lucianoET/aguada-firmware/firmware/node/docs/wiring_src/crop.jpg

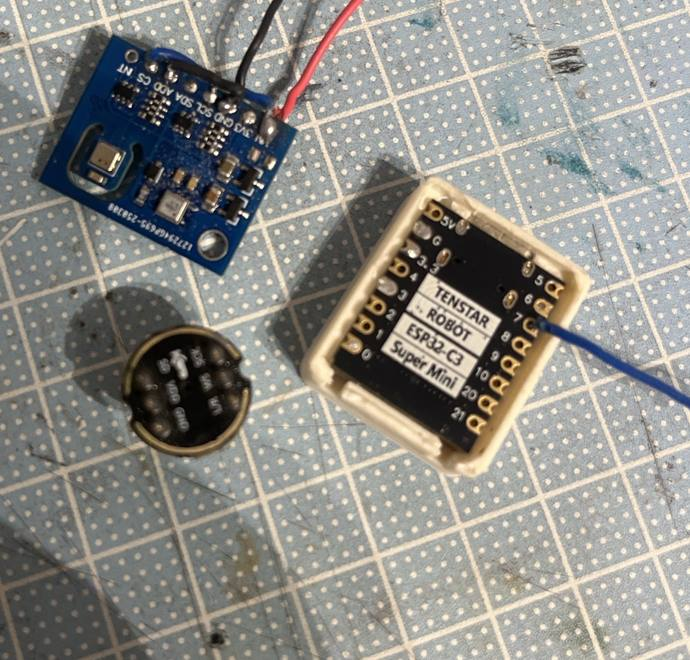
firmware/node/docs/wiring_src/crop.jpg
