lucianoET/aguada-firmware/firmware/node/node_pinout.md

# Node Pinout — Ligações de Sensores

> Hardware actual: **ESP32-C3 SuperMini**

Cobre os três targets suportados e os quatro modos de operação:
`ULTRASONIC` (1 ou 2 sensores) · `AIR_QUALITY` (ANI-01) · `RELAY`

---

## ESP32-C3 SuperMini ✦ (actual)

### Diagrama de pinos

```
              ┌────[USB-C]────┐
         GND ─┤ GND     5V   ├─ 5V
         GND ─┤ GND     3V3  ├─ 3.3 V
       GPIO4 ─┤ G4      RST  ├─ RST
       GPIO5 ─┤ G5      G10  ├─ GPIO10
  SDA ►GPIO6 ─┤ G6       G9  ├─ GPIO9  ◄ BOOT / botão relay
  SCL ►GPIO7 ─┤ G7       G8  ├─ GPIO8  ◄ LED onboard / WS2812B
       GPIO0 ─┤ G0       G3  ├─ GPIO3
       GPIO1 ─┤ G1       G2  ├─ GPIO2
              └───────────────┘
```

> Pinos GPIO 20/21 existem mas não estão expostos no conector principal da maioria dos SuperMini.

---

### Modo ULTRASONIC — 1 sensor (reservatório)

| Sinal | GPIO | Pino HC-SR04 |
|---|---|---|
| TRIG1 | **1** | TRIG |
| ECHO1 | **0** | ECHO |
| LED | **8** | — (LED onboard, active-LOW) |
| GND | GND  | GND |
| VCC | 3V3  | VCC (ou 5V se o sensor exigir) |

```
ESP32-C3          HC-SR04
  G1 ──────────── TRIG
  G0 ──────────── ECHO
 3V3 ──────────── VCC
 GND ──────────── GND
```

---

### node_reservatorio_1U — 1 reservatório, env `node_reservatorio_1U` (fonte 5 V)

Manual completo de montagem: [docs/MONTAGEM_NODE_RESERVATORIO_1U.md](docs/MONTAGEM_NODE_RESERVATORIO_1U.md).
O env antigo `node-c3-ch11` é o mesmo firmware.

| Sinal | GPIO | Ligação |
|---|---|---|
| TRIG | **3** | TRIG do sensor |
| ECHO | **4** | ECHO → **1k série + 2k ao GND** (5 V → 3,3 V) |
| Fonte 5 V | **1** (ADC1) | 200k → G1 → 100k → GND (`vbat_div=3`, alerta < 4,5 V) |
| DS18B20 | **10** | DQ + pull-up 4k7 → 3V3 (opcional, compensa temperatura) |
| Temperatura I2C | **6 / 7** | HTU21D/HD21D (0x40) ou SHT3x (0x44), opcional; prioridade sobre a DS18B20 |

Sensor (HC-SR04 ou JSN-SR04T à prova d'água) em **5 V**. C3 pelo pino 5V; 470 µF + 100 nF
junto ao C3 e 100 µF junto ao sensor. Nunca ECHO de 5 V direto no GPIO (danificou G0 do CON).

```
Fonte 5V ──┬── C3 5V
           ├── Sensor VCC
           └── 200k ─┬─ G1
                    100k ─ GND
C3 G3 ──────────── TRIG
C3 G4 ──1k──┬───── ECHO
           2k
           GND
```

O nó envia por **unicast** ao gateway depois de receber o ACK do HELLO (gateway com
firmware novo) ou com `-DDEFAULT_GATEWAY_MAC`; sem isso, broadcast como antes.

#### Reserva de pinos (expansão — ainda sem firmware)

| GPIO | Reserva | Observação |
|---|---|---|
| **0** | Microfone **INMP441** — SCK (saída) | I2S digital, 3V3, L/R→GND. Mesmo módulo e driver do AirQ (`sound_sensor`): dB SPL real sem calibrar. Detecta água entrando pelo ruído: nível vs. fundo |
| 1 | Fonte 5 V | já em uso |
| **2** | Microfone INMP441 — WS (saída) | **strapping** (alto no boot): o WS do INMP441 é entrada de alta impedância, não puxa o pino. Nada mais neste pino |
| 3 / 4 | Ultrassom TRIG / ECHO | já em uso |
| **5** | Saída: **relé 1** | sem strapping; é ADC2 (inútil com rádio), mas como digital é o pino mais seguro para saída |
| **6 / 7** | **I2C SDA / SCL** | sensor de temperatura (já suportado) + OLED SSD1306 (0x3C, reserva). Endereços sem conflito: AHT21 0x38, ENS160 0x53, SCD41 0x62, BH1750 0x23. Pull-up 4k7 se o módulo não tiver |
| 8 | LED da placa | strapping; manter só como LED de status |
| **9** | Entrada: **PB1** = botão BOOT da placa | strapping, mas o botão já existe; vale como botão depois do boot |
| 10 | 1-Wire (DS18B20) | já em uso |
| **20** | Entrada: **PB2** (pull-up interno) | U0RXD, livre (log vai pela USB). No 2U vira ECHO2 |
| **21** | Microfone INMP441 — SD (entrada) | U0TXD: a ROM transmite no boot, por isso aqui só **entrada** (o SD do mic fica em alta impedância sem clock). Pull-down interno: sem mic lê zeros → detectado |

Relé: módulo com transistor/optoacoplador acionado por 3,3 V, bobina no 5 V. Botões: GPIO → botão → GND.
Só há um relé direto (G5); um 2º relé, se precisar, vai por expansor I2C (PCF8574) na G6/G7.
Mic: o INMP441 substituiu o analógico (MAX9814/MAX4466 em G0) — 3 pinos em vez de 1, mas sai
dB SPL comparável entre nodes e o driver já existe. Fio do mic curto (< 20 cm): I2S a 1 MHz.

### node_reservatorio_2U — 2 reservatórios lado a lado, env `node_reservatorio_2U`

Manual: [docs/MONTAGEM_NODE_RESERVATORIO_2U.md](docs/MONTAGEM_NODE_RESERVATORIO_2U.md). Igual ao 1U, mais um sensor
(`sensor_id` 2, mesmo `node_id`):

| Sinal | GPIO | Ligação |
|---|---|---|
| TRIG (os dois) | **3** | TRIG do sensor 1 **e** do sensor 2 |
| ECHO1 | **4** | sensor 1 → 1k série + 2k ao GND |
| ECHO2 | **20** | sensor 2 → 1k série + 2k ao GND |
| Fonte 5 V | **1** | igual ao 1U |
| Temperatura | **6/7** (I2C) ou **10** (DS18B20) | opcional, um sensor para os dois (ar) |
| Reservados | 0/2/21 · 5 · 6/7 · 9 | mic INMP441 (SCK/WS/SD) · relé · I2C/OLED · PB1 (sem PB2: G20 virou ECHO2) |

**TRIG compartilhado:** os dois sensores disparam juntos e cada leitura usa só o seu ECHO; o
firmware lê um de cada vez com ≥ 60 ms de folga. Vale para reservatórios separados — dois
sensores na mesma água ouviriam o eco um do outro.

---

### Modo ULTRASONIC — 2 sensores

| Sinal | GPIO | Sensor |
|---|---|---|
| TRIG1 | **1** | S1 — TRIG |
| ECHO1 | **0** | S1 — ECHO |
| TRIG2 | **3** | S2 — TRIG |
| ECHO2 | **2** | S2 — ECHO |
| LED | **8** | — |

```
ESP32-C3          HC-SR04 nº1       HC-SR04 nº2
  G1 ─────────── TRIG
  G0 ─────────── ECHO
  G3 ──────────────────────────── TRIG
  G2 ──────────────────────────── ECHO
 3V3 ─────────── VCC ──────────── VCC
 GND ─────────── GND ──────────── GND
```

---

### Modo ANI-01 — qualidade do ar (ENS160 + AHT21)

| Sinal | GPIO | Destino |
|---|---|---|
| I2C SDA | **6** | ENS160 SDA · AHT21 SDA |
| I2C SCL | **7** | ENS160 SCL · AHT21 SCL |
| LED onboard | **8** | indicação de estado (active-LOW, onboard) |
| Botão BOOT | **9** | HELLO / restart (pull-up interno, onboard) |
| GND | GND | ENS160 GND · AHT21 GND |
| VCC | 3V3 | ENS160 VCC · AHT21 VCC |

**Endereços I2C:**

| Sensor | Endereço | Pino ADDR |
|---|---|---|
| ENS160 | 0x52 | ADDR → GND |
| AHT21  | 0x38 | fixo |

```
ESP32-C3          ENS160 / AHT21 (bus I2C partilhado)
  G6 ──────────── SDA
  G7 ──────────── SCL
 3V3 ──────────── VCC (ambos)
 GND ──────────── GND (ambos)
```

**Padrões do LED onboard (GPIO 8):**

| Padrão | Significado |
| --- | --- |
| 2 blinks × 100 ms  | Boot OK — sensores detectados |
| 5 blinks × 100 ms  | Erro de init — sensor não encontrado no I2C  |
| 1 blink × 30 ms | Leitura enviada com sucesso |
| 3 blinks × 200 ms  | Falha de leitura (sensor não respondeu) |

**Botão BOOT (GPIO 9):**

| Pressão | Acção |
| --- | --- |
| Curta (>40 ms)  | Envia PKT_HELLO imediato |
| Longa (≥5 s) | Reinicia o node |

**Sensor de luz TEMT6000 (opcional, modo ANI-01):**

Sensor analógico de luminosidade. Ligar a saída `SIG` a um pino **ADC1** (GPIO0–4).
O GPIO5 (ADC2) não funciona com WiFi ligado.

| Sinal | GPIO | Destino |
|---|---|---|
| SIG (OUT) | **3** (ADC1_CH3) | saída analógica |
| VCC | 3V3 | alimentação |
| GND | GND | massa |

```
ESP32-C3            TEMT6000
  3V3 ───────────── VCC
  GND ───────────── GND
   G3 ───────────── SIG
```

> Evitar GPIO2 (strapping). GPIO4 também é ADC1 mas é o pino recomendado para vbat.
> Pino configurável via build flag `DEFAULT_LIGHT_PIN`.

**Analisador de ar-condicionado + extras (opcionais, modo ANI-01, detecção automática):**

| Periférico | GPIO | Ligação |
|---|---|---|
| SCD41 (CO₂ real) | 6 / 7 | mesmo I2C do AHT21/ENS160, endereço 0x62 |
| DS18B20 sonda EXT | **4** | DQ + pull-up 4k7 → 3V3, cabo 3 vias |
| DS18B20 sonda SUP | **10** | idem |
| TC SCT-013 | **1** (ADC1) | bias 3V3─10k─┬─6k8─GND + 10 µF; jack P2 com comutação → GND sem plugue |
| INMP441 SD | **5** | entrada (pull-down interno) |
| INMP441 SCK | **20** | U0RXD — confirmar que o SuperMini expõe |
| INMP441 WS | **21** | U0TXD |
| INMP441 L/R | GND | canal esquerdo |

```
ESP32-C3            INMP441              DS18B20 (x2)          SCT-013 (jack P2)
  3V3 ───────────── VDD                    VDD ── 3V3            tip ──── G1
  GND ───────────── GND, L/R               GND ── GND            sleeve ─ bias 1.34 V
   G20 ──────────── SCK                    DQ ─┬─ G4 (EXT)
   G21 ──────────── WS                         └─ 4k7 → 3V3
   G5  ──────────── SD                     (SUP idêntica em G10)
```

Caixa central AirQ

Portas do analisador de AC

> KY-037/038 removido em 2026-10 (substituído pelo INMP441, que dá dB SPL real).
> Detalhes, faixa do TC e diagnóstico ΔT: [`Node AirQ.md`](../../Node%20AirQ.md).

---

### Modo RELAY

| Sinal | GPIO | Detalhe |
|---|---|---|
| Botão HELLO | **9** | BOOT button, active-LOW |
| I2C SDA | **6** | Opcional: SHT3x (0x44) ou HD21D (0x40) para T/H |
| I2C SCL | **7** | idem |
| LED | **8** | Pulso 30 ms a cada 2 s (se sem conflito) |

O relay faz scan I2C em 0x40 e 0x44. Se encontrar SHT3x ou HD21D, envia T/H como `PKT_HEARTBEAT sensor_id=0xFE`.

---

### vbat — monitorização de tensão (opcional, todos os modos)

| Sinal | GPIO | Detalhe |
|---|---|---|
| ADC | **4** (recomendado) | Divisor de tensão 1:2 |

```
Bateria/fonte ── R1(100k) ─┬─ GPIO4
                           │
                         R2(100k)
                           │
                          GND
```

Configurar em NVS: `vbat_enabled=true`, `vbat_pin=4`, `vbat_div=2`.

---

## ESP32-C3 DevKit M1

Mesmo target (`CONFIG_IDF_TARGET_ESP32C3`) → **pinos idênticos ao SuperMini**.  
O layout físico do conector é diferente mas os GPIOs são os mesmos.

---

## ESP32 DevKit (ESP32 clássico)

### Modo ULTRASONIC — 1 sensor

| Sinal | GPIO | Sensor |
|---|---|---|
| TRIG1 | **5**  | HC-SR04 TRIG |
| ECHO1 | **18** | HC-SR04 ECHO |
| LED | **2**  | active-HIGH |

### Modo ULTRASONIC — 2 sensores (pinos recomendados)

> Os pinos padrão (ECHO2=GPIO21) colidem com I2C SDA. Usar os pinos dos envs `ch11`:

| Sinal | GPIO (ch11) | GPIO (padrão — evitar se usar I2C) |
|---|---|---|
| TRIG1 | **25** | 5  |
| ECHO1 | **26** | 18 |
| TRIG2 | **32** | 19 |
| ECHO2 | **33** | ⚠ 21 = SDA |

### Modo ANI-01

| Sinal | GPIO | Destino |
|---|---|---|
| I2C SDA | **21** | ENS160 SDA · AHT21 SDA |
| I2C SCL | **22** | ENS160 SCL · AHT21 SCL |
| LED | **2** | monochrome (WS2812B não testado no DevKit) |

### Modo RELAY

| Sinal | GPIO | Detalhe |
|---|---|---|
| Botão | **2** | active-HIGH ⚠ mesmo pino que LED — `relay_led_conflict()` desativa LED |
| I2C SDA | **21** | Opcional: SHT3x/HD21D |
| I2C SCL | **22** | idem |

### vbat (DevKit)

Recomendado: GPIO **34** (input-only, sem conflito). `vbat_div=2`.

---

## Personalizar pinos via build flags

Qualquer pino pode ser sobrescrito adicionando flags em `platformio.ini`:

| Flag | Padrão C3 | Padrão DevKit | Descrição |
|---|---|---|---|
| `DEFAULT_TRIG1` | 1 | 5 | HC-SR04 sensor 1 TRIG |
| `DEFAULT_ECHO1` | 0 | 18 | HC-SR04 sensor 1 ECHO |
| `DEFAULT_TRIG2` | 3 | 19 | HC-SR04 sensor 2 TRIG |
| `DEFAULT_ECHO2` | 2 | 21 | HC-SR04 sensor 2 ECHO |
| `DEFAULT_I2C_SDA_PIN` | 6 | 21 | I2C SDA |
| `DEFAULT_I2C_SCL_PIN` | 7 | 22 | I2C SCL |
| `DEFAULT_LED_PIN` | 8 | 2 | LED / WS2812B DIN |
| `DEFAULT_LIGHT_PIN` | 3 | — | TEMT6000 SIG (ADC1, modo ANI-01) |
| `CT_PIN` | 1 | — | TC SCT-013 (ADC1, modo ANI-01) |
| `PROBE_EXT_PIN` / `PROBE_SUP_PIN` | 4 / 10 | — | sondas DS18B20 (modo ANI-01) |
| `MIC_SCK_PIN` / `MIC_WS_PIN` / `MIC_SD_PIN` | 20 / 21 / 5 | — | INMP441 I2S (modo ANI-01) |
| `DEFAULT_SENSOR_TYPE` | 0 | 0 | 0=ultrassônico 1=ANI-01 |
| `DEFAULT_NUM_SENSORS` | 1 | 1 | 0=relay 1=1sensor 2=2sensores |
| `DEFAULT_RELAY_ENABLED` | 0 | 0 | 1=relay+sensor simultâneos |

Exemplo — env ANI-01 com pino SDA customizado:
```ini
build_flags = -DDEFAULT_SENSOR_TYPE=1 -DDEFAULT_I2C_SDA_PIN=10
```
