lucianoET/aguada-firmware/.planning/quick/261001-6ja-bridge-py-parametros-de-reservatorio-edi/261001-6ja-PLAN.md

---
phase: quick-261001-6ja
plan: 01
type: execute
wave: 1
depends_on: []
files_modified:
  - tools/bridge.py
  - tools/test_reservoir_config.py
autonomous: true
requirements: [QUICK-6JA]
user_setup: []

must_haves:
  truths:
    - "A HC-SR04 reading with distance_cm > level_max_cm + sensor_offset_cm + OUT_OF_RANGE_MARGIN_CM (30) logs WARNING `Sensor out of range: ...`, publishes retained `offline` on `aguada/{node}/{sid}/availability` and publishes nothing on the state topic; CIE2 299 cm is rejected, 270 and 280 cm are accepted (D-05)"
    - "Every reservoir in reservoirs.yaml without `type: air_quality` gets 3 retained HA discovery configs `homeassistant/number/aguada_{alias}_cfg_{param}/config` (Altura útil / Offset do sensor / Volume máximo) on the same device `aguada_{alias}` as its sensors, with command_topic, min/max/step, mode box, entity_category config and no availability keys; SRN (air_quality) gets none (D-01)"
    - "Retained `aguada/{node}/{sid}/config` JSON with level_max_cm, sensor_offset_cm, volume_max_L is published on every MQTT connect and after every set command (D-02)"
    - "`aguada/0XC9C4/1/config/level_max_cm/set` = `460` updates `self.reservoirs[(\"0XC9C4\",1)]` in place (same dict object read by `_handle_sensor`), logs INFO `Config CAV level_max_cm 450 -> 460`, rewrites exactly one line of reservoirs.yaml, and republishes the config state (D-03, D-04)"
    - "Out-of-range, non-numeric, NaN, unknown param, unknown or air_quality reservoir commands log WARNING, change neither memory nor file, and (when the reservoir exists) republish the current config state so the HA box snaps back (D-03)"
    - "reservoirs.yaml rewrite is textual, scoped to the list item of that alias inside that node key, preserves every comment and line, is atomic (temp file in same dir + os.replace, file mode kept), and when the line is not found logs ERROR and leaves the file untouched (D-04)"
    - "`tools/test_reservoir_config.py` prints `ok` with `.venv/bin/python` and never modifies the real `tools/reservoirs.yaml`; `test_seq_dedup.py`, `test_sensor_availability.py`, `test_bridge_dispatch.py` still print `ok` (D-07, D-08)"
  artifacts:
    - path: tools/bridge.py
      provides: "OUT_OF_RANGE_MARGIN_CM, RESERVOIR_PARAMS, update_reservoir_yaml(), mqtt_topic_config(), publish_config_discovery(), Bridge._publish_reservoir_config(), Bridge._handle_config_set(), out-of-range branch in _handle_sensor, subscribe + publish in _on_mqtt_connect, routing in _on_mqtt_message"
    - path: tools/test_reservoir_config.py
      provides: "assert-based self-check on a TEMP COPY of reservoirs.yaml with a fake MQTT client (cases a-d + YAML scoping)"
  key_links:
    - "`mqtt_topic_config(node_id, sensor_id)` is the single source for the state topic, the discovery state_topic and the discovery command_topic prefix (`{config_topic}/{param}/set`); the handler parses the same shape back (6 segments, [3]=='config', [5]=='set')"
    - "Config-set routing in `_on_mqtt_message` MUST come before the existing `json.loads(msg.payload)` try/except, otherwise a non-JSON payload (e.g. `abc`) returns silently without republishing state"
    - "`_handle_config_set` mutates the dict object stored in `self.reservoirs[key]` (no copy, no reload), which is exactly what `_handle_sensor` passes to `calculate()` and to the out-of-range check"
    - "`update_reservoir_yaml` writes to `self.args.config` (resolved with os.path.realpath), never a hard-coded path; the test points `args.config` at a temp copy"
    - "Range check form `not (lo <= v <= hi)` rejects NaN; the form `v < lo or v > hi` would let NaN through and `int(round(nan))` would raise"
---

<objective>
Reservoir parameters (altura útil, offset do sensor, volume máximo) become editable from Home Assistant, persist to `tools/reservoirs.yaml`, and implausible HC-SR04 readings are treated as sensor errors.

User flow: in HA the operator opens device "CAV" -> section "Configuração" -> box "Castelo de Incêndio - Altura útil" shows 450 -> types 460 -> Enter. HA publishes `460` on `aguada/0XC9C4/1/config/level_max_cm/set`; bridge validates, applies it to the next reading immediately, rewrites only that line in reservoirs.yaml (comments kept), republishes the retained config state and the box stays at 460. An invalid value is logged and the state is republished, so the box snaps back to the current value. The boxes stay editable when the node is offline (no availability). Syncing to aguada-web (`tools/sync_reservoirs.sh`) stays a manual step for the user (D-06).

Purpose of the out-of-range rule: 2026-09-30 CIE2 sent 299 cm with level_max 240 + offset 10; calculate() clamped it to 0 % and HA fired a false critical-level alarm. With the rule the sensor goes unavailable instead.

Output: `tools/bridge.py` (constants, YAML text editor, discovery function, topic helper, two Bridge methods, three call sites) and new `tools/test_reservoir_config.py`.

Decision mapping (user-confirmed requirements 1-9 -> D-01..D-09): D-01 number discovery per HC-SR04 reservoir; D-02 retained config state topic, published on connect and after each change; D-03 command topic, subscribe, validation, in-memory update, INFO log; D-04 textual atomic YAML persistence, no new deps; D-05 out-of-range reading = sensor error; D-06 minimal diff, file style, ANI/relay/env/gateway untouched, no sync_reservoirs.sh; D-07 executable self-check on a temp copy; D-08 venv python + regression tests; D-09 other-session files untouched, explicit-path staging, no service restart.
</objective>

<execution_context>
@$HOME/.claude/gsd-core/workflows/execute-plan.md
@$HOME/.claude/gsd-core/templates/summary.md
</execution_context>

<context>
@.planning/STATE.md
@CLAUDE.md
@tools/reservoirs.yaml
@tools/test_sensor_availability.py

Read `tools/bridge.py` by range only (1438 lines): L41-64 config section + `load_reservoir_config`; L134-152 topic helpers; L282-401 `publish_discovery` (device dict shape, discovery loop, retain); L728-783 `Bridge.__init__`; L836-911 `_on_mqtt_connect` + `_on_mqtt_message`; L1005-1084 `_set_sensor_avail` + `_handle_sensor`.

Facts verified during planning (do not re-derive):
- Interpreter: `/home/luc/DEV_luctronics/luctronics_firmware/platformio/.venv/bin/python` (paho-mqtt 1.6.1, PyYAML). System python3 has no paho. Baseline: all three existing self-checks print `ok` before this plan.
- `import bridge` is side-effect free. Real `bridge.Bridge(args)` works with `argparse.Namespace(config=..., mqtt_user="", mqtt_password="", offline_timeout=300, influx_url="", gateway_timeout=0, serial_reconnect_delay=2.0)`; `args.config` is stored as `self.args.config`. `load_reservoir_config` returns the yaml item dicts themselves, keyed `(NODE_UPPER, sid)`, and resets/refills the global `NODE_ALIASES`.
- Reservoir keys: `("0X7758",1)` CON 450/20/80000, `("0XC9C4",1)` CAV 450/20/80000 (also 0XEE02), `("0X2EC4",1/2)` CB31/CB32 200/10/40000, `("0X9EAC",1/2)` CIE1/CIE2 240/10/245000, `("0X3456",1/2)` CBIF1/CBIF2, `("0XA101",1)` SRN `type: air_quality` (no level params).
- reservoirs.yaml layout: top `reservoirs:` at col 0, node keys quoted at indent 2 (`  "0XC9C4":`), list items `    - sensor_id: N` at indent 4, fields at indent 6 (`      alias: CAV`, `      level_max_cm: 450`). Comment lines at indent 2 sit between node blocks (e.g. `  # CAV: node ESP-NOW ...` right before `"0XC9C4"`); the file header has non-ASCII comments (FONTE ÚNICA) -> read/write UTF-8. Real file is a regular file (not a symlink), mode 0664.
- `_handle_sensor` dedups on `(node, sid, seq)`: every test message needs a distinct seq. `sensor_msg(node, sid, dist, flags, seq)` and the availability helpers can be imported from `test_sensor_availability` (as `test_seq_dedup.py` does), but that module's `make_bridge()` uses the REAL yaml path, so the new test defines its own bridge factory on a temp copy.
- Existing regression distances stay below the new limits (CON/CAV 102-103 cm vs 500, CB31 80-81 cm vs 240); `test_bridge_dispatch.py` stubs `_handle_sensor`.
- HA MQTT number publishes integral values without decimals (`460`), but accept `460.0` too (float parse).
- `_on_mqtt_message` today: GATEWAY_RX_TOPIC check, then `json.loads` in try/except that returns silently on failure, then `aguada/raw/` and `aguada/cmd/*` branches.
- Working tree has uncommitted work from another session (firmware/gps_tracker/*, tools/install_autostart_user_service.sh, tools/systemd/, .planning/debug/). Do NOT touch, stage or commit any of it (D-09).
</context>

<tasks>

<task type="auto" tdd="true">
  <name>Task 1: Out-of-range reading = sensor error (constant, _handle_sensor branch, test scaffold with temp-copy bridge)</name>
  <files>tools/bridge.py, tools/test_reservoir_config.py</files>
  <behavior>
    - Fresh bridge on a temp copy; CIE2 msg `sensor_msg("0x9EAC", 2, 299, 0, 1)` -> exactly one publish on `aguada/0X9EAC/2/availability` = `("offline", retain True)`, zero publishes on `aguada/0X9EAC/2/state`.
    - Same bridge, `sensor_msg("0x9EAC", 2, 270, 0, 2)` -> one state publish on `aguada/0X9EAC/2/state` and availability flips to `online`.
    - Boundary on a fresh bridge: 280 cm (= 240 + 10 + 30) is accepted (state published); 281 cm is rejected (offline, no new state).
    - The real `tools/reservoirs.yaml` bytes are identical before and after the whole script.
  </behavior>
  <action>
RED first: create `tools/test_reservoir_config.py` in the style of `tools/test_sensor_availability.py` (docstring "Self-check: ..." with `Run: .venv/bin/python tools/test_reservoir_config.py`, `sys.path.insert(0, str(Path(__file__).parent))`, `import bridge`, plain `test_*` functions, `__main__` block calling every test then printing `ok`). Per D-07:
- Module constant REAL pointing to `Path(__file__).parent / "reservoirs.yaml"` and REAL_BYTES read at import; the `__main__` block asserts `REAL.read_bytes() == REAL_BYTES` just before printing `ok`.
- Own `FakeClient` with `publish(self, topic, payload=None, qos=0, retain=False, **kw)` appending `(topic, payload, retain)` to `self.published`, and `subscribe(self, topic, *a, **kw)` appending to `self.subscribed`.
- `make_bridge(tmpdir)`: `shutil.copy(REAL, tmpdir/"reservoirs.yaml")`, build a real `bridge.Bridge` with the Namespace from context but `config=` the COPY path, replace `b.client` with a FakeClient and `b.tracker` with `bridge.NodeTracker(fake, 300)`; return `(b, fake, copy_path)`. Each test wraps its body in `with tempfile.TemporaryDirectory() as d:`. Never pass the real path to Bridge or to any write function.
- Import `sensor_msg` from `test_sensor_availability`.
- Test `test_out_of_range_is_sensor_error` covering every `<behavior>` bullet (use a second fresh bridge for the 280/281 boundary, distinct seqs).
Run it; it must fail (299 currently publishes a 0 % state).

GREEN in `tools/bridge.py` per D-05/D-06:
1. Next to `GATEWAY_ALIVE_S` add `OUT_OF_RANGE_MARGIN_CM = 30` with a one-line comment starting `# ponytail:` saying it is the tuning knob: a reading beyond level_max_cm + sensor_offset_cm + this margin is a sensor fault, not an empty tank.
2. In `_handle_sensor`, right after the existing `Sensor error:` branch returns and before `calcs = calculate(distance_cm, cfg)`: compute the limit from `cfg["level_max_cm"] + cfg["sensor_offset_cm"] + OUT_OF_RANGE_MARGIN_CM`; if `distance_cm > limit`, `log.warning("Sensor out of range: %s/%d dist=%d > %d", node_id, sensor_id, distance_cm, limit)`, call `self._set_sensor_avail(node_id, sensor_id, "offline")` and return (same route as the error branch). Leave the existing error branch, `calculate()` and the ANI path untouched.
  </action>
  <verify>
    <automated>cd /home/luc/DEV_luctronics/luctronics_firmware/platformio && .venv/bin/python -m py_compile tools/bridge.py && .venv/bin/python tools/test_reservoir_config.py && grep -v '^\s*#' tools/bridge.py | grep -c "OUT_OF_RANGE_MARGIN_CM" && git diff --quiet -- tools/reservoirs.yaml</automated>
  </verify>
  <done>Self-check prints `ok`; grep prints `2` (definition + use); 299 cm on CIE2 marks the sensor offline with no state publish, 270/280 cm publish state; real reservoirs.yaml unchanged.</done>
</task>

<task type="auto" tdd="true">
  <name>Task 2: update_reservoir_yaml() textual, item-scoped, atomic persistence</name>
  <files>tools/bridge.py, tools/test_reservoir_config.py</files>
  <behavior>
    - `bridge.update_reservoir_yaml(copy, "0XC9C4", "CAV", "level_max_cm", 460)` returns True; comparing the copy's lines before/after, exactly one line differs and it is the CAV `level_max_cm` line now reading `      level_max_cm: 460`; the CON block (also 450) and every comment line are unchanged; `bridge.load_reservoir_config(copy)` gives CAV 460 and CON 450.
    - `update_reservoir_yaml(copy, "0X2EC4", "CB32", "sensor_offset_cm", 12)` returns True and changes only the CB32 line (second list item of the node); CB31 keeps `sensor_offset_cm: 10`.
    - `update_reservoir_yaml(copy, "0X7758", "CAV", "level_max_cm", 999)` (alias not under that node) returns False and the file bytes are identical; same for an unknown node key and for a param line that does not exist in the item.
    - File mode of the copy is unchanged after a successful write.
  </behavior>
  <action>
RED first: add `test_yaml_update_scoped` and `test_yaml_update_not_found` to `tools/test_reservoir_config.py` covering every `<behavior>` bullet, each on its own temp copy (`shutil.copy(REAL, ...)`, no Bridge needed); register them in `__main__`. Read/compare with `read_text(encoding="utf-8").splitlines(keepends=True)`. Run; must fail (function missing).

GREEN in `tools/bridge.py` per D-04/D-06 (no new dependencies, stdlib only; add `import re` and `import tempfile` to the import block in alphabetical position):
Add module function `update_reservoir_yaml(path: str, node_id: str, alias: str, param: str, value: int) -> bool` right after `load_reservoir_config`, with a one-line docstring (edits one `param: number` line in place so comments/formatting survive). Logic:
1. `real = os.path.realpath(path)`; read UTF-8 text and split with `splitlines(keepends=True)`.
2. Node block: find the first line matching, case-insensitively, optional indent + optional quote + `re.escape(node_id)` + optional quote + `:` + optional trailing comment. Record its indent. The block ends at the next line that is non-blank, not a comment-only line, and has indent <= the node key indent (next node key or a top-level key); otherwise EOF.
3. Item: inside the block find the line `^\s*alias:\s*["']?{re.escape(alias)}["']?\s*(#.*)?$` (exact alias, so CB3 never matches CB31). Item start = the nearest preceding line in the block matching `^\s*-\s`; item end = the next such line after the alias line, or the block end.
4. In [item start, item end) find the first line matching `^(\s*(?:-\s+)?{re.escape(param)}\s*:\s*)(-?\d+(?:\.\d+)?)(\s*(?:#.*)?)$` (match against the line without its newline); rebuild it as group1 + `str(value)` + group3 + the original line ending.
5. If node, alias or param line is not found: `log.error("Config not persisted: %s/%s %s not found in %s", node_id, alias, param, real)` and return False without touching the file.
6. Atomic write: `tempfile.mkstemp(dir=os.path.dirname(real), prefix=".reservoirs.", suffix=".tmp")`, write the joined text as UTF-8, flush + `os.fsync`, `os.chmod(tmp, os.stat(real).st_mode & 0o7777)` (mkstemp creates 0600; keep the original mode so aguada-web/other readers still can read), then `os.replace(tmp, real)`; on any exception remove the temp file, `log.exception(...)` and return False. Return True on success.
  </action>
  <verify>
    <automated>cd /home/luc/DEV_luctronics/luctronics_firmware/platformio && .venv/bin/python -m py_compile tools/bridge.py && .venv/bin/python tools/test_reservoir_config.py && grep -c "^def update_reservoir_yaml" tools/bridge.py && git diff --quiet -- tools/reservoirs.yaml</automated>
  </verify>
  <done>Self-check prints `ok`; grep prints `1`; edits touch exactly one line inside the right list item; not-found cases return False with the file byte-identical; real reservoirs.yaml unchanged.</done>
</task>

<task type="auto" tdd="true">
  <name>Task 3: HA number discovery, retained config state and set-command handler</name>
  <files>tools/bridge.py, tools/test_reservoir_config.py</files>
  <behavior>
    - (a) `b._on_mqtt_connect(fake, None, {}, 0)`: `fake.subscribed` contains `aguada/+/+/config/+/set`; `homeassistant/number/aguada_cav_cfg_level_max_cm/config` payload has name `Castelo de Incêndio - Altura útil`, unique_id `aguada_cav_cfg_level_max_cm`, default_entity_id `number.aguada_cav_altura_util`, state_topic `aguada/0XC9C4/1/config`, value_template `{{ value_json.level_max_cm }}`, command_topic `aguada/0XC9C4/1/config/level_max_cm/set`, min 50, max 1000, step 1, mode `box`, entity_category `config`, unit `cm`, an `icon`, device identifiers `["aguada_cav"]`, and none of `availability`, `availability_topic`, `availability_mode`; offset (0..200, `number.aguada_cav_offset_sensor`) and volume (1..500000, unit `L`, `number.aguada_cav_volume_maximo`) likewise; all published retained; no published topic contains `aguada_srn_cfg`; retained `aguada/0XC9C4/1/config` JSON equals `{"level_max_cm": 450, "sensor_offset_cm": 20, "volume_max_L": 80000}`; no `aguada/0XA101/1/config` publish.
    - (b) `b._on_mqtt_message(None, None, msg)` with `msg = types.SimpleNamespace(topic="aguada/0XC9C4/1/config/level_max_cm/set", payload=b"460")`: `b.reservoirs[("0XC9C4",1)]` is the same object as before and has `level_max_cm == 460`; the copy differs from the original in exactly one line (CAV level_max_cm 460), CON block and comments intact; the last publish on `aguada/0XC9C4/1/config` is retained JSON with level_max_cm 460; a following CAV reading `sensor_msg("0xC9C4", 1, 100, 0, 1)` publishes `level_cm` 380 (460 - (100 - 20)).
    - (c) On a fresh bridge, each of: `level_max_cm/set` = `5000`, `abc`, `nan`; `aguada/0XC9C4/1/config/foo/set` = `100`; `aguada/0XA101/1/config/level_max_cm/set` = `100`; `aguada/0X9999/1/config/level_max_cm/set` = `100` -> CAV cfg still 450/20/80000, copy bytes identical to the original; after the `5000` command the latest `aguada/0XC9C4/1/config` publish carries level_max_cm 450 (state republished).
  </behavior>
  <action>
RED first: add `test_number_discovery_and_state` (a), `test_set_command_applies_and_persists` (b) and `test_set_command_rejected` (c) to `tools/test_reservoir_config.py` using `make_bridge(tmpdir)` and `types.SimpleNamespace` messages; register them in `__main__`. Run; must fail.

GREEN in `tools/bridge.py` per D-01/D-02/D-03/D-06 (style: short comments, English logs):
1. Config section, below `OUT_OF_RANGE_MARGIN_CM`: `RESERVOIR_PARAMS` dict, param -> tuple (HA name suffix, entity suffix, unit, min, max, icon): `level_max_cm` -> ("Altura útil", "altura_util", "cm", 50, 1000, "mdi:arrow-expand-vertical"); `sensor_offset_cm` -> ("Offset do sensor", "offset_sensor", "cm", 0, 200, "mdi:arrow-collapse-down"); `volume_max_L` -> ("Volume máximo", "volume_maximo", "L", 1, 500000, "mdi:cup-water"). Single source for discovery, validation and the state JSON (D-01).
2. Topic helpers: after `mqtt_topic_sensor_avail` add `mqtt_topic_config(node_id, sensor_id)` returning `f"aguada/{node_id}/{sensor_id}/config"`, same one-line shape (D-02).
3. New module function `publish_config_discovery(client, node_id, sensor_id, cfg)` placed right after `publish_discovery` (leave `publish_discovery` itself unchanged). Build `alias` and `dev` exactly like `publish_discovery` (lower-cased alias, `{"name": cfg.get("alias", alias), "identifiers": [f"aguada_{alias}"], "manufacturer": "Aguada"}`) so the numbers land on the same device. For each RESERVOIR_PARAMS entry publish retained to `homeassistant/number/{uid}/config` with uid `aguada_{alias}_cfg_{param}`: `name` `{cfg name} - {suffix}`, `unique_id`, `default_entity_id` `number.aguada_{alias}_{entity suffix}`, `state_topic` = mqtt_topic_config, `value_template` `{{ value_json.<param> }}`, `command_topic` = mqtt_topic_config + `/{param}/set`, `min`, `max`, `step` 1, `mode` "box", `entity_category` "config", `unit_of_measurement`, `icon`, `device`. No availability keys at all, so the boxes stay editable with the node offline (D-01). One short comment saying so.
4. `Bridge._publish_reservoir_config(self, node_id, sensor_id, cfg)`: retained publish on mqtt_topic_config of the JSON `{param: cfg.get(param) for param in RESERVOIR_PARAMS}` via `self.client` (D-02).
5. `_on_mqtt_connect`: after the existing `client.subscribe(GATEWAY_RX_TOPIC)` add `client.subscribe("aguada/+/+/config/+/set")` with a short comment (HA number edits). In the reservoir loop's non-air_quality branch, after `publish_discovery(...)`, call `publish_config_discovery(client, node_id, sensor_id, cfg)` and `self._publish_reservoir_config(node_id, sensor_id, cfg)` (D-02).
6. `_on_mqtt_message`: immediately after the GATEWAY_RX_TOPIC block and BEFORE the `json.loads` try, route topics that start with `aguada/`, contain `/config/` and end with `/set` to `self._handle_config_set(topic, msg.payload)` and return (non-JSON payloads must still reach the handler).
7. `Bridge._handle_config_set(self, topic, payload)` placed after `_on_mqtt_message` (D-03):
   - Split the topic; require 6 segments with [3] == "config" and [5] == "set", else WARNING and return. node = segment[1] upper-cased then mapped through NODE_ALIASES; sensor_id = int(segment[2]) (ValueError -> WARNING, return).
   - `cfg = self.reservoirs.get((node, sid))`; if missing or `cfg.get("type") == "air_quality"` -> WARNING `Config set for unknown reservoir ...` and return.
   - param = segment[4]; if not in RESERVOIR_PARAMS -> WARNING, republish state, return.
   - Parse `float(payload.decode(errors="replace").strip())`; on failure -> WARNING, republish state, return. Range check written as `not (lo <= v <= hi)` so NaN is rejected -> WARNING `Config rejected: %s %s=%r (range %d..%d)` with alias, param, raw text, lo, hi; republish state; return.
   - Valid: `new = int(round(v))`, `old = cfg[param]`, assign `cfg[param] = new` on the SAME dict (no copy, no reload; the next `_handle_sensor` uses it), `log.info("Config %s %s %s -> %s", cfg.get("alias"), param, old, new)`, then `update_reservoir_yaml(self.args.config, node, cfg.get("alias", ""), param, new)` (it logs ERROR itself on failure; the in-memory value stays applied per D-04), then `self._publish_reservoir_config(node, sid, cfg)`.
Do NOT touch ANI/relay/env/gateway discovery, heartbeat, `aguada/cmd/*` handling, or reservoirs.yaml (D-06). Do NOT run `tools/sync_reservoirs.sh` and do NOT restart the aguada-bridge service (D-06, D-09).

Regression + commit (D-08, D-09): run `test_seq_dedup.py`, `test_sensor_availability.py`, `test_bridge_dispatch.py` with `.venv/bin/python`; all must print `ok`. Stage ONLY `tools/bridge.py` and `tools/test_reservoir_config.py` by explicit path; never `git add -A`, `git add .` or `git commit -a`.
  </action>
  <verify>
    <automated>cd /home/luc/DEV_luctronics/luctronics_firmware/platformio && .venv/bin/python -m py_compile tools/bridge.py && .venv/bin/python tools/test_reservoir_config.py && .venv/bin/python tools/test_seq_dedup.py && .venv/bin/python tools/test_sensor_availability.py && .venv/bin/python tools/test_bridge_dispatch.py && grep -c 'aguada/+/+/config/+/set' tools/bridge.py && grep -c "^def publish_config_discovery" tools/bridge.py && git diff --quiet -- tools/reservoirs.yaml</automated>
  </verify>
  <done>All four self-checks print `ok`; both greps print `1`; HA gets 3 config numbers per HC-SR04 reservoir and none for SRN; a valid set changes memory + exactly one YAML line + republishes state; invalid sets change nothing and republish state; real reservoirs.yaml unchanged; commit contains only the two explicit files and other-session entries in `git status --short` are as before.</done>
</task>

</tasks>

<threat_model>
## Trust Boundaries

| Boundary | Description |
|---|---|
| HA / any MQTT client -> bridge | `aguada/+/+/config/+/set` payloads and topic segments are untrusted input that reaches in-memory config and a file write |
| bridge -> filesystem | rewrite of `tools/reservoirs.yaml` (read by bridge on restart and copied to aguada-web) |
| node/gateway -> bridge | SENSOR distance_cm is node-controlled; implausible values must not become 0 % readings |

## STRIDE Threat Register

| Threat ID | Category | Component | Severity | Disposition | Mitigation Plan |
|---|---|---|---|---|---|
| T-6ja-01 | Tampering | `_handle_config_set` value | medium | mitigate | Whitelist param via RESERVOIR_PARAMS, float parse, `not (lo <= v <= hi)` range (rejects NaN/inf), int conversion; invalid -> WARNING + state republish, no change (Task 3, test c) |
| T-6ja-02 | Tampering | `update_reservoir_yaml` target | medium | mitigate | Path comes only from `args.config` (realpath), never from the topic; node/alias/param are validated against loaded reservoirs + whitelist before the call and used via `re.escape`; edit scoped to one list item (Task 2 tests) |
| T-6ja-03 | Denial of Service | concurrent readers of reservoirs.yaml (bridge restart, sync to aguada-web) | medium | mitigate | Temp file in same dir + fsync + `os.replace`; file mode copied from the original so readers keep access |
| T-6ja-04 | Spoofing | unauthenticated LAN client publishing set commands | low | accept | Pre-existing broker trust model: `aguada/cmd/#` already lets any broker client restart/configure nodes; values are bounded by T-6ja-01 |
| T-6ja-05 | Tampering | out-of-range readings faking an empty tank | medium | mitigate | `distance_cm > level_max + offset + 30` -> sensor offline, no state publish (Task 1) |
| T-6ja-06 | Denial of Service | flood of valid set commands rewriting the file | low | accept | LAN-only, each write is a small atomic replace; no amplification |
</threat_model>

<verification>
Executor (automated):
- `.venv/bin/python tools/test_reservoir_config.py`, `test_seq_dedup.py`, `test_sensor_availability.py`, `test_bridge_dispatch.py` all print `ok`.
- `git diff --quiet -- tools/reservoirs.yaml` succeeds (real file untouched).
- `git status --short` after commit: only the pre-existing other-session entries remain.

Orchestrator, after execution (not an executor task, D-09):
- `systemctl --user restart aguada-bridge`; `mosquitto_sub -v -t 'aguada/+/+/config'` shows retained JSON for each HC-SR04 reservoir.
- HA device CAV -> Configuração shows 3 boxes; change Altura útil 450 -> 460, journal shows `Config CAV level_max_cm 450 -> 460`, `git diff tools/reservoirs.yaml` shows exactly that line; revert to 450 the same way. Then the user runs `tools/sync_reservoirs.sh` if aguada-web must follow.
</verification>

<success_criteria>
- HC-SR04 reservoir parameters are editable from HA (3 config numbers per reservoir), applied to the next reading and persisted to reservoirs.yaml with comments intact.
- Readings beyond level_max + offset + 30 cm make the sensor unavailable instead of producing a false 0 % / critical alarm.
- Diff limited to `tools/bridge.py` and the new `tools/test_reservoir_config.py`; ANI/relay/env/gateway paths unchanged.
</success_criteria>

<output>
Create `.planning/quick/261001-6ja-bridge-py-parametros-de-reservatorio-edi/261001-6ja-SUMMARY.md` when done
</output>
