lucianoET/aguada-firmware/.planning/quick/260930-t20-bridge-py-disponibilidade-por-sensor-no-/260930-t20-SUMMARY.md

---
phase: quick-260930-t20
plan: 01
subsystem: bridge
tags: [bridge, mqtt, home-assistant, availability, hc-sr04]
requires: []
provides:
  - "per-sensor retained availability topic aguada/{node}/{sensor}/availability"
  - "HA discovery availability list for nivel/pct/volume/distancia"
affects: [tools/bridge.py]
tech-stack:
  added: []
  patterns: ["publish-on-change dict (_sensor_avail)", "HA availability list + availability_mode all"]
key-files:
  created: [tools/test_sensor_availability.py]
  modified: [tools/bridge.py]
decisions:
  - "Single commit for both tasks (plan allows it); test file written whole up-front, RED verified per task"
metrics:
  completed: 2026-09-30
status: complete
---

# Quick 260930-t20: bridge.py per-sensor availability Summary

HC-SR04 error packets now publish retained `offline` on `aguada/{node}/{sensor}/availability` (valid reading publishes state, then `online`), only on transitions; HA discovery makes level/%/volume/distance entities follow node status AND the sensor topic, while rssi/bateria/last_update keep node status only.

## Changes
- `mqtt_topic_sensor_avail` helper, `Bridge._sensor_avail` dict, `Bridge._set_sensor_avail`, two call sites in `_handle_sensor` (error branch keeps the existing WARNING).
- `publish_discovery`: `per_sensor` flag on 4 entities -> `availability` list + `availability_mode: all` (no `availability_topic`); others unchanged.
- `tools/test_sensor_availability.py`: assert-based, fake MQTT client, 5 tests.

## Commit
- f30dd4a feat(260930-t20): per-sensor availability for HC-SR04 in bridge + HA discovery

## Verification
`.venv/bin/python tools/test_sensor_availability.py` -> ok; `tools/test_bridge_dispatch.py` -> ok; greps: helper 1, dict 1, `"availability_mode"` 1, `"per_sensor": True` 4.

## Deviations from Plan
None - plan executed as written (one commit for both tasks instead of per task).

## Known Stubs
None.

## Self-Check: PASSED
