lucianoET/aguada-firmware/.planning/quick/260930-t20-bridge-py-disponibilidade-por-sensor-no-/260930-t20-PLAN.md

---
phase: quick-260930-t20
plan: 01
type: execute
wave: 1
depends_on: []
files_modified:
  - tools/bridge.py
  - tools/test_sensor_availability.py
autonomous: true
requirements: [QUICK-T20]
user_setup: []

must_haves:
  truths:
    - "A HC-SR04 SENSOR packet flagged as error (distance_cm <= 0, 0xFFFF, or flags & 0x04) publishes retained `offline` on `aguada/{node_id}/{sensor_id}/availability`, and the existing `Sensor error:` WARNING log is still emitted (D-01, D-02)"
    - "A valid HC-SR04 reading publishes the state JSON first and then retained `online` on the same per-sensor topic (D-02)"
    - "Repeating the same availability state does not republish; the first state seen after bridge start is always published (D-02)"
    - "The two sensors of one node (0X2EC4 CB31/CB32, 0X9EAC CIE1/CIE2) have independent availability: one in error does not affect the other (D-02)"
    - "HA discovery for reservoir entities nivel, pct, volume, distancia carries an `availability` list [node status, per-sensor topic] with `availability_mode: all` and no `availability_topic` key; rssi, bateria, last_update keep only the node status availability (D-03)"
    - "ANI, relay, env and gateway discovery and `_handle_heartbeat` are unchanged (D-03, D-04)"
    - "`tools/test_sensor_availability.py` runs with the project venv, no framework, and prints `ok`; `tools/test_bridge_dispatch.py` still prints `ok` (D-06)"
  artifacts:
    - path: tools/bridge.py
      provides: "mqtt_topic_sensor_avail helper, Bridge._sensor_avail dict, Bridge._set_sensor_avail, per-sensor availability in _handle_sensor and publish_discovery"
    - path: tools/test_sensor_availability.py
      provides: "assert-based self-check with a fake MQTT client"
  key_links:
    - "`mqtt_topic_sensor_avail(node_id, sensor_id)` is the single source of the topic string for BOTH the publish in `_set_sensor_avail` and the second entry of the discovery `availability` list; if they diverge HA never marks the entities available"
    - "node_id casing: `_handle_sensor` uses `msg[\"node_id\"].upper()` + `NODE_ALIASES`, `_on_mqtt_connect` passes the upper-cased `reservoirs.yaml` keys to `publish_discovery`; both must yield `aguada/0X7758/1/availability`"
    - "HA rejects a discovery config that has both `availability` and `availability_topic` (mutually exclusive keys), so the measurement entities must carry only the list"
---

<objective>
Per-sensor availability in Home Assistant for HC-SR04 reservoirs, driven by the sensor-error packets the nodes already send.

Purpose: CON (0x7758) with a HC-SR04 that gets no echo sends SENSOR distance_cm=-1 / flags 0x04 every 120 s. `_handle_sensor` logs and returns, the node stays `online` (packets keep arriving), so HA shows the last good reading (102 cm, hours old) as if it were current. After this plan the level/%/volume/distance entities of that sensor go `unavailable` while RSSI, battery and "Último dado" stay visible (last_update shows when the last good reading happened). Two-sensor nodes get independent availability per sensor.

Output: `tools/bridge.py` (helper + dict + small method + two call sites + discovery change) and `tools/test_sensor_availability.py`.

Decision mapping (orchestrator decisions 1-8 -> D-01..D-08): D-01 new retained topic + helper; D-02 publish on error/valid, only on change, always first time; D-03 discovery availability list only for the 4 measurement entities; D-04 heartbeat untouched; D-05 accepted post-deploy unavailability until next valid reading (no mitigation code); D-06 executable assert check; D-07 minimal diff, existing style, other working-tree files untouched; D-08 runtime check done by orchestrator, not by the executor.
</objective>

<execution_context>
@$HOME/.claude/gsd-core/workflows/execute-plan.md
@$HOME/.claude/gsd-core/templates/summary.md
</execution_context>

<context>
@.planning/STATE.md
@CLAUDE.md
@tools/bridge.py
@tools/test_bridge_dispatch.py

Facts verified during planning (do not re-derive):
- Interpreter: system python3 has no paho. Use the project venv `/home/luc/DEV_luctronics/luctronics_firmware/platformio/.venv/bin/python` (paho-mqtt 1.6.1), same one the systemd unit uses. Existing `tools/test_bridge_dispatch.py` passes with it.
- `import bridge` is side-effect free (entry point is guarded by `if __name__ == "__main__"`, L1404).
- `bridge.Bridge(args)` is light: it reads `reservoirs.yaml` and creates an unconnected `mqtt.Client`; serial stays `None`; Influx only if `args.influx_url`. Attributes read in `__init__`: `config, mqtt_user, mqtt_password, offline_timeout, influx_url, gateway_timeout, serial_reconnect_delay`. Proven: `argparse.Namespace(config=<tools/reservoirs.yaml>, mqtt_user="", mqtt_password="", offline_timeout=300, influx_url="", gateway_timeout=0, serial_reconnect_delay=2.0)` constructs fine.
- `reservoirs` keys after load: `('0X7758',1)` alias CON, `('0X2EC4',1)` CB31, `('0X2EC4',2)` CB32, `('0X9EAC',1/2)`, `('0XA101',1)` type air_quality (SRN), etc.
- `_handle_sensor` dedups on `(node_id, sensor_id, seq)`: every test message MUST use a distinct `seq` or it is silently dropped.
- Topic helpers live at L136-149 (`mqtt_topic_state`, `mqtt_topic_status`, ...). `NodeTracker.seen` publishes `aguada/{node}/status` `online` retained the first time; log style there is `"Node %s → online"`.
- `publish_discovery` L279-384: entity dicts (nivel, pct, volume, distancia, rssi, bateria, last_update) then a loop building `payload` with `availability_topic`/`payload_available`/`payload_not_available`, published to `homeassistant/sensor/{uid}/config` retained. For CON the pct topic is `homeassistant/sensor/aguada_con_pct/config`.
- `_handle_sensor` is also called from the paho thread for `aguada/raw/#` outside `_dispatch_lock` (pre-existing, same as `_seen_seq`). Worst case for the new dict is a duplicate idempotent retained publish; no lock needed.
- Working tree has uncommitted work from another session (firmware/gps_tracker/*, tools/install_autostart_user_service.sh, tools/systemd/, .planning/debug/). Do NOT touch, stage or commit any of it (D-07).
</context>

<tasks>

<task type="auto" tdd="true">
  <name>Task 1: Per-sensor availability publish in _handle_sensor (helper, dedup dict, test)</name>
  <files>tools/bridge.py, tools/test_sensor_availability.py</files>
  <behavior>
    - `bridge.mqtt_topic_sensor_avail("0X7758", 1)` returns `aguada/0X7758/1/availability`.
    - CON msg seq=1 distance_cm=-1 flags=4 -> exactly one availability publish `("aguada/0X7758/1/availability", "offline", retain=True)`; no publish on `aguada/0X7758/1/state`.
    - CON msg seq=2 distance_cm=65535 flags=0 (still error) -> no new availability publish.
    - CON msg seq=3 distance_cm=102 flags=0 -> state published, then `online` retained; the state publish index is lower than the online publish index.
    - CON msg seq=4 distance_cm=103 flags=0 -> a second state publish, no new availability publish.
    - Fresh Bridge, 0X2EC4: sensor 1 valid (seq=10) + sensor 2 error (seq=11) -> `aguada/0X2EC4/1/availability`=online and `aguada/0X2EC4/2/availability`=offline, one publish each (first publish after start happens even without a prior opposite state); sensor 1 valid again (seq=12) -> no availability publish for either sensor.
  </behavior>
  <action>
RED first: create `tools/test_sensor_availability.py` modeled on `tools/test_bridge_dispatch.py` (module docstring "Self-check: ..." with a Run line using the venv python, `sys.path.insert(0, str(Path(__file__).parent))`, `import bridge`, plain `test_*` functions, a `__main__` block that calls every test and prints `ok`). Include:
- `FakeClient` whose `publish(self, topic, payload=None, qos=0, retain=False, **kw)` appends the tuple `(topic, payload, retain)` to `self.published`.
- `make_bridge()` building a real `bridge.Bridge` from the `argparse.Namespace` listed in context (config = `str(Path(__file__).parent / "reservoirs.yaml")`), then replacing `b.client` with a `FakeClient` and `b.tracker` with `bridge.NodeTracker(fake, 300)`; returns `(b, fake)`. Using the real `__init__` (not `Bridge.__new__`) is deliberate: it proves the new dict is initialized in `__init__`.
- A small helper filtering `fake.published` to topics ending in `/availability`, and one for a given state topic.
- A `sensor_msg(node, sid, dist, flags, seq)` builder returning the gateway JSON dict shape (`v, type="SENSOR", node_id` like `"0x7758"` lower-case hex so the `.upper()` path is exercised, `sensor_id, distance_cm, rssi=-70, vbat=None, flags, seq, ts=1`), fed straight to `b._handle_sensor(msg)`.
- Tests covering every bullet of `<behavior>` (topic format, error->offline once, repeat error silent, valid->state then online, repeat valid silent, two-sensor independence on 0X2EC4 with a fresh bridge).
Run it; it must fail (missing `mqtt_topic_sensor_avail`).

GREEN, in `tools/bridge.py`, minimal diff in the file's existing style (short comments, English logs) per D-07:
1. Per D-01, add `mqtt_topic_sensor_avail(node_id: str, sensor_id: int) -> str` right after `mqtt_topic_status`, returning `f"aguada/{node_id}/{sensor_id}/availability"`, same one-line shape as its neighbours.
2. In `Bridge.__init__`, next to the `_seen_seq` dedup cache, add `self._sensor_avail: dict[tuple, str] = {}` with a one-line comment: (node_id, sensor_id) -> last published "online"/"offline".
3. Add method `_set_sensor_avail(self, node_id: str, sensor_id: int, state: str)` placed directly above `_handle_sensor` (Message processing section). Per D-02: if `self._sensor_avail.get((node_id, sensor_id)) == state` return; else store it, `self.client.publish(mqtt_topic_sensor_avail(node_id, sensor_id), state, retain=True)` and `log.info("Sensor %s/%d → %s", node_id, sensor_id, state)` (mirrors NodeTracker's `Node %s → online`). Empty dict at start means the first call per sensor always publishes.
4. In `_handle_sensor`, HC-SR04 error branch (`distance_cm <= 0 or distance_cm == 0xFFFF or (flags & 0x04)`): keep the existing `log.warning("Sensor error: ...")` line unchanged, then call `self._set_sensor_avail(node_id, sensor_id, "offline")` before the `return` (D-02).
5. In `_handle_sensor`, immediately after the `self.client.publish(mqtt_topic_state(node_id, sensor_id), ...)` line, call `self._set_sensor_avail(node_id, sensor_id, "online")` so HA receives the fresh value before the entity turns available (D-02).
Do NOT touch `_handle_ani_sensor` (the ANI early-return happens before the new code), `_handle_heartbeat` (D-04: current firmware sends no heartbeat while the sensor is in error), NodeTracker, or `_on_mqtt_connect` (retained messages survive reconnects; D-05 accepts entities being unavailable until the next valid reading after deploy, so no startup seeding).
  </action>
  <verify>
    <automated>cd /home/luc/DEV_luctronics/luctronics_firmware/platformio && .venv/bin/python -m py_compile tools/bridge.py && .venv/bin/python tools/test_sensor_availability.py && .venv/bin/python tools/test_bridge_dispatch.py && grep -c "def mqtt_topic_sensor_avail" tools/bridge.py && grep -c "self._sensor_avail: dict" tools/bridge.py</automated>
  </verify>
  <done>Both self-checks print `ok`; each grep prints `1`; error packets publish `offline` once per transition; valid readings publish state then `online`; sensors of the same node are independent; ANI/heartbeat code paths are byte-identical to before.</done>
</task>

<task type="auto" tdd="true">
  <name>Task 2: HA discovery uses node + sensor availability for measurement entities only</name>
  <files>tools/bridge.py, tools/test_sensor_availability.py</files>
  <behavior>
    - `bridge.publish_discovery(fake, "0X7758", 1, cfg_CON)`: for uids `aguada_con_nivel`, `aguada_con_pct`, `aguada_con_volume`, `aguada_con_distancia` the JSON payload has `availability_mode == "all"`, `availability` is a list of exactly 2 dicts whose `topic`s are, in order, `aguada/0X7758/status` and `aguada/0X7758/1/availability`, each with `payload_available == "online"` and `payload_not_available == "offline"`, and the key `availability_topic` is absent.
    - For uids `aguada_con_rssi`, `aguada_con_bateria`, `aguada_con_last_update`: `availability_topic == "aguada/0X7758/status"`, `payload_available == "online"`, and neither `availability` nor `availability_mode` is present.
    - Every other payload field (name, unique_id, default_entity_id, state_topic, value_template, device, unit, state_class, device_class, icon) is unchanged, so HA updates the existing entities in place (same unique_id, no duplicates).
    - `bridge.publish_ani_discovery(fake, "0XA101", 1, cfg_SRN)`: no published payload contains `availability` or `availability_mode` (ANI untouched).
  </behavior>
  <action>
RED first: append to `tools/test_sensor_availability.py` tests for every bullet of `<behavior>` (get cfg from `make_bridge()[0].reservoirs[("0X7758", 1)]` and `[("0XA101", 1)]`, call the discovery functions with a fresh `FakeClient`, index payloads by topic `homeassistant/sensor/{uid}/config` and `json.loads` them). Register them in the `__main__` block. Run; the measurement-entity test must fail.

GREEN, in `publish_discovery` only (per D-03; `publish_gateway_discovery`, `publish_relay_discovery`, `publish_ani_discovery`, `publish_env_discovery` stay as they are):
1. Next to `avail_tp = mqtt_topic_status(node_id)` add `sensor_avail_tp = mqtt_topic_sensor_avail(node_id, sensor_id)` (the helper from Task 1, per D-01; never rebuild the string inline).
2. Add `"per_sensor": True` to the four measurement entity dicts (nivel, pct, volume, distancia). Leave rssi, bateria, last_update without it.
3. In the `for e in entities` loop, remove the three availability keys from the base `payload` literal and add them after it: when `e.get("per_sensor")`, set `payload["availability"]` to a list of two dicts `{"topic": avail_tp, "payload_available": "online", "payload_not_available": "offline"}` then the same with `sensor_avail_tp` (node first, sensor second), and `payload["availability_mode"] = "all"`; otherwise set `availability_topic`, `payload_available`, `payload_not_available` exactly as today. One short comment on the branch, e.g. that measurement entities also follow the per-sensor topic so a failed sensor shows unavailable instead of a stale value. The two forms must never both appear in one payload: HA treats `availability` and `availability_topic` as mutually exclusive and would reject the config.
Keep everything else in the function (entity list order, other keys, discovery topic, retain, debug log) unchanged.

Commit (both tasks, or one commit per task as the quick workflow prefers) staging ONLY `tools/bridge.py` and `tools/test_sensor_availability.py` by explicit path; never `git add -A` / `git add .` / `git commit -a` (D-07, other-session work in the tree).
  </action>
  <verify>
    <automated>cd /home/luc/DEV_luctronics/luctronics_firmware/platformio && .venv/bin/python -m py_compile tools/bridge.py && .venv/bin/python tools/test_sensor_availability.py && .venv/bin/python tools/test_bridge_dispatch.py && grep -c '"availability_mode"' tools/bridge.py && grep -c '"per_sensor": True' tools/bridge.py</automated>
  </verify>
  <done>Both self-checks print `ok`; `"availability_mode"` grep prints `1` (only publish_discovery); `"per_sensor": True` grep prints `4`; `git diff --stat` for this work lists only `tools/bridge.py` plus the new test file; the other-session files show the same modifications as before execution.</done>
</task>

</tasks>

<threat_model>
## Trust Boundaries

| Boundary | Description |
|---|---|
| node/gateway -> bridge | SENSOR JSON from USB serial, the gateway WiFi mirror (`aguada/gateway/rx`) and wired nodes (`aguada/raw/#`); flags/distance are node-controlled |
| bridge -> MQTT broker -> HA | retained availability + discovery configs consumed by HA |

## STRIDE Threat Register

| Threat ID | Category | Component | Severity | Disposition | Mitigation Plan |
|---|---|---|---|---|---|
| T-t20-01 | Denial of Service | `_set_sensor_avail` publishing every 120 s per sensor | low | mitigate | Publish only on state change via `self._sensor_avail` (Task 1); test asserts repeated states do not republish |
| T-t20-02 | Denial of Service | `publish_discovery` payload validity in HA | medium | mitigate | Measurement entities carry only the `availability` list, others only `availability_topic`; Task 2 test asserts the keys never coexist, so HA does not reject the config and drop the entities |
| T-t20-03 | Spoofing | forged `aguada/raw/#` packet with flags=4 marking a configured sensor offline | low | accept | Pre-existing surface: the same LAN-only, configured-node-gated path can already publish arbitrary readings; availability adds no new capability |
| T-t20-04 | Tampering | `aguada/raw/#` handler runs outside `_dispatch_lock` | low | accept | Race can only cause a duplicate idempotent retained publish of the same state; same accepted pattern as the existing `_seen_seq` cache |
| T-t20-05 | Information Disclosure | new topic `aguada/{node}/{sensor}/availability` | low | accept | Exposes only online/offline for ids already public in `aguada/{node}/{sensor}/state` |
</threat_model>

<verification>
Executor (automated):
- `.venv/bin/python tools/test_sensor_availability.py` and `.venv/bin/python tools/test_bridge_dispatch.py` both print `ok`.
- `git status --short` after commit: only the pre-existing other-session entries remain; `tools/bridge.py` and `tools/test_sensor_availability.py` are committed.

Orchestrator, after execution (D-08, not an executor task):
- `systemctl --user restart aguada-bridge`, then `journalctl --user -u aguada-bridge -f` shows `Sensor error: 0X7758/1 ...` followed by `Sensor 0X7758/1 → offline`.
- `mosquitto_sub -v -t 'aguada/+/+/availability'` shows `aguada/0X7758/1/availability offline` (retained).
- HA: `sensor.aguada_con_pct`, `_nivel`, `_volume`, `_distancia` = unavailable; `sensor.aguada_con_rssi` and `sensor.aguada_con_last_update` still have values. Other reservoirs become available again on their next valid reading (<= 120 s, D-05).
</verification>

<success_criteria>
- Sensor-error packets make only that sensor's measurement entities unavailable in HA; valid readings restore them.
- Availability publishes happen only on transitions (plus the first one per sensor after start).
- Diff limited to `tools/bridge.py` (helper, dict, one method, two call sites, `publish_discovery` loop) and the new `tools/test_sensor_availability.py`.
</success_criteria>

<output>
Create `.planning/quick/260930-t20-bridge-py-disponibilidade-por-sensor-no-/260930-t20-SUMMARY.md` when done
</output>
