lucianoET/aguada-firmware/.planning/quick/260803-l28-criar-node-ethernet-cabeado-aguada-firmw/260803-l28-PLAN.md

---
phase: quick-260803-l28
plan: 01
type: execute
wave: 1
depends_on: []
files_modified:
  - firmware/node-eth/platformio.ini
  - firmware/node-eth/src/main.cpp
  - firmware/node-eth/README.md
  - tools/bridge.py
autonomous: true
requirements: [QUICK-L28]
user_setup: []

must_haves:
  truths:
    - "`pio run -e node-cav-eth` completes successfully and the binary fits the ATmega328's 30720-byte flash"
    - "Node publishes one integer-only JSON sensor packet to `aguada/raw/0xEE02/1`, shaped exactly like the gateway serial packets `_handle_sensor` already consumes (D-02)"
    - "bridge.py subscribes to `aguada/raw/#` and routes wired-node packets through `_handle_sensor`, so the node gets reservoir math, HA Discovery, NodeTracker and InfluxDB for free (D-03)"
    - "A malformed payload, a non-dict payload, or an unknown node_id on `aguada/raw/#` is logged and dropped without raising out of the MQTT callback thread (D-03)"
    - "After 3 consecutive failed measurement cycles the node publishes `distance_cm=65535` with `flags=4`, which bridge.py already recognises as a sensor error (D-02)"
    - "A watchdog hard reset re-enters the application rather than boot-looping on the old Nano bootloader (D-02)"
  artifacts:
    - firmware/node-eth/platformio.ini
    - firmware/node-eth/src/main.cpp
    - firmware/node-eth/README.md
    - tools/bridge.py
  key_links:
    - "Node payload keys (node_id, sensor_id, distance_cm, flags, seq, rssi, vbat) ↔ keys read by `_handle_sensor` in tools/bridge.py"
    - "Node `node_id` string `0xEE02` ↔ reservoirs.yaml key `0XEE02`, bridged by `_handle_sensor`'s `msg[\"node_id\"].upper()`"
    - "`aguada/raw/#` subscription in `_on_mqtt_connect` ↔ the `aguada/raw/` prefix branch in `_on_mqtt_message`"
    - "Forced watchdog reset path in `mqttEnsure()` ↔ the `.init3` preamble that clears `MCUSR` and calls `wdt_disable()`"
---

<objective>
Add a wired Ethernet reservoir node to the Aguada fleet: a new PlatformIO project `firmware/node-eth/` (Arduino Nano + ENC28J60 + HC-SR04) that publishes protocol-shaped sensor JSON directly to MQTT, plus a small `tools/bridge.py` extension that consumes `aguada/raw/#` through the existing sensor pipeline.

Purpose: node 0xEE02 (CAV, Castelo de Incêndio) sits where ESP-NOW coverage is unreliable but wired Ethernet exists. Routing it through the bridge's existing `_handle_sensor` path (D-03) means it inherits reservoir math, HA Discovery, online/offline tracking and InfluxDB with no duplicated logic — the spec's rule that all level/volume math lives in bridge.py, never on nodes, is preserved (D-02).

Output: `firmware/node-eth/{platformio.ini,src/main.cpp,README.md}` and a modified `tools/bridge.py`.
</objective>

<execution_context>
@$HOME/.claude/gsd-core/workflows/execute-plan.md
@$HOME/.claude/gsd-core/templates/summary.md
</execution_context>

<context>
@.planning/STATE.md
@tools/bridge.py
@tools/reservoirs.yaml
@firmware/node/platformio.ini

Key facts already verified against the codebase (do not re-derive):

- `tools/bridge.py` is 1344 lines. Integration points: `_on_mqtt_connect` (line ~799, subscribes `aguada/cmd/#`), `_on_mqtt_message` (line ~834), `_handle_sensor` (line ~941), `dispatch` (line ~1237, the serial path — leave untouched).
- `_handle_sensor(msg)` reads `msg["node_id"]` (uppercased), `msg["sensor_id"]` (int), and `.get()`s `seq`, `flags`, `distance_cm`, `rssi`, `vbat`, `ts`. It ignores `msg["type"]` entirely — routing is by call site, not by the `type` string.
- `_handle_sensor` returns early when `(node_id, sensor_id)` is absent from `self.reservoirs`, but only **after** calling `self.tracker.seen(node_id)`, and `NodeTracker.seen()` publishes a retained `aguada/{id}/status = online` for whatever id it is handed. An unknown-node allowlist check must therefore happen *before* the call, not be left to `_handle_sensor`.
- `self._configured_nodes` (line 712) is a `set[str]` of uppercase node_id strings built from `reservoirs.yaml` — use it as the allowlist.
- `reservoirs.yaml` already has `"0XEE02"` / `sensor_id: 1` / alias `CAV` / `level_max_cm: 450` / `volume_max_L: 80000` / `sensor_offset_cm: 20`. No YAML change is needed.
- `_on_mqtt_connect` republishes HA Discovery for every entry in `self.reservoirs` on each reconnect, so 0xEE02 discovery already exists — the wired node needs no discovery code.
- `dispatch()` calls `_mark_gateway_seen()` for any valid serial JSON. The raw-MQTT path must **not** go through `dispatch()`, because a wired node is not the gateway and must not mark it alive.
- PlatformIO binary lives at `/home/luc/Dev/aguada-firmware-main/.venv/bin/pio` — `pio` is not on PATH.
- `paho`, `serial` and `yaml` are **not** importable in the repo venv, so any bridge.py behavioural test must stub them.
</context>

<tasks>

<task type="auto">
  <name>Task 1: Create firmware/node-eth PlatformIO project (Nano + ENC28J60 + HC-SR04)</name>
  <files>firmware/node-eth/platformio.ini, firmware/node-eth/src/main.cpp</files>
  <action>
Create the new PlatformIO project per D-01 and D-02.

**platformio.ini** — a single env `[env:node-cav-eth]` with `platform = atmelavr`, `board = nanoatmega328`, `framework = arduino`, `upload_speed = 57600` (old bootloader), `monitor_speed = 9600`, and `lib_deps` pinned to `uipethernet/UIPEthernet@^2.0.12` and `knolleary/PubSubClient@^2.8`. Per D-01, declare **no** `build_flags` at all — PlatformIO's default `-Os` is what makes this fit; the legacy `-O2` build reached 92% flash. Do not add `build_src_filter`, `-D` defines, or extra libs.

**src/main.cpp** — a single Arduino translation unit. This is an ATmega328: 2 KB RAM, 30 KB usable flash. Hard constraints for the whole file: no `String`, no floating-point math anywhere, no `sprintf`; use `snprintf_P` with `PSTR()` format strings so literals stay in flash; keep every buffer small and stack-local.

Includes: `Arduino.h`, `UIPEthernet.h`, `PubSubClient.h`, `avr/wdt.h`.

Compile-time configuration, all as `#define`/`static const`:
- `DEBUG` defaults to `0`. Define `DBG(...)`/`DBGLN(...)` macros that expand to nothing when `DEBUG` is 0, and to `Serial.print`/`Serial.println` when 1; guard `Serial.begin(9600)` in `setup()` with the same macro so a release build links no serial code at all (D-02 flash savings).
- Pins: `TRIG_PIN` 6, `ECHO_PIN` 7 (ECHO is D7 per the user's explicit decision — not D5). The ENC28J60 uses hardware SPI D11/D12/D13 with CS on D10, which is UIPEthernet's default; no CS constant is needed.
- Identity: `NODE_ID_STR` `"0xEE02"`, `SENSOR_ID` `1`, MQTT client id `"aguada-0xEE02"`, publish topic `"aguada/raw/0xEE02/1"` held in a `static const char TOPIC[]` in RAM (PubSubClient's `publish()` needs a RAM pointer).
- Network: MAC `{0xAA,0xBB,0xCC,0xDD,0xEE,0x02}`, static `IPAddress` 192.168.0.202, gateway and DNS 192.168.0.1, subnet 255.255.255.0, broker 192.168.0.101 port 1883. No DHCP, no EEPROM, no offset config, no captive portal.
- Timing/filter: `MEASURE_INTERVAL_MS` 30000UL, `FORCE_SEND_MS` 120000UL, `DELTA_CM` 2, `SAMPLES` 5, `MIN_VALID` 3, `DIST_MIN_CM` 2, `DIST_MAX_CM` 450, `PULSE_TIMEOUT_US` 30000UL, `MQTT_RETRY_MS` 5000UL, `MEAS_FAIL_LIMIT` 3, `FAIL_ETH_REINIT` 10, `FAIL_HARD_RESET` 20.

Globals: an `EthernetClient` wrapped by a `PubSubClient`, plus `uint16_t seq` (0), `uint16_t lastSent` initialised to `0xFFFF` as a never-sent sentinel, `uint32_t lastMeasureMs`/`lastSendMs`/`lastMqttTryMs`, and `uint8_t measFail`/`mqttFail`.

Watchdog reset safety (critical, D-02): the classic Nano bootloader implied by `upload_speed = 57600` does **not** clear the WDRF flag, so a deliberate watchdog reset would otherwise boot-loop the node forever. Add a function declared `__attribute__((naked, used, section(".init3")))` that zeroes `MCUSR` and calls `wdt_disable()`; it runs before `main()` and makes the forced-reset recovery path survivable.

Functions:
- `uint16_t readOnce()` — drive TRIG low 2 µs, high 10 µs, low; `pulseIn(ECHO_PIN, HIGH, PULSE_TIMEOUT_US)`; return 0 when the pulse times out, otherwise integer `duration / 58UL` narrowed to `uint16_t`. No float speed-of-sound math.
- `uint16_t measure()` — take up to `SAMPLES` readings about 60 ms apart into a `uint16_t buf[SAMPLES]`, keeping only values in `[DIST_MIN_CM, DIST_MAX_CM]`; call `wdt_reset()` inside the sampling loop. Return 0 if fewer than `MIN_VALID` samples survived; otherwise insertion-sort the valid prefix and return the median element `buf[n/2]`.
- `void netBegin()` — `Ethernet.begin(mac, ip, dns, gw, subnet)`, used both at boot and by the escalation path.
- `bool mqttEnsure()` — return true immediately when already connected; otherwise throttle attempts to one per `MQTT_RETRY_MS`, `wdt_reset()` around the connect call, and attempt `connect(CLIENT_ID)`. On success zero `mqttFail` and return true. On failure increment `mqttFail`, then escalate per D-02: at `FAIL_HARD_RESET` call `wdt_enable(WDTO_15MS)` and spin in an empty infinite loop to force a reset; at exactly `FAIL_ETH_REINIT` re-run `netBegin()`. Return false.
- `void publishReading(uint16_t cm, uint8_t flags)` — build the payload with `snprintf_P` into a `char payload[160]` using a `PSTR` format that emits, in this exact key order, `type` (string `sensor`), `node_id` (string `0xEE02`), `sensor_id` (1), `distance_cm` (`%u`), `rssi` (0), `vbat` (-1), `flags` (`%u`), `seq` (`%u`). Every numeric field is a plain integer — no decimals, no level/percent/volume fields; that math belongs to bridge.py. Publish to `TOPIC` and post-increment `seq`. PubSubClient 2.8's default 256-byte buffer comfortably holds this ~110-byte payload plus the 19-byte topic, so do **not** call `setBufferSize()` (it would cost scarce RAM).

`setup()`: init debug serial (guarded), `pinMode` TRIG output / ECHO input, `netBegin()`, `mqtt.setServer(...)`, `mqtt.setSocketTimeout(4)` **before** any connect attempt so a stalled broker cannot outlast the watchdog (D-02), then `wdt_enable(WDTO_8S)`. Seed the millis timestamps.

`loop()`: `wdt_reset()` first, then `mqttEnsure()` and `mqtt.loop()`. When `MEASURE_INTERVAL_MS` has elapsed (compare with unsigned `millis()` subtraction so the ~49-day rollover is harmless), stamp `lastMeasureMs` and call `measure()`. On a zero result increment `measFail`; once it reaches `MEAS_FAIL_LIMIT`, publish an error packet with `distance_cm` 65535 and `flags` 4 (bridge.py already treats `flags & 0x04` as a sensor error), stamp `lastSendMs`, and reset `measFail` to 0 so errors are not re-emitted every cycle. On a valid reading reset `measFail`, then send when any of these hold: `lastSent` is still the `0xFFFF` sentinel, the unsigned absolute difference between the reading and `lastSent` is at least `DELTA_CM`, or `FORCE_SEND_MS` has elapsed since `lastSendMs`. Only publish when MQTT is actually connected; on a successful publish update `lastSent` and `lastSendMs`.

Do not publish `aguada/0xEE02/status` from the node — bridge.py's `NodeTracker` owns that topic (D-02).
  </action>
  <verify>
    <automated>/home/luc/Dev/aguada-firmware-main/.venv/bin/pio run -d /home/luc/Dev/aguada-firmware-main/aguada-firmware/firmware/node-eth -e node-cav-eth</automated>
    <automated>/home/luc/Dev/aguada-firmware-main/.venv/bin/pio run -d /home/luc/Dev/aguada-firmware-main/aguada-firmware/firmware/node-eth -e node-cav-eth 2>&1 | grep -E '^(RAM|Flash):'</automated>
    <automated>grep -Ev '^\s*(//|\*|/\*)' /home/luc/Dev/aguada-firmware-main/aguada-firmware/firmware/node-eth/src/main.cpp | grep -c 'snprintf_P'</automated>
  </verify>
  <done>
  - `pio run -e node-cav-eth` exits 0.
  - Reported Flash usage is under 100% of 30720 bytes and RAM under 90% of 2048 bytes; both figures are recorded in the summary.
  - `platformio.ini` declares no `build_flags` key.
  - `main.cpp` contains the `.init3` `MCUSR`/`wdt_disable()` preamble, `mqtt.setSocketTimeout(4)` before the first connect, and at least one `snprintf_P` payload build (count from the third gate is ≥ 1 on non-comment lines).
  - No `String`, `sprintf`, `float` or `double` appears anywhere in `main.cpp`.
  </done>
</task>

<task type="auto">
  <name>Task 2: Route aguada/raw/# through the existing sensor pipeline in tools/bridge.py</name>
  <files>tools/bridge.py</files>
  <action>
Make three surgical edits to `tools/bridge.py` per D-03, matching the file's existing comment and logging style (module-level `log`, `%`-style lazy formatting, short `# ──` section banners, no f-strings in log calls).

**Edit 1 — `_on_mqtt_connect` (~line 808).** Immediately after `client.subscribe("aguada/cmd/#")`, add `client.subscribe("aguada/raw/#")` with a one-line comment explaining that wired Ethernet nodes publish sensor JSON straight to the broker instead of arriving over the gateway serial link. Leave the rest of the reconnect logic — gateway status republish, discovery loops, `sync_statuses` — untouched; 0xEE02 discovery already flows from `self.reservoirs`.

**Edit 2 — `_on_mqtt_message` JSON decode (~line 837).** The existing `try: payload = json.loads(msg.payload) / except Exception: return` silently drops malformed input. Keep the silent behaviour for command topics but log a warning for the raw path: inside the `except`, when `topic` starts with `aguada/raw/`, emit a `log.warning` naming the topic, then `return` in all cases. Do not add logging that would fire on `aguada/cmd/#`.

**Edit 3 — `_on_mqtt_message` routing (immediately after the decode block, before the `aguada/cmd/restart` branch).** Add a branch that handles `topic.startswith("aguada/raw/")` and always `return`s, so nothing falls through into command handling:
1. Reject a non-`dict` payload (a bare JSON number or list would blow up on `.get`) with a `log.warning` and return.
2. Read `node_id` from the payload, uppercase it, and check membership in `self._configured_nodes`. On a miss, `log.warning` the offending id and topic and return — this is required because `_handle_sensor` calls `self.tracker.seen(node_id)` *before* its own reservoir lookup, and `NodeTracker.seen()` publishes a retained `online` status for any id it receives; without this gate a stray or spoofed publish would create phantom retained node status topics.
3. Otherwise call `self._handle_sensor(payload)` inside a `try/except Exception` that uses `log.exception` with the topic and a truncated payload, mirroring the handler-error guard already present at the bottom of `dispatch()`. The MQTT callback thread must never die on bad input.

Do not touch `dispatch()`, and do not call `_mark_gateway_seen()` on this path — a wired node is not the gateway.

**Behavioural test.** Write a throwaway script under the session scratchpad directory (not in the repo) that proves the routing works without a broker. `bridge.py` imports `serial`, `paho.mqtt.client` and `yaml` at module scope, and none are installed in the repo venv, so the script must insert stub modules into `sys.modules` before importing. The stubs need exactly two attributes that are evaluated at import time by function annotations: a `Client` attribute on the fake `paho.mqtt.client` module (used by the `publish_*_discovery` and `NodeTracker.__init__` signatures) and a `Serial` attribute on the fake `serial` module (used by `_read_serial_line`); give `yaml` a no-op `safe_load`. Register the fake package chain under all three of `paho`, `paho.mqtt` and `paho.mqtt.client`. Then add the `tools/` directory to `sys.path`, import `bridge`, and build an instance with `bridge.Bridge.__new__(bridge.Bridge)` so `__init__` (which opens sockets) never runs; assign `_configured_nodes` as a one-element set containing the uppercase CAV id and replace `_handle_sensor` with a counter or `unittest.mock.Mock`. Drive `bridge.Bridge._on_mqtt_message` with simple objects exposing `.topic` and byte-string `.payload`, asserting four cases: a well-formed packet on the CAV raw topic increments the handler count to 1; an unknown node id on a raw topic leaves the count at 1; a non-JSON byte payload on a raw topic leaves the count at 1 and raises nothing; and a JSON scalar (non-dict) on a raw topic likewise leaves the count at 1 and raises nothing. Print `RAW_ROUTE_OK` at the end and run it with the repo venv Python. Record the script path in the summary.
  </action>
  <verify>
    <automated>python3 -m py_compile /home/luc/Dev/aguada-firmware-main/aguada-firmware/tools/bridge.py && echo COMPILE_OK</automated>
    <automated>/home/luc/Dev/aguada-firmware-main/.venv/bin/python "$SCRATCHPAD/test_raw_route.py"</automated>
    <automated>grep -Ev '^\s*#' /home/luc/Dev/aguada-firmware-main/aguada-firmware/tools/bridge.py | grep -c 'aguada/raw/'</automated>
  </verify>
  <done>
  - `py_compile` prints `COMPILE_OK`.
  - The stubbed behavioural script prints `RAW_ROUTE_OK` with all four assertions passing.
  - The third gate counts at least 3 non-comment occurrences of `aguada/raw/` (the subscribe, the malformed-JSON warning branch, and the routing branch).
  - `dispatch()`, `_handle_sensor` and `_mark_gateway_seen` are unmodified — `git diff --stat tools/bridge.py` shows a change well under 30 lines.
  </done>
  <human-check>
  With the broker reachable, run the bridge and publish a hand-crafted packet:
  `mosquitto_pub -h localhost -t 'aguada/raw/0xEE02/1' -m '{"type":"sensor","node_id":"0xEE02","sensor_id":1,"distance_cm":120,"rssi":0,"vbat":-1,"flags":0,"seq":1}'`
  Expect a bridge log line shaped like `CAV    dist=120cm  level=350cm  pct= 77.8%  vol=...L` and a retained payload on `aguada/0XEE02/1/state`, plus `aguada/0XEE02/status` flipping to `online`.
  </human-check>
</task>

<task type="auto">
  <name>Task 3: Write firmware/node-eth/README.md</name>
  <files>firmware/node-eth/README.md</files>
  <action>
Write a short, practical README for the wired node per D-04 — Portuguese to match the repo's other node docs, no more than roughly one screen.

Sections:
- **Resumo** — one paragraph: Arduino Nano + ENC28J60 + HC-SR04 for node 0xEE02 (CAV, Castelo de Incêndio); publishes JSON to `aguada/raw/0xEE02/1`; all level/percent/volume math happens in `bridge.py` using `tools/reservoirs.yaml`, never on the node.
- **Pinout** — a table with columns Sinal / Pino Nano / Observação covering HC-SR04 TRIG on D6, HC-SR04 ECHO on D7, ENC28J60 CS on D10, SI/MOSI on D11, SO/MISO on D12, SCK on D13, and the 5 V / GND rails. Note that HC-SR04 needs 5 V while the ENC28J60 is a 3.3 V part.
- **Alimentação (importante)** — call out the failure mode explicitly: the ENC28J60 draws roughly 120–180 mA and the Nano's onboard 3V3 pin cannot supply it. The module must either carry its own onboard 3.3 V regulator or be fed from an external AMS1117-3.3 (or equivalent) rail sharing ground with the Nano. Symptom of getting this wrong: the board links but MQTT connects then drops, or the node resets in a loop.
- **Rede** — static IP 192.168.0.202, gateway/DNS 192.168.0.1, mask 255.255.255.0, MAC `AA:BB:CC:DD:EE:02`, broker 192.168.0.101:1883, MQTT client id `aguada-0xEE02`, topic `aguada/raw/0xEE02/1`. State that there is no DHCP and no on-device configuration — changing any of this means editing `src/main.cpp` and reflashing.
- **Build e gravação** — the exact commands using the venv binary, since `pio` is not on PATH: build with `/home/luc/Dev/aguada-firmware-main/.venv/bin/pio run -e node-cav-eth`, upload with the same plus `-t upload --upload-port /dev/ttyUSB0`, monitor with `pio device monitor -b 9600`. Note that the Nano uses the old 57600-baud bootloader and that serial output only appears when `DEBUG` is set to 1 in `src/main.cpp`.
- **Comportamento** — measurement every 30 s, median of 5 samples (a cycle needs at least 3 valid readings in the 2–450 cm window), transmit on a ≥ 2 cm change or after 120 s, error packet with `distance_cm=65535` and `flags=4` after 3 consecutive failed cycles, 8 s watchdog, MQTT retry every 5 s, Ethernet re-init after 10 consecutive connect failures and a forced reset after 20.
- **Troubleshooting** — a short list of one-liners: verify the broker sees the node with `mosquitto_sub -h 192.168.0.101 -t 'aguada/raw/#' -v`; verify the bridge republished it with `mosquitto_sub -h 192.168.0.101 -t 'aguada/0XEE02/#' -v`; ping 192.168.0.202 to separate a link problem from a broker problem; if ping works but MQTT does not, suspect the 3.3 V supply or a broker ACL; if nothing appears on any topic, set `DEBUG` to 1, reflash and watch the serial monitor at 9600.

Do not document features the firmware does not have — there is no OTA, no deep sleep, no EEPROM config and no web UI on this node.
  </action>
  <verify>
    <automated>test -s /home/luc/Dev/aguada-firmware-main/aguada-firmware/firmware/node-eth/README.md && grep -c -E 'D6|D7|D10|192\.168\.0\.202|aguada/raw/0xEE02/1|AMS1117' /home/luc/Dev/aguada-firmware-main/aguada-firmware/firmware/node-eth/README.md</automated>
  </verify>
  <done>
  - `firmware/node-eth/README.md` exists and is non-empty.
  - The gate counts at least 6 matching lines, confirming the pinout, static IP, topic and power-regulator warning are all present.
  - Every pin, IP, port and interval in the README matches the constants actually compiled into `src/main.cpp`.
  </done>
</task>

</tasks>

<threat_model>
## Trust Boundaries

| Boundary | Description |
|---|---|
| LAN host → MQTT broker | Any device on 192.168.0.0/24 can publish to `aguada/raw/#`; the broker is plaintext 1883 with no per-client ACL configured. |
| MQTT broker → bridge.py | New surface: bridge.py now accepts sensor data from a network topic, not only from the physically attached serial gateway. |
| HC-SR04 → node firmware | Untrusted analogue timing input parsed into a `uint16_t` distance on a 2 KB-RAM MCU. |

## STRIDE Threat Register

| Threat ID | Category | Component | Severity | Disposition | Mitigation Plan |
|---|---|---|---|---|---|
| T-L28-01 | Spoofing | `_on_mqtt_message` raw branch, tools/bridge.py | medium | mitigate | Task 2 gates the raw path on `self._configured_nodes` membership before calling `_handle_sensor`, so an arbitrary `node_id` cannot reach `NodeTracker.seen()` and mint a retained `aguada/{id}/status = online` topic. Injection of a *plausible* reading for a configured node remains possible on a trusted LAN — see T-L28-03. |
| T-L28-02 | Denial of Service | `_on_mqtt_message`, paho callback thread | medium | mitigate | Task 2 wraps `json.loads` (existing), adds a non-`dict` payload rejection, and wraps `_handle_sensor` in `try/except Exception` + `log.exception`, mirroring `dispatch()`. A malformed or hostile payload logs and is dropped instead of killing the MQTT loop thread and silently deafening the whole bridge. |
| T-L28-03 | Tampering | MQTT transport, node ↔ broker | low | accept | ATmega328 with UIPEthernet cannot do TLS in 30 KB of flash, and the existing gateway/bridge deployment is already plaintext MQTT on an isolated industrial LAN. Broker-side authentication and a topic ACL restricting `aguada/raw/#` writes to the node's credentials are the correct fix and belong to `tools/mosquitto/` configuration, outside this task. Task 3's README documents the exposure so it is a known, recorded risk rather than a silent one. |
| T-L28-04 | Information Disclosure | `aguada/raw/#` payloads | low | accept | Payloads carry only reservoir distance readings — no credentials, no PII. Plaintext exposure on the LAN has no meaningful confidentiality impact. |
| T-L28-05 | Denial of Service | node firmware watchdog path | medium | mitigate | The `wdt_enable(WDTO_15MS)` forced-reset escalation is self-bricking on the classic Nano bootloader, which does not clear WDRF — the node would boot-loop out of the field permanently. Task 1 adds the `.init3` `MCUSR = 0; wdt_disable();` preamble so the recovery path actually recovers. `mqtt.setSocketTimeout(4)` keeps a stalled broker from tripping the 8 s watchdog during a normal connect. |
| T-L28-SC | Tampering | PlatformIO dependency `uipethernet/UIPEthernet` | low | mitigate | Not an npm/pip/cargo install, so the package-legitimacy checkpoint protocol does not apply; PubSubClient@^2.8 is already an established dependency of `firmware/gateway`. UIPEthernet is new: pin it to `^2.0.12` as specified, and confirm the package page on registry.platformio.org resolves to the known `UIPEthernet` library before the first build. Do not let PlatformIO resolve an unpinned or differently-owned package. |
</threat_model>

<verification>
1. `pio run -e node-cav-eth` builds clean; Flash under 30720 bytes and RAM under ~1840 bytes, both recorded.
2. `python3 -m py_compile tools/bridge.py` passes.
3. The stubbed raw-routing script prints `RAW_ROUTE_OK` (valid packet routed once; unknown node, malformed JSON and non-dict payload all dropped without raising).
4. `git diff --stat tools/bridge.py` shows a contained change; `dispatch()` and `_handle_sensor` are byte-identical to their pre-task state.
5. README pin/IP/topic/interval values match `src/main.cpp` constants exactly.
6. Deferred to hardware (`human_verify_mode: end-of-phase`): flashing the Nano, confirming the ENC28J60 links on 192.168.0.202, and observing a real reading land on `aguada/0XEE02/1/state` in Home Assistant.
</verification>

<success_criteria>
- `firmware/node-eth/` is a self-contained PlatformIO project that compiles for `nanoatmega328` within the ATmega328's flash and RAM budget, with no `build_flags` override.
- The node emits integer-only, gateway-shaped sensor JSON on `aguada/raw/0xEE02/1` and performs no reservoir math.
- `tools/bridge.py` subscribes to `aguada/raw/#` and feeds validated packets into `_handle_sensor`, giving the wired node reservoir math, HA Discovery, online/offline tracking and InfluxDB with zero duplicated logic.
- Unknown node ids, malformed JSON and non-dict payloads on the raw topic are logged and dropped without disturbing the MQTT callback thread or the serial gateway path.
- `firmware/node-eth/README.md` documents pinout, the ENC28J60 power requirement, network settings, venv-based build commands and troubleshooting.
</success_criteria>

<output>
Create `.planning/quick/260803-l28-criar-node-ethernet-cabeado-aguada-firmw/260803-l28-SUMMARY.md` when done.
</output>
