lucianoET/aguada-firmware/.planning/phases/01.1-perifericos-i2c-e-display/01.1-UAT.md

---
status: testing
phase: 01.1-perifericos-i2c-e-display
source: [01.1-VERIFICATION.md]
started: 2026-08-03T11:45:00Z
updated: 2026-08-03T11:45:00Z
---

## Current Test

number: 1
name: Boot com os 4 módulos ligados — scan I2C completo
expected: |
  Serial mostra `[I2C] scan sda=6 scl=7`, uma linha `[I2C] found 0x..` por módulo,
  e `[I2C] modules disp=on accel=on mag=on env=on`. Registrar endereço da bússola
  (0x1E HMC5883L / 0x0D QMC5883L / 0x0C VCM5883L).
awaiting: user response

## Tests

### 1. Boot com os 4 módulos ligados — scan I2C completo
expected: Todos os 4 endereços encontrados; modules=on para os 4; identidade do chip da bússola registrada (T-01.1-SC).
result: [pending]

### 2. Boot com subconjunto de módulos ausente (incluindo zero)
expected: Firmware roda; `gps_reader → fix_gate → cadence` segue emitindo `[EMIT]`/`[REJECT]`/`[HEALTH]`; `[HEALTH]` marca módulos ausentes como off (D-12).
result: [pending]

### 3. Recovery em runtime (confirmação direta dos fixes CR-01/CR-02)
expected: |
  Ambos os casos: (a) módulo presente no boot, desplugado/replugado; (b) OLED/bússola
  ausente no boot, ligado pela primeira vez em sessão. `[HEALTH]` marca offline após
  DEFAULT_I2C_ERROR_THRESHOLD erros e volta online em ~10s da (re)conexão. Log
  `[I2C] %s recovered` só aparece quando reinit genuinamente sucedeu — módulo com
  chip/endereço errado permanece offline, sem falso "recovered" (D-13).
result: [pending]

### 4. Shake do tracker parado — wake do accel
expected: `[ACCEL]` wake + `[STATE] STATIONARY -> MOVING` em ~300ms sem esperar 3 fixes GPS; parada só rebaixa via debounce GPS de 3 fixes lentos (D-05/D-06).
result: [pending]

### 5. Rotação completa da bússola + calibração `cal` 2x
expected: `hdg=` acompanha rotação monotonicamente; offsets persistem em NVS após reboot; captura sub-rotacionada é rejeitada (D-09/D-10/D-11).
result: [pending]

### 6. Simulador de bancada (s/+/-) cruzando limiar de velocidade
expected: `hdg_src` alterna entre mag e gps em ~3 km/h (DEFAULT_GPS_STATIONARY_KMH, D-08).
result: [pending]

### 7. Telas do OLED — aquisição pré-fix e tela densa pós-fix
expected: Tela D-03 (NO FIX, sats em vista, uptime, sensores) antes do fix; tela densa D-01 depois (tudo simultâneo, sem paginação), refresh ~1 Hz alinhado ao fix; rebuild com `-DDEFAULT_SPEED_UNIT=1` muda label para `kt` (D-01/D-02/D-03/D-04).
result: [pending]

### 8. Desplugar OLED com firmware rodando
expected: Sem freeze; `[HEALTH]` segue emitindo com `disp=off`; recupera ao replugar, e "recovered" só com `U8g2::begin()` genuíno (D-12/D-13).
result: [pending]

## Summary

total: 8
passed: 0
issues: 0
pending: 8
skipped: 0
blocked: 0

## Gaps
