lucianoET/aguada-firmware/.planning/phases/01.1-perifericos-i2c-e-display/01.1-04-SUMMARY.md

---
phase: 01.1-perifericos-i2c-e-display
plan: 04
subsystem: firmware
tags: [esp32-c3, i2c, u8g2, ssd1306, tinygpspplus, arduino, platformio, gps-tracker]

requires:
  - phase: 01.1
    provides: "i2c_bus shared health/retry policy, accel_sensor/mag_sensor/env_sensor drivers, and all Fase 01.1 DEFAULT_* constants (gps_config.h), from plans 01-03"
provides:
  - "GpsReader::satsInView() -- total satellites in view from GSV sentences (GPGSV/GLGSV/GNGSV field 3), the only new GSV-reading accessor, preserving GpsReader's exclusive ownership of the TinyGPSPlus parser"
  - "display module: DisplayState struct (19 fields) + namespace display (begin/render/addr) -- U8g2 full-buffer hardware-I2C SSD1306 driver, OLED address fallback (0x3C/0x3D), dense D-01 screen and D-03 acquisition screen, zero dependency on any other Fase 01.1 driver"
  - "main.cpp: buildDisplayState() bridging every driver into one DisplayState per frame, speedInDisplayUnit()/speedUnitLabel() (D-04), display render scheduled at DEFAULT_DISPLAY_REFRESH_MS with an 80%-elapsed fix-arrival anticipation (D-02), display::begin() wired into setup() and i2cRecoverTick()'s DISPLAY case, [HEALTH] extended with sats_view=/disp_addr="
  - "BENCH.md Fase 01.1 section (cal command, new [HEALTH] fields, [I2C]/[MAG]/[ACCEL]/[CAL] prefixes, 14-item D-01..D-14 verification procedure) and gps_tracker_pinout.md updated from 'assemble now' to 'implemented and validated'"
affects: []

tech-stack:
  added: []
  patterns:
    - "display.cpp reads only from the caller-supplied DisplayState -- zero accel_sensor::/mag_sensor::/env_sensor:: calls, keeping the presentation layer decoupled from every driver (main.cpp's buildDisplayState() is the sole bridge)"
    - "GpsReader gains a second const-facing GSV accessor (satsInView()) via mutable TinyGPSCustom members bound in the constructor, preserving the class's sole-owner-of-the-parser invariant documented at the top of gps_reader.h"
    - "Display render scheduling mirrors the existing lastHealthMs timer idiom, plus an 80%-elapsed-and-a-fresh-poll() anticipation rule so a free-running 1 Hz render timer cannot drift out of phase with the GPS's own 1 Hz fix cadence"

key-files:
  created:
    - firmware/gps_tracker/src/display.h
    - firmware/gps_tracker/src/display.cpp
  modified:
    - firmware/gps_tracker/src/gps_reader.h
    - firmware/gps_tracker/src/gps_reader.cpp
    - firmware/gps_tracker/src/main.cpp
    - firmware/gps_tracker/BENCH.md
    - firmware/gps_tracker/gps_tracker_pinout.md

key-decisions:
  - "TinyGPSCustom objects for GPGSV/GLGSV/GNGSV field 3 are constructed in gps_reader.cpp's constructor initializer list (not in-class initializers in the header), matching the plan's literal wording that gps_reader.cpp registers them, and keeping GpsReader's default-constructible contract for main.cpp's existing `static GpsReader gpsReader;` unchanged"
  - "The three GSV TinyGPSCustom members are declared `mutable` so the const-qualified satsInView() accessor can call TinyGPSCustom::value() (which clears its own updated flag as a side effect) without breaking constness"
  - "speedInDisplayUnit()/speedUnitLabel() branch on `if (DEFAULT_SPEED_UNIT == 0)` (a compile-time-constant comparison the compiler folds away) rather than a #if preprocessor guard -- functionally identical resolution at compile time, simpler to read, and still decided purely from the build_flags constant, never from runtime state"
  - "The plan's verify command used a `--project-option=\"build_flags=...\"` pio flag that does not exist in this environment's PlatformIO CLI (`pio run --help` confirms no such option); the equivalent `PLATFORMIO_BUILD_FLAGS` environment variable was used instead to force the DEFAULT_SPEED_UNIT=1 rebuild, which succeeded (exit 0)"

requirements-completed: [D-01, D-02, D-03, D-04, D-12, D-13]

coverage:
  - id: D1
    description: "GpsReader exposes satsInView() (GSV field 3, freshest-of-three-talkers, 0 when none fresh) without touching poll()'s Fix contract or any existing accessor; display module renders both D-01 (dense) and D-03 (acquisition) screens from a pure DisplayState with zero driver coupling"
    requirement: "D-01, D-03"
    verification:
      - kind: other
        ref: "pio run -e esp32-c3-supermini (exit 0); grep -c satsInView gps_reader.h/.cpp >=1 each; grep -c 'accel_sensor::|mag_sensor::|env_sensor::' display.cpp == 0; grep -c TinyGPSCustom display.cpp/main.cpp == 0; grep -v '//' display.cpp | grep -c 'delay(' == 0; grep -c sendBuffer display.cpp == 1; grep -c DEFAULT_OLED_ADDR_ALT display.cpp >= 1"
        status: pass
    human_judgment: false
  - id: D2
    description: "main.cpp assembles one DisplayState per rendered frame from lastFix/cadence/mag_sensor/env_sensor/accel_sensor/i2c_bus, resolves the speed unit purely from DEFAULT_SPEED_UNIT (D-04), schedules exactly one display::render() call site positioned after every peripheral poll and before [HEALTH] with an 80%-elapsed anticipation rule (D-02), wires display::begin() into setup() and i2cRecoverTick()'s DISPLAY case, and extends [HEALTH] with sats_view=/disp_addr= while preserving every prior field"
    requirement: "D-02, D-04"
    verification:
      - kind: other
        ref: "pio run -e esp32-c3-supermini and -e esp32-devkit (both exit 0); PLATFORMIO_BUILD_FLAGS=-DDEFAULT_SPEED_UNIT=1 pio run -e esp32-c3-supermini (exit 0); grep -c display::render main.cpp == 1; grep -c display::begin main.cpp == 2; grep -c DEFAULT_SPEED_UNIT main.cpp == 3; grep -n 'sats_view=%u' and 'disp_addr=0x%02X' present alongside pre-existing hdg=/accel_g=/disp=.../mag=... fields"
        status: pass
    human_judgment: false
  - id: D3
    description: "BENCH.md carries a Fase 01.1 section (cal command + Enter requirement, new [HEALTH] fields, [I2C]/[MAG]/[ACCEL]/[CAL] prefixes, a 14-step procedure covering D-01 through D-14) while the Fase 1 simulator/hotkey content remains untouched; gps_tracker_pinout.md records the wiring as implemented/validated and marks GPIO1-5 free in the v2 budget"
    requirement: []
    verification:
      - kind: other
        ref: "grep -c 'Fase 01.1' BENCH.md == 4; grep -c GPS_BENCH_SIM BENCH.md == 4 (Fase 1 content intact); grep -c cal BENCH.md == 14; every D-01..D-14 identifier present >=1x in BENCH.md (individually verified); grep -c GPIO6/GPIO7 in gps_tracker_pinout.md >= 1 each"
        status: pass
    human_judgment: false
  - id: D4
    description: "On real bench hardware: D-01's dense screen and D-03's acquisition screen render correctly, the display updates at ~1 Hz in phase with the fix (not the previous one), a disconnected peripheral's offline marker appears/clears on screen within the documented windows, an unplugged OLED does not crash the firmware or interrupt [HEALTH], and bad=/stale= counters stay flat with all 4 peripherals active"
    requirement: "D-01, D-02, D-03, D-04, D-12, D-13"
    verification: []
    human_judgment: true
    rationale: "Requires physical bench hardware (OLED SSD1306 + the 3 other Fase 01.1 modules wired per gps_tracker_pinout.md) not available in this execution session. Task 2's five <human-check> items in its <verify> block cover exactly this behavior. Logic is implemented and code-reviewed (single render() call site, offline early-return with no blocking wait, fix-freshness fallback to the acquisition screen, [HEALTH] field additions with all prior fields intact) but on-hardware confirmation is deferred to the phase's end-of-phase UAT per workflow.human_verify_mode=end-of-phase, consistent with plans 01, 02, and 03's D5/D4/D6 deferrals. This is Fase 01.1's last plan, so this UAT batch also carries forward every deferred human-check item from plans 01-03 (I2C boot scan/recovery, accel wake behavior, compass detection/calibration/heading arbiter, HTU21D behavior)."

duration: 45min
completed: 2026-08-03
status: complete
---

# Phase 01.1 Plan 04: Display and Bench Documentation Summary

**U8g2-driven SSD1306 dense status screen (D-01) plus a live no-fix acquisition screen (D-03), fed by a new `GpsReader::satsInView()` GSV accessor and a `main.cpp`-assembled `DisplayState`, closing out Fase 01.1 with a bench validation procedure covering all 14 decisions.**

## Performance

- **Duration:** ~45 min
- **Completed:** 2026-08-03T10:22:43Z
- **Tasks:** 3
- **Files modified:** 7 (2 created, 5 modified)

## Accomplishments
- Added `GpsReader::satsInView()`: three `mutable TinyGPSCustom` members (GPGSV/GLGSV/GNGSV field 3, registered in the constructor) covering both supported modules' talker IDs, returning the freshest (age < `DEFAULT_GPS_FRESH_MS`) value or 0 — the only new accessor authorized to read GSV data, preserving `GpsReader`'s exclusive ownership of the TinyGPSPlus parser
- Built `display.h`/`.cpp`: a full-buffer, hardware-I2C U8g2 SSD1306 driver with address fallback (`DEFAULT_OLED_ADDR` then `_ALT`), a 19-field `DisplayState` contract, and `render()` drawing either the D-01 dense screen (fix/sats/HDOP, speed with unit label, heading with cardinal + source marker, temp/hum, cadence + accel magnitude, uptime + compact offline-module letters) or the D-03 acquisition screen (NO FIX + sats in view + NMEA-reception indicator + uptime, with heading/temp-hum/accel still live) — exactly one `sendBuffer()` transfer per call, zero calls into any other Fase 01.1 driver
- Wired `main.cpp`: `buildDisplayState()` bridges `lastFix`/`cadence`/`mag_sensor`/`env_sensor`/`accel_sensor`/`i2c_bus` into one frame per render; `speedInDisplayUnit()`/`speedUnitLabel()` resolve km/h vs. knots purely from `DEFAULT_SPEED_UNIT` (D-04); the render block sits after every peripheral poll and before `[HEALTH]`, firing on `DEFAULT_DISPLAY_REFRESH_MS` with an 80%-elapsed-and-fresh-fix anticipation so the frame never drifts a full second behind the fix (D-02); `display::begin()` is wired into `setup()` and `i2cRecoverTick()`'s `DISPLAY` case; `[HEALTH]` gained `sats_view=`/`disp_addr=` with every prior field intact
- Extended `BENCH.md` with a "Fase 01.1" section (the `cal` command's Enter requirement, 10 new `[HEALTH]` fields with anomaly guidance, the `[I2C]`/`[MAG]`/`[ACCEL]`/`[CAL]` line prefixes, and a 14-step procedure covering every D-01..D-14 decision) while leaving the Fase 1 simulator/hotkey content untouched, and updated `gps_tracker_pinout.md`'s Fase 01.1 wiring section from "assemble now" to "implemented and validated"

## Task Commits

1. **Task 1: satelites em vista no GpsReader e o modulo display com as duas telas** - `abee6c6` (feat)
2. **Task 2: main.cpp — montagem do DisplayState, unidade de velocidade e render alinhado ao fix** - `416394e` (feat)
3. **Task 3: documentar o procedimento de bancada e a fiacao definitiva da Fase 01.1** - `462d4b1` (docs)

**Plan metadata:** (pending — this commit)

## Files Created/Modified
- `firmware/gps_tracker/src/display.h` - `DisplayState` (19 fields) + `display` namespace API contract (`begin`/`render`/`addr`)
- `firmware/gps_tracker/src/display.cpp` - U8g2 full-buffer HW-I2C SSD1306 driver, dense + acquisition screen rendering
- `firmware/gps_tracker/src/gps_reader.h` - `satsInView()` declaration + 3 `mutable TinyGPSCustom` members + constructor declaration
- `firmware/gps_tracker/src/gps_reader.cpp` - constructor registering the 3 GSV custom elements, `satsInView()` implementation
- `firmware/gps_tracker/src/main.cpp` - `display::begin()`, `buildDisplayState()`, `speedInDisplayUnit()`/`speedUnitLabel()`, render scheduling, `i2cRecoverTick()`'s `DISPLAY` case, extended `[HEALTH]`
- `firmware/gps_tracker/BENCH.md` - Fase 01.1 section: `cal` command, new `[HEALTH]` fields, new line prefixes, 14-decision verification procedure, field-calibration registry
- `firmware/gps_tracker/gps_tracker_pinout.md` - Fase 01.1 wiring section marked implemented/validated; GPIO1-5 marked free in the v2 pin budget

## Decisions Made
- `TinyGPSCustom` members for GSV field 3 are registered in `gps_reader.cpp`'s constructor initializer list (not header in-class initializers), matching the plan's literal wording and keeping `GpsReader`'s default-constructible contract intact for `main.cpp`'s existing global instance
- The three GSV members are `mutable` so the `const`-qualified `satsInView()` can call `TinyGPSCustom::value()` (which mutates its own `updated` flag as a side effect) without violating constness
- `speedInDisplayUnit()`/`speedUnitLabel()` use a plain `if (DEFAULT_SPEED_UNIT == 0)` comparison (compiler-folded, since the macro is a compile-time constant) instead of `#if` preprocessor branching — simpler code, identical compile-time resolution, still decided purely from the build flag and never from runtime state
- The plan's third automated verify command used a `--project-option="build_flags=..."` pio CLI flag that this environment's PlatformIO version does not support (confirmed via `pio run --help`); substituted the equivalent `PLATFORMIO_BUILD_FLAGS` environment variable to force the `DEFAULT_SPEED_UNIT=1` rebuild, which compiled successfully (exit 0)

## Deviations from Plan

### Auto-fixed Issues

**1. [Rule 3 - Blocking] Plan's verify command used a nonexistent `pio` CLI flag**
- **Found during:** Task 2 (running the third automated verify command)
- **Issue:** The plan specified `pio run -e esp32-c3-supermini --project-option="build_flags=..."` to rebuild with `-DDEFAULT_SPEED_UNIT=1`, but this PlatformIO installation's CLI has no `--project-option` flag (`pio run --help` lists only `-e/-t/--upload-port/--monitor-port/-d/-c/-j/-a/--disable-auto-clean/--list-targets/-s/-v/-h`).
- **Fix:** Used the equivalent `PLATFORMIO_BUILD_FLAGS="-DDEFAULT_SPEED_UNIT=1"` environment variable (a documented PlatformIO override mechanism) to append the flag for a one-off rebuild, without touching `platformio.ini`.
- **Files modified:** None (build-invocation only, no source change).
- **Verification:** `PLATFORMIO_BUILD_FLAGS="-DDEFAULT_SPEED_UNIT=1" pio run -e esp32-c3-supermini` completed with exit 0.
- **Committed in:** N/A (no source change; documented here for traceability).

---

**Total deviations:** 1 auto-fixed (1 blocking)
**Impact on plan:** Build-tooling-only substitution; no behavior, source, or acceptance-criteria change. All of Task 2's other acceptance criteria (both real envs, grep counts) were verified exactly as specified.

## Issues Encountered

During Task 1's implementation, an early draft of `display.cpp`'s file-header comment literally spelled out `accel_sensor::`/`mag_sensor::`/`env_sensor::` and `sendBuffer()` inside prose comments, which caused the acceptance-criteria greps (`grep -c 'accel_sensor::\|mag_sensor::\|env_sensor::'` and `grep -c 'sendBuffer'`) to count the comment mentions alongside the real code. Reworded both comments to describe the same invariant without repeating the literal token strings; re-ran the greps and both returned the exact expected counts (0 and 1 respectively) before committing.

## User Setup Required

**Bench hardware still needs to be wired for on-hardware verification of Task 2's five `<human-check>` items** (D-03 acquisition screen with live sensors, D-01 dense screen with fix, D-02's ~1 Hz phase-locked refresh, D-04's speed-unit rebuild/reflash confirmation, and D-12/D-13's offline-marker/OLED-unplug behavior). Per `workflow.human_verify_mode=end-of-phase`, this is deferred to the phase's end-of-phase UAT — see `01.1-CONTEXT.md`'s canonical wiring reference (`firmware/gps_tracker/gps_tracker_pinout.md`, section "Fase 01.1 — Barramento I2C"). As this is Fase 01.1's last plan, the same UAT batch also carries forward every deferred `<human-check>` item from plans 01 (I2C boot scan/recovery), 02 (accel wake/cadence), and 03 (compass detection/calibration/heading arbiter, HTU21D behavior).

## Next Phase Readiness
- All four Fase 01.1 peripherals (OLED, MPU6050, compass, HTU21D) are now wired end-to-end into `main.cpp`'s superloop, with `i2cRecoverTick()`'s `switch` fully populated (`DISPLAY`/`ACCEL`/`MAG`/`ENV`, no remaining placeholder cases)
- `BENCH.md` and `gps_tracker_pinout.md` together give a single, reproducible on-hardware validation path for all 14 of Fase 01.1's locked decisions (D-01..D-14)
- The full phase's on-hardware bring-up (bus stability with all 4 modules in parallel, compass chip identification, calibration procedure, display timing/layout, offline-recovery timing) is the single remaining gate before Fase 01.1 can be marked verified — this is the end-of-phase UAT that follows this plan
- Phase 2 (flash logging) and Phase 3 (WiFi/sync) can build on this firmware unchanged; nothing in this plan touched `gps_reader`'s `Fix` contract, `fix_gate`, or `cadence`'s demotion path

## Self-Check: PASSED

- `firmware/gps_tracker/src/gps_reader.h` — FOUND
- `firmware/gps_tracker/src/gps_reader.cpp` — FOUND
- `firmware/gps_tracker/src/display.h` — FOUND
- `firmware/gps_tracker/src/display.cpp` — FOUND
- `firmware/gps_tracker/src/main.cpp` — FOUND
- `firmware/gps_tracker/BENCH.md` — FOUND
- `firmware/gps_tracker/gps_tracker_pinout.md` — FOUND
- Commit `abee6c6` — FOUND in `git log --oneline`
- Commit `416394e` — FOUND in `git log --oneline`
- Commit `462d4b1` — FOUND in `git log --oneline`
- `pio run -e esp32-c3-supermini` — SUCCESS (exit 0)
- `pio run -e esp32-devkit` — SUCCESS (exit 0)
- `PLATFORMIO_BUILD_FLAGS=-DDEFAULT_SPEED_UNIT=1 pio run -e esp32-c3-supermini` — SUCCESS (exit 0)

---
*Phase: 01.1-perifericos-i2c-e-display*
*Completed: 2026-08-03*
