lucianoET/aguada-firmware/.planning/phases/01.1-perifericos-i2c-e-display/01.1-03-SUMMARY.md

---
phase: 01.1-perifericos-i2c-e-display
plan: 03
subsystem: firmware
tags: [esp32-c3, i2c, dfrobot-qmc5883, htu21d, hard-iron-calibration, arduino, platformio, gps-tracker]

requires:
  - phase: 01.1
    provides: "i2c_bus shared health/retry policy (present/bind/boundAddr/setOnline/online/reportOk/reportError/restoreClock/reinitDue/clearReinit) and Fase 01.1 DEFAULT_* constants (gps_config.h), from plan 01"
provides:
  - "mag_sensor module: DFRobot_QMC5883-backed compass wrapper auto-detecting HMC5883L (0x1E) / QMC5883L (0x0D) / VCM5883L (0x0C), heading computed locally via atan2f on hard-iron-corrected X/Y axes + DEFAULT_MAG_DECLINATION (D-10, no tilt compensation), hard-iron calibration capture persisted in NVS namespace \"magcal\" (D-09), and arbitratedHeading() blending compass/GPS-course by DEFAULT_GPS_STATIONARY_KMH (D-08)"
  - "env_sensor module: Adafruit HTU21DF wrapper alternating temperature/humidity reads per poll() call (halves the ~100ms combined blocking cost), last-known-value fallback on a failed read (D-14, display/serial only)"
  - "main.cpp wiring: scheduled mag/env polls, calHandleChar() multi-character \"cal\" serial command parser (bounded 8-byte buffer, consulted before the Fase 1 single-char hotkey dispatch), real chip re-init in i2cRecoverTick()'s MAG/ENV cases, extended [HEALTH] with hdg=/hdg_src=/mag_chip=/temp=/hum=, and a [CAL] active progress line"
affects: [01.1-04-display]

tech-stack:
  added: []
  patterns:
    - "Heading computed locally via atan2f on hard-iron-corrected axes, never via the DFRobot_QMC5883 library's own getHeadingDegrees() (which neither applies calibration offsets nor returns a value)"
    - "Compass address chosen via i2c_bus::present() probed in HMC/QMC/VCM order, with the DFRobot_QMC5883 instance reallocated only when the detected address changes -- required because the library's internal _I2C_addr (set at construction) must match the address its own begin() auto-detected, or all subsequent register reads target the wrong device"
    - "Multi-character serial command parsing (calHandleChar) consulted before the existing single-char hotkey switch, returning a consumed/fall-through boolean so 'cal' and the Fase 1 hotkeys (r/h/s/+/-/x/z/b) cannot collide"
    - "Cheap Wire probe ahead of a library's own blocking read (mag_sensor, env_sensor) so a genuinely disconnected module reports through i2c_bus::reportError() instead of silently reusing stale data"

key-files:
  created:
    - firmware/gps_tracker/src/mag_sensor.h
    - firmware/gps_tracker/src/mag_sensor.cpp
    - firmware/gps_tracker/src/env_sensor.h
    - firmware/gps_tracker/src/env_sensor.cpp
  modified:
    - firmware/gps_tracker/src/main.cpp

key-decisions:
  - "DFRobot_QMC5883 instance constructed with the address i2c_bus::present() detected (not the library's default 0x0C) -- the library's begin() auto-detects ICType by scanning its own hardcoded HMC/QMC/VCM addresses, but all subsequent register reads use the constructor-supplied _I2C_addr, so the two must match or reads silently target the wrong device"
  - "Added mag_sensor::calRange() accessor beyond Task 1's originally-declared 13-function API -- Task 3's bench-visible '[CAL] active' progress line needs to read the in-progress capture's live min/max without duplicating that accumulator state in main.cpp"
  - "A lightweight Wire.beginTransmission/endTransmission probe precedes both mag_sensor's and env_sensor's actual library read calls, purely to route genuine disconnects through i2c_bus::reportError()/D-13 -- the libraries' own read paths (readRaw(), readTemperature()/readHumidity()) have no failure signal of their own for a missing device"

requirements-completed: [D-08, D-09, D-10, D-11, D-12, D-13, D-14]

coverage:
  - id: D1
    description: "mag_sensor auto-detects HMC5883L/QMC5883L/VCM5883L via i2c_bus::present() + DFRobot_QMC5883, computes heading locally via atan2f on hard-iron-corrected axes with DEFAULT_MAG_DECLINATION applied (D-10, D-11)"
    requirement: "D-10, D-11"
    verification:
      - kind: other
        ref: "pio run -e esp32-c3-supermini and -e esp32-devkit (both exit 0); grep -c atan2f mag_sensor.cpp == 2; grep -c DEFAULT_MAG_DECLINATION mag_sensor.cpp == 1; grep -v '//' mag_sensor.cpp | grep -c 'delay(' == 0"
        status: pass
    human_judgment: false
  - id: D2
    description: "Hard-iron calibration (calStart/calFinish/calAbort) persists xMin/xMax/yMin/yMax + a \"set\" marker to NVS namespace \"magcal\", rejects a capture with insufficient X/Y amplitude, and auto-times-out an abandoned capture after DEFAULT_MAG_CAL_TIMEOUT_S (D-09)"
    requirement: "D-09"
    verification:
      - kind: other
        ref: "grep -c '\"magcal\"' mag_sensor.cpp == 2 (read + write); code review of calFinish()'s amplitude-floor rejection and calElapsedS()-driven auto-finish in poll()"
        status: pass
    human_judgment: false
  - id: D3
    description: "arbitratedHeading() reuses the existing DEFAULT_GPS_STATIONARY_KMH threshold (no second competing constant) to blend compass vs GPS-course by speed, and defers to GPS course whenever the compass is offline (D-08, D-12)"
    requirement: "D-08, D-12"
    verification:
      - kind: other
        ref: "grep -c DEFAULT_GPS_STATIONARY_KMH mag_sensor.cpp == 1; code review of arbitratedHeading()'s online/haveGpsFix/speed branches"
        status: pass
    human_judgment: false
  - id: D4
    description: "env_sensor alternates readTemperature()/readHumidity() one per poll() call (never both), treats a NAN result as a failed read without blanking the last known values, and reports success/failure through i2c_bus (D-14)"
    verification:
      - kind: other
        ref: "grep -c readTemperature env_sensor.cpp == 1; grep -c readHumidity env_sensor.cpp == 1; grep -c i2c_bus::restoreClock env_sensor.cpp == 2; grep -v '//' env_sensor.cpp | grep -c 'delay(' == 0"
        status: pass
    human_judgment: false
  - id: D5
    description: "main.cpp schedules mag/env polls on DEFAULT_MAG_POLL_MS/DEFAULT_HTU21_POLL_MS, wires calHandleChar() ahead of the Fase 1 single-char hotkey dispatch (unchanged), re-initialises the real chips in i2cRecoverTick()'s MAG/ENV cases, and extends [HEALTH] with hdg=/hdg_src=/mag_chip=/temp=/hum= while preserving every pre-existing field"
    verification:
      - kind: other
        ref: "pio run -e esp32-c3-supermini and -e esp32-devkit (both exit 0); grep -c \"if (c == 'r')\" main.cpp == 1 and grep -c simHandleCommand(c) main.cpp == 1 (Fase 1 dispatch chain untouched); grep -c mag_sensor::begin/env_sensor::begin main.cpp == 2 each (setup() + recovery case)"
        status: pass
    human_judgment: false
  - id: D6
    description: "On real bench hardware: the GY-271 module's actual chip (HMC5883L or QMC5883L) is correctly identified at boot, heading tracks rotation monotonically through a full turn, cal + Enter captures/saves/rejects-degenerate calibration and survives reboot, the 8 Fase 1 hotkeys remain single-character/no-Enter, hdg_src flips at the DEFAULT_GPS_STATIONARY_KMH threshold, temp=/hum= respond to real changes and degrade gracefully when unplugged, and the bad=/stale= [HEALTH] counters do not grow with all 4 peripherals active"
    requirement: "D-08, D-09, D-10, D-11, D-12, D-13, D-14"
    verification: []
    human_judgment: true
    rationale: "Requires physical bench hardware (GY-271 compass + HTU21D wired per gps_tracker_pinout.md) not available in this execution session. All eight <human-check> items in Task 3's <verify> block cover exactly this behavior, including the DFRobot_QMC5883 staleness gate (T-01.1-SC) that determines whether this library needs replacing before plan 04. Logic is implemented and code-reviewed (chip classification via isHMC/isQMC/isVCM, local atan2f heading calc, calibration amplitude-floor rejection, alternating HTU21D reads, buffer-bounded cal parser) but on-hardware confirmation is deferred to end-of-phase UAT per workflow.human_verify_mode=end-of-phase, consistent with plans 01 and 02's D5 deferrals."

duration: 30min
completed: 2026-08-03
status: complete
---

# Phase 01.1 Plan 03: Compass and Environment Peripherals Summary

**DFRobot_QMC5883 compass (auto-detecting HMC5883L/QMC5883L, hard-iron-calibrated heading persisted in NVS, speed-blended against GPS course) plus an alternating-read HTU21D temp/humidity wrapper and the new multi-character "cal" serial command, all wired into main.cpp alongside the Fase 1 pipeline without disturbing it.**

## Performance

- **Duration:** ~30 min
- **Started:** 2026-08-03T09:25:46Z
- **Completed:** 2026-08-03T09:48:43Z
- **Tasks:** 3
- **Files modified:** 5 (4 created, 1 modified)

## Accomplishments
- Built `mag_sensor.h`/`.cpp`: probes `i2c_bus::present()` in HMC/QMC/VCM order to pick the responding address, constructs `DFRobot_QMC5883` with that exact address (required because the library's own auto-detect scan and its subsequent register reads use different address sources internally), classifies the chip via `isHMC()`/`isQMC()`/`isVCM()`, and computes heading locally via `atan2f` on hard-iron-corrected X/Y axes plus `DEFAULT_MAG_DECLINATION` — never via the library's own `getHeadingDegrees()`, which neither applies calibration offsets nor returns a usable value
- Implemented hard-iron calibration (D-09): `calStart()`/`calFinish()`/`calAbort()` capture min/max X/Y over a full rotation, `calFinish()` rejects a capture whose amplitude is below an anti-degenerate floor (keeping the previous calibration), and a valid capture is persisted to `Preferences` namespace `"magcal"` (4 floats + a `"set"` marker), reloaded at boot
- Built `env_sensor.h`/`.cpp`: alternates `readTemperature()`/`readHumidity()` one per `poll()` call (halving the ~100ms combined blocking cost against the ~266ms GPS UART buffer budget), treats a `NAN` result as a failed read without blanking the last known values, reports through `i2c_bus`
- Wired both peripherals into `main.cpp`: scheduled polls on `DEFAULT_MAG_POLL_MS`/`DEFAULT_HTU21_POLL_MS`, a bounded 8-byte multi-character parser `calHandleChar()` consulted before the Fase 1 single-char hotkey dispatch (unchanged), real chip re-init in `i2cRecoverTick()`'s `MAG`/`ENV` cases, and an extended `[HEALTH]` line (`hdg=`/`hdg_src=`/`mag_chip=`/`temp=`/`hum=`) plus a `[CAL] active` progress line during capture

## Task Commits

1. **Task 1: mag_sensor — auto-deteccao HMC/QMC, calibracao hard-iron em NVS e arbitro de rumo** - `0df23cf` (feat)
2. **Task 2: env_sensor — HTU21D com leitura alternada e fallback de ultimo valor conhecido** - `afaaef0` (feat)
3. **Task 3: main.cpp — timers de mag/env, comando serial 'cal' e campos novos no [HEALTH]** - `0a6bad2` (feat)

**Plan metadata:** (pending — this commit)

_Note: Task 3's commit also carries a small addition to mag_sensor.h/.cpp (`calRange()`) needed for the [CAL] active line — see Deviations._

## Files Created/Modified
- `firmware/gps_tracker/src/mag_sensor.h` - `MagChip`/`MagCalibration` types + 14-function `mag_sensor` namespace API (13 from Task 1's contract + `calRange()` added in Task 3)
- `firmware/gps_tracker/src/mag_sensor.cpp` - DFRobot_QMC5883 wrapper, local heading calc, calibration capture/persistence, heading arbiter
- `firmware/gps_tracker/src/env_sensor.h` - `EnvReading` POD + 3-function `env_sensor` namespace API
- `firmware/gps_tracker/src/env_sensor.cpp` - Adafruit HTU21DF wrapper with alternating reads + last-known-value fallback
- `firmware/gps_tracker/src/main.cpp` - `mag_sensor::begin()`/`env_sensor::begin()`, scheduled polls, `calHandleChar()`, extended `[HEALTH]`/`[CAL]` lines

## Decisions Made
- `DFRobot_QMC5883` is constructed with the address `i2c_bus::present()` actually detected, not the library's own default (0x0C) — the library's `begin()` auto-detects `ICType` by probing its own hardcoded HMC/QMC/VCM addresses, but every subsequent register read uses the constructor-supplied address, so the two must match or reads silently target the wrong device
- Added `mag_sensor::calRange()` beyond Task 1's originally-declared 13-function contract, because Task 3's bench-visible `[CAL] active` progress line needs read access to the in-progress capture's live min/max without duplicating that accumulator state in `main.cpp`
- A lightweight `Wire.beginTransmission`/`endTransmission` probe precedes the actual library read in both `mag_sensor::poll()` and `env_sensor::poll()`, purely so a genuine disconnect routes through `i2c_bus::reportError()` (D-13) — neither library's read path (`readRaw()`, `readTemperature()`/`readHumidity()`) signals a missing device on its own

## Deviations from Plan

### Auto-fixed Issues

**1. [Rule 3 - Blocking] Added `mag_sensor::calRange()` accessor not in Task 1's declared API**
- **Found during:** Task 3 (wiring the `[CAL] active` progress line)
- **Issue:** Task 3's action text requires printing `x=[%.0f..%.0f] y=[%.0f..%.0f]` for the in-progress calibration capture, but Task 1's header contract (13 functions, explicitly enumerated in both the plan's phase-wide "Artifacts" list and Task 1's own `<action>`) has no accessor exposing the live min/max accumulators — only the finished `calibration()` result.
- **Fix:** Added a 14th function, `void calRange(float *xMin, float *xMax, float *yMin, float *yMax)`, to `mag_sensor.h`/`.cpp`, returning the same static accumulators `poll()` already updates during a capture. No existing function signature changed.
- **Files modified:** `firmware/gps_tracker/src/mag_sensor.h`, `firmware/gps_tracker/src/mag_sensor.cpp`
- **Verification:** Both envs compile (exit 0); Task 1's original acceptance-criteria greps (delay/DEFAULT_GPS_STATIONARY_KMH/DEFAULT_MAG_DECLINATION/atan2f/magcal/reportError|reinitDue counts) re-ran unchanged and still pass.
- **Committed in:** `0a6bad2` (Task 3 commit)

---

**Total deviations:** 1 auto-fixed (1 blocking)
**Impact on plan:** Minimal, additive API surface needed to fulfill Task 3's own literal instruction; no existing function signature or behavior changed, no scope creep beyond what Task 3 already required.

## Issues Encountered

None beyond the deviation documented above. Confirmed via direct source inspection of the installed `DFRobot_QMC5883.h`/`.cpp` and `Adafruit_HTU21DF.h`/`.cpp` (per each task's `read_first` instruction) before coding against them — notably that `DFRobot_QMC5883::getHeadingDegrees()` returns `void` (mutates an internal field) rather than a usable heading value, confirming the plan's instruction to compute heading locally via `atan2f` was necessary, not optional.

## User Setup Required

**Bench hardware still needs to be wired for on-hardware verification of Task 3's eight `<human-check>` items** (chip detection banner, heading rotation monotonicity, calibration capture/save/reject/reboot-survival, Fase 1 hotkey preservation, D-08 speed-blend via the simulator, D-14 temp/hum plausibility + graceful degradation, and the 5-minute `bad=`/`stale=` soak check with all 4 peripherals active). Per `workflow.human_verify_mode=end-of-phase`, this is deferred to the phase's end-of-phase UAT — see `01.1-CONTEXT.md`'s canonical wiring reference (`firmware/gps_tracker/gps_tracker_pinout.md`, section "Fase 01.1 — Barramento I2C"). This includes the T-01.1-SC gate: confirming the actual GY-271 module in hand is correctly detected before plan 04 depends on this library.

## Next Phase Readiness
- `mag_sensor` API (`begin`, `poll`, `chip`, `chipName`, `headingDeg`, `cardinal`, `calStart`, `calFinish`, `calAbort`, `calActive`, `calElapsedS`, `calibration`, `arbitratedHeading`, `calRange`) and `env_sensor` API (`begin`, `poll`, `last`) are stable and ready for plan 04 (display) to consume for the dense OLED screen (D-01..D-04)
- `i2cRecoverTick()`'s `switch` in `main.cpp` now has all four cases wired (`ACCEL` from plan 02, `MAG`/`ENV` from this plan) except `DISPLAY`, whose labeled slot is still ready for plan 04 to insert `display::begin(...)` before the existing generic `setOnline()`
- `[HEALTH]` now carries the complete Fase 01.1 field set (`disp=`/`accel=`/`mag=`/`env=`/`i2c_drops=`/`accel_g=`/`accel_wakes=`/`hdg=`/`hdg_src=`/`mag_chip=`/`temp=`/`hum=`) that plan 04's display module can read for its dense single-screen layout
- On-hardware bring-up (GY-271 chip identification, calibration procedure, heading rotation behavior) is the first thing to confirm once the bench is wired — this determines both whether `DFRobot_QMC5883` needs replacing (T-01.1-SC) and which compass code path plan 04's display exercises first

## Self-Check: PASSED

- `firmware/gps_tracker/src/mag_sensor.h` — FOUND
- `firmware/gps_tracker/src/mag_sensor.cpp` — FOUND
- `firmware/gps_tracker/src/env_sensor.h` — FOUND
- `firmware/gps_tracker/src/env_sensor.cpp` — FOUND
- `firmware/gps_tracker/src/main.cpp` — FOUND
- Commit `0df23cf` — FOUND in `git log --oneline`
- Commit `afaaef0` — FOUND in `git log --oneline`
- Commit `0a6bad2` — FOUND in `git log --oneline`
- `pio run -e esp32-c3-supermini` — SUCCESS (exit 0)
- `pio run -e esp32-devkit` — SUCCESS (exit 0)

---
*Phase: 01.1-perifericos-i2c-e-display*
*Completed: 2026-08-03*
