lucianoET/aguada-firmware/.planning/phases/01.1-perifericos-i2c-e-display/01.1-02-SUMMARY.md

---
phase: 01.1-perifericos-i2c-e-display
plan: 02
subsystem: firmware
tags: [esp32-c3, i2c, mpu6050, cadence, arduino, platformio, gps-tracker]

requires:
  - phase: 01.1
    provides: "i2c_bus shared health/retry policy (begin/tick/setOnline/online/reportOk/reportError/reinitDue/clearReinit/bind/boundAddr) and Fase 01.1 DEFAULT_* constants (gps_config.h), from plan 01"
provides:
  - "accel_sensor module: hand-rolled raw-I2C MPU6050 driver reading only acceleration registers (no gyro), producing a debounced one-shot wake edge"
  - "Cadence::onAccelWake(uint32_t) — a second, documented entry point into Cadence with deliberately asymmetric authority: can only promote STATIONARY -> MOVING, never demote"
  - "main.cpp wiring: scheduled accel poll (DEFAULT_ACCEL_POLL_MS), the sole call site of onAccelWake(), real chip re-init in i2cRecoverTick()'s ACCEL case, and accel_g=/accel_wakes= [HEALTH] fields"
affects: [01.1-03-compass-env, 01.1-04-display]

tech-stack:
  added: []
  patterns:
    - "onAccelWake() as Cadence's second entry point, documented in the class-contract comment alongside onGatedFix(), with an explicit promote-only vs. promote-or-demote authority split"
    - "accel_sensor holds no local I2C failure/retry policy — every read reports through i2c_bus::reportOk()/reportError(), and reinitDue()/clearReinit() drive re-init, identical to the i2c_bus contract established in plan 01"
    - "wake-edge debounce arms once per sustained streak (counter resets to 0 the same poll() call it arms), consumed one-shot by the caller in the same style as Cadence::stateChanged()"

key-files:
  created:
    - firmware/gps_tracker/src/accel_sensor.h
    - firmware/gps_tracker/src/accel_sensor.cpp
  modified:
    - firmware/gps_tracker/src/cadence.h
    - firmware/gps_tracker/src/cadence.cpp
    - firmware/gps_tracker/src/main.cpp

key-decisions:
  - "i2cRecoverTick()'s ACCEL case keeps the generic i2c_bus::setOnline(m, true) call after accel_sensor::begin(), matching the plan's literal instruction and the placeholder shape already used by the still-unimplemented DISPLAY/MAG/ENV cases — accel_sensor::begin() already reports its own real result via i2c_bus::setOnline() internally, so the generic call is a harmless no-op on the expected real-hardware success path"
  - "Wake-edge debounce streak resets to 0 in the same poll() call that arms the edge (per the plan's explicit 'zerar o contador' instruction), so main.cpp's `[ACCEL] wake ... streak=%u` log line reports the post-reset count (0), not the triggering DEFAULT_ACCEL_WAKE_DEBOUNCE_SAMPLES value — this is the literal behavior specified for 'one edge per streak, not one per poll', not a bug"

requirements-completed: [D-05, D-06, D-07, D-12, D-13]

coverage:
  - id: D1
    description: "accel_sensor reads acceleration magnitude via a single 6-byte I2C burst (no gyro registers touched, D-07), produces a debounced one-shot wake edge (D-06), and degrades silently (no wakeEdge(), no blocking) when the MPU6050 is absent"
    requirement: "D-06, D-07"
    verification:
      - kind: other
        ref: "pio run -e esp32-c3-supermini and -e esp32-devkit (both exit 0); grep -c 'requestFrom' == 2 (1-byte WHO_AM_I + 6-byte accel burst, not 14); grep -v '//' accel_sensor.cpp | grep -c 'delay(' == 0"
        status: pass
    human_judgment: false
  - id: D2
    description: "Cadence::onAccelWake() is a documented second entry point that can only promote STATIONARY -> MOVING; cadence.cpp retains exactly one code path that assigns CadenceState::STATIONARY, inside onGatedFix()'s unchanged hysteresis/debounce branch"
    requirement: "D-05"
    verification:
      - kind: other
        ref: "pio run (both envs, exit 0); grep -c 'CadenceState::STATIONARY;' cadence.cpp == 1; grep -c 'stationaryStreak_ >= DEFAULT_GPS_DEBOUNCE_FIXES' cadence.cpp == 1 (demotion path untouched); grep -c 'accelWakePending_' cadence.cpp == 4 (arm/test/consume)"
        status: pass
    human_judgment: false
  - id: D3
    description: "main.cpp schedules accel_sensor::poll() on DEFAULT_ACCEL_POLL_MS after the GPS/simTick pass, is the sole call site of cadence.onAccelWake(), re-initialises the real chip (not just a flag) in i2cRecoverTick()'s ACCEL case, and extends [HEALTH] with accel_g=/accel_wakes= without disturbing any pre-existing field"
    verification:
      - kind: other
        ref: "pio run -e esp32-c3-supermini and -e esp32-devkit (both exit 0); grep -c 'cadence.onAccelWake' == 1, 'cadence.onGatedFix' == 1 (both single call sites intact); grep -c 'accel_sensor::begin' == 2 (setup() + ACCEL case)"
        status: pass
    human_judgment: false
  - id: D4
    description: "On real bench hardware: resting produces no false wake, shaking produces an immediate [ACCEL] wake + [STATE] STATIONARY->MOVING without waiting for 3 GPS fixes, stopping still requires the GPS debounce fixes to return to STATIONARY, and unplugging/replugging the MPU6050 degrades only the fast-wake path (D-12/D-13) while GPS tracking and the loop keep running"
    requirement: "D-05, D-06, D-07, D-12, D-13"
    verification: []
    human_judgment: true
    rationale: "Requires physical bench hardware (MPU6050 wired per gps_tracker_pinout.md) not available in this execution session. The four <human-check> items in Task 3's <verify> block cover exactly this behavior. Logic is implemented and structurally verified (single demotion path, single onAccelWake() call site, zero blocking calls, i2c_bus-delegated failure policy) but the on-hardware confirmation is deferred to end-of-phase UAT per workflow.human_verify_mode=end-of-phase, consistent with plan 01's D5 deferral."

duration: 25min
completed: 2026-08-03
status: complete
---

# Phase 01.1 Plan 02: Accel-Driven Cadence Wake Summary

**MPU6050 accelerometer feeds `Cadence` a second, promote-only entry point (`onAccelWake()`) so shaking a stationary tracker flips it to MOVING in ~300ms instead of waiting ~3 GPS fixes, while GPS speed remains the sole authority for declaring "stopped".**

## Performance

- **Duration:** ~25 min
- **Completed:** 2026-08-03T06:23:31-03:00
- **Tasks:** 3
- **Files modified:** 5 (2 created, 3 modified)

## Accomplishments
- Built `accel_sensor.h`/`.cpp`: hand-rolled raw-I2C MPU6050 driver — WHO_AM_I probe + sleep-exit write in `begin()`, a single 6-byte acceleration burst in `poll()`, and a debounced one-shot `wakeEdge()` that arms only after `DEFAULT_ACCEL_WAKE_DEBOUNCE_SAMPLES` consecutive samples deviate `>= DEFAULT_ACCEL_WAKE_THRESHOLD_G` from 1.0g; no gyro register is ever touched (D-07); all I2C failure/retry policy delegates to `i2c_bus` (D-13)
- Extended `Cadence` with `onAccelWake(uint32_t)`: a second, class-contract-documented entry point that mirrors `onGatedFix()`'s STATIONARY->MOVING bookkeeping but returns false with no effect when already MOVING — the demotion path (GPS-speed hysteresis/debounce) is completely unchanged and remains the only way to declare "stopped" (D-05)
- Wired accel polling into `main.cpp`'s superloop on `DEFAULT_ACCEL_POLL_MS`, positioned after the GPS/simTick pass; on a confirmed wake it is the sole call site of `cadence.onAccelWake()`, logs `[ACCEL] wake mag=..g streak=..` immediately before the existing `[STATE]` transition line, re-initialises the real chip (not just a flag) in `i2cRecoverTick()`'s ACCEL case, and extends `[HEALTH]` with `accel_g=`/`accel_wakes=` while preserving every field from plan 01

## Task Commits

1. **Task 1: accel_sensor — leitura crua MPU6050 e edge de despertar por magnitude** - `f1fcce3` (feat)
2. **Task 2: Cadence::onAccelWake — segundo ponto de entrada com autoridade assimetrica** - `a5c990f` (feat)
3. **Task 3: main.cpp — agendar o poll do accel e ligar o edge de despertar na cadencia** - `12ac6a4` (feat)

**Plan metadata:** (pending — this commit)

## Files Created/Modified
- `firmware/gps_tracker/src/accel_sensor.h` - `AccelReading` POD + 6-function `accel_sensor` namespace API contract
- `firmware/gps_tracker/src/accel_sensor.cpp` - raw I2C MPU6050 read + debounced wake-edge implementation
- `firmware/gps_tracker/src/cadence.h` - `onAccelWake()` declaration, `accelWakePending_` member, rewritten two-entry-point class contract comment
- `firmware/gps_tracker/src/cadence.cpp` - `onAccelWake()` implementation, `accelWakePending_` wired into the MOVING pacing decision
- `firmware/gps_tracker/src/main.cpp` - `accel_sensor::begin()` in `setup()` + `i2cRecoverTick()`, scheduled `poll()`, sole `onAccelWake()` call site, extended `[HEALTH]` line

## Decisions Made
- `i2cRecoverTick()`'s ACCEL case keeps the pre-existing generic `i2c_bus::setOnline(m, true)` call after inserting `accel_sensor::begin()`, per the plan's literal instruction — harmless given `accel_sensor::begin()` already reports its true result via `i2c_bus::setOnline()` internally on the real-hardware success path
- Wake-edge debounce counter resets to 0 in the same `poll()` call that arms the edge (explicit plan instruction: "one edge per streak, not one per poll"), so the `[ACCEL] wake` log's `streak=` field reports the post-reset value rather than the triggering sample count

## Deviations from Plan

None - plan executed exactly as written.

## Issues Encountered
None.

## User Setup Required

None beyond what plan 01 already flagged — bench hardware (MPU6050 wired per `gps_tracker_pinout.md`) is still required for the four `<human-check>` items in this plan's Task 3, deferred to end-of-phase UAT per `workflow.human_verify_mode=end-of-phase`.

## Next Phase Readiness
- `accel_sensor` API (`begin`, `poll`, `last`, `wakeEdge`, `magnitudeG`, `debounceStreak`) is stable; `Cadence::onAccelWake()` is stable and ready for the remaining plans in this phase (03: compass/env, 04: display) — neither consumes `accel_sensor` directly, but both build on the same `i2c_bus`/scheduling patterns this plan reinforced
- On-hardware bring-up (resting-vs-shaking wake behavior, GPS-only demotion confirmation, MPU6050 unplug/replug recovery) is queued for the phase's end-of-phase UAT alongside plan 01's deferred D5 items

## Self-Check: PASSED

- `firmware/gps_tracker/src/accel_sensor.h` — FOUND
- `firmware/gps_tracker/src/accel_sensor.cpp` — FOUND
- `firmware/gps_tracker/src/cadence.h` — FOUND
- `firmware/gps_tracker/src/cadence.cpp` — FOUND
- `firmware/gps_tracker/src/main.cpp` — FOUND
- Commit `f1fcce3` — FOUND in `git log --oneline`
- Commit `a5c990f` — FOUND in `git log --oneline`
- Commit `12ac6a4` — FOUND in `git log --oneline`
- `pio run -e esp32-c3-supermini` — SUCCESS (exit 0)
- `pio run -e esp32-devkit` — SUCCESS (exit 0)

---
*Phase: 01.1-perifericos-i2c-e-display*
*Completed: 2026-08-03*
