lucianoET/aguada-firmware/.planning/phases/01.1-perifericos-i2c-e-display/01.1-01-SUMMARY.md

---
phase: 01.1-perifericos-i2c-e-display
plan: 01
subsystem: firmware
tags: [esp32-c3, i2c, arduino, platformio, gps-tracker]

requires:
  - phase: 01
    provides: "gps_reader -> fix_gate -> cadence pipeline in firmware/gps_tracker, DEFAULT_* constant convention in gps_config.h"
provides:
  - "Shared I2C bus foundation (i2c_bus.h/.cpp) for all 4 Fase 01.1 peripherals: boot scan, per-module online/offline flags, consecutive-error counting, round-robin retry recovery"
  - "All DEFAULT_* constants Fase 01.1 needs (I2C bus, addresses, accel/mag/env/display timing) in gps_config.h"
  - "platformio.ini with U8g2, DFRobot_QMC5883, Adafruit HTU21DF Library resolved on both envs"
  - "main.cpp boot scan + recovery scheduler + [HEALTH] disp=/accel=/mag=/env=/i2c_drops= fields"
affects: [01.1-02-accel-cadence, 01.1-03-compass-env, 01.1-04-display]

tech-stack:
  added: [olikraus/U8g2 ^2.36.18, dfrobot/DFRobot_QMC5883 ^1.0.0, adafruit/Adafruit HTU21DF Library ^1.1.2, adafruit/Adafruit BusIO ^1.17.4 (transitive)]
  patterns:
    - "i2c_bus namespace as the single I2C health/retry policy — drivers report ok/error, never implement their own offline logic"
    - "millis()-delta scheduling only — zero blocking calls anywhere in i2c_bus.cpp (grep-enforced)"
    - "round-robin single-probe retry: tick() touches the bus for at most one module per loop() iteration"

key-files:
  created:
    - firmware/gps_tracker/src/i2c_bus.h
    - firmware/gps_tracker/src/i2c_bus.cpp
  modified:
    - firmware/gps_tracker/include/gps_config.h
    - firmware/gps_tracker/platformio.ini
    - firmware/gps_tracker/src/main.cpp

key-decisions:
  - "Reused DEFAULT_GPS_STATIONARY_KMH for the future heading arbiter (D-08) instead of adding a second threshold constant, per RESEARCH.md Pattern 3"
  - "esp32-devkit env overrides DEFAULT_I2C_SDA_PIN/SCL_PIN to 21/22 via build_flags (classic ESP32 reserves GPIO6-11 for flash) rather than editing the header"
  - "i2c_bus's retry scheduler probes at most one address per tick() call (round-robin across the 4 modules), including for modules with multiple candidate addresses (OLED, compass) — one candidate address advances per retry attempt rather than trying all candidates in a single call"

requirements-completed: [D-04, D-10, D-12, D-13]

coverage:
  - id: D1
    description: "gps_config.h carries all 21 DEFAULT_* constants Fase 01.1 needs, each #ifndef-guarded"
    requirement: "D-04, D-10"
    verification:
      - kind: other
        ref: "grep -c across 18 constant names in gps_config.h == 40 occurrences (define+use); DEFAULT_MAG_HEADING_SPEED/DEFAULT_HEADING_SPEED count == 0 (no competing threshold added)"
        status: pass
    human_judgment: false
  - id: D2
    description: "platformio.ini resolves U8g2/DFRobot_QMC5883/Adafruit HTU21DF on both envs, preserving TinyGPSPlus, with pio pkg install succeeding"
    verification:
      - kind: other
        ref: "pio pkg install -e esp32-c3-supermini (exit 0, 3 new libs + Adafruit BusIO/Unified Sensor transitive deps installed)"
        status: pass
    human_judgment: false
  - id: D3
    description: "i2c_bus module compiles and exposes 16-function API contract with zero blocking calls"
    requirement: "D-12, D-13"
    verification:
      - kind: other
        ref: "pio run -e esp32-c3-supermini (exit 0); grep -v '//' i2c_bus.cpp | grep -c 'delay(' == 0"
        status: pass
    human_judgment: false
  - id: D4
    description: "main.cpp wires i2c_bus::begin() after gpsReader.begin(), i2cRecoverTick() once per loop(), and extends [HEALTH] with disp=/accel=/mag=/env=/i2c_drops= without disturbing existing fields"
    verification:
      - kind: other
        ref: "pio run -e esp32-c3-supermini and -e esp32-devkit (both exit 0); grep counts for i2c_bus::begin()==1, i2cRecoverTick==2, HEALTH literals==1 each, pre-existing HEALTH fields intact"
        status: pass
    human_judgment: false
  - id: D5
    description: "D-12 (graceful degradation with any subset of 0-4 modules) and D-13 (offline-after-N-errors, ~10s auto-recovery) are observable on real bench hardware"
    requirement: "D-12, D-13"
    verification: []
    human_judgment: true
    rationale: "Requires physical bench hardware (4 I2C modules wired per gps_tracker_pinout.md) that is not available in this execution session. Logic is implemented and code-reviewed (round-robin retry, error-threshold offline marking, boot scan seeding online flags) but the three <human-check> items in Task 3's <verify> block (boot scan address list, unplug/replug recovery timing, zero-module boot) require on-hardware confirmation. Per workflow.human_verify_mode=end-of-phase, this is deferred to the end-of-phase UAT rather than a mid-flight checkpoint."

duration: 40min
completed: 2026-08-03
status: complete
---

# Phase 01.1 Plan 01: I2C Bus Foundation Summary

**Shared `i2c_bus` module (boot scan + per-module health/retry policy) plus all Fase 01.1 `DEFAULT_*` constants and the 3 new PlatformIO library dependencies, wired into `main.cpp` without touching the existing GPS pipeline.**

## Performance

- **Duration:** ~40 min
- **Completed:** 2026-08-03T09:05:50Z
- **Tasks:** 3
- **Files modified:** 5 (2 created, 3 modified)

## Accomplishments
- Added 21 new `DEFAULT_*` constants to `gps_config.h` covering the I2C bus, all 4 module addresses, and accel/mag/env/display timing — the complete configuration surface for the rest of Fase 01.1
- Added `olikraus/U8g2`, `dfrobot/DFRobot_QMC5883`, `adafruit/Adafruit HTU21DF Library` to both `platformio.ini` envs; verified resolution via `pio pkg install` (pulls in `Adafruit BusIO`/`Adafruit Unified Sensor` transitively)
- Built `i2c_bus.h`/`.cpp`: boot-time full-bus scan seeding per-module online flags, consecutive-error counting with `DEFAULT_I2C_ERROR_THRESHOLD`, and a non-blocking round-robin retry scheduler on `DEFAULT_I2C_RETRY_INTERVAL_MS` — zero blocking calls anywhere in the file
- Wired `i2c_bus::begin()` into `setup()` (after `gpsReader.begin()`) and `i2cRecoverTick()` into `loop()` (after the GPS pass, before `[HEALTH]`), extending the `[HEALTH]` line with `disp=/accel=/mag=/env=/i2c_drops=` fields while preserving every existing field

## Task Commits

1. **Task 1: Constantes DEFAULT_* da fase e dependencias PlatformIO** - `494f928` (feat)
2. **Task 2: Modulo i2c_bus — scan de boot, saude por modulo e re-init agendado** - `9f2b4a5` (feat)
3. **Task 3: Ligar i2c_bus no main.cpp — boot scan, tick de recuperacao e campos I2C no [HEALTH]** - `b77edcd` (feat)

**Plan metadata:** (pending — this commit)

## Files Created/Modified
- `firmware/gps_tracker/src/i2c_bus.h` - I2cModule enum + 16-function bus-manager API contract
- `firmware/gps_tracker/src/i2c_bus.cpp` - boot scan, health/retry state machine implementation
- `firmware/gps_tracker/include/gps_config.h` - all Fase 01.1 `DEFAULT_*` constants
- `firmware/gps_tracker/platformio.ini` - 3 new lib_deps on both envs, I2C pin override on esp32-devkit
- `firmware/gps_tracker/src/main.cpp` - `i2c_bus::begin()`, `i2cRecoverTick()`, extended `[HEALTH]` line

## Decisions Made
- Reused the existing `DEFAULT_GPS_STATIONARY_KMH` constant (rather than a new one) as the future heading-arbiter threshold, per RESEARCH.md Pattern 3 and D-08
- `esp32-devkit` env overrides I2C pins to 21/22 via `build_flags`, keeping `gps_config.h`'s default (6/7) as the ESP32-C3 SuperMini value
- Retry scheduler probes exactly one I2C address per `tick()` call regardless of how many modules are offline or how many candidate addresses a module has (OLED: 2 candidates, compass: 3) — this keeps the "at most one transaction per loop() iteration" guarantee unconditional

## Deviations from Plan

### Auto-fixed Issues

**1. [Rule 3 - Blocking] `Arduino.h` legacy `DISPLAY` macro collided with `I2cModule::DISPLAY`**
- **Found during:** Task 2 (first `pio run` compile attempt)
- **Issue:** `Arduino.h` defines a legacy `#define DISPLAY 0x1` (an old `Print`-class output-mode constant from early Arduino cores). Since `i2c_bus.cpp` and (later) `main.cpp` both include `Arduino.h`, every use of `I2cModule::DISPLAY` failed to compile with "expected unqualified-id before numeric constant".
- **Fix:** Added `#include <Arduino.h>` followed by `#undef DISPLAY` in `i2c_bus.h`, immediately before the `enum class I2cModule` declaration — Arduino.h's own include guard prevents the macro from being redefined later in the same translation unit, so this is a one-time, header-level fix rather than something every consumer needs to repeat.
- **Files modified:** `firmware/gps_tracker/src/i2c_bus.h`
- **Verification:** `pio run -e esp32-c3-supermini` and `-e esp32-devkit` both succeed (exit 0) with no macro-collision errors.
- **Committed in:** `9f2b4a5` (Task 2 commit)

---

**Total deviations:** 1 auto-fixed (1 blocking)
**Impact on plan:** Necessary fix for a pre-existing name collision in the Arduino core header, unrelated to and undetectable before writing the actual enum; no scope creep — the enum member names (`DISPLAY`, `ACCEL`, `MAG`, `ENV`, `COUNT`) required by the plan's contract are unchanged.

## Issues Encountered
None beyond the deviation documented above.

## User Setup Required

**Bench hardware still needs to be wired for on-hardware verification of Task 3's three `<human-check>` items** (boot scan address list, unplug/replug recovery, zero-module boot). Per `workflow.human_verify_mode=end-of-phase`, this is deferred to the phase's end-of-phase UAT rather than a mid-flight checkpoint — see `01.1-CONTEXT.md`'s `user_setup` entry (montar os 4 modulos conforme `firmware/gps_tracker/gps_tracker_pinout.md`, secao "Fase 01.1 — Barramento I2C").

## Next Phase Readiness
- `i2c_bus` API (`begin`, `tick`, `present`, `foundCount`, `restoreClock`, `bind`, `boundAddr`, `setOnline`, `online`, `reportOk`, `reportError`, `errorCount`, `offlineEvents`, `reinitDue`, `clearReinit`, `moduleName`) is stable and ready for plans 02 (accel), 03 (mag/env), and 04 (display) to consume
- `i2cRecoverTick()`'s `switch` in `main.cpp` has a labeled, commented slot per module (`ACCEL`/`MAG`/`ENV`/`DISPLAY`) for each following plan to insert its driver's `begin()` call before `setOnline()` — no rewrite of this block needed
- All `DEFAULT_*` constants the remaining 3 plans need already exist in `gps_config.h`
- On-hardware bring-up (boot scan address confirmation, particularly whether the compass responds at 0x1E vs 0x0D) is the first thing to confirm once the bench is wired — this determines which compass code path plan 03 exercises first

## Self-Check: PASSED

- `firmware/gps_tracker/platformio.ini` — FOUND
- `firmware/gps_tracker/include/gps_config.h` — FOUND
- `firmware/gps_tracker/src/i2c_bus.h` — FOUND
- `firmware/gps_tracker/src/i2c_bus.cpp` — FOUND
- `firmware/gps_tracker/src/main.cpp` — FOUND
- Commit `494f928` — FOUND in `git log --oneline`
- Commit `9f2b4a5` — FOUND in `git log --oneline`
- Commit `b77edcd` — FOUND in `git log --oneline`
- `pio run -e esp32-c3-supermini` — SUCCESS (exit 0)
- `pio run -e esp32-devkit` — SUCCESS (exit 0)

---
*Phase: 01.1-perifericos-i2c-e-display*
*Completed: 2026-08-03*
