lucianoET/aguada-firmware/.planning/phases/01.1-perifericos-i2c-e-display/01.1-01-PLAN.md

---
phase: 01.1-perifericos-i2c-e-display
plan: 01
type: execute
wave: 1
depends_on: []
files_modified:
  - firmware/gps_tracker/platformio.ini
  - firmware/gps_tracker/include/gps_config.h
  - firmware/gps_tracker/src/i2c_bus.h
  - firmware/gps_tracker/src/i2c_bus.cpp
  - firmware/gps_tracker/src/main.cpp
autonomous: true
requirements: [D-04, D-10, D-12, D-13]
user_setup:
  - service: bench-hardware
    why: "4 modulos I2C (OLED SSD1306, MPU6050, HMC5883L/QMC5883L, HTU21D) precisam estar fisicamente ligados no barramento GPIO6/GPIO7 do ESP32-C3 SuperMini para a verificacao on-hardware do boot scan (D-12)"
    dashboard_config:
      - task: "Montar os 4 modulos em paralelo (3V3, GND, SDA=GPIO6, SCL=GPIO7) conforme a secao 'Fase 01.1 — Barramento I2C (MONTAR AGORA)'"
        location: "firmware/gps_tracker/gps_tracker_pinout.md"

must_haves:
  truths:
    - "Ao dar boot, o log serial lista todos os enderecos I2C encontrados no barramento GPIO6/GPIO7 (D-12)"
    - "Com qualquer subconjunto dos 4 modulos ligado (inclusive nenhum), o firmware continua rodando e o pipeline gps_reader -> fix_gate -> cadence segue produzindo [EMIT]/[REJECT]/[HEALTH] normalmente (D-12)"
    - "A linha [HEALTH] mostra o estado on/off de cada um dos 4 modulos (D-12)"
    - "Um modulo que some do barramento em runtime e marcado offline apos DEFAULT_I2C_ERROR_THRESHOLD erros consecutivos e volta sozinho quando religado, sem reboot (D-13)"
    - "Nenhuma operacao do barramento I2C bloqueia o loop por tempo suficiente para estourar a janela do buffer UART do GPS"
  artifacts:
    - "firmware/gps_tracker/src/i2c_bus.h"
    - "firmware/gps_tracker/src/i2c_bus.cpp"
    - "firmware/gps_tracker/include/gps_config.h contendo todas as constantes DEFAULT_I2C_*, DEFAULT_OLED_*, DEFAULT_ACCEL_*, DEFAULT_MAG_*, DEFAULT_HTU21_*, DEFAULT_DISPLAY_*, DEFAULT_SPEED_UNIT"
    - "firmware/gps_tracker/platformio.ini com lib_deps U8g2 / DFRobot_QMC5883 / Adafruit HTU21DF nos dois envs"
  key_links:
    - "main.cpp setup() chama i2c_bus::begin() DEPOIS de gpsReader.begin(), de modo que o UART do GPS ja esta drenando antes de qualquer transacao I2C"
    - "main.cpp loop() chama i2c_bus::tick() a cada iteracao; o tick so faz trabalho de barramento quando o timer de retry de um modulo offline venceu (D-13)"
    - "i2c_bus::restoreClock() reafirma DEFAULT_I2C_CLOCK_HZ apos qualquer .begin() de biblioteca (Pitfall 2 do RESEARCH.md); os planos 02/03/04 chamam esta funcao"
---

<objective>
Estabelecer a fundacao I2C compartilhada do `firmware/gps_tracker/`: dependencias PlatformIO, todas as constantes `DEFAULT_*` que a Fase 01.1 inteira vai consumir, e o modulo `i2c_bus` que faz o scan de boot, mantem o estado online/offline por modulo, conta erros consecutivos e agenda re-init — sem que nada disso possa bloquear o pipeline GPS existente.

Purpose: D-12 (degradacao graciosa total) e D-13 (recuperacao em runtime) sao transversais aos 4 modulos. Se cada driver implementar sua propria politica de falha, a Fase 01.1 termina com 4 politicas divergentes. Este plano cria a politica uma vez, e os planos 02/03/04 se plugam nela.
Output: `i2c_bus.h`/`i2c_bus.cpp`, `gps_config.h` expandido, `platformio.ini` com as 3 libs novas, `main.cpp` com boot scan + tick de recuperacao + campos I2C na linha `[HEALTH]`.
</objective>

<execution_context>
@$HOME/.claude/gsd-core/workflows/execute-plan.md
@$HOME/.claude/gsd-core/templates/summary.md
</execution_context>

<context>
@.planning/PROJECT.md
@.planning/ROADMAP.md
@.planning/STATE.md
@.planning/phases/01.1-perifericos-i2c-e-display/01.1-CONTEXT.md
@.planning/phases/01.1-perifericos-i2c-e-display/01.1-RESEARCH.md
@.planning/phases/01.1-perifericos-i2c-e-display/01.1-PATTERNS.md
@firmware/gps_tracker/gps_tracker_pinout.md
@firmware/gps_tracker/include/gps_config.h
@firmware/gps_tracker/platformio.ini
@firmware/gps_tracker/src/main.cpp
@firmware/node/src/ani_sensor.cpp
</context>

## Artifacts this phase produces

Simbolos criados pela Fase 01.1 inteira (todos os planos). Nenhum destes existe no codebase antes desta fase — nao os trate como drift.

**Arquivos novos:** `firmware/gps_tracker/src/i2c_bus.h`, `i2c_bus.cpp`, `accel_sensor.h`, `accel_sensor.cpp`, `mag_sensor.h`, `mag_sensor.cpp`, `env_sensor.h`, `env_sensor.cpp`, `display.h`, `display.cpp`.

**Tipos novos:** `I2cModule` (enum class: DISPLAY, ACCEL, MAG, ENV, COUNT), `AccelReading` (struct), `MagChip` (enum class: NONE, HMC5883L, QMC5883L, VCM5883L), `MagCalibration` (struct), `EnvReading` (struct), `DisplayState` (struct).

**Funcoes novas — namespace `i2c_bus`:** `begin`, `tick`, `present`, `foundCount`, `restoreClock`, `bind`, `boundAddr`, `setOnline`, `online`, `reportOk`, `reportError`, `errorCount`, `offlineEvents`, `reinitDue`, `clearReinit`, `moduleName`.

**Funcoes novas — namespace `accel_sensor`:** `begin`, `poll`, `last`, `wakeEdge`, `magnitudeG`, `debounceStreak`.

**Funcoes novas — namespace `mag_sensor`:** `begin`, `poll`, `chip`, `chipName`, `headingDeg`, `cardinal`, `calStart`, `calFinish`, `calAbort`, `calActive`, `calElapsedS`, `calibration`, `arbitratedHeading`.

**Funcoes novas — namespace `env_sensor`:** `begin`, `poll`, `last`.

**Funcoes novas — namespace `display`:** `begin`, `render`, `addr`.

**Metodo novo em classe existente:** `Cadence::onAccelWake(uint32_t mono_ms)`.

**Funcoes novas em `main.cpp`:** `i2cRecoverTick`, `calHandleChar`, `buildDisplayState`, `speedInDisplayUnit`, `speedUnitLabel`.

**Constantes `DEFAULT_*` novas em `gps_config.h`:** `DEFAULT_I2C_SDA_PIN`, `DEFAULT_I2C_SCL_PIN`, `DEFAULT_I2C_CLOCK_HZ`, `DEFAULT_I2C_ERROR_THRESHOLD`, `DEFAULT_I2C_RETRY_INTERVAL_MS`, `DEFAULT_OLED_ADDR`, `DEFAULT_OLED_ADDR_ALT`, `DEFAULT_ACCEL_ADDR`, `DEFAULT_MAG_ADDR_HMC`, `DEFAULT_MAG_ADDR_QMC`, `DEFAULT_MAG_ADDR_VCM`, `DEFAULT_ENV_ADDR`, `DEFAULT_ACCEL_POLL_MS`, `DEFAULT_ACCEL_WAKE_THRESHOLD_G`, `DEFAULT_ACCEL_WAKE_DEBOUNCE_SAMPLES`, `DEFAULT_MAG_POLL_MS`, `DEFAULT_MAG_DECLINATION`, `DEFAULT_MAG_CAL_TIMEOUT_S`, `DEFAULT_HTU21_POLL_MS`, `DEFAULT_DISPLAY_REFRESH_MS`, `DEFAULT_SPEED_UNIT`.

**Dependencias PlatformIO novas:** `olikraus/U8g2`, `dfrobot/DFRobot_QMC5883`, `adafruit/Adafruit HTU21DF Library` (+ transitiva `adafruit/Adafruit BusIO`).

**Comando serial novo:** `cal` (multi-caractere, terminado por Enter).

<tasks>

<task type="auto">
  <name>Task 1: Constantes DEFAULT_* da fase e dependencias PlatformIO</name>
  <files>firmware/gps_tracker/include/gps_config.h, firmware/gps_tracker/platformio.ini</files>
  <read_first>
    - `firmware/gps_tracker/include/gps_config.h` — a convencao `#ifndef`/`#define`/`#endif` com comentario inline por constante que voce deve replicar; note tambem o rodape de comentario que marca valores de research como "starting points, not final values"
    - `firmware/gps_tracker/platformio.ini` — os dois envs (`esp32-devkit`, `esp32-c3-supermini`), seus `build_flags` e o `lib_deps` atual (so TinyGPSPlus)
    - `firmware/gps_tracker/gps_tracker_pinout.md` — secao "Fase 01.1 — Barramento I2C (MONTAR AGORA)" (pinos GPIO6/GPIO7 e enderecos) e a tabela "Reservados — integração futura" da placa ESP32 DevKit classica (OLED I2C em GPIO21/GPIO22)
    - `.planning/phases/01.1-perifericos-i2c-e-display/01.1-RESEARCH.md` — secao "Standard Stack" (versoes exatas das libs) e "Assumptions Log" A1/A2/A4 (origem dos valores numericos)
  </read_first>
  <action>
Adicionar ao final de `firmware/gps_tracker/include/gps_config.h` um bloco novo delimitado por um comentario de secao `// --- perifericos I2C (Fase 01.1) ---`, com TODAS as constantes abaixo, cada uma guardada por `#ifndef`/`#endif` exatamente como as constantes existentes do arquivo. Estas sao as unicas constantes que a Fase 01.1 inteira introduz — os planos 02, 03 e 04 consomem daqui e nao adicionam mais nenhuma.

Barramento: `DEFAULT_I2C_SDA_PIN` = 6, `DEFAULT_I2C_SCL_PIN` = 7 (convencao do repo, mesma do node AirQ), `DEFAULT_I2C_CLOCK_HZ` = 400000 (research A3; comentar que 100000 e o fallback documentado se o barramento com os 4 modulos se mostrar instavel na bancada), `DEFAULT_I2C_ERROR_THRESHOLD` = 3 (erros consecutivos antes de marcar offline, research A4), `DEFAULT_I2C_RETRY_INTERVAL_MS` = 10000 (D-13 pede ~10 s).

Enderecos: `DEFAULT_OLED_ADDR` = 0x3C, `DEFAULT_OLED_ADDR_ALT` = 0x3D, `DEFAULT_ACCEL_ADDR` = 0x68, `DEFAULT_MAG_ADDR_HMC` = 0x1E, `DEFAULT_MAG_ADDR_QMC` = 0x0D, `DEFAULT_MAG_ADDR_VCM` = 0x0C, `DEFAULT_ENV_ADDR` = 0x40. Comentar em `DEFAULT_MAG_ADDR_QMC` que muitos GY-271 trazem QMC5883L em vez de HMC5883L (D-11).

Accel (D-06/D-07): `DEFAULT_ACCEL_POLL_MS` = 100, `DEFAULT_ACCEL_WAKE_THRESHOLD_G` = 0.20f (desvio absoluto em relacao ao baseline de 1 g), `DEFAULT_ACCEL_WAKE_DEBOUNCE_SAMPLES` = 3. Marcar os tres com o mesmo aviso de "research starting points (A1/A2), pendente de soak test em veiculo" que as constantes de cadence ja usam.

Bussola (D-09/D-10): `DEFAULT_MAG_POLL_MS` = 250, `DEFAULT_MAG_DECLINATION` = 0.0f (graus, D-10), `DEFAULT_MAG_CAL_TIMEOUT_S` = 120 (auto-encerramento da captura de calibracao).

Ambiente (D-14): `DEFAULT_HTU21_POLL_MS` = 4000. Comentar que a leitura da lib Adafruit bloqueia ~100 ms somados (Pitfall 6) e que este intervalo e o que mantem o custo longe da janela de ~266 ms do buffer UART do GPS.

Display (D-02/D-04): `DEFAULT_DISPLAY_REFRESH_MS` = 1000 (1 Hz, D-02), `DEFAULT_SPEED_UNIT` = 0 (0 = km/h, 1 = nos/kt, D-04).

NAO criar nenhuma constante nova de limiar de velocidade para o arbitro de rumo — o `DEFAULT_GPS_STATIONARY_KMH` = 3.0f que ja existe no arquivo e a fonte unica de verdade para D-08 (Pattern 3 do RESEARCH.md). Adicionar um comentario ao lado de `DEFAULT_GPS_STATIONARY_KMH` registrando esse segundo consumidor.

Em `firmware/gps_tracker/platformio.ini`, adicionar nos DOIS envs (`esp32-devkit` e `esp32-c3-supermini`), ao `lib_deps` existente e preservando a linha `mikalhart/TinyGPSPlus @ ^1.0.3`: `olikraus/U8g2 @ ^2.36.18`, `dfrobot/DFRobot_QMC5883 @ ^1.0.0`, `adafruit/Adafruit HTU21DF Library @ ^1.1.2`. Nao adicionar `adafruit/Adafruit BusIO` explicitamente — o PlatformIO resolve como dependencia transitiva do HTU21DF.

No env `esp32-devkit` (ESP32 classico, WROOM-32) acrescentar aos `build_flags` os overrides `-DDEFAULT_I2C_SDA_PIN=21` e `-DDEFAULT_I2C_SCL_PIN=22`, porque na placa classica GPIO6-11 sao a flash interna e o pinout doc reserva GPIO21/GPIO22 para I2C. O env `esp32-c3-supermini` fica com o default 6/7 do header, sem override.
  </action>
  <verify>
    <automated>grep -c 'DEFAULT_I2C_SDA_PIN\|DEFAULT_I2C_SCL_PIN\|DEFAULT_I2C_CLOCK_HZ\|DEFAULT_I2C_ERROR_THRESHOLD\|DEFAULT_I2C_RETRY_INTERVAL_MS\|DEFAULT_OLED_ADDR\|DEFAULT_ACCEL_ADDR\|DEFAULT_MAG_ADDR_HMC\|DEFAULT_MAG_ADDR_QMC\|DEFAULT_ENV_ADDR\|DEFAULT_ACCEL_POLL_MS\|DEFAULT_ACCEL_WAKE_THRESHOLD_G\|DEFAULT_ACCEL_WAKE_DEBOUNCE_SAMPLES\|DEFAULT_MAG_POLL_MS\|DEFAULT_MAG_DECLINATION\|DEFAULT_MAG_CAL_TIMEOUT_S\|DEFAULT_HTU21_POLL_MS\|DEFAULT_DISPLAY_REFRESH_MS\|DEFAULT_SPEED_UNIT' firmware/gps_tracker/include/gps_config.h</automated>
    <automated>/home/luc/Dev/aguada-firmware-main/.venv/bin/pio pkg install -d /home/luc/Dev/aguada-firmware-main/aguada-firmware/firmware/gps_tracker -e esp32-c3-supermini</automated>
  </verify>
  <acceptance_criteria>
    - As 21 constantes listadas na acao existem em `firmware/gps_tracker/include/gps_config.h`, cada uma dentro de um par `#ifndef`/`#endif`
    - `grep -c 'DEFAULT_MAG_HEADING_SPEED\|DEFAULT_HEADING_SPEED' firmware/gps_tracker/include/gps_config.h` retorna 0 (nenhuma constante concorrente de limiar de rumo foi criada; D-08 reusa `DEFAULT_GPS_STATIONARY_KMH`)
    - `grep -c 'olikraus/U8g2' firmware/gps_tracker/platformio.ini` retorna 2 (um por env)
    - `grep -c 'dfrobot/DFRobot_QMC5883' firmware/gps_tracker/platformio.ini` retorna 2
    - `grep -c 'Adafruit HTU21DF Library' firmware/gps_tracker/platformio.ini` retorna 2
    - `grep -c 'mikalhart/TinyGPSPlus' firmware/gps_tracker/platformio.ini` retorna 2 (dependencia da Fase 1 preservada)
    - `grep -c 'DEFAULT_I2C_SDA_PIN=21' firmware/gps_tracker/platformio.ini` retorna 1 (override so no env classico)
    - `pio pkg install` para o env `esp32-c3-supermini` termina com codigo de saida 0 e baixa as 3 libs novas
  </acceptance_criteria>
  <done>gps_config.h carrega toda a superficie de configuracao da Fase 01.1 e o PlatformIO resolve as 3 dependencias novas nos dois envs.</done>
</task>

<task type="auto">
  <name>Task 2: Modulo i2c_bus — scan de boot, saude por modulo e re-init agendado</name>
  <files>firmware/gps_tracker/src/i2c_bus.h, firmware/gps_tracker/src/i2c_bus.cpp</files>
  <read_first>
    - `firmware/node/src/ani_sensor.cpp` — o loop de scan I2C (`for addr 0x08..0x77` + `Wire.beginTransmission`/`Wire.endTransmission`), o padrao de reafirmar `Wire.begin()`+`Wire.setClock()` DEPOIS de cada `.begin()` de biblioteca, e o padrao de flags de saude `s_aht_ok`/`s_ens_ok`
    - `firmware/node/src/ani_sensor.h` — a forma de header a espelhar: `#pragma once`, `<stdint.h>`, `<stdbool.h>`, struct POD de leitura, funcoes livres em C-style
    - `firmware/gps_tracker/include/gps_config.h` — as constantes escritas na Task 1 que este modulo consome
    - `.planning/phases/01.1-perifericos-i2c-e-display/01.1-RESEARCH.md` — Pattern 2 (scan de boot com flags independentes), Pitfall 2 (Wire e um barramento global unico), Pitfall 3 (travamento de barramento sem timeout)
    - `.planning/phases/01.1-perifericos-i2c-e-display/01.1-PATTERNS.md` — secao "`firmware/gps_tracker/src/i2c_bus.cpp/.h`" e a secao "Avoid: blocking `while(!ready) delay(N)` sensor-wait loops"
  </read_first>
  <action>
Criar `firmware/gps_tracker/src/i2c_bus.h` com: `#pragma once`, includes `<stdint.h>` e `<stdbool.h>`, um `enum class I2cModule : uint8_t { DISPLAY = 0, ACCEL = 1, MAG = 2, ENV = 3, COUNT = 4 };` e um `namespace i2c_bus` declarando exatamente esta API (os planos 02/03/04 codificam contra ela, entao os nomes sao contrato, nao sugestao):

`void begin()` — chama `Wire.begin(DEFAULT_I2C_SDA_PIN, DEFAULT_I2C_SCL_PIN)`, `Wire.setClock(DEFAULT_I2C_CLOCK_HZ)`, varre os enderecos 0x08..0x77 registrando quais responderam, imprime uma linha de cabecalho `[I2C] scan sda=%u scl=%u clk=%lu` e uma linha `[I2C] found 0x%02X` por endereco encontrado, e no fim semeia as flags online dos 4 modulos a partir do resultado do scan (DISPLAY se `DEFAULT_OLED_ADDR` ou `DEFAULT_OLED_ADDR_ALT` respondeu; ACCEL se `DEFAULT_ACCEL_ADDR`; MAG se `DEFAULT_MAG_ADDR_HMC`, `DEFAULT_MAG_ADDR_QMC` ou `DEFAULT_MAG_ADDR_VCM`; ENV se `DEFAULT_ENV_ADDR`), fazendo `bind()` do endereco efetivamente encontrado. Encerra imprimindo uma linha `[I2C] modules disp=%s accel=%s mag=%s env=%s` com "on"/"off". Nao retorna erro nem aborta se nada for encontrado — zero modulos e um estado valido (D-12).

`void tick()` — chamada a cada iteracao de `loop()`. Para cada modulo que esteja offline E cujo `DEFAULT_I2C_RETRY_INTERVAL_MS` desde a ultima tentativa tenha vencido: faz uma unica sondagem de endereco (`beginTransmission`/`endTransmission`) no endereco vinculado (ou, se nenhum estiver vinculado, nos enderecos candidatos daquele modulo), atualiza o carimbo de tentativa, e se o endereco responder marca a flag interna de re-init pendente e imprime `[I2C] %s responding again addr=0x%02X`. No maximo UMA sondagem por chamada de `tick()`, mesmo que varios modulos estejam com retry vencido — sonde em rodizio (round-robin) para que uma unica iteracao de `loop()` nunca acumule 4 transacoes I2C (Pitfall 1). Quando nenhum modulo estiver offline com retry vencido, `tick()` retorna imediatamente sem tocar no barramento.

`bool present(uint8_t addr)` — resultado do scan de boot para um endereco.
`uint8_t foundCount()` — quantos enderecos responderam no scan de boot.
`void restoreClock()` — reafirma `Wire.setClock(DEFAULT_I2C_CLOCK_HZ)`; os drivers dos planos 02/03/04 chamam isto depois de qualquer `.begin()` de biblioteca e antes de cada leitura, replicando o padrao do `ani_sensor.cpp` (Pitfall 2).
`void bind(I2cModule m, uint8_t addr)` / `uint8_t boundAddr(I2cModule m)` — registra/consulta o endereco real em que o modulo foi encontrado (necessario porque OLED pode ser 0x3C ou 0x3D e a bussola 0x1E/0x0D/0x0C).
`void setOnline(I2cModule m, bool ok)` — o driver reporta o resultado do proprio `begin()`; ao passar `true` zera o contador de erros consecutivos.
`bool online(I2cModule m)`.
`void reportOk(I2cModule m)` — leitura bem-sucedida; zera o contador de erros consecutivos.
`void reportError(I2cModule m)` — incrementa o contador de erros consecutivos; ao atingir `DEFAULT_I2C_ERROR_THRESHOLD` marca o modulo offline, incrementa o contador acumulado de eventos de offline, arma o timer de retry e imprime `[I2C] %s OFFLINE after %u consecutive errors` (D-13).
`uint16_t errorCount(I2cModule m)` — erros consecutivos correntes.
`uint32_t offlineEvents(I2cModule m)` — quantas vezes o modulo ja caiu, acumulado desde o boot.
`bool reinitDue(I2cModule m)` — verdadeiro quando `tick()` confirmou que o endereco voltou a responder e o driver ainda nao tentou re-inicializar.
`void clearReinit(I2cModule m)` — o driver chama apos tentar re-inicializar, com sucesso ou nao.
`const char *moduleName(I2cModule m)` — "display", "accel", "mag", "env".

Criar `firmware/gps_tracker/src/i2c_bus.cpp` implementando isso com arrays estaticos de tamanho `static_cast<size_t>(I2cModule::COUNT)` para flags online, contador de erros consecutivos, contador de eventos de offline, endereco vinculado, carimbo de ultima tentativa de retry e flag de re-init pendente. Includes: `"i2c_bus.h"`, `<Arduino.h>`, `<Wire.h>`, `"gps_config.h"`.

Restricoes de tempo obrigatorias, porque este modulo compartilha o superloop com o consumidor de UART do GPS: nenhuma funcao deste arquivo pode conter espera bloqueante nem sono; toda espera necessaria e expressa como comparacao `millis() - carimbo >= intervalo` distribuida entre iteracoes de `loop()`. O scan de boot em `begin()` e a unica varredura completa permitida e roda uma unica vez, antes do `loop()`.
  </action>
  <verify>
    <automated>/home/luc/Dev/aguada-firmware-main/.venv/bin/pio run -d /home/luc/Dev/aguada-firmware-main/aguada-firmware/firmware/gps_tracker -e esp32-c3-supermini</automated>
    <automated>grep -c 'i2c_bus::begin\|i2c_bus::tick\|i2c_bus::restoreClock\|i2c_bus::reportError\|i2c_bus::reportOk\|i2c_bus::reinitDue\|i2c_bus::clearReinit\|i2c_bus::setOnline\|i2c_bus::online\|i2c_bus::bind\|i2c_bus::boundAddr\|i2c_bus::moduleName\|i2c_bus::present' firmware/gps_tracker/src/i2c_bus.cpp</automated>
    <automated>grep -v '^[[:space:]]*//' firmware/gps_tracker/src/i2c_bus.cpp | grep -c 'delay(' </automated>
  </verify>
  <acceptance_criteria>
    - `firmware/gps_tracker/src/i2c_bus.h` declara `enum class I2cModule` com os membros DISPLAY, ACCEL, MAG, ENV, COUNT
    - `firmware/gps_tracker/src/i2c_bus.h` declara as 16 funcoes do namespace `i2c_bus` listadas na acao, com as assinaturas exatas dadas
    - `grep -v '^[[:space:]]*//' firmware/gps_tracker/src/i2c_bus.cpp | grep -c 'delay('` retorna 0 — o modulo nao contem espera bloqueante (Pitfall 1) <!-- planner-discipline-allow: delay( -->
    - `grep -c 'DEFAULT_I2C_ERROR_THRESHOLD' firmware/gps_tracker/src/i2c_bus.cpp` retorna ao menos 1 (o limiar de offline vem da constante, nao esta hardcoded)
    - `grep -c 'DEFAULT_I2C_RETRY_INTERVAL_MS' firmware/gps_tracker/src/i2c_bus.cpp` retorna ao menos 1
    - `pio run -e esp32-c3-supermini` termina com codigo de saida 0
  </acceptance_criteria>
  <done>O modulo compila e expoe a politica unica de saude/retry I2C que os planos 02, 03 e 04 vao consumir.</done>
</task>

<task type="auto">
  <name>Task 3: Ligar i2c_bus no main.cpp — boot scan, tick de recuperacao e campos I2C no [HEALTH]</name>
  <files>firmware/gps_tracker/src/main.cpp</files>
  <read_first>
    - `firmware/gps_tracker/src/main.cpp` — o arquivo inteiro: `setup()` (ordem `Serial.begin` -> `pinMode` -> `gpsReader.begin()`), o corpo de `loop()`, e o bloco `[HEALTH]` no fim de `loop()` com seu `Serial.printf` de linha unica em pares chave=valor
    - `firmware/gps_tracker/src/i2c_bus.h` — a API escrita na Task 2
    - `firmware/gps_tracker/include/gps_config.h` — `DEFAULT_GPS_HEALTH_PERIOD_MS` e o padrao do timer que voce vai replicar
  </read_first>
  <action>
Em `firmware/gps_tracker/src/main.cpp`, adicionar `#include "i2c_bus.h"` junto aos includes existentes do projeto.

Em `setup()`, chamar `i2c_bus::begin()` APOS `gpsReader.begin()` e apos as linhas de banner existentes. A ordem importa: o UART do GPS precisa estar aberto e drenando antes de qualquer transacao I2C, para que o scan de boot nao seja a primeira coisa a competir por CPU. Acrescentar uma linha de banner informando que o barramento I2C esta em `DEFAULT_I2C_SDA_PIN`/`DEFAULT_I2C_SCL_PIN`.

Adicionar uma funcao estatica `static void i2cRecoverTick()` acima de `loop()`. Ela chama `i2c_bus::tick()` e depois, para cada um dos 4 valores de `I2cModule`, verifica `i2c_bus::reinitDue(m)`; quando verdadeiro, executa a recuperacao daquele modulo e chama `i2c_bus::clearReinit(m)`. Neste plano ainda nao existem drivers, entao a recuperacao e generica: `i2c_bus::setOnline(m, true)` mais uma linha `[I2C] %s recovered addr=0x%02X`. Estruture o corpo como um `switch` sobre `I2cModule` com um case por modulo (DISPLAY, ACCEL, MAG, ENV), cada um com um comentario indicando que o plano correspondente da fase (02 = ACCEL, 03 = MAG e ENV, 04 = DISPLAY) vai inserir a chamada de `begin()` do proprio driver antes do `setOnline`. Essa forma existe para que os planos seguintes sejam aditivos e nao precisem reescrever este bloco.

Em `loop()`, chamar `i2cRecoverTick()` uma vez por iteracao, posicionada DEPOIS do bloco de fixes reais e de `simTick()` e ANTES do bloco `ledWrite`/`[HEALTH]`. Justificativa a registrar em comentario: o pipeline GPS sempre roda primeiro em cada iteracao; trabalho de periferico so acontece depois que o snapshot do fix daquela iteracao ja foi processado.

Estender o `Serial.printf` do bloco `[HEALTH]` acrescentando, ao final da string de formato existente e preservando todos os campos atuais na mesma ordem, os campos ` disp=%s accel=%s mag=%s env=%s i2c_drops=%lu`. Os quatro primeiros vem de `i2c_bus::online(I2cModule::X)` mapeado para "on"/"off"; `i2c_drops` e a soma de `i2c_bus::offlineEvents()` dos 4 modulos. Nenhum campo existente da linha `[HEALTH]` pode ser removido, renomeado ou reordenado — a Fase 1 e o `BENCH.md` dependem do formato atual.
  </action>
  <verify>
    <automated>/home/luc/Dev/aguada-firmware-main/.venv/bin/pio run -d /home/luc/Dev/aguada-firmware-main/aguada-firmware/firmware/gps_tracker -e esp32-c3-supermini</automated>
    <automated>/home/luc/Dev/aguada-firmware-main/.venv/bin/pio run -d /home/luc/Dev/aguada-firmware-main/aguada-firmware/firmware/gps_tracker -e esp32-devkit</automated>
    <automated>grep -c 'i2c_bus::begin()\|i2cRecoverTick()\|disp=%s accel=%s mag=%s env=%s' firmware/gps_tracker/src/main.cpp</automated>
    <human-check>Gravar o firmware no ESP32-C3 SuperMini com os 4 modulos ligados no barramento GPIO6/GPIO7 e confirmar no monitor serial 115200 que o boot imprime a linha `[I2C] scan sda=6 scl=7` seguida de uma linha `[I2C] found 0x..` por modulo presente (esperado: 0x3C ou 0x3D, 0x68, 0x1E ou 0x0D, 0x40) e a linha `[I2C] modules disp=on accel=on mag=on env=on`. Registrar quais enderecos apareceram — em particular se a bussola respondeu em 0x1E (HMC5883L) ou 0x0D (QMC5883L), que e a resposta a Open Question 1 do RESEARCH.md e determina qual caminho o plano 03 exercita primeiro.</human-check>
    <human-check>Com o firmware rodando, desconectar o fio de um unico modulo (por exemplo o HTU21D) e confirmar que: (a) o firmware NAO congela — a linha `[HEALTH]` continua saindo a cada 5 s e o LED continua com o mesmo comportamento; (b) apos ate ~3 leituras falhas aquele modulo aparece como `off` na linha `[HEALTH]`; (c) ao religar o fio, dentro de ~10 s aparece `[I2C] env responding again` e o campo volta a `on`, sem reboot (D-13).</human-check>
    <human-check>Desligar TODOS os 4 modulos I2C, dar boot, e confirmar que o firmware inicia normalmente, o scan reporta zero enderecos, os 4 campos saem `off`, e o pipeline GPS segue produzindo `[EMIT]`/`[REJECT]`/`[HEALTH]` exatamente como na Fase 1 (D-12).</human-check>
  </verify>
  <acceptance_criteria>
    - `grep -c 'i2c_bus::begin()' firmware/gps_tracker/src/main.cpp` retorna 1 e a chamada esta dentro de `setup()`, posicionada depois de `gpsReader.begin()`
    - `grep -c 'i2cRecoverTick' firmware/gps_tracker/src/main.cpp` retorna ao menos 2 (definicao + chamada em `loop()`)
    - A string de formato do `[HEALTH]` contem os literais `disp=%s`, `accel=%s`, `mag=%s`, `env=%s` e `i2c_drops=%lu`
    - Os campos `[HEALTH]` pre-existentes seguem presentes: `grep -c 'bytes=%lu ok=%lu bad=%lu' firmware/gps_tracker/src/main.cpp` retorna 1 e `grep -c 'cadence=%s since_emit=%lus emit=%lu suppress=%lu' firmware/gps_tracker/src/main.cpp` retorna 1
    - `pio run` termina com codigo 0 nos dois envs (`esp32-c3-supermini` e `esp32-devkit`)
    - Comportamento on-hardware: boot com modulos ausentes nao impede o firmware de rodar nem interrompe o pipeline GPS
  </acceptance_criteria>
  <done>O boot lista o barramento, a linha [HEALTH] mostra o estado dos 4 modulos, e remover/religar um modulo em runtime nao derruba o rastreamento GPS.</done>
</task>

</tasks>

<threat_model>
## Trust Boundaries

| Boundary | Description |
|---|---|
| barramento I2C -> firmware | Dados de 4 modulos externos nao confiaveis (fios de bancada, modulos clone) entram no superloop; um dispositivo defeituoso pode segurar SCL/SDA |
| USB serial -> firmware | Acesso fisico ao cabo USB; entrada de comandos de bancada |
| UART GPS -> firmware | Fronteira pre-existente da Fase 1, inalterada por este plano |

## STRIDE Threat Register

| Threat ID | Category | Component | Severity | Disposition | Mitigation Plan |
|---|---|---|---|---|---|
| T-01.1-02 | Denial of Service | `i2c_bus.cpp` / barramento compartilhado GPIO6-7 | high | mitigate | Modulo com falha e marcado offline apos `DEFAULT_I2C_ERROR_THRESHOLD` erros consecutivos e para de ser sondado; o retry de `DEFAULT_I2C_RETRY_INTERVAL_MS` faz no maximo uma sondagem por iteracao de `loop()` em rodizio. A correcao do pipeline GPS nunca depende da saude do barramento I2C (D-12/D-13). |
| T-01.1-03 | Denial of Service | `i2c_bus::begin()` / `i2c_bus::tick()` vs buffer RX do UART do GPS | high | mitigate | Nenhuma espera bloqueante em `i2c_bus.cpp` (criterio de aceite grep == 0); o scan completo do barramento roda uma unica vez em `setup()`, nunca em `loop()`; `tick()` sai imediatamente quando nenhum retry venceu. |
| T-01.1-07 | Spoofing | dispositivo I2C arbitrario respondendo em um endereco esperado | low | accept | O barramento e cabeamento fisico de bancada dentro do gabinete; posse fisica ja e o modelo de controle de acesso deste dispositivo offline. Controle adicional seria desproporcional no nivel ASVS 1. |
| T-01.1-SC | Tampering | dependencias PlatformIO novas (U8g2, DFRobot_QMC5883, Adafruit HTU21DF) | medium | mitigate | Versoes fixadas por semver; auditoria manual de legitimidade registrada em `01.1-RESEARCH.md` (secao "Package Legitimacy Audit") contra o registro PlatformIO e fetch direto do fonte no GitHub — o seam `package-legitimacy check` do gsd-tools so cobre npm/pypi/crates e nao se aplica a bibliotecas Arduino. `dfrobot/DFRobot_QMC5883` esta marcada `[WARNING]` por nao receber release desde 2022; a confirmacao on-hardware da deteccao HMC/QMC no plano 03 e a validacao que fecha esse risco. |
</threat_model>

<verification>
- `pio run -e esp32-c3-supermini` e `pio run -e esp32-devkit` compilam com codigo de saida 0.
- O boot serial lista os enderecos I2C presentes e o estado inicial dos 4 modulos.
- Remover um modulo em runtime marca so aquele modulo offline; religar recupera dentro de ~10 s.
- Com zero modulos presentes, o firmware roda e o pipeline GPS da Fase 1 permanece funcional e inalterado.
</verification>

<success_criteria>
- D-12 observavel: qualquer subconjunto dos 4 modulos (0 a 4) permite boot e operacao completos, com o estado visivel no serial.
- D-13 observavel: falha em runtime marca offline apos N erros e recupera sozinha no timer de ~10 s.
- Toda a superficie de constantes `DEFAULT_*` da fase existe e e sobreponivel por `build_flags`.
- As 3 bibliotecas novas resolvem nos dois envs sem quebrar a dependencia TinyGPSPlus da Fase 1.
</success_criteria>

<output>
Create `.planning/phases/01.1-perifericos-i2c-e-display/01.1-01-SUMMARY.md` when done
</output>
