lucianoET/aguada-firmware/.planning/phases/01.1-perifericos-i2c-e-display/01.1-02-PLAN.md

---
phase: 01.1-perifericos-i2c-e-display
plan: 02
type: execute
wave: 2
depends_on: ["01.1-01"]
files_modified:
  - firmware/gps_tracker/src/accel_sensor.h
  - firmware/gps_tracker/src/accel_sensor.cpp
  - firmware/gps_tracker/src/cadence.h
  - firmware/gps_tracker/src/cadence.cpp
  - firmware/gps_tracker/src/main.cpp
autonomous: true
requirements: [D-05, D-06, D-07, D-12, D-13]

must_haves:
  truths:
    - "Sacudir o tracker parado promove a cadencia de STATIONARY para MOVING sem esperar varios fixes de GPS, e a linha [STATE] identifica a origem accel da transicao (D-05)"
    - "Nenhum caminho derivado do accel consegue rebaixar a cadencia de MOVING para STATIONARY — so um fix aceito pelo gate via onGatedFix() rebaixa (D-05)"
    - "A deteccao de movimento vem de polling I2C da magnitude do acelerometro com limiar e debounce em software, sem fio INT (D-06)"
    - "Somente registradores de aceleracao sao lidos; o giroscopio nao e habilitado nem lido (D-07)"
    - "Com o MPU6050 ausente ou desconectado em runtime, a cadencia continua funcionando exclusivamente pelo GPS e o rastreamento nao para (D-12/D-13)"
  artifacts:
    - "firmware/gps_tracker/src/accel_sensor.h"
    - "firmware/gps_tracker/src/accel_sensor.cpp"
    - "Cadence::onAccelWake(uint32_t mono_ms) declarado em cadence.h e implementado em cadence.cpp"
  key_links:
    - "main.cpp: o edge de wake do accel e o UNICO chamador de cadence.onAccelWake(), e onGatedFix() segue com o unico chamador dentro do ramo GateResult::ACCEPT em handleAccept()"
    - "accel_sensor reporta sucesso/erro de cada leitura via i2c_bus::reportOk/reportError e se re-inicializa via i2c_bus::reinitDue (politica D-13 do plano 01)"
    - "O comentario de contrato no topo de cadence.h documenta os DOIS pontos de entrada e a assimetria de autoridade entre eles"
---

<objective>
Adicionar o acelerometro MPU6050 como sinal de despertar da cadencia: leitura crua por I2C da magnitude de aceleracao, limiar com debounce em software, e um segundo ponto de entrada explicito e documentado em `Cadence` que so consegue promover STATIONARY -> MOVING.

Purpose: D-05 existe porque o GPS leva varios fixes aceitos (`DEFAULT_GPS_DEBOUNCE_FIXES` = 3, a ~1 Hz) para reconhecer que o veiculo voltou a andar — tempo em que a cadencia fica suprimindo pontos de um trajeto que ja comecou. O accel percebe a partida no primeiro poll de 100 ms. A autoridade permanece assimetrica de proposito: vibracao de motor ligado parado nao pode fazer o tracker se declarar em movimento indefinidamente, entao so a velocidade do GPS rebaixa o estado.
Output: `accel_sensor.h`/`.cpp`, `Cadence::onAccelWake()`, e o agendamento + ponto de chamada em `main.cpp`.
</objective>

<execution_context>
@$HOME/.claude/gsd-core/workflows/execute-plan.md
@$HOME/.claude/gsd-core/templates/summary.md
</execution_context>

<context>
@.planning/PROJECT.md
@.planning/ROADMAP.md
@.planning/STATE.md
@.planning/phases/01.1-perifericos-i2c-e-display/01.1-CONTEXT.md
@.planning/phases/01.1-perifericos-i2c-e-display/01.1-RESEARCH.md
@.planning/phases/01.1-perifericos-i2c-e-display/01.1-PATTERNS.md
@.planning/phases/01.1-perifericos-i2c-e-display/01.1-01-SUMMARY.md
@firmware/gps_tracker/src/i2c_bus.h
@firmware/gps_tracker/src/cadence.h
@firmware/gps_tracker/src/cadence.cpp
@firmware/gps_tracker/src/main.cpp
@firmware/gps_tracker/include/gps_config.h
</context>

## Artifacts this phase produces

Simbolos criados pela Fase 01.1 inteira (todos os planos). Nenhum destes existe no codebase antes desta fase — nao os trate como drift.

**Arquivos novos:** `firmware/gps_tracker/src/i2c_bus.h`, `i2c_bus.cpp`, `accel_sensor.h`, `accel_sensor.cpp`, `mag_sensor.h`, `mag_sensor.cpp`, `env_sensor.h`, `env_sensor.cpp`, `display.h`, `display.cpp`.

**Tipos novos:** `I2cModule` (enum class: DISPLAY, ACCEL, MAG, ENV, COUNT), `AccelReading` (struct), `MagChip` (enum class: NONE, HMC5883L, QMC5883L, VCM5883L), `MagCalibration` (struct), `EnvReading` (struct), `DisplayState` (struct).

**Funcoes novas — namespace `i2c_bus`:** `begin`, `tick`, `present`, `foundCount`, `restoreClock`, `bind`, `boundAddr`, `setOnline`, `online`, `reportOk`, `reportError`, `errorCount`, `offlineEvents`, `reinitDue`, `clearReinit`, `moduleName`.

**Funcoes novas — namespace `accel_sensor`:** `begin`, `poll`, `last`, `wakeEdge`, `magnitudeG`, `debounceStreak`.

**Funcoes novas — namespace `mag_sensor`:** `begin`, `poll`, `chip`, `chipName`, `headingDeg`, `cardinal`, `calStart`, `calFinish`, `calAbort`, `calActive`, `calElapsedS`, `calibration`, `arbitratedHeading`.

**Funcoes novas — namespace `env_sensor`:** `begin`, `poll`, `last`.

**Funcoes novas — namespace `display`:** `begin`, `render`, `addr`.

**Metodo novo em classe existente:** `Cadence::onAccelWake(uint32_t mono_ms)`.

**Funcoes novas em `main.cpp`:** `i2cRecoverTick`, `calHandleChar`, `buildDisplayState`, `speedInDisplayUnit`, `speedUnitLabel`.

**Constantes `DEFAULT_*` novas em `gps_config.h`:** `DEFAULT_I2C_SDA_PIN`, `DEFAULT_I2C_SCL_PIN`, `DEFAULT_I2C_CLOCK_HZ`, `DEFAULT_I2C_ERROR_THRESHOLD`, `DEFAULT_I2C_RETRY_INTERVAL_MS`, `DEFAULT_OLED_ADDR`, `DEFAULT_OLED_ADDR_ALT`, `DEFAULT_ACCEL_ADDR`, `DEFAULT_MAG_ADDR_HMC`, `DEFAULT_MAG_ADDR_QMC`, `DEFAULT_MAG_ADDR_VCM`, `DEFAULT_ENV_ADDR`, `DEFAULT_ACCEL_POLL_MS`, `DEFAULT_ACCEL_WAKE_THRESHOLD_G`, `DEFAULT_ACCEL_WAKE_DEBOUNCE_SAMPLES`, `DEFAULT_MAG_POLL_MS`, `DEFAULT_MAG_DECLINATION`, `DEFAULT_MAG_CAL_TIMEOUT_S`, `DEFAULT_HTU21_POLL_MS`, `DEFAULT_DISPLAY_REFRESH_MS`, `DEFAULT_SPEED_UNIT`.

**Dependencias PlatformIO novas:** `olikraus/U8g2`, `dfrobot/DFRobot_QMC5883`, `adafruit/Adafruit HTU21DF Library` (+ transitiva `adafruit/Adafruit BusIO`).

**Comando serial novo:** `cal` (multi-caractere, terminado por Enter).

<tasks>

<task type="auto" tdd="true">
  <name>Task 1: accel_sensor — leitura crua MPU6050 e edge de despertar por magnitude</name>
  <files>firmware/gps_tracker/src/accel_sensor.h, firmware/gps_tracker/src/accel_sensor.cpp</files>
  <read_first>
    - `firmware/gps_tracker/src/i2c_bus.h` — a API de saude/retry criada no plano 01 (`restoreClock`, `reportOk`, `reportError`, `setOnline`, `online`, `reinitDue`, `clearReinit`, `bind`, `boundAddr`) que este driver deve usar em vez de manter politica propria
    - `firmware/node/src/ani_sensor.h` — a forma de header a espelhar (POD de leitura + funcoes livres + flag de saude)
    - `firmware/node/src/ani_sensor.cpp` — o padrao de reafirmar o clock do `Wire` antes de cada leitura; e a espera bloqueante nas linhas finais de `ani_read()`, que e o anti-padrao explicitamente proibido aqui
    - `.planning/phases/01.1-perifericos-i2c-e-display/01.1-RESEARCH.md` — Pattern 4 (enderecos de registrador do MPU6050 e conversao de escala), Pitfall 1 (orçamento de tempo vs buffer UART do GPS), Assumptions Log A1
    - `firmware/gps_tracker/include/gps_config.h` — `DEFAULT_ACCEL_ADDR`, `DEFAULT_ACCEL_POLL_MS`, `DEFAULT_ACCEL_WAKE_THRESHOLD_G`, `DEFAULT_ACCEL_WAKE_DEBOUNCE_SAMPLES`
  </read_first>
  <behavior>
    - Com o modulo presente e imovel sobre a mesa, `magnitudeG()` fica proximo de 1.0 g e `wakeEdge()` nunca retorna verdadeiro
    - Um desvio absoluto de magnitude em relacao a 1.0 g maior ou igual a `DEFAULT_ACCEL_WAKE_THRESHOLD_G` sustentado por `DEFAULT_ACCEL_WAKE_DEBOUNCE_SAMPLES` polls consecutivos faz `wakeEdge()` retornar verdadeiro exatamente uma vez
    - Um unico poll acima do limiar seguido de polls abaixo do limiar zera o streak e nao produz edge (rejeicao de solavanco isolado)
    - `wakeEdge()` e one-shot: a segunda chamada consecutiva retorna falso ate que um novo streak completo ocorra
    - Com o modulo ausente, `begin()` retorna falso, `poll()` retorna falso e `wakeEdge()` nunca fica verdadeiro — nada trava
    - Uma leitura curta ou com NACK e contabilizada como erro no `i2c_bus` e nao contamina o streak de debounce com um valor lixo
  </behavior>
  <action>
Criar `firmware/gps_tracker/src/accel_sensor.h` com `#pragma once`, includes `<stdint.h>`/`<stdbool.h>`, o struct `struct AccelReading { float magnitude_g; bool valid; };` e um `namespace accel_sensor` declarando: `bool begin();`, `bool poll();`, `AccelReading last();`, `bool wakeEdge();`, `float magnitudeG();`, `uint8_t debounceStreak();`.

Criar `firmware/gps_tracker/src/accel_sensor.cpp` com includes `"accel_sensor.h"`, `<Arduino.h>`, `<Wire.h>`, `<math.h>`, `"gps_config.h"`, `"i2c_bus.h"`.

`begin()`: chamar `i2c_bus::restoreClock()`; ler o registrador WHO_AM_I no endereco 0x75 do dispositivo em `DEFAULT_ACCEL_ADDR` e exigir que o valor lido seja 0x68; em seguida escrever 0x00 no registrador PWR_MGMT_1 no endereco 0x6B para tirar o chip do sleep. Qualquer `Wire.endTransmission()` com retorno diferente de zero, ou `Wire.requestFrom()` devolvendo menos bytes que o solicitado, e falha. Registrar o resultado com `i2c_bus::setOnline(I2cModule::ACCEL, ok)` e, em caso de sucesso, `i2c_bus::bind(I2cModule::ACCEL, DEFAULT_ACCEL_ADDR)`. Escrever apenas nesses dois registradores — nenhum outro registrador de configuracao do chip deve ser tocado, o que deixa o fundo de escala do acelerometro no valor de reset (+/-2 g) e fixa a sensibilidade em 16384 LSB/g. D-07 limita esta fase ao acelerometro.

`poll()`: se `i2c_bus::online(I2cModule::ACCEL)` for falso, verificar `i2c_bus::reinitDue(I2cModule::ACCEL)` — quando verdadeiro, chamar `begin()` e `i2c_bus::clearReinit(I2cModule::ACCEL)` — e retornar. Caso online: `i2c_bus::restoreClock()`, apontar para ACCEL_XOUT_H no endereco 0x3B e fazer UMA rajada de 6 bytes, montando tres inteiros de 16 bits com sinal (X, Y, Z, byte alto primeiro), dividindo cada um por 16384.0f e calculando a magnitude euclidiana com `sqrtf`. Em sucesso: `i2c_bus::reportOk(I2cModule::ACCEL)`, guardar a leitura como valida, e alimentar o detector de despertar. Em falha: `i2c_bus::reportError(I2cModule::ACCEL)`, marcar a ultima leitura como invalida, zerar o streak de debounce e retornar falso sem alimentar o detector.

Detector de despertar (D-06): manter um contador de amostras consecutivas cujo desvio absoluto da magnitude em relacao a 1.0 g seja maior ou igual a `DEFAULT_ACCEL_WAKE_THRESHOLD_G`. Uma amostra abaixo do limiar zera o contador. Quando o contador atinge `DEFAULT_ACCEL_WAKE_DEBOUNCE_SAMPLES`, armar uma flag interna de edge e zerar o contador (para que um movimento continuo produza um edge por streak, nao um por poll). `wakeEdge()` consome e limpa essa flag, no mesmo estilo one-shot de `Cadence::stateChanged()` que ja existe no repo.

Restricao de tempo obrigatoria: nenhuma funcao deste arquivo pode conter espera bloqueante nem sono. Uma chamada de `poll()` faz no maximo uma rajada I2C de 6 bytes e retorna. O agendamento por `DEFAULT_ACCEL_POLL_MS` e responsabilidade do chamador em `main.cpp` (Task 3), nao deste arquivo.
  </action>
  <verify>
    <automated>/home/luc/Dev/aguada-firmware-main/.venv/bin/pio run -d /home/luc/Dev/aguada-firmware-main/aguada-firmware/firmware/gps_tracker -e esp32-c3-supermini</automated>
    <automated>grep -c '0x75\|0x6B\|0x3B\|16384' firmware/gps_tracker/src/accel_sensor.cpp</automated>
    <automated>grep -v '^[[:space:]]*//' firmware/gps_tracker/src/accel_sensor.cpp | grep -c 'delay('</automated>
    <automated>grep -c 'DEFAULT_ACCEL_WAKE_THRESHOLD_G\|DEFAULT_ACCEL_WAKE_DEBOUNCE_SAMPLES' firmware/gps_tracker/src/accel_sensor.cpp</automated>
  </verify>
  <acceptance_criteria>
    - `firmware/gps_tracker/src/accel_sensor.h` declara `struct AccelReading` com os campos `magnitude_g` e `valid`, e as 6 funcoes do namespace `accel_sensor` listadas na acao
    - `grep -v '^[[:space:]]*//' firmware/gps_tracker/src/accel_sensor.cpp | grep -c 'delay('` retorna 0 <!-- planner-discipline-allow: delay( -->
    - D-07 provado estruturalmente: `grep -c 'requestFrom' firmware/gps_tracker/src/accel_sensor.cpp` retorna 2 (um byte de WHO_AM_I em `begin()`, seis bytes de aceleracao em `poll()`) e a rajada de leitura de `poll()` pede exatamente 6 bytes — nao 14, que seria a rajada que arrasta temperatura e giroscopio junto
    - Exatamente duas escritas de registrador em `begin()` e nenhuma em `poll()`: `grep -c 'Wire.write' firmware/gps_tracker/src/accel_sensor.cpp` retorna 4 (dois ponteiros de registrador para leitura + o par registrador/valor da saida de sleep)
    - `grep -c 'i2c_bus::reportError' firmware/gps_tracker/src/accel_sensor.cpp` retorna ao menos 1 e `grep -c 'i2c_bus::reportOk' firmware/gps_tracker/src/accel_sensor.cpp` retorna ao menos 1 — a politica de falha e a do plano 01, nao uma local
    - `grep -c 'i2c_bus::reinitDue' firmware/gps_tracker/src/accel_sensor.cpp` retorna ao menos 1 — o driver participa do retry de D-13
    - Os limiares vem das constantes `DEFAULT_ACCEL_WAKE_THRESHOLD_G` / `DEFAULT_ACCEL_WAKE_DEBOUNCE_SAMPLES`, nao de literais no `.cpp`
    - `pio run -e esp32-c3-supermini` termina com codigo de saida 0
  </acceptance_criteria>
  <done>O driver le a magnitude de aceleracao numa unica rajada I2C, produz um edge de despertar debounced, e degrada silenciosamente quando o modulo esta ausente.</done>
</task>

<task type="auto" tdd="true">
  <name>Task 2: Cadence::onAccelWake — segundo ponto de entrada com autoridade assimetrica</name>
  <files>firmware/gps_tracker/src/cadence.h, firmware/gps_tracker/src/cadence.cpp</files>
  <read_first>
    - `firmware/gps_tracker/src/cadence.h` — o arquivo inteiro: o comentario de contrato de classe no topo (que declara hoje um unico ponto de chamada e precisa ser atualizado, nao contornado), a declaracao de `onGatedFix`, `state`, `stateChanged`, `lastTransitionSpeedKmh`, `lastTransitionElapsedS`, e os membros privados `movingStreak_`, `stationaryStreak_`, `stateEnteredMs_`, `haveEmitted_`, `lastEmitMs_`, `stateChanged_`
    - `firmware/gps_tracker/src/cadence.cpp` — o arquivo inteiro: o ramo STATIONARY -> MOVING de `onGatedFix()` (a contabilidade exata que `onAccelWake` deve espelhar) e o bloco de decisao de ritmo com a variavel `justEnteredMoving`
    - `.planning/phases/01.1-perifericos-i2c-e-display/01.1-RESEARCH.md` — Pitfall 4 (a extensao deliberada e visivel do contrato)
    - `.planning/phases/01.1-perifericos-i2c-e-display/01.1-PATTERNS.md` — a secao sobre `cadence.cpp/.h` (MODIFIED)
  </read_first>
  <behavior>
    - Em estado STATIONARY, uma chamada a `onAccelWake(mono_ms)` retorna verdadeiro, deixa `state()` em MOVING e faz `stateChanged()` retornar verdadeiro uma vez
    - Em estado MOVING, `onAccelWake(mono_ms)` retorna falso, nao altera `state()` e nao aciona `stateChanged()`
    - Nenhum valor de argumento faz `onAccelWake()` levar o estado para STATIONARY
    - Apos um `onAccelWake()` que promoveu, o primeiro `onGatedFix()` seguinte com um fix aceito retorna EMIT em vez de SUPPRESS_INTERVAL, mesmo que o intervalo de `DEFAULT_GPS_CADENCE_MOVING_S` ainda nao tenha decorrido desde o ultimo emit
    - Apos um `onAccelWake()` que promoveu, ainda sao necessarios `DEFAULT_GPS_DEBOUNCE_FIXES` fixes consecutivos com velocidade abaixo de `DEFAULT_GPS_STATIONARY_KMH` para voltar a STATIONARY — a promocao por accel nao encurta nem alonga o caminho de rebaixamento
    - `lastTransitionSpeedKmh()` apos uma promocao por accel reporta 0.0f, sinalizando que a transicao nao veio de uma amostra de velocidade do GPS
  </behavior>
  <action>
Em `firmware/gps_tracker/src/cadence.h`: reescrever o comentario de contrato no topo do arquivo para documentar DOIS pontos de entrada e a assimetria de autoridade entre eles — `onGatedFix()` continua sendo chamado exclusivamente de dentro do ramo `GateResult::ACCEPT` em `main.cpp` e e o unico caminho capaz de rebaixar MOVING -> STATIONARY; `onAccelWake()` e chamado exclusivamente do edge de despertar do acelerometro em `main.cpp` e so consegue promover STATIONARY -> MOVING (D-05). O comentario deve deixar explicito que essa assimetria e proposital: vibracao de motor parado nao pode manter o tracker em MOVING, entao a autoridade para declarar "parou" fica so com a velocidade Doppler do receptor. Preservar o paragrafo existente que explica por que a classificacao usa `f.speed_kmh` e nao delta de posicao.

Declarar em `cadence.h`, junto a `onGatedFix`, o metodo `bool onAccelWake(uint32_t mono_ms);` com um comentario curto indicando que retorna verdadeiro somente quando esta chamada efetivamente promoveu o estado. Adicionar o membro privado `bool accelWakePending_ = false;`.

Em `firmware/gps_tracker/src/cadence.cpp`, implementar `Cadence::onAccelWake(uint32_t mono_ms)`: retornar falso imediatamente se `state_` ja for MOVING. Caso contrario replicar exatamente a mesma contabilidade que o ramo STATIONARY -> MOVING de `onGatedFix()` ja faz — calcular `lastTransitionElapsedS_` a partir de `mono_ms` e `stateEnteredMs_`, atribuir `state_` = MOVING, atualizar `stateEnteredMs_`, zerar `movingStreak_` e `stationaryStreak_`, marcar `stateChanged_` — com duas diferencas: `lastTransitionSpeedKmh_` recebe 0.0f (nao ha amostra de velocidade do GPS nesta transicao) e `accelWakePending_` recebe verdadeiro. Tambem atualizar `lastKnownMonoMs_` com `mono_ms`. Retornar verdadeiro.

No bloco de decisao de ritmo de `onGatedFix()`, acrescentar `accelWakePending_` como mais um gatilho de emissao imediata ao lado do `justEnteredMoving` ja existente, e consumir a flag (atribuir falso) no mesmo ponto em que `lastEmitMs_` e `haveEmitted_` sao atualizados. Isso e o que entrega o "retomada rapida" de D-05: o primeiro fix aceito depois do despertar por accel sai como EMIT em vez de ficar retido por SUPPRESS_INTERVAL. Nao alterar nada no ramo MOVING -> STATIONARY nem na banda de histerese/debounce — o caminho de rebaixamento fica identico ao da Fase 1.
  </action>
  <verify>
    <automated>/home/luc/Dev/aguada-firmware-main/.venv/bin/pio run -d /home/luc/Dev/aguada-firmware-main/aguada-firmware/firmware/gps_tracker -e esp32-c3-supermini</automated>
    <automated>grep -c 'onAccelWake' firmware/gps_tracker/src/cadence.h firmware/gps_tracker/src/cadence.cpp</automated>
    <automated>grep -c 'accelWakePending_' firmware/gps_tracker/src/cadence.cpp</automated>
    <automated>grep -c 'CadenceState::STATIONARY;' firmware/gps_tracker/src/cadence.cpp</automated>
  </verify>
  <acceptance_criteria>
    - `cadence.h` declara `bool onAccelWake(uint32_t mono_ms);` como metodo publico
    - O comentario de contrato no topo de `cadence.h` menciona ambos os nomes `onGatedFix` e `onAccelWake` e descreve qual deles pode rebaixar o estado
    - `grep -c 'CadenceState::STATIONARY;' firmware/gps_tracker/src/cadence.cpp` retorna 1 — existe exatamente uma atribuicao de estado para STATIONARY em todo o arquivo, e ela esta dentro do ramo de rebaixamento de `onGatedFix()`; `onAccelWake` nao introduziu um segundo caminho de rebaixamento (D-05)
    - `grep -c 'accelWakePending_' firmware/gps_tracker/src/cadence.cpp` retorna ao menos 3 (armar em `onAccelWake`, testar no gatilho de emissao, consumir na emissao)
    - O bloco de histerese/debounce de `onGatedFix()` esta inalterado: `grep -c 'stationaryStreak_ >= DEFAULT_GPS_DEBOUNCE_FIXES' firmware/gps_tracker/src/cadence.cpp` retorna 1
    - `pio run -e esp32-c3-supermini` termina com codigo de saida 0
  </acceptance_criteria>
  <done>Cadence tem um segundo ponto de entrada documentado que so promove, e o caminho de rebaixamento por GPS continua sendo o unico.</done>
</task>

<task type="auto">
  <name>Task 3: main.cpp — agendar o poll do accel e ligar o edge de despertar na cadencia</name>
  <files>firmware/gps_tracker/src/main.cpp</files>
  <read_first>
    - `firmware/gps_tracker/src/main.cpp` — o arquivo inteiro: o padrao de timer `lastHealthMs`/`DEFAULT_GPS_HEALTH_PERIOD_MS`, a funcao `handleAccept()` (unico chamador de `onGatedFix`), `printStateChange()` e sua assinatura, o `i2cRecoverTick()` adicionado no plano 01 com seu `switch` por modulo, e a string de formato do `[HEALTH]`
    - `firmware/gps_tracker/src/accel_sensor.h` — a API escrita na Task 1
    - `firmware/gps_tracker/src/cadence.h` — a assinatura de `onAccelWake` escrita na Task 2
    - `firmware/gps_tracker/src/i2c_bus.h` — `online`, `reinitDue`, `clearReinit`
    - `firmware/gps_tracker/include/gps_config.h` — `DEFAULT_ACCEL_POLL_MS`
  </read_first>
  <action>
Em `firmware/gps_tracker/src/main.cpp`, adicionar `#include "accel_sensor.h"`.

Em `setup()`, chamar `accel_sensor::begin()` depois de `i2c_bus::begin()`. Imprimir uma linha de banner reportando se o acelerometro respondeu.

Adicionar um contador estatico `static uint32_t lastAccelPollMs = 0;` junto aos demais estaticos de topo de arquivo, seguindo exatamente a forma do `lastHealthMs` existente.

Em `loop()`, adicionar um bloco guardado por `if (millis() - lastAccelPollMs >= DEFAULT_ACCEL_POLL_MS)` que atualiza o carimbo e chama `accel_sensor::poll()`. Posicionar esse bloco DEPOIS do processamento de fixes reais e de `simTick()`, e antes de `i2cRecoverTick()`, de modo que o pipeline GPS sempre rode primeiro em cada iteracao.

Dentro desse mesmo bloco, apos o `poll()`, consumir `accel_sensor::wakeEdge()`. Quando verdadeiro: capturar `cadence.state()` como estado anterior, chamar `cadence.onAccelWake(millis())`, e — se a chamada retornou verdadeiro — chamar `printStateChange()` reutilizando o helper existente, com origem `""`, o estado anterior, o novo estado, e os valores de `cadence.lastTransitionSpeedKmh()` / `cadence.lastTransitionElapsedS()`. Para que a linha `[STATE]` identifique a origem accel da transicao sem quebrar o formato existente consumido pelo `BENCH.md`, imprimir imediatamente antes dela uma linha propria `[ACCEL] wake mag=%.2fg streak=%u` usando `accel_sensor::magnitudeG()` e `accel_sensor::debounceStreak()`. Nao alterar a assinatura nem o formato de `printStateChange()`.

Este bloco e o UNICO ponto de chamada de `cadence.onAccelWake()` no codebase. Registrar isso em um comentario acima do bloco, no mesmo espirito do comentario que ja documenta `handleAccept()` como unico ponto de chamada de `onGatedFix()`.

No `switch` de `i2cRecoverTick()` (criado no plano 01), no case `I2cModule::ACCEL`, inserir a chamada `accel_sensor::begin()` antes do `setOnline` generico, para que a recuperacao de D-13 re-inicialize de fato o chip (WHO_AM_I + saida de sleep) em vez de apenas marcar o modulo online.

Estender a string de formato do `[HEALTH]` com os campos ` accel_g=%.2f accel_wakes=%lu`, alimentados por `accel_sensor::magnitudeG()` e por um contador estatico acumulado de edges de despertar incrementado no bloco acima. Preservar todos os campos ja existentes da linha, incluindo os campos `disp=`/`accel=`/`mag=`/`env=`/`i2c_drops=` adicionados no plano 01, sem remover, renomear nem reordenar nenhum.
  </action>
  <verify>
    <automated>/home/luc/Dev/aguada-firmware-main/.venv/bin/pio run -d /home/luc/Dev/aguada-firmware-main/aguada-firmware/firmware/gps_tracker -e esp32-c3-supermini</automated>
    <automated>/home/luc/Dev/aguada-firmware-main/.venv/bin/pio run -d /home/luc/Dev/aguada-firmware-main/aguada-firmware/firmware/gps_tracker -e esp32-devkit</automated>
    <automated>grep -c 'cadence.onAccelWake' firmware/gps_tracker/src/main.cpp</automated>
    <automated>grep -c 'DEFAULT_ACCEL_POLL_MS' firmware/gps_tracker/src/main.cpp</automated>
    <human-check>Com o firmware gravado e o MPU6050 ligado, deixar a placa parada sobre a mesa por 2 minutos e confirmar que a cadencia permanece STATIONARY e que nenhuma linha `[ACCEL] wake` aparece (limiar `DEFAULT_ACCEL_WAKE_THRESHOLD_G` = 0.20 g nao dispara com ruido de repouso). Se dispararem falsos, anotar a magnitude reportada e subir o limiar por `build_flags` — o valor e um ponto de partida de research (A1), nao um valor final.</human-check>
    <human-check>Com a cadencia em STATIONARY, sacudir/inclinar a placa e confirmar que aparece uma linha `[ACCEL] wake mag=..` seguida de `[STATE] STATIONARY -> MOVING` na mesma leva de saida serial, sem esperar os 3 fixes de GPS do debounce (D-05).</human-check>
    <human-check>Apos o despertar por accel, parar de mexer na placa e confirmar, com o simulador de bancada (`s` para ligar, `-` para baixar a velocidade abaixo de 3 km/h), que o retorno para STATIONARY exige os `DEFAULT_GPS_DEBOUNCE_FIXES` = 3 fixes lentos consecutivos — ou seja, o accel nao rebaixou o estado sozinho (D-05).</human-check>
    <human-check>Desconectar o MPU6050 com o firmware rodando e confirmar que `accel=off` aparece no `[HEALTH]`, o pipeline GPS segue emitindo normalmente, e a cadencia continua funcionando so pelo GPS (D-12/D-13). Religar e confirmar recuperacao em ate ~10 s.</human-check>
  </verify>
  <acceptance_criteria>
    - `grep -c 'cadence.onAccelWake' firmware/gps_tracker/src/main.cpp` retorna 1 — ponto de chamada unico
    - `grep -c 'cadence.onGatedFix' firmware/gps_tracker/src/main.cpp` retorna 1 — o ponto de chamada unico da Fase 1 dentro de `handleAccept()` continua unico
    - `grep -c 'accel_sensor::poll' firmware/gps_tracker/src/main.cpp` retorna 1 e a chamada esta dentro de um guarda `millis() - lastAccelPollMs >= DEFAULT_ACCEL_POLL_MS`
    - `grep -c 'accel_sensor::begin' firmware/gps_tracker/src/main.cpp` retorna 2 (`setup()` e o case ACCEL de `i2cRecoverTick()`)
    - A string de formato do `[HEALTH]` contem `accel_g=%.2f` e `accel_wakes=%lu`, e ainda contem `disp=%s accel=%s mag=%s env=%s` e `i2c_drops=%lu` do plano 01
    - `pio run` termina com codigo 0 nos dois envs
    - Comportamento on-hardware: sacudir a placa parada produz `[ACCEL] wake` + `[STATE] STATIONARY -> MOVING`; parar nao produz o inverso sem os fixes lentos do GPS
  </acceptance_criteria>
  <done>O accel desperta a cadencia em ate 100 ms + debounce, a origem da transicao e visivel no log, e o GPS segue sendo a unica autoridade para declarar parada.</done>
</task>

</tasks>

<threat_model>
## Trust Boundaries

| Boundary | Description |
|---|---|
| MPU6050 (I2C) -> maquina de estados da cadencia | Um sensor externo passa a influenciar diretamente o estado de rastreamento; e a primeira vez nesta milestone que algo alem do fix gate do GPS toca `Cadence` |
| barramento I2C -> superloop | Fronteira herdada do plano 01, agora com um consumidor real |

## STRIDE Threat Register

| Threat ID | Category | Component | Severity | Disposition | Mitigation Plan |
|---|---|---|---|---|---|
| T-01.1-04 | Tampering | `Cadence::onAccelWake()` / `accel_sensor` detector de despertar | medium | mitigate | Autoridade assimetrica imposta estruturalmente: `onAccelWake()` retorna cedo quando ja esta MOVING e o arquivo `cadence.cpp` mantem exatamente uma atribuicao de estado para STATIONARY (criterio de aceite por grep), dentro do ramo debounced de `onGatedFix()`. Vibracao ou solavanco isolado e filtrado por `DEFAULT_ACCEL_WAKE_DEBOUNCE_SAMPLES` amostras consecutivas acima de `DEFAULT_ACCEL_WAKE_THRESHOLD_G`; ambos sao sobreponiveis por `build_flags` para calibracao em campo. |
| T-01.1-03 | Denial of Service | `accel_sensor::poll()` vs buffer RX do UART do GPS | high | mitigate | `poll()` faz no maximo uma rajada I2C de 6 bytes (sub-milissegundo a 400 kHz) e nao contem espera bloqueante (criterio de aceite grep == 0); o agendamento de `DEFAULT_ACCEL_POLL_MS` = 100 ms vive em `main.cpp` e o bloco roda depois do passe do pipeline GPS da iteracao. |
| T-01.1-02 | Denial of Service | MPU6050 com defeito segurando o barramento | high | mitigate | O driver nao mantem politica de falha propria: cada leitura reporta a `i2c_bus`, que marca o modulo offline apos `DEFAULT_I2C_ERROR_THRESHOLD` erros consecutivos e para de sonda-lo ate o retry de `DEFAULT_I2C_RETRY_INTERVAL_MS`. Com ACCEL offline o `wakeEdge()` nunca fica verdadeiro e a cadencia opera exclusivamente por GPS. |
| T-01.1-08 | Spoofing | dispositivo respondendo em 0x68 que nao e um MPU6050 | low | accept | `begin()` valida WHO_AM_I == 0x68 antes de aceitar o dispositivo, o que ja descarta confusao acidental de endereco; um impostor deliberado exigiria acesso fisico ao barramento interno, coberto pelo mesmo modelo de posse fisica de T-01.1-07. |
</threat_model>

<verification>
- `pio run` compila nos dois envs com codigo de saida 0.
- `cadence.cpp` contem exatamente um caminho de rebaixamento para STATIONARY.
- On-hardware: repouso nao gera despertar falso; sacudir gera despertar imediato; parar exige fixes lentos do GPS.
- Remover o MPU6050 nao interrompe o rastreamento GPS nem trava o loop.
</verification>

<success_criteria>
- D-05 observavel: transicao STATIONARY -> MOVING acontece por accel em ~300 ms (3 amostras a 100 ms) em vez de ~3 fixes de GPS, e o rebaixamento continua exclusivo do GPS.
- D-06 observavel: a deteccao vem de polling I2C com limiar e debounce em software; nenhum pino INT e configurado.
- D-07 observavel: nenhum registrador de giroscopio e tocado.
- D-12/D-13 observaveis: acelerometro ausente ou removido degrada apenas o despertar rapido, nada mais.
</success_criteria>

<output>
Create `.planning/phases/01.1-perifericos-i2c-e-display/01.1-02-SUMMARY.md` when done
</output>
