lucianoET/aguada-firmware/.planning/phases/01.1-perifericos-i2c-e-display/01.1-03-PLAN.md

---
phase: 01.1-perifericos-i2c-e-display
plan: 03
type: execute
wave: 3
depends_on: ["01.1-01", "01.1-02"]
files_modified:
  - firmware/gps_tracker/src/mag_sensor.h
  - firmware/gps_tracker/src/mag_sensor.cpp
  - firmware/gps_tracker/src/env_sensor.h
  - firmware/gps_tracker/src/env_sensor.cpp
  - firmware/gps_tracker/src/main.cpp
autonomous: true
requirements: [D-08, D-09, D-10, D-11, D-12, D-13, D-14]

must_haves:
  truths:
    - "O firmware detecta sozinho se o modulo GY-271 em maos e HMC5883L (0x1E) ou QMC5883L (0x0D) e opera com qualquer um dos dois (D-11)"
    - "Parado ou abaixo de DEFAULT_GPS_STATIONARY_KMH o rumo exibido vem da bussola; acima dele vem do course do GPS, e a fonte ativa e identificavel no log (D-08)"
    - "Digitar 'cal' + Enter no serial USB inicia a captura de calibracao hard-iron; digitar 'cal' + Enter de novo grava os offsets em NVS, que sobrevivem a reboot e a regravacao do firmware (D-09)"
    - "A declinacao magnetica e aplicada a partir de DEFAULT_MAG_DECLINATION e sobreponivel por build_flags sem editar codigo (D-10)"
    - "Temperatura e umidade do HTU21D aparecem no log serial de bancada e ficam disponiveis para o display, sem entrar em nenhum log de flash nem payload de rede (D-14)"
    - "Os hotkeys de um caractere existentes (r, h, s, +, -, x, z, b) continuam funcionando exatamente como na Fase 1 apos a adicao do comando multi-caractere"
    - "Bussola ou HTU21D ausentes/removidos degradam apenas seus proprios campos; o rastreamento GPS e a cadencia seguem intactos (D-12/D-13)"
  artifacts:
    - "firmware/gps_tracker/src/mag_sensor.h"
    - "firmware/gps_tracker/src/mag_sensor.cpp"
    - "firmware/gps_tracker/src/env_sensor.h"
    - "firmware/gps_tracker/src/env_sensor.cpp"
    - "calHandleChar() em main.cpp — parser de comando multi-caractere com buffer de tamanho fixo"
  key_links:
    - "mag_sensor::arbitratedHeading() consome DEFAULT_GPS_STATIONARY_KMH (constante ja existente da cadencia) como limiar de D-08 — nao existe segunda constante concorrente"
    - "calHandleChar() e consultado ANTES do encadeamento de hotkeys de um caractere em loop(); qualquer caractere que ele nao consuma cai para o fluxo r/simHandleCommand original"
    - "mag_sensor e env_sensor reportam saude via i2c_bus::reportOk/reportError e se re-inicializam via i2c_bus::reinitDue, sem politica de falha propria"
---

<objective>
Adicionar os dois periféricos I2C baseados em biblioteca: a bussola (HMC5883L ou QMC5883L, auto-detectada) com calibracao hard-iron persistida em NVS e arbitragem de rumo por velocidade, e o sensor de temperatura/umidade HTU21D. Mais o parser de comando serial multi-caractere que D-09 exige.

Purpose: D-08 existe porque o campo `course` do receptor GPS e ruido puro abaixo de ~3 km/h — exatamente a condicao em que um tracker parado precisa mostrar para onde o veiculo esta apontado. D-09 existe porque offsets hard-iron dependem de onde o modulo foi instalado (proximidade de metal, alto-falante, chicote), entao precisam ser recalibraveis em campo sem toolchain. D-11 existe porque a maioria dos GY-271 vendidos hoje traz o chip clone QMC5883L apesar do silk dizer HMC5883L.
Output: `mag_sensor.h`/`.cpp`, `env_sensor.h`/`.cpp`, e em `main.cpp` os timers de poll, o parser `cal` e os campos novos do `[HEALTH]`.
</objective>

<execution_context>
@$HOME/.claude/gsd-core/workflows/execute-plan.md
@$HOME/.claude/gsd-core/templates/summary.md
</execution_context>

<context>
@.planning/PROJECT.md
@.planning/ROADMAP.md
@.planning/STATE.md
@.planning/phases/01.1-perifericos-i2c-e-display/01.1-CONTEXT.md
@.planning/phases/01.1-perifericos-i2c-e-display/01.1-RESEARCH.md
@.planning/phases/01.1-perifericos-i2c-e-display/01.1-PATTERNS.md
@.planning/phases/01.1-perifericos-i2c-e-display/01.1-01-SUMMARY.md
@.planning/phases/01.1-perifericos-i2c-e-display/01.1-02-SUMMARY.md
@firmware/gps_tracker/src/i2c_bus.h
@firmware/gps_tracker/src/main.cpp
@firmware/gps_tracker/include/gps_config.h
@firmware/node/src/ani_sensor.cpp
</context>

## Artifacts this phase produces

Simbolos criados pela Fase 01.1 inteira (todos os planos). Nenhum destes existe no codebase antes desta fase — nao os trate como drift.

**Arquivos novos:** `firmware/gps_tracker/src/i2c_bus.h`, `i2c_bus.cpp`, `accel_sensor.h`, `accel_sensor.cpp`, `mag_sensor.h`, `mag_sensor.cpp`, `env_sensor.h`, `env_sensor.cpp`, `display.h`, `display.cpp`.

**Tipos novos:** `I2cModule` (enum class: DISPLAY, ACCEL, MAG, ENV, COUNT), `AccelReading` (struct), `MagChip` (enum class: NONE, HMC5883L, QMC5883L, VCM5883L), `MagCalibration` (struct), `EnvReading` (struct), `DisplayState` (struct).

**Funcoes novas — namespace `i2c_bus`:** `begin`, `tick`, `present`, `foundCount`, `restoreClock`, `bind`, `boundAddr`, `setOnline`, `online`, `reportOk`, `reportError`, `errorCount`, `offlineEvents`, `reinitDue`, `clearReinit`, `moduleName`.

**Funcoes novas — namespace `accel_sensor`:** `begin`, `poll`, `last`, `wakeEdge`, `magnitudeG`, `debounceStreak`.

**Funcoes novas — namespace `mag_sensor`:** `begin`, `poll`, `chip`, `chipName`, `headingDeg`, `cardinal`, `calStart`, `calFinish`, `calAbort`, `calActive`, `calElapsedS`, `calibration`, `arbitratedHeading`.

**Funcoes novas — namespace `env_sensor`:** `begin`, `poll`, `last`.

**Funcoes novas — namespace `display`:** `begin`, `render`, `addr`.

**Metodo novo em classe existente:** `Cadence::onAccelWake(uint32_t mono_ms)`.

**Funcoes novas em `main.cpp`:** `i2cRecoverTick`, `calHandleChar`, `buildDisplayState`, `speedInDisplayUnit`, `speedUnitLabel`.

**Constantes `DEFAULT_*` novas em `gps_config.h`:** `DEFAULT_I2C_SDA_PIN`, `DEFAULT_I2C_SCL_PIN`, `DEFAULT_I2C_CLOCK_HZ`, `DEFAULT_I2C_ERROR_THRESHOLD`, `DEFAULT_I2C_RETRY_INTERVAL_MS`, `DEFAULT_OLED_ADDR`, `DEFAULT_OLED_ADDR_ALT`, `DEFAULT_ACCEL_ADDR`, `DEFAULT_MAG_ADDR_HMC`, `DEFAULT_MAG_ADDR_QMC`, `DEFAULT_MAG_ADDR_VCM`, `DEFAULT_ENV_ADDR`, `DEFAULT_ACCEL_POLL_MS`, `DEFAULT_ACCEL_WAKE_THRESHOLD_G`, `DEFAULT_ACCEL_WAKE_DEBOUNCE_SAMPLES`, `DEFAULT_MAG_POLL_MS`, `DEFAULT_MAG_DECLINATION`, `DEFAULT_MAG_CAL_TIMEOUT_S`, `DEFAULT_HTU21_POLL_MS`, `DEFAULT_DISPLAY_REFRESH_MS`, `DEFAULT_SPEED_UNIT`.

**Namespace NVS novo:** `magcal` (chaves `xMin`, `xMax`, `yMin`, `yMax`, `set`).

**Dependencias PlatformIO novas:** `olikraus/U8g2`, `dfrobot/DFRobot_QMC5883`, `adafruit/Adafruit HTU21DF Library` (+ transitiva `adafruit/Adafruit BusIO`).

**Comando serial novo:** `cal` (multi-caractere, terminado por Enter).

<tasks>

<task type="auto" tdd="true">
  <name>Task 1: mag_sensor — auto-deteccao HMC/QMC, calibracao hard-iron em NVS e arbitro de rumo</name>
  <files>firmware/gps_tracker/src/mag_sensor.h, firmware/gps_tracker/src/mag_sensor.cpp</files>
  <read_first>
    - `firmware/gps_tracker/src/i2c_bus.h` — `present`, `bind`, `boundAddr`, `setOnline`, `online`, `reportOk`, `reportError`, `restoreClock`, `reinitDue`, `clearReinit`
    - `firmware/gps_tracker/include/gps_config.h` — `DEFAULT_MAG_ADDR_HMC`, `DEFAULT_MAG_ADDR_QMC`, `DEFAULT_MAG_ADDR_VCM`, `DEFAULT_MAG_POLL_MS`, `DEFAULT_MAG_DECLINATION`, `DEFAULT_MAG_CAL_TIMEOUT_S`, e em especial `DEFAULT_GPS_STATIONARY_KMH` (o limiar de D-08, ja existente, que voce deve reusar)
    - `.planning/phases/01.1-perifericos-i2c-e-display/01.1-RESEARCH.md` — Pattern 3 (arbitro de rumo), Pattern 5 (persistencia via Preferences), Code Examples (init dual-chip DFRobot_QMC5883), Anti-Patterns (nao introduzir uma segunda constante de limiar)
    - `firmware/node/src/ani_sensor.cpp` — o padrao de flag de saude e de reafirmar o clock do `Wire`; a espera bloqueante no fim de `ani_read()` e o anti-padrao proibido aqui
    - `.pio/libdeps/esp32-c3-supermini/DFRobot_QMC5883/DFRobot_QMC5883.h` (apos o `pio pkg install` do plano 01) — confirme na fonte instalada os nomes exatos de `begin`, `readRaw`, `getICType`, `isHMC`, `isQMC`, `isVCM`, os campos de `sVector_t` (`XAxis`, `YAxis`, `ZAxis`) e a assinatura do construtor antes de codificar contra eles
  </read_first>
  <behavior>
    - Com um modulo respondendo em 0x1E, `chip()` retorna `MagChip::HMC5883L`; com um respondendo em 0x0D, retorna `MagChip::QMC5883L`; sem modulo, retorna `MagChip::NONE` e `begin()` retorna falso
    - Sem calibracao gravada, `headingDeg()` retorna um angulo em [0, 360) usando offsets zero — funciona, apenas com precisao degradada
    - `calStart()` deixa `calActive()` verdadeiro; cada `poll()` subsequente amplia os minimos/maximos de X e Y; `calFinish()` grava os quatro floats e `calibration().valid` passa a verdadeiro
    - `calFinish()` chamado sem que a amplitude minima de X e Y tenha sido atingida (o usuario nao girou o modulo o suficiente) rejeita a gravacao, mantem a calibracao anterior e reporta o motivo
    - Apos `calFinish()` e um reboot, `calibration()` retorna os mesmos quatro valores gravados
    - `calActive()` volta a falso sozinho apos `DEFAULT_MAG_CAL_TIMEOUT_S` sem `calFinish()`
    - `arbitratedHeading()` com velocidade abaixo de `DEFAULT_GPS_STATIONARY_KMH` devolve o rumo da bussola e sinaliza origem bussola; em velocidade igual ou acima devolve o course do GPS e sinaliza origem GPS
    - `arbitratedHeading()` com a bussola offline sempre devolve o course do GPS; sem fix de GPS e com bussola online sempre devolve o rumo da bussola
  </behavior>
  <action>
Criar `firmware/gps_tracker/src/mag_sensor.h` com `#pragma once`, includes `<stdint.h>`/`<stdbool.h>`, `enum class MagChip : uint8_t { NONE, HMC5883L, QMC5883L, VCM5883L };`, `struct MagCalibration { float xMin; float xMax; float yMin; float yMax; bool valid; };` e um `namespace mag_sensor` declarando: `bool begin();`, `bool poll();`, `MagChip chip();`, `const char *chipName();`, `float headingDeg();`, `const char *cardinal(float deg);`, `void calStart();`, `bool calFinish();`, `void calAbort();`, `bool calActive();`, `uint32_t calElapsedS();`, `MagCalibration calibration();`, `float arbitratedHeading(float gpsSpeedKmh, float gpsCourseDeg, bool haveGpsFix, bool *fromCompass);`.

Criar `firmware/gps_tracker/src/mag_sensor.cpp` com includes `"mag_sensor.h"`, `<Arduino.h>`, `<Wire.h>`, `<math.h>`, `<Preferences.h>`, `<DFRobot_QMC5883.h>`, `"gps_config.h"`, `"i2c_bus.h"`.

Selecao de endereco e deteccao de chip (D-11): em `begin()`, escolher o endereco alvo consultando `i2c_bus::present()` na ordem `DEFAULT_MAG_ADDR_HMC`, depois `DEFAULT_MAG_ADDR_QMC`, depois `DEFAULT_MAG_ADDR_VCM`; se nenhum responder, marcar `MagChip::NONE`, chamar `i2c_bus::setOnline(I2cModule::MAG, false)` e retornar falso. Com um endereco escolhido, instanciar a classe da biblioteca passando `&Wire` e esse endereco. Guardar a instancia em um ponteiro estatico de arquivo alocado uma unica vez; numa re-inicializacao por D-13, reaproveitar a instancia existente chamando de novo o `begin()` dela, e so realocar se o endereco detectado tiver mudado. Apos o `begin()` da biblioteca, chamar `i2c_bus::restoreClock()` — a biblioteca pode ter alterado a velocidade do barramento global (Pitfall 2). Classificar `chip()` a partir dos predicados de tipo de IC que a biblioteca expoe, e registrar `i2c_bus::bind(I2cModule::MAG, addr)` + `i2c_bus::setOnline(I2cModule::MAG, true)`. Imprimir uma linha `[MAG] chip=%s addr=0x%02X` no boot.

Leitura e rumo: `poll()` retorna cedo quando o modulo esta offline, tratando `i2c_bus::reinitDue(I2cModule::MAG)` da mesma forma que o `accel_sensor` do plano 02 (chamar `begin()` e depois `clearReinit`). Quando online, chamar `i2c_bus::restoreClock()` e depois a leitura crua da biblioteca, obtendo os eixos X, Y e Z como inteiros de 16 bits. Calcular o rumo voce mesmo — NAO usar o helper de rumo da biblioteca, porque ele nao aplica os offsets hard-iron de D-09 e porque sua assinatura nao devolve valor. O calculo e: subtrair de X e de Y o ponto medio do respectivo par min/max da calibracao corrente (offsets zero quando nao ha calibracao gravada), aplicar `atan2f` sobre o par corrigido, converter de radianos para graus, somar `DEFAULT_MAG_DECLINATION` (D-10) e normalizar para o intervalo [0, 360). Guardar o resultado para `headingDeg()`. Reportar sucesso ou falha com `i2c_bus::reportOk` / `i2c_bus::reportError`.

D-10 explicitamente NAO inclui compensacao de inclinacao: o calculo usa apenas os eixos X e Y, assumindo montagem plana. Ler o eixo Z apenas para diagnostico; nao usa-lo na trigonometria.

`cardinal(deg)` retorna um dos oito pontos "N", "NE", "E", "SE", "S", "SW", "W", "NW", escolhido por arredondamento de `deg / 45.0f` modulo 8.

Calibracao hard-iron (D-09): `calStart()` zera os acumuladores de minimo/maximo (semeando-os com a proxima amostra em vez de com literais), marca a captura ativa, carimba o instante de inicio e imprime instrucoes de bancada — girar o modulo lentamente por uma volta completa no plano horizontal e depois enviar `cal` de novo para gravar. Enquanto `calActive()`, cada `poll()` amplia os minimos/maximos de X e Y com a amostra crua. `calFinish()` valida que a amplitude capturada em X e em Y ultrapassa um minimo (uma constante local do arquivo, documentada como piso anti-gravacao-degenerada); se nao ultrapassar, imprime o motivo, mantem a calibracao anterior, encerra a captura e retorna falso. Passando na validacao, grava os quatro floats mais uma chave booleana de marcacao no namespace `Preferences` dedicado `"magcal"`, atualiza a calibracao em memoria, imprime os offsets resultantes e retorna verdadeiro. `calAbort()` descarta. `poll()` tambem encerra a captura automaticamente via `calFinish()` quando `calElapsedS()` passa de `DEFAULT_MAG_CAL_TIMEOUT_S`.

`begin()` carrega a calibracao gravada do namespace `"magcal"` em modo somente leitura, usando 0.0f como default para cada float e a chave booleana de marcacao para decidir `MagCalibration::valid`. Abrir e fechar o objeto `Preferences` dentro de cada operacao — uma instancia so mantem um namespace aberto por vez.

`arbitratedHeading(gpsSpeedKmh, gpsCourseDeg, haveGpsFix, fromCompass)` (D-08): quando `i2c_bus::online(I2cModule::MAG)` for falso, devolver `gpsCourseDeg` com `*fromCompass = false`. Quando `haveGpsFix` for falso, devolver `headingDeg()` com `*fromCompass = true`. Caso contrario, devolver `headingDeg()` com `*fromCompass = true` se `gpsSpeedKmh < DEFAULT_GPS_STATIONARY_KMH`, senao `gpsCourseDeg` com `*fromCompass = false`. Usar exclusivamente `DEFAULT_GPS_STATIONARY_KMH` como limiar — o valor 3.0f dessa constante ja existente e literalmente o "~3 km/h" que D-08 especificou, e duplicar isso em uma constante nova cria duas fontes que divergem com o tempo.

Restricao de tempo obrigatoria: nenhuma funcao deste arquivo pode conter espera bloqueante nem sono; uma chamada de `poll()` faz no maximo uma transacao de leitura e retorna.
  </action>
  <verify>
    <automated>/home/luc/Dev/aguada-firmware-main/.venv/bin/pio run -d /home/luc/Dev/aguada-firmware-main/aguada-firmware/firmware/gps_tracker -e esp32-c3-supermini</automated>
    <automated>grep -v '^[[:space:]]*//' firmware/gps_tracker/src/mag_sensor.cpp | grep -c 'delay('</automated>
    <automated>grep -c 'DEFAULT_GPS_STATIONARY_KMH' firmware/gps_tracker/src/mag_sensor.cpp</automated>
    <automated>grep -c 'atan2f\|DEFAULT_MAG_DECLINATION\|magcal\|readRaw' firmware/gps_tracker/src/mag_sensor.cpp</automated>
  </verify>
  <acceptance_criteria>
    - `mag_sensor.h` declara `enum class MagChip` com NONE/HMC5883L/QMC5883L/VCM5883L, `struct MagCalibration` com os 5 campos, e as 13 funcoes do namespace listadas na acao
    - `grep -v '^[[:space:]]*//' firmware/gps_tracker/src/mag_sensor.cpp | grep -c 'delay('` retorna 0 <!-- planner-discipline-allow: delay( -->
    - `grep -c 'DEFAULT_GPS_STATIONARY_KMH' firmware/gps_tracker/src/mag_sensor.cpp` retorna ao menos 1 — o arbitro de D-08 usa a constante de cadencia ja existente
    - `grep -c 'DEFAULT_MAG_DECLINATION' firmware/gps_tracker/src/mag_sensor.cpp` retorna ao menos 1 — D-10 aplicado a partir da build flag
    - `grep -c 'atan2f' firmware/gps_tracker/src/mag_sensor.cpp` retorna ao menos 1 — o rumo e calculado localmente sobre os eixos corrigidos, nao delegado ao helper da biblioteca
    - `grep -c '"magcal"' firmware/gps_tracker/src/mag_sensor.cpp` retorna ao menos 2 (escrita e leitura) — namespace NVS dedicado
    - `grep -c 'i2c_bus::reportError\|i2c_bus::reinitDue' firmware/gps_tracker/src/mag_sensor.cpp` retorna ao menos 2
    - `pio run -e esp32-c3-supermini` termina com codigo de saida 0
  </acceptance_criteria>
  <done>A bussola opera com qualquer um dos dois chips, o rumo respeita calibracao persistida e declinacao, e a fonte do rumo alterna por velocidade usando o limiar de cadencia ja existente.</done>
</task>

<task type="auto" tdd="true">
  <name>Task 2: env_sensor — HTU21D com leitura alternada e fallback de ultimo valor conhecido</name>
  <files>firmware/gps_tracker/src/env_sensor.h, firmware/gps_tracker/src/env_sensor.cpp</files>
  <read_first>
    - `firmware/node/src/ani_sensor.cpp` — o padrao de fallback para ultimo valor conhecido quando a leitura falha (variaveis estaticas de temperatura/umidade), que voce deve reusar; e a espera bloqueante do fim do arquivo, que voce nao deve reusar
    - `firmware/gps_tracker/src/i2c_bus.h` — a API de saude/retry
    - `firmware/gps_tracker/include/gps_config.h` — `DEFAULT_ENV_ADDR`, `DEFAULT_HTU21_POLL_MS`
    - `.planning/phases/01.1-perifericos-i2c-e-display/01.1-RESEARCH.md` — Pitfall 6 (as chamadas de espera internas da biblioteca Adafruit somam ~100 ms por par de leituras) e Pitfall 1 (orçamento vs buffer UART do GPS)
    - `.pio/libdeps/esp32-c3-supermini/Adafruit HTU21DF Library/Adafruit_HTU21DF.h` — confirme na fonte instalada os nomes exatos de `begin`, `readTemperature`, `readHumidity` e o que retornam em caso de falha antes de codificar contra eles
  </read_first>
  <behavior>
    - Com o modulo presente, apos dois ciclos de `poll()` a leitura devolvida por `last()` tem temperatura e umidade plausiveis e `valid` verdadeiro
    - Uma unica leitura falha nao zera os campos exibidos: `last()` continua devolvendo o ultimo par conhecido, apenas com `valid` falso
    - Com o modulo ausente, `begin()` retorna falso e `poll()` nao bloqueia nem trava
    - Cada chamada de `poll()` executa no maximo uma das duas leituras (temperatura ou umidade), alternando entre elas
  </behavior>
  <action>
Criar `firmware/gps_tracker/src/env_sensor.h` com `#pragma once`, includes `<stdint.h>`/`<stdbool.h>`, `struct EnvReading { float temp_c; float hum_pct; bool valid; };` e um `namespace env_sensor` declarando `bool begin();`, `bool poll();`, `EnvReading last();`.

Criar `firmware/gps_tracker/src/env_sensor.cpp` com includes `"env_sensor.h"`, `<Arduino.h>`, `<Wire.h>`, `<math.h>`, `<Adafruit_HTU21DF.h>`, `"gps_config.h"`, `"i2c_bus.h"`.

`begin()`: instanciar o driver Adafruit como objeto estatico de arquivo, chamar o `begin()` dele, e imediatamente depois `i2c_bus::restoreClock()` (Pitfall 2). Registrar o resultado com `i2c_bus::setOnline(I2cModule::ENV, ok)` e, em sucesso, `i2c_bus::bind(I2cModule::ENV, DEFAULT_ENV_ADDR)`.

`poll()`: se offline, tratar `i2c_bus::reinitDue(I2cModule::ENV)` chamando `begin()` e depois `clearReinit`, e retornar. Se online: `i2c_bus::restoreClock()` e entao executar UMA das duas leituras, alternando a cada chamada por meio de um flip-flop estatico — temperatura numa chamada, umidade na seguinte. Esta alternancia e o ponto central desta task: as duas leituras da biblioteca Adafruit bloqueiam cerca de 50 ms cada internamente, e faze-las juntas custaria ~100 ms de uma vez, aproximando-se perigosamente da janela de ~266 ms em que o buffer RX do UART do GPS satura a 9600 baud (Pitfall 1/6). Alternando, o custo maximo por iteracao de `loop()` cai pela metade e um par completo se renova a cada dois intervalos de `DEFAULT_HTU21_POLL_MS`, o que continua muito acima da necessidade de um campo de display de temperatura.

Tratar retorno nao numerico da biblioteca como falha de leitura: nesse caso chamar `i2c_bus::reportError(I2cModule::ENV)`, deixar `valid` falso na leitura corrente e PRESERVAR os ultimos valores validos de temperatura e umidade em variaveis estaticas, para que uma falha transitoria nao apague o campo do display (padrao de fallback do `ani_sensor.cpp`). Em sucesso, atualizar o valor correspondente, chamar `i2c_bus::reportOk(I2cModule::ENV)` e marcar `valid` verdadeiro. `last()` devolve sempre a estrutura com os ultimos valores conhecidos e a flag `valid` da ultima leitura.

Escopo de D-14: este modulo alimenta somente o log serial e o display. Nao ha nenhum ponto de integracao com armazenamento em flash nem com payload de rede nesta fase.

Restricao obrigatoria: nao introduzir nenhuma espera bloqueante propria neste arquivo. O unico bloqueio tolerado e o interno da biblioteca Adafruit, mitigado pela alternancia acima e pelo agendamento de `DEFAULT_HTU21_POLL_MS` que vive em `main.cpp`.
  </action>
  <verify>
    <automated>/home/luc/Dev/aguada-firmware-main/.venv/bin/pio run -d /home/luc/Dev/aguada-firmware-main/aguada-firmware/firmware/gps_tracker -e esp32-c3-supermini</automated>
    <automated>grep -v '^[[:space:]]*//' firmware/gps_tracker/src/env_sensor.cpp | grep -c 'delay('</automated>
    <automated>grep -c 'readTemperature\|readHumidity\|isnan\|i2c_bus::restoreClock' firmware/gps_tracker/src/env_sensor.cpp</automated>
  </verify>
  <acceptance_criteria>
    - `env_sensor.h` declara `struct EnvReading` com `temp_c`, `hum_pct`, `valid`, e as 3 funcoes do namespace
    - `grep -v '^[[:space:]]*//' firmware/gps_tracker/src/env_sensor.cpp | grep -c 'delay('` retorna 0 <!-- planner-discipline-allow: delay( -->
    - `grep -c 'readTemperature' firmware/gps_tracker/src/env_sensor.cpp` retorna 1 e `grep -c 'readHumidity' firmware/gps_tracker/src/env_sensor.cpp` retorna 1 — cada leitura tem um unico ponto de chamada, o que so e possivel com a alternancia especificada
    - `grep -c 'i2c_bus::restoreClock' firmware/gps_tracker/src/env_sensor.cpp` retorna ao menos 2 (apos o begin da biblioteca e antes das leituras)
    - `grep -c 'i2c_bus::reportError\|i2c_bus::reinitDue' firmware/gps_tracker/src/env_sensor.cpp` retorna ao menos 2
    - `pio run -e esp32-c3-supermini` termina com codigo de saida 0
  </acceptance_criteria>
  <done>Temperatura e umidade sao lidas com custo de bloqueio dividido pela metade por chamada, e uma falha transitoria nao apaga os valores exibidos.</done>
</task>

<task type="auto">
  <name>Task 3: main.cpp — timers de mag/env, comando serial 'cal' e campos novos no [HEALTH]</name>
  <files>firmware/gps_tracker/src/main.cpp</files>
  <read_first>
    - `firmware/gps_tracker/src/main.cpp` — o arquivo inteiro: o bloco `if (Serial.available())` de `loop()` com o encadeamento `if (c == 'r') ... else simHandleCommand(c)`, a lista de hotkeys de um caractere em `simHandleCommand()` e `simPrintHelp()`, o `switch` de `i2cRecoverTick()`, o timer de accel adicionado no plano 02, e a string de formato do `[HEALTH]`
    - `firmware/gps_tracker/src/mag_sensor.h` e `firmware/gps_tracker/src/env_sensor.h` — as APIs escritas nas Tasks 1 e 2
    - `firmware/gps_tracker/include/gps_config.h` — `DEFAULT_MAG_POLL_MS`, `DEFAULT_HTU21_POLL_MS`
    - `.planning/phases/01.1-perifericos-i2c-e-display/01.1-RESEARCH.md` — Pitfall 5 (colisao do comando multi-caractere com o dispatch de hotkey de um caractere) e a secao "Security Domain" (V5: buffer de entrada limitado com verificacao de tamanho explicita)
  </read_first>
  <action>
Em `firmware/gps_tracker/src/main.cpp`, adicionar `#include "mag_sensor.h"` e `#include "env_sensor.h"`.

Em `setup()`, chamar `mag_sensor::begin()` e `env_sensor::begin()` depois de `accel_sensor::begin()`, cada um com uma linha de banner reportando presenca (para a bussola, incluir o chip detectado e o endereco).

Adicionar `static uint32_t lastMagPollMs = 0;` e `static uint32_t lastEnvPollMs = 0;` junto aos estaticos existentes. Em `loop()`, adicionar dois blocos guardados por `millis() - lastMagPollMs >= DEFAULT_MAG_POLL_MS` e `millis() - lastEnvPollMs >= DEFAULT_HTU21_POLL_MS`, cada um atualizando seu carimbo e chamando `mag_sensor::poll()` / `env_sensor::poll()`. Posiciona-los junto ao bloco de accel do plano 02, depois do passe do pipeline GPS. Os dois blocos sao independentes e podem coincidir na mesma iteracao; isso e aceitavel porque o custo de bloqueio combinado (uma leitura de bussola sub-milissegundo mais uma unica leitura alternada do HTU21D de ~50 ms) fica dentro do orçamento de ~266 ms do buffer UART do GPS.

Implementar o parser de comando multi-caractere como uma funcao estatica nomeada `static bool calHandleChar(char c)` acima de `loop()`, com estado de arquivo: um buffer de caracteres de tamanho fixo pequeno (8 bytes), um contador de comprimento, e o carimbo de tempo do ultimo caractere. Contrato de retorno: verdadeiro quando o caractere foi consumido pelo parser multi-caractere e NAO deve seguir para o dispatch de um caractere; falso quando deve seguir.

Comportamento do parser:
1. Se ha caracteres acumulados e o intervalo desde o ultimo caractere excedeu um limite de inatividade (constante local de arquivo, 3000 ms), descartar o acumulado antes de processar o novo caractere — teclas digitadas em momentos distintos nao se juntam num comando falso.
2. Se o caractere for terminador de linha (retorno de carro ou nova linha), comparar o acumulado com o literal `cal`; se casar, alternar o estado de calibracao — quando `mag_sensor::calActive()` for verdadeiro chamar `mag_sensor::calFinish()`, senao `mag_sensor::calStart()`. Zerar o acumulado e retornar verdadeiro em qualquer caso, para que Enter nunca vaze para o dispatch de hotkey.
3. Caso contrario, verificar ANTES de qualquer escrita que ainda ha espaco no buffer reservando o terminador nulo; se nao houver, descartar o acumulado e retornar falso. Esta verificacao de limite explicita antes da escrita e o controle de validacao de entrada exigido pela avaliacao ASVS V5 deste plano (ameaca T-01.1-01) — o buffer nunca pode ser escrito alem do tamanho declarado, seja qual for a entrada.
4. Anexar o caractere ao acumulado e verificar se o acumulado ainda e um prefixo do literal `cal`. Se for, atualizar o carimbo de tempo e retornar verdadeiro. Se nao for, descartar o acumulado e retornar falso, deixando o caractere seguir para o fluxo original.

No bloco `if (Serial.available())` de `loop()`, consultar `calHandleChar(c)` PRIMEIRO; somente quando ele retornar falso e que o encadeamento existente `if (c == 'r') { ... } else { simHandleCommand(c); }` roda, inalterado. Os hotkeys `r`, `h`, `s`, `+`, `-`, `x`, `z`, `b` nao comecam com `c` e portanto nunca sao capturados pelo parser.

Acrescentar a `simPrintHelp()` uma linha descrevendo o comando `cal` (digitar cal e Enter para iniciar a captura, girar o modulo lentamente uma volta completa no plano horizontal, digitar cal e Enter de novo para gravar em NVS). Manter todas as linhas de ajuda existentes.

No `switch` de `i2cRecoverTick()`, inserir `mag_sensor::begin()` no case `I2cModule::MAG` e `env_sensor::begin()` no case `I2cModule::ENV`, antes do `setOnline` generico, pelo mesmo motivo do plano 02.

Estender a string de formato do `[HEALTH]` com ` hdg=%.0f hdg_src=%s mag_chip=%s temp=%.1fC hum=%.0f%%`. O rumo e a origem vem de `mag_sensor::arbitratedHeading()` alimentado com `lastFix.speed_kmh`, `lastFix.course_deg` e o estado `everAccepted` como indicador de fix disponivel; a origem imprime "mag" ou "gps" conforme a flag devolvida. Temperatura e umidade vem de `env_sensor::last()`. Preservar todos os campos existentes da linha, incluindo os adicionados nos planos 01 e 02, sem remover, renomear nem reordenar nenhum.

Enquanto `mag_sensor::calActive()` for verdadeiro, imprimir uma linha `[CAL] active %lus x=[%.0f..%.0f] y=[%.0f..%.0f]` no mesmo timer do `[HEALTH]`, para que o operador de bancada veja a captura progredindo enquanto gira o modulo.
  </action>
  <verify>
    <automated>/home/luc/Dev/aguada-firmware-main/.venv/bin/pio run -d /home/luc/Dev/aguada-firmware-main/aguada-firmware/firmware/gps_tracker -e esp32-c3-supermini</automated>
    <automated>/home/luc/Dev/aguada-firmware-main/.venv/bin/pio run -d /home/luc/Dev/aguada-firmware-main/aguada-firmware/firmware/gps_tracker -e esp32-devkit</automated>
    <automated>grep -c 'calHandleChar' firmware/gps_tracker/src/main.cpp</automated>
    <automated>grep -c 'DEFAULT_MAG_POLL_MS\|DEFAULT_HTU21_POLL_MS\|mag_sensor::calStart\|mag_sensor::calFinish\|arbitratedHeading' firmware/gps_tracker/src/main.cpp</automated>
    <human-check>Confirmar no boot serial qual chip de bussola foi detectado: a linha `[MAG] chip=..` deve dizer HMC5883L (addr 0x1E) ou QMC5883L (addr 0x0D). Este e o fechamento da Open Question 1 do RESEARCH.md e a validacao de campo que encerra o risco de staleness da biblioteca `dfrobot/DFRobot_QMC5883` (sem release desde 2022, ameaca T-01.1-SC): se o chip nao for detectado ou o rumo nao variar ao girar o modulo, a biblioteca precisa ser trocada pelos drivers mono-chip listados em "Alternatives Considered" do RESEARCH.md antes de seguir para o plano 04.</human-check>
    <human-check>Girar a placa lentamente e confirmar no `[HEALTH]` que `hdg=` acompanha a rotacao de forma monotonica ao longo de uma volta completa (sem saltos de 180 graus nem travar num valor).</human-check>
    <human-check>Executar a calibracao de D-09: digitar `cal` + Enter no monitor serial, confirmar que aparecem instrucoes e que as linhas `[CAL] active` mostram as faixas de X e Y se ampliando enquanto o modulo gira uma volta completa; digitar `cal` + Enter de novo e confirmar que os offsets sao impressos e gravados. Resetar a placa e confirmar que os mesmos offsets sao carregados no boot. Repetir o `cal` girando o modulo apenas alguns graus e confirmar que a gravacao e recusada com motivo, mantendo a calibracao anterior.</human-check>
    <human-check>Confirmar que os hotkeys da Fase 1 continuam intactos apos a adicao do parser: pressionar `h` (imprime o bloco HELP, agora incluindo a linha do cal), `r` (alterna o eco de NMEA cru), `s` (liga o simulador), `+`/`-` (ajustam a velocidade simulada), `x`/`z`/`b` (injetam as tres rejeicoes). Nenhum deles pode ficar mudo ou exigir Enter.</human-check>
    <human-check>Validar D-08 com o simulador: com o simulador ligado e velocidade em 0 km/h, confirmar `hdg_src=mag`; subir a velocidade com `+` acima de 3 km/h e confirmar que muda para `hdg_src=gps`; baixar de novo e confirmar o retorno para `mag`.</human-check>
    <human-check>Confirmar D-14: `temp=` e `hum=` aparecem com valores plausiveis no `[HEALTH]`. Cobrir/aquecer levemente o sensor e confirmar que os valores respondem. Desconectar o HTU21D e confirmar que `env=off` aparece, os ultimos valores permanecem exibidos em vez de zerar, e o pipeline GPS segue normal.</human-check>
    <human-check>Confirmar Pitfall 1 na pratica: com os 4 modulos ligados e um fix real de GPS ativo, observar o `[HEALTH]` por ~5 minutos e verificar que os contadores `bad=` (checksum NMEA) e `stale=` NAO crescem em relacao ao comportamento da Fase 1. Crescimento nesses contadores apos a entrada dos periféricos e o sinal de que o orçamento de bloqueio I2C estourou e que `DEFAULT_HTU21_POLL_MS` precisa subir.</human-check>
  </verify>
  <acceptance_criteria>
    - `grep -c 'calHandleChar' firmware/gps_tracker/src/main.cpp` retorna ao menos 2 (definicao + consulta em `loop()`), e a consulta em `loop()` ocorre antes do teste `c == 'r'`
    - `grep -c "if (c == 'r')" firmware/gps_tracker/src/main.cpp` retorna 1 — o encadeamento de hotkeys de um caractere da Fase 1 esta preservado, nao reescrito
    - `grep -c 'simHandleCommand(c)' firmware/gps_tracker/src/main.cpp` retorna 1 — o fallback para o dispatch de um caractere continua existindo
    - O corpo de `calHandleChar` contem uma verificacao de limite do buffer antes de qualquer escrita nele (controle ASVS V5 para T-01.1-01)
    - `grep -c 'mag_sensor::poll' firmware/gps_tracker/src/main.cpp` retorna 1, dentro de um guarda `DEFAULT_MAG_POLL_MS`; `grep -c 'env_sensor::poll' firmware/gps_tracker/src/main.cpp` retorna 1, dentro de um guarda `DEFAULT_HTU21_POLL_MS`
    - `grep -c 'mag_sensor::begin' firmware/gps_tracker/src/main.cpp` retorna 2 e `grep -c 'env_sensor::begin' firmware/gps_tracker/src/main.cpp` retorna 2 (`setup()` + case de recuperacao)
    - A string de formato do `[HEALTH]` contem `hdg=%.0f`, `hdg_src=%s`, `temp=%.1fC`, `hum=%.0f%%`, e ainda contem `accel_g=%.2f` e `disp=%s accel=%s mag=%s env=%s` dos planos anteriores
    - `pio run` termina com codigo 0 nos dois envs
    - Comportamento on-hardware: `cal` + Enter alterna captura/gravacao; os 8 hotkeys da Fase 1 seguem respondendo a um unico caractere sem Enter
  </acceptance_criteria>
  <done>Rumo, calibracao persistente e temperatura/umidade sao observaveis no serial de bancada, e o protocolo de hotkeys da Fase 1 continua intacto ao lado do novo comando multi-caractere.</done>
</task>

</tasks>

<threat_model>
## Trust Boundaries

| Boundary | Description |
|---|---|
| USB serial -> parser de comando | Primeira entrada multi-caractere de comprimento variavel aceita por este firmware; ate agora so havia dispatch de um caractere sem estado acumulado |
| barramento I2C -> firmware | Bussola e HTU21D acionados por bibliotecas de terceiros que podem alterar a velocidade do barramento global e bloquear internamente |
| NVS (particao `magcal`) -> calculo de rumo | Valores persistidos entre boots alimentam diretamente a trigonometria do rumo exibido |

## STRIDE Threat Register

| Threat ID | Category | Component | Severity | Disposition | Mitigation Plan |
|---|---|---|---|---|---|
| T-01.1-01 | Tampering / Denial of Service | `calHandleChar()` em `main.cpp` | medium | mitigate | Buffer de tamanho fixo (8 bytes) com verificacao de limite explicita antes de cada escrita, reservando o terminador nulo; entrada que estouraria o buffer e descartada com reset do acumulado em vez de escrita fora de limite. Reset por inatividade de 3000 ms impede que fragmentos de digitacao distantes formem um comando nao pretendido. Controle ASVS V5 conforme a secao "Security Domain" do RESEARCH.md. |
| T-01.1-05 | Tampering | offsets de calibracao em NVS -> `mag_sensor::headingDeg()` | low | mitigate | Namespace `Preferences` dedicado (`magcal`), distinto de qualquer outro uso de NVS no repo, evitando colisao de chaves. `calFinish()` recusa gravar uma calibracao degenerada (amplitude insuficiente em X ou Y), o que impede que uma captura abortada substitua offsets bons por lixo. Sem calibracao valida o modulo opera com offsets zero em vez de valores indefinidos. |
| T-01.1-03 | Denial of Service | leituras do HTU21D vs buffer RX do UART do GPS | high | mitigate | Leitura alternada (temperatura numa chamada, umidade na seguinte) reduz o bloqueio interno da biblioteca de ~100 ms para ~50 ms por iteracao de `loop()`, contra a janela de ~266 ms de saturacao do buffer a 9600 baud; agendamento de `DEFAULT_HTU21_POLL_MS` = 4000 ms, sobreponivel por `build_flags`. Verificacao on-hardware explicita observa os contadores `bad=`/`stale=` do `[HEALTH]` por 5 minutos com todos os periféricos ativos. |
| T-01.1-09 | Tampering | biblioteca de terceiros alterando `Wire.setClock()` global | medium | mitigate | `i2c_bus::restoreClock()` reafirma `DEFAULT_I2C_CLOCK_HZ` apos cada `.begin()` de biblioteca e antes de cada leitura, replicando o padrao ja comprovado em `firmware/node/src/ani_sensor.cpp` (Pitfall 2). |
| T-01.1-SC | Tampering | `dfrobot/DFRobot_QMC5883` sem release desde 2022 | medium | mitigate | Versao fixada por semver; auditoria de legitimidade registrada no RESEARCH.md contra o registro PlatformIO e fetch direto do fonte no GitHub (organizacao oficial DFRobot, SKU correspondente). A verificacao on-hardware desta task — deteccao correta do chip e rumo variando de forma monotonica numa volta completa — e o gate que confirma a biblioteca antes que o plano 04 dependa dela; havendo falha, os drivers mono-chip de "Alternatives Considered" sao o caminho de saida documentado. |
| T-01.1-10 | Information Disclosure | posicao e rumo impressos no serial USB | low | accept | O log de bancada ja imprime latitude e longitude desde a Fase 1 e o dispositivo nao tem pilha de rede nesta milestone; posse fisica do cabo USB e o modelo de controle de acesso, proporcional ao nivel ASVS 1 para um prototipo offline. |
</threat_model>

<verification>
- `pio run` compila nos dois envs com codigo de saida 0.
- O chip de bussola efetivamente presente e detectado e reportado no boot.
- `cal` + Enter alterna captura e gravacao; os offsets sobrevivem a reboot; captura degenerada e recusada.
- Os 8 hotkeys de um caractere da Fase 1 seguem funcionando sem Enter.
- A fonte do rumo alterna em `DEFAULT_GPS_STATIONARY_KMH` e e visivel no `[HEALTH]`.
- Os contadores `bad=`/`stale=` do `[HEALTH]` nao crescem com os 4 periféricos ativos.
</verification>

<success_criteria>
- D-08 observavel: `hdg_src` alterna entre mag e gps no limiar de 3 km/h.
- D-09 observavel: calibracao por comando serial persiste em NVS e sobrevive a reboot e regravacao.
- D-10 observavel: declinacao aplicada a partir de `DEFAULT_MAG_DECLINATION`; nenhuma compensacao de inclinacao presente.
- D-11 observavel: HMC5883L e QMC5883L funcionam sem recompilar.
- D-14 observavel: temperatura e umidade no serial de bancada, sem integracao com flash ou rede.
- D-12/D-13 observaveis: bussola ou HTU21D ausentes ou removidos nao afetam o rastreamento GPS.
</success_criteria>

<output>
Create `.planning/phases/01.1-perifericos-i2c-e-display/01.1-03-SUMMARY.md` when done
</output>
