lucianoET/aguada-firmware/.planning/phases/01.1-perifericos-i2c-e-display/01.1-04-PLAN.md

---
phase: 01.1-perifericos-i2c-e-display
plan: 04
type: execute
wave: 4
depends_on: ["01.1-01", "01.1-02", "01.1-03"]
files_modified:
  - firmware/gps_tracker/src/gps_reader.h
  - firmware/gps_tracker/src/gps_reader.cpp
  - firmware/gps_tracker/src/display.h
  - firmware/gps_tracker/src/display.cpp
  - firmware/gps_tracker/src/main.cpp
  - firmware/gps_tracker/BENCH.md
  - firmware/gps_tracker/gps_tracker_pinout.md
autonomous: true
requirements: [D-01, D-02, D-03, D-04, D-12, D-13]

must_haves:
  truths:
    - "Uma unica tela densa do OLED mostra simultaneamente estado do fix/sats/HDOP, velocidade, rumo com cardinal, temperatura/umidade e o estado da cadencia — sem paginacao e sem botao (D-01)"
    - "A tela atualiza a 1 Hz e o quadro renderizado reflete o fix daquela iteracao, nao um estado meio processado (D-02)"
    - "Sem fix, o OLED mostra uma tela de aquisicao ao vivo com NO FIX, satelites em vista, uptime e as leituras dos sensores que ja estao vivos, servindo para conferir a fiacao enquanto o receptor procura sinal (D-03)"
    - "A unidade de velocidade e selecionavel por build flag entre km/h e nos, sem editar codigo (D-04)"
    - "O rumo aparece em graus mais o ponto cardinal (D-04)"
    - "Modulos ausentes ou offline aparecem marcados na propria tela, e um OLED ausente nao impede nada do restante de funcionar (D-12/D-13)"
  artifacts:
    - "firmware/gps_tracker/src/display.h com o struct DisplayState"
    - "firmware/gps_tracker/src/display.cpp"
    - "GpsReader::satsInView() em gps_reader.h/.cpp"
    - "firmware/gps_tracker/BENCH.md com a secao de procedimento de bancada da Fase 01.1"
  key_links:
    - "main.cpp monta um DisplayState por quadro a partir de lastFix, cadence.state(), mag_sensor::arbitratedHeading(), env_sensor::last(), accel_sensor e i2c_bus::online — display.cpp nao consulta nenhum modulo diretamente"
    - "O bloco de render roda depois do passe do pipeline GPS e depois dos polls de periférico na mesma iteracao de loop(), o que e o que torna o quadro alinhado ao fix (D-02)"
    - "display::begin() escolhe o endereco entre DEFAULT_OLED_ADDR e DEFAULT_OLED_ADDR_ALT conforme o scan de boot do i2c_bus"
---

<objective>
Fechar a Fase 01.1 com a camada de apresentacao: a tela densa unica do OLED SSD1306 que torna tudo o que os planos 01 a 03 construiram observavel sem monitor serial, a tela de aquisicao para o periodo sem fix, e a documentacao de bancada que descreve como validar a fase inteira.

Purpose: D-01 a D-04 existem porque o tracker vai para dentro de um veiculo/embarcacao onde nao ha notebook plugado. A tela e a unica interface de diagnostico em campo — precisa mostrar tudo de uma vez, inclusive durante o cold start, quando a duvida do operador e justamente "a fiacao esta certa?".
Output: `display.h`/`.cpp`, `GpsReader::satsInView()`, a montagem de estado e o render em `main.cpp`, e as secoes de Fase 01.1 em `BENCH.md` e `gps_tracker_pinout.md`.
</objective>

<execution_context>
@$HOME/.claude/gsd-core/workflows/execute-plan.md
@$HOME/.claude/gsd-core/templates/summary.md
</execution_context>

<context>
@.planning/PROJECT.md
@.planning/ROADMAP.md
@.planning/STATE.md
@.planning/phases/01.1-perifericos-i2c-e-display/01.1-CONTEXT.md
@.planning/phases/01.1-perifericos-i2c-e-display/01.1-RESEARCH.md
@.planning/phases/01.1-perifericos-i2c-e-display/01.1-PATTERNS.md
@.planning/phases/01.1-perifericos-i2c-e-display/01.1-01-SUMMARY.md
@.planning/phases/01.1-perifericos-i2c-e-display/01.1-02-SUMMARY.md
@.planning/phases/01.1-perifericos-i2c-e-display/01.1-03-SUMMARY.md
@firmware/gps_tracker/src/i2c_bus.h
@firmware/gps_tracker/src/accel_sensor.h
@firmware/gps_tracker/src/mag_sensor.h
@firmware/gps_tracker/src/env_sensor.h
@firmware/gps_tracker/src/main.cpp
@firmware/gps_tracker/include/gps_config.h
@firmware/gps_tracker/BENCH.md
</context>

## Artifacts this phase produces

Simbolos criados pela Fase 01.1 inteira (todos os planos). Nenhum destes existe no codebase antes desta fase — nao os trate como drift.

**Arquivos novos:** `firmware/gps_tracker/src/i2c_bus.h`, `i2c_bus.cpp`, `accel_sensor.h`, `accel_sensor.cpp`, `mag_sensor.h`, `mag_sensor.cpp`, `env_sensor.h`, `env_sensor.cpp`, `display.h`, `display.cpp`.

**Tipos novos:** `I2cModule` (enum class: DISPLAY, ACCEL, MAG, ENV, COUNT), `AccelReading` (struct), `MagChip` (enum class: NONE, HMC5883L, QMC5883L, VCM5883L), `MagCalibration` (struct), `EnvReading` (struct), `DisplayState` (struct).

**Funcoes novas — namespace `i2c_bus`:** `begin`, `tick`, `present`, `foundCount`, `restoreClock`, `bind`, `boundAddr`, `setOnline`, `online`, `reportOk`, `reportError`, `errorCount`, `offlineEvents`, `reinitDue`, `clearReinit`, `moduleName`.

**Funcoes novas — namespace `accel_sensor`:** `begin`, `poll`, `last`, `wakeEdge`, `magnitudeG`, `debounceStreak`.

**Funcoes novas — namespace `mag_sensor`:** `begin`, `poll`, `chip`, `chipName`, `headingDeg`, `cardinal`, `calStart`, `calFinish`, `calAbort`, `calActive`, `calElapsedS`, `calibration`, `arbitratedHeading`.

**Funcoes novas — namespace `env_sensor`:** `begin`, `poll`, `last`.

**Funcoes novas — namespace `display`:** `begin`, `render`, `addr`.

**Metodo novo em classe existente:** `Cadence::onAccelWake(uint32_t mono_ms)`, `GpsReader::satsInView()`.

**Funcoes novas em `main.cpp`:** `i2cRecoverTick`, `calHandleChar`, `buildDisplayState`, `speedInDisplayUnit`, `speedUnitLabel`.

**Constantes `DEFAULT_*` novas em `gps_config.h`:** `DEFAULT_I2C_SDA_PIN`, `DEFAULT_I2C_SCL_PIN`, `DEFAULT_I2C_CLOCK_HZ`, `DEFAULT_I2C_ERROR_THRESHOLD`, `DEFAULT_I2C_RETRY_INTERVAL_MS`, `DEFAULT_OLED_ADDR`, `DEFAULT_OLED_ADDR_ALT`, `DEFAULT_ACCEL_ADDR`, `DEFAULT_MAG_ADDR_HMC`, `DEFAULT_MAG_ADDR_QMC`, `DEFAULT_MAG_ADDR_VCM`, `DEFAULT_ENV_ADDR`, `DEFAULT_ACCEL_POLL_MS`, `DEFAULT_ACCEL_WAKE_THRESHOLD_G`, `DEFAULT_ACCEL_WAKE_DEBOUNCE_SAMPLES`, `DEFAULT_MAG_POLL_MS`, `DEFAULT_MAG_DECLINATION`, `DEFAULT_MAG_CAL_TIMEOUT_S`, `DEFAULT_HTU21_POLL_MS`, `DEFAULT_DISPLAY_REFRESH_MS`, `DEFAULT_SPEED_UNIT`.

**Namespace NVS novo:** `magcal` (chaves `xMin`, `xMax`, `yMin`, `yMax`, `set`).

**Dependencias PlatformIO novas:** `olikraus/U8g2`, `dfrobot/DFRobot_QMC5883`, `adafruit/Adafruit HTU21DF Library` (+ transitiva `adafruit/Adafruit BusIO`).

**Comando serial novo:** `cal` (multi-caractere, terminado por Enter).

<tasks>

<task type="auto">
  <name>Task 1: satelites em vista no GpsReader e o modulo display com as duas telas</name>
  <files>firmware/gps_tracker/src/gps_reader.h, firmware/gps_tracker/src/gps_reader.cpp, firmware/gps_tracker/src/display.h, firmware/gps_tracker/src/display.cpp</files>
  <read_first>
    - `firmware/gps_tracker/src/gps_reader.h` — o comentario de propriedade exclusiva do parser TinyGPSPlus e do UART (que e exatamente por que o acessor de satelites em vista pertence a esta classe), e os acessores existentes `bytesRead`, `passedChecksum`, `failedChecksum`, `receiving`
    - `firmware/gps_tracker/src/gps_reader.cpp` — como `poll()` drena os bytes para o parser e como os acessores de checksum sao implementados, para seguir a mesma forma
    - `firmware/gps_tracker/include/gps_types.h` — a struct `Fix` completa (nomes exatos dos campos: `lat`, `lon`, `speed_kmh`, `course_deg`, `alt_m`, `hdop`, `sats`, `fix_quality`, `utc_unix`, `age_ms`, `mono_ms`) e o enum `CadenceState`
    - `firmware/gps_tracker/src/accel_sensor.h`, `mag_sensor.h`, `env_sensor.h`, `i2c_bus.h` — os tipos e valores que o `DisplayState` vai carregar
    - `firmware/gps_tracker/include/gps_config.h` — `DEFAULT_OLED_ADDR`, `DEFAULT_OLED_ADDR_ALT`, `DEFAULT_I2C_CLOCK_HZ`, `DEFAULT_DISPLAY_REFRESH_MS`, `DEFAULT_SPEED_UNIT`
    - `.planning/phases/01.1-perifericos-i2c-e-display/01.1-RESEARCH.md` — Standard Stack (por que U8g2 full-buffer com I2C por hardware, e o custo aproximado de ~25 ms por transferencia de quadro a 400 kHz)
  </read_first>
  <action>
Em `firmware/gps_tracker/src/gps_reader.h` e `.cpp`, adicionar um acessor `uint8_t satsInView() const;`. Implementa-lo com `TinyGPSCustom` sobre o campo 3 (total de satelites em vista) das sentencas GSV, registrando um objeto para cada um dos identificadores de talker `GPGSV`, `GLGSV` e `GNGSV`, de modo a cobrir os dois modulos suportados pelo projeto (NEO-6M u-blox e ATGM336H GPS+BeiDou). O acessor devolve o maior valor entre os objetos cuja idade esteja dentro de `DEFAULT_GPS_FRESH_MS`, e 0 quando nenhum estiver fresco. Este e o unico ponto do firmware autorizado a tocar o parser, coerente com o comentario de propriedade exclusiva ja presente no header — nenhum outro modulo pode instanciar `TinyGPSCustom`. Nao alterar `poll()`, a struct `Fix`, nem qualquer acessor existente.

Criar `firmware/gps_tracker/src/display.h` com `#pragma once`, includes `<stdint.h>`/`<stdbool.h>` e `"gps_types.h"`, mais a struct de quadro:

`struct DisplayState` com os campos `bool have_fix;` `uint8_t sats_used;` `uint8_t sats_in_view;` `float hdop;` `float speed_display;` `const char *speed_unit;` `float heading_deg;` `const char *heading_cardinal;` `bool heading_from_compass;` `float temp_c;` `float hum_pct;` `bool env_valid;` `float accel_g;` `bool cadence_moving;` `bool receiving_nmea;` `uint32_t uptime_s;` `bool accel_online;` `bool mag_online;` `bool env_online;`.

E um `namespace display` declarando `bool begin();`, `void render(const DisplayState &s);`, `uint8_t addr();`.

Criar `firmware/gps_tracker/src/display.cpp` com includes `"display.h"`, `<Arduino.h>`, `<Wire.h>`, `<U8g2lib.h>`, `"gps_config.h"`, `"i2c_bus.h"`.

`begin()`: escolher o endereco consultando `i2c_bus::present()` primeiro em `DEFAULT_OLED_ADDR` e depois em `DEFAULT_OLED_ADDR_ALT`; sem nenhum dos dois, chamar `i2c_bus::setOnline(I2cModule::DISPLAY, false)` e retornar falso sem tentar inicializar a biblioteca. Com endereco escolhido, usar o construtor U8g2 de buffer completo com I2C por hardware para SSD1306 128x64, informar a velocidade de barramento a partir de `DEFAULT_I2C_CLOCK_HZ` e o endereco na forma de 8 bits que a biblioteca espera (o endereco de 7 bits deslocado uma posicao a esquerda), chamar o `begin()` da biblioteca e imediatamente depois `i2c_bus::restoreClock()` (Pitfall 2 — a biblioteca ajusta a velocidade do barramento global). Registrar `i2c_bus::bind(I2cModule::DISPLAY, addr)` e `i2c_bus::setOnline(I2cModule::DISPLAY, true)`. Guardar o endereco para `addr()`.

`render(const DisplayState &s)`: retornar imediatamente quando `i2c_bus::online(I2cModule::DISPLAY)` for falso, tratando `i2c_bus::reinitDue(I2cModule::DISPLAY)` da mesma forma que os drivers dos planos 02 e 03 (chamar `begin()` e depois `clearReinit`). Caso online: `i2c_bus::restoreClock()`, limpar o buffer, desenhar o quadro e enviar o buffer numa unica transferencia. Este modulo nao consulta nenhum outro modulo do firmware — todo dado vem do `DisplayState` recebido; isso mantem a camada de apresentacao sem acoplamento com os drivers e e o que permite testar o layout com estados sinteticos.

Conteudo do quadro quando `have_fix` e verdadeiro (D-01: tudo visivel de uma vez, sem paginacao, sem botao — as seis faixas abaixo devem caber nas 64 linhas):
1. Estado do fix com satelites usados e HDOP.
2. Velocidade em fonte destacada, com o rotulo de unidade vindo de `speed_unit` (D-04).
3. Rumo em graus inteiros seguido do ponto cardinal de `heading_cardinal`, mais um marcador curto da fonte ativa derivado de `heading_from_compass` (D-04/D-08).
4. Temperatura em graus Celsius e umidade relativa em porcentagem; quando `env_valid` for falso, marcar o valor como ultimo conhecido em vez de apagar o campo (D-14).
5. Estado da cadencia como MOVING ou STOPPED, mais a magnitude de aceleracao corrente.
6. Uptime formatado como horas:minutos:segundos e os marcadores de modulo offline.

Marcadores de modulo offline (D-12/D-13): reservar a extremidade direita da ultima faixa para uma sequencia compacta de letras iniciais dos modulos — uma letra para accel, uma para bussola, uma para ambiente — exibindo a letra apenas quando o respectivo campo `*_online` do `DisplayState` for falso. Com todos online a area fica vazia; com um modulo caido a sua letra aparece, o que responde na propria tela a pergunta "por que esse campo nao muda?" sem monitor serial.

Conteudo do quadro quando `have_fix` e falso (D-03: tela de aquisicao ao vivo): substituir as faixas 1 e 2 por um aviso de ausencia de fix, o numero de satelites em vista de `sats_in_view`, um indicador de recepcao de NMEA derivado de `receiving_nmea` (que distingue "antena vendo pouco ceu" de "UART sem dados nenhum", ou seja, problema de fiacao) e o uptime. As faixas 3, 4 e 5 continuam mostrando rumo, temperatura/umidade e aceleracao exatamente como na tela com fix — a razao de existir desta tela e justamente confirmar que os sensores que ja funcionam estao vivos enquanto o receptor ainda procura sinal.

Escolha de fontes e coordenadas exatas fica a seu criterio (o CONTEXT.md marca o layout como discricionario): use uma fonte compacta para as faixas de texto e uma maior para o numero da velocidade, e verifique que todas as faixas cabem nas 64 linhas sem sobreposicao.

Restricao de tempo: `render()` faz no maximo uma transferencia de quadro por chamada e nao contem espera bloqueante propria. A transferencia do buffer completo de 1024 bytes custa cerca de 25 ms a 400 kHz, evento unico dentro da janela de ~266 ms do buffer UART do GPS; o agendamento de `DEFAULT_DISPLAY_REFRESH_MS` que garante uma unica chamada por segundo vive em `main.cpp` (Task 2), nao aqui.
  </action>
  <verify>
    <automated>/home/luc/Dev/aguada-firmware-main/.venv/bin/pio run -d /home/luc/Dev/aguada-firmware-main/aguada-firmware/firmware/gps_tracker -e esp32-c3-supermini</automated>
    <automated>grep -v '^[[:space:]]*//' firmware/gps_tracker/src/display.cpp | grep -c 'delay('</automated>
    <automated>grep -c 'satsInView' firmware/gps_tracker/src/gps_reader.h firmware/gps_tracker/src/gps_reader.cpp</automated>
    <automated>grep -c 'clearBuffer\|sendBuffer\|i2c_bus::restoreClock\|i2c_bus::reinitDue' firmware/gps_tracker/src/display.cpp</automated>
  </verify>
  <acceptance_criteria>
    - `gps_reader.h` declara `uint8_t satsInView() const;` e `gps_reader.cpp` registra objetos `TinyGPSCustom` para os talkers GPGSV, GLGSV e GNGSV
    - `grep -c 'TinyGPSCustom' firmware/gps_tracker/src/display.cpp firmware/gps_tracker/src/main.cpp` retorna 0 — a propriedade exclusiva do parser por `GpsReader` esta preservada
    - `display.h` declara `struct DisplayState` com os 19 campos listados na acao e as 3 funcoes do namespace `display`
    - `grep -c 'accel_sensor::\|mag_sensor::\|env_sensor::' firmware/gps_tracker/src/display.cpp` retorna 0 — a camada de apresentacao recebe estado pronto e nao consulta drivers
    - `grep -v '^[[:space:]]*//' firmware/gps_tracker/src/display.cpp | grep -c 'delay('` retorna 0 <!-- planner-discipline-allow: delay( -->
    - `grep -c 'sendBuffer' firmware/gps_tracker/src/display.cpp` retorna 1 — uma unica transferencia de quadro por chamada de `render()`
    - `grep -c 'DEFAULT_OLED_ADDR_ALT' firmware/gps_tracker/src/display.cpp` retorna ao menos 1 — o fallback de endereco 0x3D esta implementado
    - `pio run -e esp32-c3-supermini` termina com codigo de saida 0
  </acceptance_criteria>
  <done>O modulo de display renderiza as duas telas a partir de um estado puro, e o GpsReader passa a expor satelites em vista para a tela de aquisicao.</done>
</task>

<task type="auto">
  <name>Task 2: main.cpp — montagem do DisplayState, unidade de velocidade e render alinhado ao fix</name>
  <files>firmware/gps_tracker/src/main.cpp</files>
  <read_first>
    - `firmware/gps_tracker/src/main.cpp` — o arquivo inteiro: os estaticos `lastFix`, `everAccepted`, `lastAcceptedAtMs`, `lastResult`; os timers `lastAccelPollMs`/`lastMagPollMs`/`lastEnvPollMs` dos planos 02 e 03; `i2cRecoverTick()` e seu `switch`; a ordem de blocos dentro de `loop()`
    - `firmware/gps_tracker/src/display.h` — a struct `DisplayState` e a API do namespace escritas na Task 1
    - `firmware/gps_tracker/src/mag_sensor.h` — a assinatura de `arbitratedHeading` e de `cardinal`
    - `firmware/gps_tracker/src/accel_sensor.h`, `env_sensor.h`, `i2c_bus.h` — os acessores de estado a consultar
    - `firmware/gps_tracker/include/gps_config.h` — `DEFAULT_DISPLAY_REFRESH_MS`, `DEFAULT_SPEED_UNIT`, `DEFAULT_GPS_FRESH_MS`
  </read_first>
  <action>
Em `firmware/gps_tracker/src/main.cpp`, adicionar `#include "display.h"`.

Em `setup()`, chamar `display::begin()` depois de `env_sensor::begin()`, com uma linha de banner reportando presenca e endereco.

Adicionar duas funcoes estaticas de unidade (D-04): `static float speedInDisplayUnit(float kmh)` que devolve o valor recebido quando `DEFAULT_SPEED_UNIT` e 0 e o valor convertido para nos quando e 1 (fator 0.539957), e `static const char *speedUnitLabel()` que devolve "km/h" ou "kt" pelo mesmo criterio. Ambas devem decidir a partir da constante, nao de uma variavel de runtime, para que a selecao seja resolvida em tempo de compilacao por `build_flags` conforme D-04.

Adicionar `static DisplayState buildDisplayState()`, que monta um quadro completo a partir do estado ja existente em `main.cpp`:
- `have_fix` a partir de `everAccepted` combinado com a frescura do ultimo aceite (a mesma janela de `DEFAULT_GPS_FRESH_MS` que o watchdog de staleness ja usa no bloco de `loop()`), de modo que perder o fix em pleno funcionamento faca a tela voltar para o modo de aquisicao de D-03 em vez de congelar valores antigos.
- `sats_used` e `hdop` de `lastFix`; `sats_in_view` de `gpsReader.satsInView()`; `receiving_nmea` de `gpsReader.receiving()`.
- `speed_display` de `speedInDisplayUnit(lastFix.speed_kmh)` e `speed_unit` de `speedUnitLabel()`.
- `heading_deg` de `mag_sensor::arbitratedHeading()` alimentado com `lastFix.speed_kmh`, `lastFix.course_deg` e o mesmo indicador de fix disponivel calculado acima, capturando a flag de origem em `heading_from_compass`; `heading_cardinal` de `mag_sensor::cardinal()` sobre o rumo resultante.
- `temp_c`, `hum_pct` e `env_valid` de `env_sensor::last()`.
- `accel_g` de `accel_sensor::magnitudeG()`.
- `cadence_moving` comparando `cadence.state()` com o membro MOVING.
- `uptime_s` de `millis()` dividido por 1000.
- `accel_online`, `mag_online` e `env_online` de `i2c_bus::online()` para os respectivos modulos.

Adicionar `static uint32_t lastDisplayMs = 0;` e, em `loop()`, um bloco de render posicionado DEPOIS do passe do pipeline GPS, DEPOIS de `simTick()` e DEPOIS dos blocos de poll de accel/mag/env, e ANTES do bloco `[HEALTH]`. Essa posicao e o que entrega o alinhamento ao fix de D-02: quando um fix chega, ele ja foi lido, avaliado pelo gate, passado pela cadencia e teve os sensores atualizados antes que o quadro seja montado, entao a tela nunca mostra um estado meio processado.

Condicao de render: renderizar quando `millis() - lastDisplayMs >= DEFAULT_DISPLAY_REFRESH_MS`; adicionalmente, quando um novo snapshot de fix foi processado nesta iteracao E ja decorreram ao menos 80 por cento de `DEFAULT_DISPLAY_REFRESH_MS`, antecipar o render para esta iteracao. Essa antecipacao e o que impede o quadro de derivar em relacao ao fix: sem ela, um timer livre de 1 Hz e um fix de 1 Hz que nao estejam em fase mostrariam sempre o fix anterior, com ate um segundo de atraso. Em ambos os casos atualizar `lastDisplayMs` e chamar `display::render(buildDisplayState())`.

No `switch` de `i2cRecoverTick()`, inserir `display::begin()` no case `I2cModule::DISPLAY`, antes do `setOnline` generico, pelo mesmo motivo dos planos 02 e 03.

Estender a string de formato do `[HEALTH]` com ` sats_view=%u disp_addr=0x%02X`, alimentados por `gpsReader.satsInView()` e `display::addr()`. Preservar todos os campos existentes da linha, incluindo os adicionados nos planos 01, 02 e 03, sem remover, renomear nem reordenar nenhum.
  </action>
  <verify>
    <automated>/home/luc/Dev/aguada-firmware-main/.venv/bin/pio run -d /home/luc/Dev/aguada-firmware-main/aguada-firmware/firmware/gps_tracker -e esp32-c3-supermini</automated>
    <automated>/home/luc/Dev/aguada-firmware-main/.venv/bin/pio run -d /home/luc/Dev/aguada-firmware-main/aguada-firmware/firmware/gps_tracker -e esp32-devkit</automated>
    <automated>/home/luc/Dev/aguada-firmware-main/.venv/bin/pio run -d /home/luc/Dev/aguada-firmware-main/aguada-firmware/firmware/gps_tracker -e esp32-c3-supermini --project-option="build_flags=-DCORE_DEBUG_LEVEL=1 -DARDUINO_USB_MODE=1 -DARDUINO_USB_CDC_ON_BOOT=1 -DGPS_UART_NUM=1 -DGPS_RX_PIN=20 -DGPS_TX_PIN=21 -DGPS_BAUD=9600 -DLED_PIN=8 -DLED_ACTIVE_LOW=0 -I../shared -DDEFAULT_SPEED_UNIT=1"</automated>
    <automated>grep -c 'buildDisplayState\|speedInDisplayUnit\|speedUnitLabel\|DEFAULT_DISPLAY_REFRESH_MS' firmware/gps_tracker/src/main.cpp</automated>
    <human-check>Gravar o firmware com o OLED ligado e, ANTES de obter fix (leve a placa para longe da janela ou desconecte a antena), confirmar que a tela de aquisicao de D-03 aparece: aviso de ausencia de fix, contagem de satelites em vista, indicador de recepcao de NMEA, uptime correndo, e — na mesma tela — rumo, temperatura/umidade e magnitude de aceleracao ao vivo. Confirmar que mexer na placa altera a magnitude na tela e girar altera o rumo, provando a fiacao dos sensores sem depender do GPS.</human-check>
    <human-check>Com fix adquirido, confirmar a tela densa de D-01: estado do fix com satelites e HDOP, velocidade com rotulo de unidade, rumo em graus mais cardinal com marcador de fonte, temperatura e umidade, estado da cadencia, e uptime — tudo simultaneamente visivel, sem cortes, sem sobreposicao e sem necessidade de paginar.</human-check>
    <human-check>Confirmar D-02 cronometrando: a tela atualiza cerca de uma vez por segundo, e o valor de velocidade/satelites exibido corresponde ao mesmo fix que acabou de sair como `[EMIT]` no serial — nao ao anterior.</human-check>
    <human-check>Confirmar D-04 recompilando o env com `-DDEFAULT_SPEED_UNIT=1` (a terceira verificacao automatizada acima ja prova que compila) e gravando: a tela passa a mostrar a velocidade em nos com o rotulo kt, sem nenhuma edicao de codigo-fonte.</human-check>
    <human-check>Confirmar D-12/D-13 na tela: desconectar o HTU21D e confirmar que a letra de marcacao daquele modulo aparece na faixa inferior enquanto o resto da tela segue atualizando; religar e confirmar que a letra some sozinha dentro de ~10 s. Depois desconectar o proprio OLED com o firmware rodando e confirmar que o firmware nao trava, o `[HEALTH]` continua saindo e `disp=off` aparece; religar o OLED e confirmar que a tela volta sozinha.</human-check>
  </verify>
  <acceptance_criteria>
    - `grep -c 'display::render' firmware/gps_tracker/src/main.cpp` retorna 1 — ponto de render unico
    - `grep -c 'display::begin' firmware/gps_tracker/src/main.cpp` retorna 2 (`setup()` + case DISPLAY de `i2cRecoverTick()`)
    - `grep -c 'DEFAULT_SPEED_UNIT' firmware/gps_tracker/src/main.cpp` retorna ao menos 2 (a funcao de conversao e a de rotulo), e nenhuma delas depende de estado de runtime
    - O bloco de render em `loop()` esta posicionado depois dos blocos de poll de accel/mag/env e antes do bloco `[HEALTH]`
    - A string de formato do `[HEALTH]` contem `sats_view=%u` e `disp_addr=0x%02X`, e ainda contem `hdg=%.0f`, `accel_g=%.2f` e `disp=%s accel=%s mag=%s env=%s` dos planos anteriores
    - `pio run` termina com codigo 0 nos dois envs e tambem com o override `-DDEFAULT_SPEED_UNIT=1`
    - Comportamento on-hardware: tela de aquisicao antes do fix, tela densa depois, atualizacao a ~1 Hz em fase com o fix
  </acceptance_criteria>
  <done>O OLED mostra a tela densa com fix e a tela de aquisicao sem fix, a ~1 Hz alinhado ao fix, com unidade de velocidade selecionavel por build flag.</done>
</task>

<task type="auto">
  <name>Task 3: documentar o procedimento de bancada e a fiacao definitiva da Fase 01.1</name>
  <files>firmware/gps_tracker/BENCH.md, firmware/gps_tracker/gps_tracker_pinout.md</files>
  <read_first>
    - `firmware/gps_tracker/BENCH.md` — o arquivo inteiro: a estrutura de secoes da Fase 1 (Montagem, Build e flash, Comandos da serial com sua tabela, Formato das linhas com sua tabela de prefixos) que voce deve estender no mesmo estilo, e os caminhos de comando `pio` ja documentados
    - `firmware/gps_tracker/gps_tracker_pinout.md` — a secao "Fase 01.1 — Barramento I2C (MONTAR AGORA)" com as tabelas de barramento e de modulos, e a nota de pull-ups
    - `.planning/phases/01.1-perifericos-i2c-e-display/01.1-CONTEXT.md` — as decisoes D-01 a D-14, que sao os itens que o procedimento de bancada precisa tornar verificaveis
  </read_first>
  <action>
Em `firmware/gps_tracker/BENCH.md`, adicionar uma secao nova "Fase 01.1 — Periféricos I2C e display" apos o conteudo existente da Fase 1, preservando integralmente tudo o que ja esta la (o simulador e os hotkeys da Fase 1 continuam validos). A secao deve conter:

Uma tabela de comandos da serial estendida, listando o comando `cal` ao lado dos hotkeys existentes, com as colunas do mesmo formato ja usado no arquivo (comando, o que faz, o que prova) e uma nota explicita de que `cal` e o unico comando multi-caractere e exige Enter, enquanto todos os demais continuam sendo de um caractere sem Enter.

Uma tabela de campos novos da linha `[HEALTH]` introduzidos por esta fase — os campos de estado por modulo, contagem de quedas de barramento, magnitude e contagem de despertares do acelerometro, rumo com sua origem e o chip de bussola detectado, temperatura e umidade, satelites em vista e endereco do display — cada um com uma frase do que significa e do que um valor anomalo indica.

Uma tabela de prefixos de linha novos: `[I2C]`, `[MAG]`, `[ACCEL]` e `[CAL]`, no mesmo formato da tabela de prefixos existente.

Um procedimento numerado de validacao com um item verificavel por decisao de D-01 a D-14, cada um dizendo o que fazer na bancada e qual observacao confirma a decisao. Incluir explicitamente: o teste de degradacao graciosa (dar boot sem nenhum modulo, depois com cada subconjunto), o teste de recuperacao em runtime (arrancar um fio com o firmware rodando e religar), o procedimento completo de calibracao da bussola pelo comando `cal`, a verificacao de que o despertar por acelerometro promove a cadencia mas nao a rebaixa, e a checagem de orçamento de tempo — observar os contadores de checksum ruim e de fix obsoleto do `[HEALTH]` por alguns minutos com os 4 periféricos ativos e confirmar que nao crescem em relacao ao comportamento da Fase 1.

Uma subsecao curta de ajuste em campo, listando quais constantes `DEFAULT_*` desta fase sao pontos de partida de research e nao valores finais — o limiar e o debounce de despertar do acelerometro, os intervalos de poll, o limiar de erros consecutivos e a velocidade do barramento — indicando que o ajuste se faz por `build_flags` no `platformio.ini` e nunca editando o header.

Em `firmware/gps_tracker/gps_tracker_pinout.md`, atualizar a secao "Fase 01.1 — Barramento I2C (MONTAR AGORA)": trocar a marcacao de "montar agora" por uma indicacao de que a fiacao esta implementada e validada em firmware, registrar qual chip de bussola foi efetivamente detectado na bancada (informacao produzida pela verificacao on-hardware do plano 03), e registrar a velocidade de barramento em uso mais a observacao de se o fallback de 100 kHz foi necessario. Acrescentar uma linha na tabela do orcamento de pinos v2 do ESP32-C3 registrando que GPIO1 a GPIO5 seguem livres porque o OLED I2C substituiu o TFT SPI. Nao remover nenhuma das tabelas ou notas existentes, incluindo as das placas alternativas.
  </action>
  <verify>
    <automated>grep -c 'Fase 01.1' firmware/gps_tracker/BENCH.md</automated>
    <automated>grep -c 'cal' firmware/gps_tracker/BENCH.md</automated>
    <automated>grep -c 'GPS_BENCH_SIM' firmware/gps_tracker/BENCH.md</automated>
    <automated>grep -c 'D-01\|D-05\|D-09\|D-12\|D-13' firmware/gps_tracker/BENCH.md</automated>
  </verify>
  <acceptance_criteria>
    - `BENCH.md` contem uma secao cujo titulo referencia a Fase 01.1 e o conteudo da Fase 1 permanece: `grep -c 'GPS_BENCH_SIM' firmware/gps_tracker/BENCH.md` retorna ao menos 1 e a tabela de hotkeys original segue presente
    - `BENCH.md` documenta o comando `cal` e indica que ele exige Enter, ao contrario dos hotkeys de um caractere
    - `BENCH.md` documenta os quatro prefixos de linha novos `[I2C]`, `[MAG]`, `[ACCEL]` e `[CAL]`
    - O procedimento numerado de `BENCH.md` cobre as 14 decisoes: cada identificador de D-01 a D-14 aparece ao menos uma vez no arquivo
    - `gps_tracker_pinout.md` registra o chip de bussola detectado na bancada e a velocidade de barramento em uso, e mantem todas as tabelas pre-existentes das duas placas
    - `grep -c 'GPIO6' firmware/gps_tracker/gps_tracker_pinout.md` e `grep -c 'GPIO7' firmware/gps_tracker/gps_tracker_pinout.md` retornam ao menos 1 cada — a fiacao canonica segue documentada
  </acceptance_criteria>
  <done>Qualquer pessoa consegue reproduzir a validacao das 14 decisoes da fase a partir do BENCH.md, e o pinout registra o hardware efetivamente montado.</done>
</task>

</tasks>

<threat_model>
## Trust Boundaries

| Boundary | Description |
|---|---|
| barramento I2C -> transferencia de quadro do OLED | Maior transacao I2C unica desta fase (~1024 bytes por quadro), disputando CPU com o consumidor de UART do GPS |
| estado interno -> tela | Superficie de saida somente leitura; nenhuma entrada externa cruza esta fronteira |
| sentencas NMEA GSV -> `GpsReader::satsInView()` | Campo numerico proveniente de um receptor externo, agora exposto num acessor novo |

## STRIDE Threat Register

| Threat ID | Category | Component | Severity | Disposition | Mitigation Plan |
|---|---|---|---|---|---|
| T-01.1-03 | Denial of Service | `display::render()` vs buffer RX do UART do GPS | high | mitigate | Uma unica transferencia de buffer por chamada (criterio de aceite: exatamente uma chamada de envio de buffer no arquivo), custo aproximado de 25 ms a 400 kHz contra a janela de ~266 ms de saturacao do buffer a 9600 baud, agendada uma vez por `DEFAULT_DISPLAY_REFRESH_MS` = 1000 ms e posicionada depois do passe do pipeline GPS na iteracao. A verificacao on-hardware de 5 minutos observando os contadores de checksum ruim e fix obsoleto do `[HEALTH]`, documentada no `BENCH.md` da Task 3, e o gate empirico deste orçamento. |
| T-01.1-02 | Denial of Service | OLED com defeito segurando o barramento durante a transferencia de quadro | high | mitigate | `render()` retorna cedo quando o modulo esta offline; a politica de erros consecutivos e retry do `i2c_bus` (plano 01) marca o display offline e para de transferir quadros, e a verificacao on-hardware inclui arrancar o OLED com o firmware rodando para confirmar que nada trava e que o `[HEALTH]` continua saindo. |
| T-01.1-11 | Tampering | valor de satelites em vista vindo de sentenca GSV de um receptor externo | low | mitigate | O valor alimenta exclusivamente um campo informativo de tela e o `[HEALTH]`; nao entra em nenhuma decisao de gate, cadencia ou persistencia. A frescura e limitada por `DEFAULT_GPS_FRESH_MS` e o campo cai para 0 quando obsoleto, entao um valor manipulado nao persiste alem dessa janela. |
| T-01.1-10 | Information Disclosure | velocidade, rumo e estado de trajeto visiveis na tela do dispositivo | low | accept | A tela e o proposito declarado do dispositivo e exige linha de visao fisica; o mesmo modelo de posse fisica que cobre o acesso ao cabo USB se aplica, proporcional ao nivel ASVS 1 para um prototipo offline sem pilha de rede. |
</threat_model>

<verification>
- `pio run` compila com codigo 0 nos dois envs e tambem com o override de unidade de velocidade.
- Antes do fix, o OLED mostra a tela de aquisicao com sensores ao vivo; depois do fix, a tela densa completa.
- A tela atualiza a ~1 Hz em fase com o fix, sem mostrar o fix anterior.
- Modulo offline aparece marcado na propria tela; OLED ausente nao trava nem interrompe o serial.
- `BENCH.md` cobre as 14 decisoes da fase com passos verificaveis.
- Os contadores de checksum ruim e fix obsoleto do `[HEALTH]` nao crescem com os 4 periféricos ativos.
</verification>

<success_criteria>
- D-01 observavel: uma tela, todos os campos, sem paginacao nem botao.
- D-02 observavel: ~1 Hz, quadro em fase com o fix.
- D-03 observavel: tela de aquisicao com satelites em vista, uptime e sensores vivos durante o cold start.
- D-04 observavel: unidade de velocidade trocada apenas por `build_flags`; rumo com graus e cardinal.
- D-12/D-13 observaveis na propria tela: modulo caido aparece marcado e volta sozinho.
- A Fase 01.1 fecha com procedimento de bancada documentado para todas as 14 decisoes.
</success_criteria>

<output>
Create `.planning/phases/01.1-perifericos-i2c-e-display/01.1-04-SUMMARY.md` when done
</output>
