lucianoET/aguada-firmware/.planning/phases/01.1-perifericos-i2c-e-display/01.1-RESEARCH.md

# Phase 01.1: Periféricos I2C e Display - Research

**Researched:** 2026-08-03
**Domain:** ESP32-C3 Arduino I2C peripheral integration (OLED SSD1306, MPU6050 accel, HMC5883L/QMC5883L compass, HTU21D temp/humidity) sharing a single bus with a time-sensitive GPS UART consumer
**Confidence:** MEDIUM-HIGH (library existence/API verified via PlatformIO registry + GitHub source fetches; ESP32 I2C/UART blocking behavior cross-checked against Espressif docs and ESP32 forum/GitHub issues; exact timing thresholds — accel wake threshold, poll intervals — are engineering estimates pending bench validation, marked `[ASSUMED]`)

<user_constraints>
## User Constraints (from CONTEXT.md)

### Locked Decisions

**Display (SSD1306)**
- D-01: Single dense screen — fix/sats/HDOP, speed, heading, temp/humidity, cadence state (MOVING/STOPPED), all visible at once. No pagination, no buttons.
- D-02: Refresh at 1 Hz, aligned to the GPS fix.
- D-03: No fix (cold start): live acquisition screen — "NO FIX" + sats in view + uptime + readings from sensors that are ALREADY alive (temp/hum, heading, movement). Confirms wiring while waiting for fix.
- D-04: Speed unit selectable via build flag (`DEFAULT_SPEED_UNIT`), km/h default, knots (kt) for boat. Heading in degrees + cardinal.

**MPU6050 → cadence**
- D-05: Hybrid role: accel detects stopped→moving instantly (GPS takes several fixes to see speed); GPS speed remains the authority for moving→stopped. Fast resume without logging drift points.
- D-06: Detection by polling the accel over I2C (magnitude + software threshold/debounce). No INT wire this phase.
- D-07: Accel only — gyroscope not used this phase.

**Heading (HMC5883)**
- D-08: Heading source blended by speed: compass when stopped/slow (GPS course is garbage below ~3 km/h), GPS course when moving.
- D-09: Hard-iron calibration via serial command ("cal" on USB serial → rotate the module → min/max offsets persisted in NVS). Re-calibratable after installation without recompiling.
- D-10: Flat mounting assumed in v1 — no tilt compensation. Magnetic declination via build flag `DEFAULT_MAG_DECLINATION` (0 default).
- D-11: Many GY-271 boards ship QMC5883L (0x0D) instead of HMC5883L (0x1E) — firmware must detect and support both.

**Sensor roles & failure policy**
- D-12: Total graceful degradation: I2C scan at boot; missing module → feature disabled, indicated on display/serial, rest keeps running. GPS tracking never blocked by a peripheral failure. Any subset of the 4 modules works.
- D-13: Runtime failure (loose wire, bus error): mark offline after N consecutive errors, re-init retry every ~10s, comes back on its own when reconnected.
- D-14: HTU21: display + serial only this phase. Log/MQTT integration comes in Phases 2/3.

### Claude's Discretion
- Movement thresholds (accel magnitude, debounce window, "quiet" time) — decide in research/planning, expose as `DEFAULT_*` build_flags constants (repo convention).
- Module libraries (U8g2 vs Adafruit SSD1306, MPU/HMC/QMC/HTU driver) — decide in research; prefer lightweight and consistent with the existing PlatformIO/Arduino stack.
- Exact dense-screen layout (fonts, positions) and bench serial log format.
- I2C retry/backoff and bus-recovery details.
- Per-sensor read frequency (HTU21 can be slow, ~a few seconds; accel needs to be fast for wake).

### Deferred Ideas (OUT OF SCOPE)
- Compass tilt compensation (boat heel) — future upgrade on top of D-10.
- MPU6050 INT wire as a deep-sleep wake source — bundled with PWR-03 (v2).
- HTU21D temp/humidity and heading in flash log / MQTT — Phases 2/3.
- Button (GPIO9) for display pagination — if the single screen turns out too tight.
</user_constraints>

<phase_requirements>
## Phase Requirements

This is an **inserted** phase with no formal REQ-IDs in `.planning/REQUIREMENTS.md` — its scope is entirely the D-01..D-14 decisions locked in `01.1-CONTEXT.md`. The table below maps each decision to the research that supports planning it.

| Decision | Description | Research Support |
|---|---|---|
| D-01, D-02, D-03, D-04 | Dense single OLED screen, 1 Hz refresh, no-fix acquisition screen, selectable speed unit | Standard Stack (U8g2), Architecture Patterns (display data flow, render cost), Code Examples (U8g2 full-buffer draw) |
| D-05, D-06, D-07 | Accel-only, polled, hybrid wake signal feeding cadence | Architecture Patterns (accel-wake vs cadence contract), Common Pitfalls (cadence single-call-site invariant), Code Examples (raw MPU6050 read) |
| D-08 | Speed-blended heading source (compass vs GPS course) | Architecture Patterns (heading arbiter), reuse of existing `DEFAULT_GPS_STATIONARY_KMH` threshold |
| D-09, D-10 | Hard-iron calibration via serial "cal" command, NVS persistence, declination build flag | Code Examples (Preferences read/write), Common Pitfalls (serial command parsing collision with bench-sim hotkeys) |
| D-11 | HMC5883L/QMC5883L dual-chip auto-detect | Standard Stack (DFRobot_QMC5883 verified via source fetch), Package Legitimacy Audit |
| D-12, D-13 | Graceful degradation, boot scan, runtime retry/backoff | Architecture Patterns (I2C bus manager), Common Pitfalls (bus hang/timeout, scan cost) |
| D-14 | HTU21 display/serial only | Standard Stack (Adafruit HTU21DF), Common Pitfalls (blocking read budget vs GPS UART) |
</phase_requirements>

## Project Constraints (from CLAUDE.md)

- Firmware lives in `firmware/gps_tracker/` (PlatformIO, Arduino framework, ESP32-C3 SuperMini env `esp32-c3-supermini`); `pio` is not on PATH — use `/home/luc/Dev/aguada-firmware-main/.venv/bin/pio`.
- Tunable constants must be `#ifndef`-guarded `DEFAULT_*` macros in `include/gps_config.h`, overridable via `platformio.ini` `build_flags` — never hardcode, never edit the header for a field tune.
- I2C on GPIO6/7 is the established repo convention (mirrors `firmware/node`'s AirQ node) — this phase's pinout doc confirms the same pins for the tracker.
- GPS UART (`gps_reader`) must never be blocked or starved — protocol v3/ESP-NOW/WiFi are explicitly out of scope for this milestone; this phase only touches the local bench I2C bus and OLED/serial.
- `cadence.h`'s existing doc comment states its **only call site** is `main.cpp`'s single `GateResult::ACCEPT` branch — D-05's accel-wake signal requires deliberately extending this contract (see Common Pitfalls), not silently routing around it.
- No automated test suite in this repo — validation is on-hardware (bench I2C scan, OLED render, serial `[HEALTH]`-style log lines matching the existing style in `main.cpp`).

## Summary

This phase adds four separate I2C breakout modules — SSD1306 OLED (0x3C), MPU6050 (0x68), HMC5883L/QMC5883L (0x1E/0x0D), HTU21D (0x40) — onto the same GPIO6/GPIO7 `Wire` bus already used by the AirQ node elsewhere in this repo, and wires their output into the existing `gps_reader → fix_gate → cadence` pipeline and a new OLED status screen. The core engineering risk is not any single library choice, it is **time-budget discipline in a single-threaded superloop**: `gps_reader.poll()` drains a 256-byte UART ring buffer every `loop()` iteration, and any I2C peripheral work (display transfer, sensor conversion wait) that blocks for too long, too often, starves that buffer and manifests as dropped NMEA sentences / `REJECT_STALE`. The existing `firmware/node/src/ani_sensor.cpp` pattern in this repo uses a `delay(10)` polling loop with up to a 1-second deadline waiting for sensor data — that exact pattern must **not** be ported here; the AirQ node has no time-critical UART consumer competing for the CPU, the GPS tracker does.

Library choices favor small, single-purpose drivers over full-featured suites: **U8g2** (not Adafruit SSD1306+GFX) for the display, because D-01's dense single-screen layout needs U8g2's wide selection of compact bitmap fonts to fit fix/sats/HDOP/speed/heading/temp/humidity/cadence on one 128×64 frame; **DFRobot_QMC5883** for the compass, because it is the only readily available library confirmed (via direct source inspection) to auto-detect both the HMC5883L (0x1E) and QMC5883L (0x0D) chip variants — a direct, exact match for D-11; **a hand-rolled raw-I2C driver** (no library) for the MPU6050, because D-07 scopes this phase to accel-only magnitude thresholding, and pulling in a full DMP/I2Cdev-based library (ElectronicCats/MPU6050 or i2cdevlib) for a 6-register read is disproportionate flash/RAM cost for what this phase needs — consistent with this milestone's own established pattern of hand-rolling small protocols (raw UBX GPS config bytes) rather than reaching for heavyweight libraries; and **Adafruit HTU21DF Library** for temp/humidity, matching the Adafruit ecosystem this repo's node firmware already depends on (`Adafruit_BusIO`).

**Primary recommendation:** Use U8g2 (full-buffer, hardware I2C) for the display, DFRobot_QMC5883 for the compass (dual-chip auto-detect), a hand-rolled raw-I2C reader for MPU6050 accel-only, and Adafruit HTU21DF for temp/humidity — all sharing one `Wire` bus at a single clock speed (400 kHz recommended, with 100 kHz as the documented fallback if the 4-module parallel pull-up bus proves unreliable on the bench) — and schedule every sensor poll and the display render on independent `millis()`-based timers in `loop()`, never stacking more than one blocking I2C operation per `loop()` pass, exactly mirroring the existing `lastHealthMs`/`DEFAULT_GPS_HEALTH_PERIOD_MS` non-blocking-timer pattern already in `main.cpp`.

## Architectural Responsibility Map

This is embedded firmware, not a web app — the table below adapts the browser/API/DB tiers to this project's actual layers: **Driver** (raw I2C register access), **Application/State** (cadence, heading arbitration, wake detection, bus health), **Presentation** (OLED + USB serial), **Persistence** (NVS/Preferences).

| Capability | Primary Tier | Secondary Tier | Rationale |
|---|---|---|---|
| SSD1306 pixel/font rendering | Driver (U8g2) | Presentation | U8g2 owns the SSD1306 init sequence and font rendering; `main.cpp` only decides *what* to draw |
| Dense status screen composition (D-01) | Presentation (`main.cpp` / new display module) | Application/State | Layout and which fields to show is a presentation concern fed by state already computed elsewhere |
| Accel magnitude + wake threshold (D-05/D-06) | Application/State | Driver | The threshold/debounce decision belongs with cadence-adjacent logic; the driver only returns raw g-values |
| MPU6050 register read | Driver (hand-rolled raw I2C) | — | No state, no decisions — pure register I/O |
| Heading arbitration (compass vs GPS course, D-08) | Application/State | — | Speed-based source selection is a business-logic decision, not a driver concern |
| HMC5883L/QMC5883L raw field read + chip detection | Driver (DFRobot_QMC5883) | — | Register-map differences are exactly what the library abstracts away |
| Hard-iron calibration min/max capture (D-09) | Application/State | Persistence | Capture logic lives with the serial command handler; only the resulting offsets are persisted |
| Calibration offset storage | Persistence (Preferences/NVS) | — | Must survive reboot/recompile per D-09 |
| I2C bus health / boot scan / per-module retry (D-12/D-13) | Application/State (bus manager) | Driver | Cross-cuts all 4 drivers; owned once, not duplicated per sensor |
| GPS UART parsing, fix gating, cadence pacing (existing) | Application/State (`gps_reader`/`fix_gate`/`cadence`) | — | Unchanged this phase; peripherals must never be able to block this path |

## Standard Stack

### Core

| Library | Version | Purpose | Why Standard |
|---|---|---|---|
| `olikraus/U8g2` | `^2.36.18` [VERIFIED: PlatformIO registry] | SSD1306 128×64 I2C OLED driver + fonts | Full-buffer hardware-I2C constructor (`U8G2_SSD1306_128X64_NONAME_F_HW_I2C`) transfers the whole 1024-byte frame in one `sendBuffer()` call (~14-25ms at 400kHz for comparable resolutions per community measurement `[CITED: github.com/olikraus/u8g2 issue #1150 discussion]`), and its large built-in font selection (down to 4×6/5×7 px) is what makes D-01's "one dense screen, no pagination" layout achievable. 409 GitHub stars, 68 examples, actively published (last release 2026-03-08). `[VERIFIED: PlatformIO registry — registry.platformio.org/libraries/olikraus/U8g2]` |
| `dfrobot/DFRobot_QMC5883` | `^1.0.0` [VERIFIED: PlatformIO registry + GitHub source] | Compass driver — auto-detects HMC5883L (0x1E), QMC5883L (0x0D), and VCM5883L (0x0C) | Directly satisfies D-11 without hand-rolling dual-chip detection: exposes `getICType()`/`isHMC()`/`isQMC()`/`isVCM()` and normalizes heading math (`getHeadingDegrees()`) across chip variants so the app layer never needs to branch on register-map differences. Confirmed by fetching the library's own header/source (see Sources) — the address constants and `ICType` enum are present in the actual code, not just the description. `[VERIFIED: raw.githubusercontent.com/DFRobot/DFRobot_QMC5883]` |
| Hand-rolled raw I2C driver (no library) | n/a | MPU6050 accel-only read for D-05/D-06/D-07 | WHO_AM_I (reg 0x75) confirms presence, wake via `PWR_MGMT_1` (reg 0x6B) = 0, then a single 6-byte burst read from `ACCEL_XOUT_H` (0x3B) through `ACCEL_ZOUT_L` (0x40) at default ±2g sensitivity (16384 LSB/g) is all D-06's magnitude-threshold wake needs. `[CITED: InvenSense MPU-6050 register map, cross-checked via lastminuteengineers.com and controllerstech.com tutorials]`. Pulling in ElectronicCats/MPU6050 (DMP + I2Cdev abstraction) for a 6-register read is disproportionate flash/RAM cost this phase does not need (no gyro, no DMP, per D-07). |
| `adafruit/Adafruit HTU21DF Library` | `^1.1.2` [VERIFIED: PlatformIO registry] | HTU21D temp/humidity driver, I2C 0x40 | Small (5.25KB), single-purpose, matches D-14's "display+serial only" scope exactly (`readTemperature()`/`readHumidity()`, no unused features). Depends on `Adafruit_BusIO` [VERIFIED: source inspection of `Adafruit_HTU21DF.cpp` shows `Adafruit_I2CDevice`/`Adafruit_BusIO_Register` usage] — same dependency already present in this repo's `firmware/node` AirQ stack, zero new supply-chain surface. |
| Arduino-ESP32 built-in `Preferences` | ships with core (no `lib_deps` entry) | Persist hard-iron calibration offsets (D-09) | Official Arduino-ESP32 wrapper over ESP-IDF NVS; `putFloat`/`getFloat` with a dedicated namespace (e.g. `"magcal"`) is the documented, wear-leveled way to persist small config values across reboot and recompile — exactly D-09's requirement. `[CITED: docs.espressif.com/projects/arduino-esp32 Preferences API]` |

### Supporting

| Library | Version | Purpose | When to Use |
|---|---|---|---|
| `adafruit/Adafruit BusIO` | `^1.17.4` (transitive, pulled by Adafruit HTU21DF) | I2C transaction abstraction | Automatically resolved by PlatformIO as a dependency of Adafruit HTU21DF — no explicit `lib_deps` line needed unless PlatformIO's dependency resolution needs pinning. |

### Alternatives Considered

| Instead of | Could Use | Tradeoff |
|---|---|---|
| U8g2 (full buffer, hw I2C) | `adafruit/Adafruit SSD1306` + `Adafruit GFX Library` + `Adafruit BusIO` | Same 1024-byte framebuffer size and comparable RAM cost, and reuses libraries already proven in this repo's node firmware (`Adafruit_BusIO`). Weaker font density than U8g2's small bitmap fonts, which matters for D-01's one-screen-fits-everything requirement. Use this alternative if the team prioritizes dependency consistency with `firmware/node` over font flexibility. |
| U8g2 full-buffer mode | U8g2 page-buffer mode (`_1_` constructors) | Cuts RAM from ~1KB to ~128 bytes, irrelevant here — ESP32-C3 has 400KB SRAM and RAM is not the constraint. Page mode also re-runs the entire draw callback once per page (8× for a 64-row display), costing more CPU per frame for no benefit at this RAM budget. Only relevant if RAM becomes tight after adding the other 3 sensors' state (unlikely). |
| DFRobot_QMC5883 | Two separate single-chip libraries (e.g. `jarzebski/Arduino-HMC5883L` + a QMC5883L-only driver like `mprograms/QMC5883LCompass`) selected at runtime by address | More flash if both are linked; avoids depending on a library that has had a single release since 2022 (see Package Legitimacy Audit). Only worth the extra complexity if DFRobot_QMC5883 proves unreliable on the bench with the actual GY-271 clone in hand. |
| Hand-rolled MPU6050 accel read | `electroniccats/MPU6050` (i2cdevlib fork, `^1.4.5`, ESP32-compatible per its own README `[CITED: github.com/ElectronicCats/mpu6050]`) | Adds DMP/calibration/full register-map support this phase's D-07 scope (accel-only, no gyro, no DMP) does not need. Reach for this only if a future phase (v2 HW-05) needs gyro/tilt or DMP-based motion fusion. |
| Adafruit HTU21DF | `sparkfun/SparkFun HTU21D Humidity and Temperature Sensor Breakout @ ^1.1.3` | Functionally equivalent (same chip, same I2C protocol); Adafruit chosen only for dependency consistency with the repo's existing `Adafruit_BusIO` usage in `firmware/node`. |

**Installation** (add to `firmware/gps_tracker/platformio.ini`, all `esp32-c3-supermini*` envs):
```ini
lib_deps =
    mikalhart/TinyGPSPlus @ ^1.0.3   ; already present
    olikraus/U8g2 @ ^2.36.18
    dfrobot/DFRobot_QMC5883 @ ^1.0.0
    adafruit/Adafruit HTU21DF Library @ ^1.1.2
```
No `lib_deps` entry needed for the MPU6050 driver (hand-rolled, uses `Wire.h` only) or for `Preferences` (ships with the Arduino-ESP32 core, same as `LittleFS`/`WiFiMulti` noted in the milestone's `.planning/research/STACK.md`).

**Version verification:** confirmed live against the PlatformIO registry on 2026-08-03 via `pio pkg search`/`pio pkg show` (see Sources) — not from training-data recall. `Adafruit_BusIO` transitive dependency resolves to `^1.17.4` (latest as of this research date).

## Package Legitimacy Audit

The `gsd-tools query package-legitimacy check` seam only supports `npm|pypi|crates` ecosystems — this phase's dependencies are PlatformIO/Arduino libraries, so this audit was performed manually against PlatformIO registry metadata (`pio pkg show`) and direct GitHub source fetches, in place of the automated seam.

| Package | Registry | Age / Last Publish | Popularity/Stars | Source Repo | Verdict | Disposition |
|---|---|---|---|---|---|---|
| `olikraus/U8g2` | PlatformIO | first release predates 2020; last publish 2026-03-08 | Popularity 23, 409 stars, 68 examples, used by 28 other registered libraries | github.com/olikraus/u8g2 (canonical), mirrored at github.com/olikraus/U8g2_Arduino | OK | Approved |
| `dfrobot/DFRobot_QMC5883` | PlatformIO | published 2022-04-26, **single version since** (no updates in ~4 years) | Popularity 1369 (registry download-weighted metric), stars not reported by registry | github.com/DFRobot/DFRobot_QMC5883 — official DFRobot vendor org, matches DFRobot product SKU SEN0140 | OK — flagged for staleness, not illegitimacy | Approved. `[WARNING: single release since 2022 — no active maintenance, but the driven chips (HMC5883L/QMC5883L) have a fixed, stable register map, so a compass driver needing no updates in 4 years is plausible, not necessarily abandoned. Bench-test the exact GY-271 module in hand before committing to this library in the plan.]` |
| Hand-rolled MPU6050 raw I2C | n/a (no external package) | n/a | n/a | n/a — code written for this project | N/A | No external supply-chain surface; register addresses cross-checked against two independent community tutorials, not a single source |
| `adafruit/Adafruit HTU21DF Library` | PlatformIO | first release ~2018; last publish 2023-09-27 | Popularity 375, 28 stars, used by 1 other registered library | github.com/adafruit/Adafruit_HTU21DF_Library — official Adafruit org | OK | Approved |
| `adafruit/Adafruit BusIO` (transitive) | PlatformIO | last publish 2025-09-22 | Popularity 4, 353 stars, used by 240 other registered libraries | github.com/adafruit/Adafruit_BusIO — official Adafruit org | OK | Approved (already a dependency in this repo's `firmware/node`) |

**Packages removed due to [SLOP] verdict:** none.
**Packages flagged as suspicious [SUS]:** none outright SUS; `DFRobot_QMC5883` carries a staleness `[WARNING]` above — the planner should add a `checkpoint:human-verify` task confirming the actual GY-271 module in hand is correctly detected (HMC vs QMC) by this library before wiring it into the display/heading arbiter.

All package names above were discovered via WebSearch and cross-checked by fetching the library's own source file directly from its GitHub repository (not registry description text alone) — per the package-name provenance rule, they are tagged `[VERIFIED: <specific source fetched>]` only where the actual source content (not just registry existence) was inspected; `DFRobot_QMC5883`'s address constants and `ICType` enum were confirmed this way (see Sources).

## Architecture Patterns

### System Architecture Diagram

```
                    ┌────────────────────────────┐
                    │  GPS UART (existing, unchanged) │
                    │  gps_reader.poll() → fix_gate    │
                    └───────────────┬──────────────┘
                                    │ Fix (GateResult::ACCEPT only)
                                    ▼
                    ┌────────────────────────────────────┐
                    │     cadence (existing contract)      │◄─────┐
                    │  GPS-speed hysteresis + debounce      │      │ accel-wake signal (NEW,
                    │  state machine (MOVING/STATIONARY)    │      │ D-05): instant STATIONARY
                    └───────────────────┬────────────────────┘      │ → MOVING only. GPS speed
                                        │ CadenceState/Action        │ remains the ONLY path back
                                        ▼                            │ to STATIONARY (never demote
                    ┌──────────────────────────────────────────┐    │ from accel).
                    │           main.cpp loop() — superloop      │    │
                    │  (existing GPS pass, unchanged, always      │────┘
                    │   runs first / every iteration)             │
                    └───┬─────────┬─────────┬─────────┬──────────┘
                        │         │         │          │
          every ~100ms  │  ~250ms│   ~3-5s │     1 Hz (D-02, aligned to fix)
                        ▼         ▼         ▼          ▼
                  ┌──────────┐┌────────┐┌─────────┐┌──────────┐
                  │  Accel    ││ Compass ││ HTU21D  ││  OLED     │
                  │ (raw I2C, ││(DFRobot ││(Adafruit││ (U8g2,    │
                  │  D-06/07) ││ QMC5883,││ HTU21DF,││  D-01..04)│
                  │           ││  D-11)  ││  D-14)  ││           │
                  └────┬─────┘└───┬────┘└────┬────┘└─────┬────┘
                       │          │          │           │
                       ▼          ▼          ▼           │
                magnitude   heading arbiter  temp/hum     │
                threshold → (D-08: compass    values ─────┤
                wake ──────► if <DEFAULT_GPS_             │
                             STATIONARY_KMH,               │
                             else GPS course) ─────────────┘
                                                    all state above feeds the
                                                    single dense status screen

        Shared I2C bus (GPIO6=SDA, GPIO7=SCL, single `Wire` instance, one clock
        speed for all 4 devices). Boot-time scan (D-12) probes 0x3C/0x3D, 0x68,
        0x1E/0x0D, 0x40 — a missing module just disables its feature, nothing
        blocks. Runtime bus manager (D-13) tracks consecutive I2C errors per
        module, marks offline after N failures, retries re-init every ~10s.

        USB Serial (existing bench harness, unchanged single-char hotkeys
        r/h/s/+/-/x/z/b) — ADDS a new line-buffered "cal" command (D-09) that
        must not collide with the existing single-char dispatch (see Common
        Pitfalls) → calibration mode → hard-iron min/max → Preferences/NVS.
```

### Recommended Project Structure

```
firmware/gps_tracker/
├── include/
│   └── gps_config.h        # add DEFAULT_I2C_*, DEFAULT_OLED_*, DEFAULT_MPU_*,
│                            # DEFAULT_MAG_*, DEFAULT_HTU21_* constants here
│                            # (existing file, existing #ifndef-guard convention)
├── src/
│   ├── main.cpp             # existing GPS pipeline unchanged; adds scheduler
│   │                        # calls for the 4 peripherals + display render
│   ├── cadence.cpp/.h       # existing; extended with an accel-wake entry
│   │                        # point (see Common Pitfalls — contract change)
│   ├── i2c_bus.cpp/.h       # NEW — boot scan, per-module online/offline
│   │                        # state, retry/backoff timers (D-12/D-13)
│   ├── accel_sensor.cpp/.h  # NEW — raw MPU6050 I2C read + magnitude/threshold
│   ├── mag_sensor.cpp/.h    # NEW — DFRobot_QMC5883 wrapper + calibration
│   │                        # capture + Preferences persistence (D-09)
│   ├── env_sensor.cpp/.h    # NEW — Adafruit HTU21DF wrapper (D-14)
│   └── display.cpp/.h       # NEW — U8g2 setup + dense-screen render (D-01..04)
```

### Pattern 1: Non-blocking per-peripheral scheduling (extends existing `[HEALTH]` timer pattern)

**What:** Each peripheral gets its own `static uint32_t lastPollMs` and `if (millis() - lastPollMs >= DEFAULT_X_POLL_MS)` guard in `loop()`, exactly like the existing `lastHealthMs`/`DEFAULT_GPS_HEALTH_PERIOD_MS` pattern already in `main.cpp`.
**When to use:** For every I2C peripheral poll and the display render — never poll/render unconditionally on every `loop()` iteration.
**Example:**
```cpp
// Source: pattern generalized from firmware/gps_tracker/src/main.cpp's existing
// `if (millis() - lastHealthMs >= DEFAULT_GPS_HEALTH_PERIOD_MS)` block.
static uint32_t lastAccelPollMs = 0;
static uint32_t lastMagPollMs   = 0;
static uint32_t lastEnvPollMs   = 0;
static uint32_t lastDisplayMs   = 0;

void loop() {
    // ... existing gps_reader.poll() / fixGate / cadence pass runs first, unchanged ...

    if (millis() - lastAccelPollMs >= DEFAULT_ACCEL_POLL_MS) {
        lastAccelPollMs = millis();
        accelSensor.poll();   // single 6-byte I2C burst read, sub-millisecond at 400kHz
    }
    if (millis() - lastMagPollMs >= DEFAULT_MAG_POLL_MS) {
        lastMagPollMs = millis();
        magSensor.poll();
    }
    if (millis() - lastEnvPollMs >= DEFAULT_HTU21_POLL_MS) {
        lastEnvPollMs = millis();
        envSensor.poll();     // internally blocks ~50ms (Adafruit lib's delay(50)) —
                               // this is why it is scheduled every few seconds, never every loop
    }
    if (millis() - lastDisplayMs >= DEFAULT_DISPLAY_REFRESH_MS) {
        lastDisplayMs = millis();
        display.render(lastFix, lastResult, cadence.state(), accelSensor, magSensor, envSensor);
    }
}
```

### Pattern 2: Boot-time I2C scan with per-module online flags (D-12)

**What:** A single full-bus scan (addresses 0x08-0x77) at boot, logged once, used to set 4 independent `bool` online flags — never gate the rest of the firmware on "all 4 present."
**When to use:** Startup, before attempting any sensor `.begin()` call.
**Example:**
```cpp
// Source: adapted from the existing repo pattern in
// firmware/node/src/ani_sensor.cpp's ani_init() I2C scan loop.
Wire.begin(DEFAULT_I2C_SDA_PIN, DEFAULT_I2C_SCL_PIN);
Wire.setClock(DEFAULT_I2C_CLOCK_HZ);
for (uint8_t addr = 0x08; addr <= 0x77; addr++) {
    Wire.beginTransmission(addr);
    if (Wire.endTransmission() == 0) {
        Serial.printf("[I2C] found 0x%02X\n", addr);
    }
}
// Each module's own begin() then independently succeeds/fails; a missing
// module never prevents the others (or the GPS pipeline) from working.
```

### Pattern 3: Speed-blended heading arbiter reusing the existing cadence threshold (D-08)

**What:** Below `DEFAULT_GPS_STATIONARY_KMH` (already defined in `gps_config.h` for cadence's hysteresis band), use the compass heading; at/above it, use GPS course.
**When to use:** Any time the display needs a heading value to render.
**Example:**
```cpp
// Source: reuses firmware/gps_tracker/include/gps_config.h's existing
// DEFAULT_GPS_STATIONARY_KMH (3.0f) — the same value the user's D-08
// decision independently specified ("~3 km/h") for exactly this purpose.
// This is a genuine single-source-of-truth opportunity: do not introduce a
// second DEFAULT_MAG_HEADING_SPEED_KMH constant that could drift from
// DEFAULT_GPS_STATIONARY_KMH over time.
float displayHeadingDeg(const Fix &f, float compassHeadingDeg) {
    return (f.speed_kmh < DEFAULT_GPS_STATIONARY_KMH) ? compassHeadingDeg : f.course_deg;
}
```

### Pattern 4: Raw MPU6050 accel-only read (hand-rolled, no library)

**What:** WHO_AM_I check, wake, single burst read, magnitude compare.
**When to use:** D-06/D-07's accel-only wake detection.
**Example:**
```cpp
// Source: register addresses cross-checked against InvenSense MPU-6050
// register map via lastminuteengineers.com and controllerstech.com
// tutorials [CITED]. Sensitivity 16384 LSB/g is the MPU6050's default
// ±2g full-scale range (register 0x1C left at power-on-reset value).
bool mpu6050Init(uint8_t addr) {
    Wire.beginTransmission(addr);
    Wire.write(0x75);                 // WHO_AM_I
    if (Wire.endTransmission(false) != 0) return false;
    Wire.requestFrom(addr, (uint8_t)1);
    if (!Wire.available() || Wire.read() != 0x68) return false;

    Wire.beginTransmission(addr);
    Wire.write(0x6B); Wire.write(0x00);   // PWR_MGMT_1 = 0 → wake from sleep
    return Wire.endTransmission() == 0;
}

float mpu6050AccelMagnitudeG(uint8_t addr) {
    Wire.beginTransmission(addr);
    Wire.write(0x3B);                 // ACCEL_XOUT_H
    Wire.endTransmission(false);
    Wire.requestFrom(addr, (uint8_t)6);
    int16_t ax = (Wire.read() << 8) | Wire.read();
    int16_t ay = (Wire.read() << 8) | Wire.read();
    int16_t az = (Wire.read() << 8) | Wire.read();
    float gx = ax / 16384.0f, gy = ay / 16384.0f, gz = az / 16384.0f;
    return sqrtf(gx*gx + gy*gy + gz*gz);
}
```

### Pattern 5: Calibration offsets via Preferences (D-09)

**What:** A dedicated namespace, written only from the "cal" serial command handler, read once at boot.
**When to use:** Hard-iron min/max offset persistence.
**Example:**
```cpp
// Source: Arduino-ESP32 Preferences API [CITED: docs.espressif.com/projects/
// arduino-esp32 Preferences]. Use a namespace distinct from any other module's
// (e.g. "magcal") — Preferences only holds one namespace open at a time per
// object instance.
#include <Preferences.h>
Preferences magPrefs;

void saveMagCalibration(float xMin, float xMax, float yMin, float yMax) {
    magPrefs.begin("magcal", false);
    magPrefs.putFloat("xMin", xMin);
    magPrefs.putFloat("xMax", xMax);
    magPrefs.putFloat("yMin", yMin);
    magPrefs.putFloat("yMax", yMax);
    magPrefs.end();
}

void loadMagCalibration(float &xMin, float &xMax, float &yMin, float &yMax) {
    magPrefs.begin("magcal", true);   // read-only
    xMin = magPrefs.getFloat("xMin", 0.0f);
    xMax = magPrefs.getFloat("xMax", 0.0f);
    yMin = magPrefs.getFloat("yMin", 0.0f);
    yMax = magPrefs.getFloat("yMax", 0.0f);
    magPrefs.end();
}
```

### Anti-Patterns to Avoid

- **Porting `ani_sensor.cpp`'s `while (!available) delay(10)` wait loop verbatim:** That pattern blocks for up to 1000ms with nothing competing for the CPU on the AirQ node. On the GPS tracker, a 1000ms block can overflow the 256-byte/~266ms GPS UART ring buffer several times over, silently dropping NMEA sentences. Any "wait for sensor ready" loop on this firmware needs an upper bound far below that, or must not block at all (poll a "ready" flag across `loop()` iterations instead of spinning inside one call).
- **Setting `Wire.setClock()` per-sensor:** Arduino's `Wire`/`TwoWire` is a single global bus instance — the last `setClock()` call wins for every device until changed again. Pick one clock speed for the whole 4-module bus (400kHz recommended; the pinout doc's own note that the parallel pull-ups sit around ~1-2kΩ supports 400kHz, but documents 100kHz as the fallback if the bench bus proves unreliable with all 4 modules attached).
- **Introducing a second heading-threshold constant instead of reusing `DEFAULT_GPS_STATIONARY_KMH`:** see Pattern 3 — this is a real single-source-of-truth trap, not a hypothetical one, since the user's own D-08 wording ("~3 km/h") already matches the existing constant's value.

## Don't Hand-Roll

| Problem | Don't Build | Use Instead | Why |
|---|---|---|-----|
| SSD1306 low-level init/contrast/addressing sequences | A raw I2C SSD1306 command sequence from the datasheet | U8g2 | Dozens of clone-panel quirks (different reset sequences, contrast defaults) are already handled; hand-rolling reintroduces bugs this library fixed years ago |
| HMC5883L vs QMC5883L register-map differences and heading math | A custom dual-branch driver reading raw registers for each chip | `DFRobot_QMC5883` | The two chips have different addresses, register maps, *and* output scaling — the library already normalizes this into one `getHeadingDegrees()` call, exactly D-11's requirement |
| NVS/flash-backed key-value calibration storage | Raw flash-partition read/write for the mag offsets | `Preferences` (built-in) | Wear-leveling, crash-safety, and the key/value API are already solved at the ESP-IDF NVS layer — hand-rolling flash writes for 4 floats is pure risk for zero benefit |
| HTU21D's CRC-checked I2C read protocol and 12/14-bit resolution config | A custom I2C sequence per the HTU21D datasheet | `Adafruit HTU21DF Library` | Small, single-purpose, already handles the sensor's specific command/response timing |

**Key insight:** The one place this phase *should* hand-roll (MPU6050 raw accel read) is a deliberate exception, not a contradiction of the rule above — it is justified because the phase's actual requirement (D-07: accel magnitude only, no gyro, no DMP) is genuinely smaller than what any available library provides, and pulling in a full-featured library would add flash/RAM cost with no corresponding feature use. Don't generalize this exception to the OLED, compass, or humidity sensors — those all involve real protocol/format complexity (font rendering, dual-chip register maps, CRC framing) that a library correctly owns.

## Common Pitfalls

### Pitfall 1: Blocking I2C reads starve the GPS UART buffer

**What goes wrong:** `gps_reader.poll()` drains a ~256-byte software ring buffer every `loop()` call (Arduino-ESP32 default `HardwareSerial` RX buffer size). At 9600 baud that buffer fills in ~266ms. Any I2C peripheral call that blocks for a comparable or larger duration — repeated often enough, or stacked with others in the same `loop()` pass — causes dropped NMEA bytes, manifesting as `REJECT_STALE`/`REJECT_NO_FIX` in the existing gate-counter `[HEALTH]` log.
**Why it happens:** This repo already has a working reference implementation of exactly the anti-pattern to avoid: `firmware/node/src/ani_sensor.cpp`'s `ani_read()` contains `while (!s_ens.available() && millis() < deadline) { delay(10); }` with a 1000ms deadline, and `Adafruit_HTU21DF`'s own `readTemperature()`/`readHumidity()` internally call `delay(50)` while waiting for conversion. Copying the AirQ pattern's philosophy ("just wait until the sensor answers") onto a firmware with a time-critical UART consumer is the natural but wrong instinct.
**How to avoid:** Schedule each peripheral independently via `millis()`-based timers (Pattern 1) so at most one "slow" (10-50ms) blocking call happens per `loop()` iteration, and space the slowest one (HTU21D, ~50ms per read) several seconds apart (`DEFAULT_HTU21_POLL_MS` ≈ 3000-5000ms is a comfortable margin against the ~266ms buffer budget). Never adopt a `while(...) delay(10)` spin with a deadline anywhere near or above ~100-150ms on this firmware.
**Warning signs:** `[HEALTH]` line's `no_fix=`/`stale=` counters climbing after peripherals are wired in, when they were flat during Phase 1 bench testing; NMEA checksum failures (`gpsReader.failedChecksum()`) increasing.

### Pitfall 2: `Wire` is a single global bus — one clock speed for 4 different chips

**What goes wrong:** Calling `Wire.setClock()` inside one sensor's driver (e.g. if a pulled-in library sets its own preferred speed on `begin()`) silently changes the speed for every other device on the bus until something else changes it back — this exact defensive re-set pattern already exists in `ani_sensor.cpp` (`Wire.begin(sda_pin, scl_pin); Wire.setClock(50000);` called again *after* each library's own `begin()`, specifically to undo a speed change a library init made).
**Why it happens:** Arduino's I2C abstraction models one `TwoWire` object per bus, not per device — libraries that call `Wire.setClock()` internally (common in display/sensor libraries as a defensive "make sure it's fast enough" measure) can override whatever the application chose.
**How to avoid:** Set `Wire.setClock(DEFAULT_I2C_CLOCK_HZ)` once after every `.begin()` call that might have touched it (mirroring `ani_sensor.cpp`'s existing restore-after-init pattern), and pick one speed (400kHz recommended) that all 4 datasheets support rather than the AirQ node's conservative 50kHz choice — the pinout doc's own note about the combined ~1-2kΩ parallel pull-up already anticipates 400kHz operation, with 100kHz documented as the explicit fallback if the bench bus misbehaves with all 4 modules attached.
**Warning signs:** One sensor's readings become intermittently garbled/NACKed only after a *different* sensor's driver is added to the build — a signature of an unexpected clock-speed change.

### Pitfall 3: I2C bus hang / clock-stretch stall with no timeout

**What goes wrong:** The Arduino-ESP32 `Wire`/`TwoWire` implementation has historically shipped with I2C transaction code that can loop without a timeout if a device holds SCL low (clock stretching) or the bus otherwise locks up — a documented, long-standing issue (`espressif/arduino-esp32#349`), though recent cores default to a 50ms bus timeout. A single glitchy module (loose wire, brief brownout) can therefore hang the entire `loop()`, which — per Pitfall 1 — directly threatens the GPS pipeline.
**Why it happens:** I2C is an open-drain, multi-master-capable bus by design; a slave device malfunctioning mid-transaction (or a floating SDA/SCL from a loose bench wire, explicitly a real risk here per D-13's own framing) can leave the line stuck low with no protocol-level guarantee the master's driver recovers gracefully.
**How to avoid:** Implement D-13's own requirement properly: track consecutive I2C errors (`Wire.endTransmission()` return code != 0, or `Wire.requestFrom()` returning fewer bytes than requested) per module, mark that module offline after N consecutive failures (a small N like 3-5 is a reasonable starting point `[ASSUMED]`), and retry re-init on a ~10s timer rather than every loop. If a full bus lock-up is observed on the bench (not just one bad device), the documented I2C-spec recovery is toggling SCL manually for up to 9 clock pulses to un-stick a slave holding SDA low — worth keeping as a documented fallback, not necessarily implementing preemptively unless bench testing shows it's needed.
**Warning signs:** The whole firmware appears to freeze (LED stops blinking, no new `[HEALTH]` lines) rather than just one sensor's readings going stale — that asymmetry (one bad wire freezing everything vs. only that sensor's feature disabling) is the signal that timeout/recovery is missing or insufficient.

### Pitfall 4: Cadence's documented single-call-site contract needs a deliberate, visible extension for D-05

**What goes wrong:** `cadence.h`'s own header comment states: *"the only call site is main.cpp's single GateResult::ACCEPT branch, never anywhere else, so an ungated fix can never reach this state machine and flip moving/stationary."* D-05 requires an accel-derived signal to flip STATIONARY→MOVING *outside* that GPS-fix-gated path. If this is implemented by quietly adding a second call path without updating the class's own documented invariant, a future contributor (or this project's own future phases) reading that comment will believe an invariant holds that no longer does.
**Why it happens:** The path of least resistance is to add an `if (accelWake) cadence.forceState(MOVING)`-style shortcut directly in `main.cpp` without touching `cadence.h`/`cadence.cpp`'s contract or its documentation, because the existing code is well-factored and "just calling a new method" feels non-invasive.
**How to avoid:** Treat this as a deliberate, documented contract change: add an explicit new entry point (e.g. `Cadence::onAccelWake()`) alongside `onGatedFix()`, update the class-level comment to state both call sites and their asymmetric authority (accel can only promote STATIONARY→MOVING; only a GPS-gated fix via `onGatedFix()` can demote MOVING→STATIONARY, per D-05), and keep the demotion path exactly as today (`onGatedFix()`'s hysteresis/debounce unchanged). This keeps the state machine's logic auditable rather than accreting undocumented side-entry points.
**Warning signs:** Code review or a future phase finds two different places that can flip `cadence.state()`, with only one of them mentioned in the class's own documentation.

### Pitfall 5: New "cal" serial command collides with the existing single-character bench-sim hotkey dispatch

**What goes wrong:** `main.cpp`'s `loop()` currently reads one character at a time from `Serial` and dispatches immediately (`r`, `h`, `s`, `+`, `-`, `x`, `z`, `b` are all live single-key hotkeys). D-09 specifies a literal `"cal"` command — a 3-character sequence — typed over the same USB serial connection. Naively extending the existing per-character `switch` cannot represent a multi-character command without either colliding with the single-char scheme (e.g., a bare `'c'` keystroke would need to *not* fire anything by itself while the parser waits to see if `'a'` and `'l'` follow) or breaking backward compatibility with the existing hotkeys.
**Why it happens:** The existing bench harness protocol was designed before any multi-character command existed; grafting one on requires a small state machine (accumulate characters, compare against `"cal"`, timeout/reset on a non-matching or delayed sequence) that doesn't currently exist anywhere in this codebase to copy from.
**How to avoid:** Design this explicitly as a small addition — e.g., buffer incoming characters into a short fixed-size ring, and only after a line terminator (`\n`) or a short inter-character timeout, compare the accumulated buffer against `"cal"`; single characters that don't build up to a recognized multi-char command still fall through to the existing single-char `switch` unchanged. Keep this as a named, testable unit (not inlined ad hoc into the existing `if (c == 'r') ... else simHandleCommand(c)` chain) since it is new command-parsing surface, however small.
**Warning signs:** Typing `"cal"` on the bench serial monitor accidentally also triggers the existing `'c'`-adjacent... (no `'c'` hotkey exists today, but any future single-char addition starting with `c`/`a`/`l` would silently break this if the two schemes aren't cleanly separated).

### Pitfall 6: HTU21D and other libraries' internal `delay()` calls are invisible blocking cost that doesn't show up in a quick read of the calling code

**What goes wrong:** `envSensor.poll()` looks like a simple non-blocking call site at the `main.cpp` level, but `Adafruit_HTU21DF::readTemperature()`/`readHumidity()` each internally call `delay(50)` — a total of up to ~100ms per full temp+humidity read, invisible unless the library's source is actually read (as this research did — see Sources).
**Why it happens:** Arduino sensor libraries commonly hide fixed conversion-wait delays inside otherwise innocuous-looking getter methods; nothing in the public API signature (`float readTemperature()`) signals "this blocks for 50ms."
**How to avoid:** Budget HTU21D's ~100ms combined read cost explicitly against the ~266ms GPS UART buffer window (Pitfall 1) when choosing `DEFAULT_HTU21_POLL_MS`, and read the actual source of any new dependency before assuming a getter is "fast" just because its name suggests a register read.
**Warning signs:** None visible from `main.cpp` alone — this is a "looks done but isn't" pitfall that only bench soak-testing (watching `[HEALTH]`'s NMEA-loss counters specifically in the seconds after an HTU21D read) will surface.

## Code Examples

Verified patterns from official sources (also see the numbered Architecture Patterns above, which contain the primary illustrative snippets for this phase):

### I2C boot scan (established repo pattern)
```cpp
// Source: firmware/node/src/ani_sensor.cpp ani_init(), lines 26-33 (existing
// code in this repo, cited verbatim as the pattern to follow)
for (uint8_t addr = 0x08; addr <= 0x77; addr++) {
    Wire.beginTransmission(addr);
    if (Wire.endTransmission() == 0) {
        ESP_LOGI(TAG, "  found 0x%02X", addr);
    }
}
```

### DFRobot_QMC5883 dual-chip init + heading
```cpp
// Source: DFRobot_QMC5883.h public API, confirmed via direct GitHub source
// fetch (see Sources) — ICType enum (IC_HMC5883L / IC_QMC5883 / IC_VCM5883L)
// and address constants (0x1E / 0x0D / 0x0C) are present in the actual header.
DFRobot_QMC5883 compass(&Wire, /* address is chip-dependent; library handles detection */);
if (compass.begin()) {
    if (compass.isHMC()) { /* HMC5883L detected, 0x1E */ }
    if (compass.isQMC()) { /* QMC5883L detected, 0x0D — the common GY-271 clone */ }
    float headingDeg = compass.getHeadingDegrees();  // add DEFAULT_MAG_DECLINATION per D-10
}
```

## State of the Art

| Old Approach | Current Approach | When Changed | Impact |
|---|---|---|---|
| Assume GY-271 boards ship the genuine HMC5883L | Assume QMC5883L (0x0D) unless proven otherwise — HMC5883L has been discontinued by Honeywell | Ongoing (HMC5883L EOL, exact date not authoritatively found this session) `[CITED: multiple community sources — mischianti.org, zbotic.in — agree HMC5883L is discontinued and most GY-271/GY-273 boards sold today ship QMC5883L]` | D-11's dual-detect requirement is not defensive over-engineering — it is the realistic default for any GY-271 sourced today |
| SPIFFS for flash key-value/config storage | LittleFS or, for small scalar config like calibration offsets, `Preferences`/NVS | Documented in this milestone's own `.planning/research/STACK.md` (SPIFFS deprecated ecosystem-wide) | Not directly this phase's storage (that's the flash track log, Phase 2), but the same rationale applies to why `Preferences`/NVS — not a hand-rolled flash write — is correct for D-09's calibration offsets |

**Deprecated/outdated:**
- Assuming a single fixed I2C address per "compass module" product listing — GY-271/GY-273 boards are a documented case where the silkscreen/listing name (HMC5883L) and the actual populated chip (QMC5883L) diverge; runtime address-based detection (D-11, already locked) is the only reliable approach.

## Assumptions Log

| # | Claim | Section | Risk if Wrong |
|---|---|---|---|
| A1 | Accel wake magnitude threshold ≈ 0.15-0.30g deviation from 1g baseline, with a 3-5 consecutive-sample debounce at ~100ms poll interval | Architecture Patterns / Common Pitfalls (thresholds not yet in a code example, left as `DEFAULT_ACCEL_WAKE_THRESHOLD_G`/`DEFAULT_ACCEL_WAKE_DEBOUNCE_SAMPLES` for planning) | If too low: engine vibration/road bumps falsely trigger "moving" while parked (mirrors PITFALLS.md's existing Pitfall 7 about GPS-jitter false movement, same failure mode via a different sensor). If too high: real stopped→moving transitions miss the instant-wake benefit D-05 exists for. Requires a bench/vehicle soak test to tune, same as this milestone's existing `DEFAULT_GPS_MOVING_KMH`/`DEFAULT_GPS_STATIONARY_KMH` constants were flagged as "research starting points, not final values" in `gps_config.h`. |
| A2 | `DEFAULT_ACCEL_POLL_MS ≈ 100`, `DEFAULT_MAG_POLL_MS ≈ 250`, `DEFAULT_HTU21_POLL_MS ≈ 3000-5000` | Architecture Patterns Pattern 1 | If poll intervals are too tight (especially HTU21D), cumulative blocking time per second approaches the ~266ms GPS UART buffer budget (Pitfall 1/6) and NMEA sentences start dropping under real bench conditions, not just in theory. |
| A3 | I2C bus runs reliably at 400kHz with all 4 modules' parallel pull-ups (~1-2kΩ combined, per the pinout doc's own estimate) on <20cm bench wiring | Standard Stack, Common Pitfalls Pitfall 2 | If the bench bus is unreliable at 400kHz (excess capacitance from 4 modules), the fallback is 100kHz — already documented as a fallback in the pinout doc and here, low risk, but changes the OLED full-frame transfer time budget (roughly 4x longer, still well under the display's 1Hz refresh window). |
| A4 | `N=3-5` consecutive I2C errors before marking a module offline, ~10s retry interval | Common Pitfalls Pitfall 3, D-13 (already locked at "~10s" by the user; N is this research's addition) | Too low N: a single transient glitch marks a healthy module offline needlessly. Too high N: a genuinely disconnected module keeps consuming poll-cycle time attempting doomed transactions for longer than necessary (low-impact given each attempt fails fast). |
| A5 | HMC5883L has been effectively discontinued and most GY-271/GY-273 boards sold today ship QMC5883L | State of the Art | If wrong (i.e., genuine HMC5883L parts are still common), D-11's dual-detect is still correct and harmless — this assumption only affects how much *effort* to invest bench-testing the QMC5883L path specifically, not the underlying architecture decision (which is already locked by the user regardless). |

**If this table is empty:** N/A — see rows above; all are engineering estimates requiring bench validation, consistent with this milestone's own established practice of flagging tunable thresholds as "research starting points, not final values" (see `gps_config.h`'s existing comments on the cadence constants).

## Open Questions

1. **Exact GY-271 module in hand: HMC5883L or QMC5883L?**
   - What we know: The pinout doc already warns most clones ship QMC5883L (0x0D); D-11 already mandates dual-chip support regardless of the answer.
   - What's unclear: Which chip the user's actual bench module contains — determines which code path gets exercised first during bring-up.
   - Recommendation: The boot I2C scan (D-12, already planned) answers this immediately and for free — no separate investigation needed before planning; just don't assume 0x1E-only in any plan task's acceptance criteria.

2. **Does the ESP32-C3's Arduino core version in this project's pinned `espressif32@7.0.1` platform default to a safe (non-zero) I2C bus timeout?**
   - What we know: Recent arduino-esp32 cores default to a 50ms bus timeout per community documentation; older cores had the "no timeout, infinite loop" bug (`espressif/arduino-esp32#349`).
   - What's unclear: Whether `espressif32@7.0.1` (this project's currently installed platform version, confirmed via `pio pkg list -g`) inherits the fixed or unfixed behavior — not verified against that specific version's arduino-esp32 core release notes this session.
   - Recommendation: Treat D-13's error-counting/retry logic as the actual safety net regardless of the underlying core's timeout default — don't depend on the core's internal timeout alone. If a full bus lock-up is observed on the bench, that is the trigger to investigate the core version specifically.

## Environment Availability

| Dependency | Required By | Available | Version | Fallback |
|---|---|---|---|---|
| PlatformIO (`pio`) | Build/flash | Yes | 6.1.19 (at `/home/luc/Dev/aguada-firmware-main/.venv/bin/pio`, not on PATH) | — |
| `espressif32` platform | Build target | Yes | 7.0.1 | — |
| `olikraus/U8g2` | Display driver | Not yet added to `platformio.ini` | ^2.36.18 confirmed on PlatformIO registry | — |
| `dfrobot/DFRobot_QMC5883` | Compass driver | Not yet added to `platformio.ini` | ^1.0.0 confirmed on PlatformIO registry | If unreliable on the actual hardware: fall back to two single-chip libraries selected at runtime by detected address |
| `adafruit/Adafruit HTU21DF Library` | Temp/humidity driver | Not yet added to `platformio.ini` | ^1.1.2 confirmed on PlatformIO registry | SparkFun HTU21D library (functionally equivalent) |
| Physical bench hardware (OLED, MPU6050, HMC/QMC5883, HTU21D modules wired per pinout doc) | All of this phase | Not verifiable by this research session (requires physical bench access) | — | D-12's graceful-degradation design means any subset can be absent and the firmware still builds/runs — this is a design mitigation for exactly this unverifiable dependency |

**Missing dependencies with no fallback:** none — every library dependency has at least a documented fallback path, and the phase's own design (D-12) tolerates missing physical hardware.
**Missing dependencies with fallback:** the 3 new libraries above are not yet in `platformio.ini` (expected — this is a research artifact, not an implementation one) and the compass/humidity libraries each have a named fallback if bench testing surfaces a problem.

## Security Domain

This phase is offline embedded firmware with no network stack (ESP-NOW/WiFi/protocol v3 are explicitly out of scope for this milestone per `CLAUDE.md`), so most ASVS web-application categories do not apply. The only realistic attack surface is physical: USB serial access to the bench harness, and the I2C bus itself.

### Applicable ASVS Categories

| ASVS Category | Applies | Standard Control |
|---|---|---|
| V2 Authentication | No | No user accounts, no network exposure this phase |
| V3 Session Management | No | N/A |
| V4 Access Control | No | Physical possession of the USB cable *is* the access control model for a bench device; no additional control is proportionate at this phase |
| V5 Input Validation | Yes | The new `"cal"` serial command parser (Pitfall 5) must bound its input buffer (fixed-size, e.g. 4-8 bytes) and reject/reset on garbage input rather than overrun — same discipline as any embedded command parser, regardless of ASVS framing |
| V6 Cryptography | No | Calibration offsets (a few floats) are not sensitive data; no cryptographic requirement |

### Known Threat Patterns for this stack

| Pattern | STRIDE | Standard Mitigation |
|---|---|---|
| Malformed/partial serial input to the new "cal" command corrupts calibration state or overruns a fixed buffer | Tampering / Denial of Service (bench-only) | Fixed-size input buffer with explicit length check before comparison, per Pitfall 5's recommended design; on overflow, discard and reset the buffer rather than write past it |
| A glitching I2C module (bad wire, brownout) causes a bus lock-up that halts the whole firmware, including GPS logging | Denial of Service | D-13's error-counting/offline/retry design (Common Pitfalls Pitfall 3) — the GPS pipeline's correctness must never depend on I2C bus health |

## Sources

### Primary (HIGH confidence)
- `raw.githubusercontent.com/DFRobot/DFRobot_QMC5883/master/DFRobot_QMC5883.h` — direct source fetch confirming `ICType` enum and 0x1E/0x0D/0x0C address constants (D-11 verification)
- `raw.githubusercontent.com/adafruit/Adafruit_HTU21DF_Library/master/Adafruit_HTU21DF.cpp` — direct source fetch confirming `delay(50)`-based (not hold-master) conversion wait and `Adafruit_BusIO`/`Adafruit_I2CDevice` dependency
- PlatformIO registry (`pio pkg search` / `pio pkg show`, run live 2026-08-03) for `olikraus/U8g2`, `dfrobot/DFRobot_QMC5883`, `adafruit/Adafruit HTU21DF Library`, `adafruit/Adafruit SSD1306`, `adafruit/Adafruit GFX Library`, `adafruit/Adafruit BusIO` — version, publish date, stars, popularity, repository URL
- This repo's own `firmware/node/src/ani_sensor.cpp`/`.h` — the established I2C init/scan/health-flag pattern this phase's bus manager should follow (and the blocking-wait anti-pattern it should specifically avoid)
- This repo's own `firmware/gps_tracker/src/{main,cadence,gps_reader}.cpp`/`.h`, `include/gps_config.h` — existing pipeline contract, existing `DEFAULT_*` constants (notably `DEFAULT_GPS_STATIONARY_KMH`, directly reusable for D-08), existing non-blocking timer pattern
- `firmware/gps_tracker/gps_tracker_pinout.md` — canonical Fase 01.1 wiring section (pins, addresses, pull-up note)
- `docs.espressif.com/projects/arduino-esp32` Preferences and I2C API references — cited via WebSearch result excerpts, not directly fetched this session

### Secondary (MEDIUM confidence)
- WebSearch: QMC5883L vs HMC5883L register/address differences, GY-271 clone prevalence (mischianti.org, zbotic.in, forum.arduino.cc, github.com/dthain/QMC5883L)
- WebSearch: ESP32 Arduino `HardwareSerial` default 256-byte RX buffer size, hardware-FIFO-to-software-buffer relationship, `setRxBufferSize()` mitigation
- WebSearch: ESP32 Arduino `Wire`/`TwoWire` I2C bus lock-up/clock-stretching history (`espressif/arduino-esp32#349`), 50ms default bus timeout
- WebSearch: ElectronicCats/MPU6050 fork rationale vs original jrowberg/i2cdevlib on ESP32
- WebSearch: U8g2 full-buffer vs page-buffer RAM tradeoff, `sendBuffer()` timing order-of-magnitude (14-18ms for a smaller display, used as a directional estimate for 128×64)

### Tertiary (LOW confidence)
- WebSearch: MPU6050 raw register addresses (WHO_AM_I 0x75, PWR_MGMT_1 0x6B, ACCEL_XOUT_H 0x3B) — cross-checked across two independent tutorial sources (lastminuteengineers.com, controllerstech.com) but not against the InvenSense datasheet PDF directly this session
- Accel wake threshold/debounce numeric starting points (A1 in Assumptions Log) — engineering estimate by analogy to this milestone's own existing GPS-speed hysteresis constants, not sourced from a specific reference design

## Metadata

**Confidence breakdown:**
- Standard stack (library choices/versions): HIGH — every recommended package's existence, version, and (for the two most decision-critical ones, DFRobot_QMC5883 and Adafruit HTU21DF) actual source code were verified this session, not recalled from training data
- Architecture (scheduling, cadence contract extension, heading arbiter): MEDIUM-HIGH — grounded directly in this repo's existing, read code (`main.cpp`, `cadence.h/.cpp`, `gps_reader.cpp`, `ani_sensor.cpp`), not generic embedded-systems advice
- Pitfalls: MEDIUM-HIGH for the blocking/UART-budget and Wire-global-clock pitfalls (directly demonstrated by this repo's own existing code); LOW-MEDIUM for exact numeric thresholds (accel wake magnitude/debounce), which are explicitly flagged as assumptions requiring bench validation

**Research date:** 2026-08-03
**Valid until:** ~30 days for library version pins (PlatformIO registry moves faster than embedded hardware behavior); the architectural/pitfall findings tied to this repo's own existing code remain valid until that code itself changes
