lucianoET/aguada-firmware/.planning/phases/01.1-perifericos-i2c-e-display/01.1-DISCUSSION-LOG.md

# Phase 01.1: Periféricos I2C e Display - Discussion Log

> **Audit trail only.** Do not use as input to planning, research, or execution agents.
> Decisions are captured in CONTEXT.md — this log preserves the alternatives considered.

**Date:** 2026-08-03
**Phase:** 01.1-perifericos-i2c-e-display
**Areas discussed:** Display content & UX, MPU6050 → cadence, Heading (HMC5883), Sensor roles & failure policy

---

## Display content & UX

| Option | Description | Selected |
|---|---|---|
| Single dense status screen | Everything at glance: fix/sats/HDOP, speed, heading, temp/hum, cadence state | ✓ |
| Auto-rotating pages | 2-3 pages cycling every few seconds | |
| Button-cycled pages | Boot button (GPIO9) cycles pages | |

| Option | Description | Selected |
|---|---|---|
| 1 Hz (GPS-aligned) | Refresh with each GPS fix | ✓ |
| ~4-5 Hz | Snappier heading/motion readout | |
| Event-driven | Redraw only on change | |

| Option | Description | Selected |
|---|---|---|
| Live acquisition status | NO FIX + sats + uptime + live sensors | ✓ |
| Dashes for GPS fields | Same layout, "--" on GPS fields | |
| Splash until first fix | Dedicated boot/search screen | |

| Option | Description | Selected |
|---|---|---|
| km/h + degrees° + cardinal | Vehicle-oriented | |
| Knots + degrees | Boat-oriented | |
| Build-flag selectable | DEFAULT_SPEED_UNIT flag, km/h default | ✓ |

**User's choice:** Single dense screen, 1 Hz, live acquisition status when no fix, build-flag speed unit.

---

## MPU6050 → cadence

| Option | Description | Selected |
|---|---|---|
| Hybrid: accel wakes, GPS confirms | Accel detects stationary→moving instantly; GPS authority for moving→stationary | ✓ |
| AND-gate stationary | Stopped only when GPS low AND accel quiet | |
| Telemetry-only this phase | Cadence untouched | |

| Option | Description | Selected |
|---|---|---|
| Poll accel over I2C | Magnitude each loop, software threshold + debounce | ✓ |
| MPU INT pin + polling | Hardware motion interrupt on freed GPIO | |
| You decide | | |

| Option | Description | Selected |
|---|---|---|
| Claude's discretion, DEFAULT_* flags | Values decided in planning, exposed as build_flags | ✓ |
| Discuss values now | | |

**User's choice:** Hybrid accel-wake/GPS-confirm, polled I2C, tuning at Claude's discretion. Gyro unused this phase.

---

## Heading (HMC5883)

| Option | Description | Selected |
|---|---|---|
| Compass when slow, GPS when moving | Blend by speed threshold | ✓ |
| Compass always | Magnetometer sole source | |
| Display-only compass | Raw compass on OLED only | |

| Option | Description | Selected |
|---|---|---|
| Serial-cmd cal → NVS | "cal" via USB serial, min/max offsets to NVS | ✓ |
| Build-flag offsets | Baked constants | |
| None in v1 | Raw heading | |

| Option | Description | Selected |
|---|---|---|
| Flat-mount assumption v1 | No tilt math | ✓ |
| Tilt-compensated | Accel pitch/roll correction | |
| You decide | | |

**User's choice:** Speed-blended heading source, serial calibration persisted to NVS, flat mount. Declination via DEFAULT_MAG_DECLINATION (0 default). QMC5883L fallback support noted (D-11).

---

## Sensor roles & failure policy

| Option | Description | Selected |
|---|---|---|
| Graceful: any subset works | Boot I2C scan; missing → feature off, rest runs | ✓ |
| All required | Halt/alert if any missing | |
| GPS+OLED required, sensors optional | Display mandatory | |

| Option | Description | Selected |
|---|---|---|
| Display + serial only | HTU21 read + shown; log/MQTT later | ✓ |
| Also expose for future log | Pre-wire Phase 2 struct | |

| Option | Description | Selected |
|---|---|---|
| Auto-recover, periodic retry | Offline after N errors, re-init every ~10 s | ✓ |
| Offline until reboot | | |
| You decide | | |

**User's choice:** Full graceful degradation, HTU21 display+serial only, auto-recovery on runtime failure.

**Notes:** Mid-discussion, user requested the bench wiring doc — `gps_tracker_pinout.md` gained section "Fase 01.1 — Barramento I2C (MONTAR AGORA)".

---

## Claude's Discretion

- Motion thresholds (accel magnitude, debounce, quiet window) as DEFAULT_* build_flags
- Module libraries (U8g2 vs Adafruit SSD1306, MPU/HMC/QMC/HTU drivers)
- Dense screen layout details and bench serial log format
- I2C retry/backoff and bus recovery details
- Per-sensor read frequency

## Deferred Ideas

- Tilt-compensated compass (boat heel)
- MPU INT pin as deep-sleep wake source (PWR-03, v2)
- HTU21/heading into flash log & MQTT (Phases 2/3)
- Button (GPIO9) page cycling if single screen gets cramped
