lucianoET/aguada-firmware/.planning/phases/01-gps-acquisition-adaptive-cadence/01-01-PLAN.md

---
phase: 01-gps-acquisition-adaptive-cadence
plan: 01
type: execute
wave: 1
depends_on: []
files_modified:
  - firmware/gps_tracker/include/gps_config.h
  - firmware/gps_tracker/include/gps_types.h
  - firmware/gps_tracker/src/gps_reader.h
  - firmware/gps_tracker/src/gps_reader.cpp
  - firmware/gps_tracker/src/fix_gate.h
  - firmware/gps_tracker/src/fix_gate.cpp
  - firmware/gps_tracker/src/main.cpp
autonomous: true
requirements: [GPS-01, GPS-02]
must_haves:
  truths:
    - "Bench operator sees one structured line per GPS fix on USB serial 115200 carrying lat, lon, altitude, speed, course and a UTC timestamp."
    - "A fix that is stale, has no GGA fix quality, sits at (0,0), has HDOP above the limit, too few satellites, an invalid UTC date, or implies an impossible jump is printed as a REJECT with a named reason and does not propagate downstream."
    - "A fix frozen by loss of satellite lock stops being accepted within GPS freshness window, even though TinyGPSPlus still reports it valid."
    - "Firmware still builds and runs unchanged on both the ESP32-C3 SuperMini bench board and the ESP32 DevKit target board."
  artifacts:
    - firmware/gps_tracker/include/gps_config.h
    - firmware/gps_tracker/include/gps_types.h
    - firmware/gps_tracker/src/gps_reader.h
    - firmware/gps_tracker/src/gps_reader.cpp
    - firmware/gps_tracker/src/fix_gate.h
    - firmware/gps_tracker/src/fix_gate.cpp
  key_links:
    - "gps_reader is the only owner of the UART and of the TinyGPSPlus parser instance; main.cpp reaches GPS state exclusively through the Fix snapshot."
    - "fix_gate evaluates the immutable Fix snapshot (not live parser state), so the GGA fix-quality accessor's updated-flag side effect can never reorder or corrupt a gate decision."
    - "main.cpp calls the downstream consumer only inside the GateResult::ACCEPT branch — this is the structural guarantee that Phase 2's logger and Plan 02's cadence never see an ungated fix."
---

<objective>
Turn the hardware-validated monolithic bench sketch into the two-module gated acquisition path this milestone depends on: `gps_reader` (owns UART + parser, emits an immutable `Fix` snapshot) and `fix_gate` (pure accept/reject decision over that snapshot). After this plan the bench operator can watch, per fix, whether the tracker trusts it and exactly why not when it does not.

Purpose: every later phase (flash logging, sync, HA map, GPX) inherits whatever quality this gate has. A stale or spoofed fix admitted here is a corrupted trajectory nobody can repair downstream.
Output: `include/gps_config.h`, `include/gps_types.h`, `src/gps_reader.{h,cpp}`, `src/fix_gate.{h,cpp}`, and a rewired `src/main.cpp` printing per-fix ACCEPT/REJECT lines plus a periodic health line.
</objective>

<execution_context>
@$HOME/.claude/gsd-core/workflows/execute-plan.md
@$HOME/.claude/gsd-core/templates/summary.md
</execution_context>

<context>
@.planning/PROJECT.md
@.planning/ROADMAP.md
@.planning/STATE.md
@.planning/phases/01-gps-acquisition-adaptive-cadence/01-CONTEXT.md
@.planning/phases/01-gps-acquisition-adaptive-cadence/01-RESEARCH.md
@.planning/phases/01-gps-acquisition-adaptive-cadence/SKELETON.md
@firmware/gps_tracker/src/main.cpp
@firmware/gps_tracker/platformio.ini
@firmware/gps_tracker/gps_tracker_pinout.md
@firmware/node/include/node_config.h
</context>

## Phase Goal (MVP user story)

**As a** bench operator building the Aguada GPS tracker, **I want to** watch a live stream of GPS fixes on USB serial where each one is visibly accepted or rejected with a named quality reason, **so that** I can trust that only trustworthy positions will ever reach the flash log in Phase 2.

> Derived from the ROADMAP Phase 1 `**Goal:**` line, which is not yet written in canonical user-story form. Run `/gsd mvp-phase 1` if you want that line canonicalised in ROADMAP.md.

## Artifacts this phase produces

New symbols and files created by Phase 1 (nothing below exists in the repo today — do not treat them as drift):

**Files (Plan 01)**
- `firmware/gps_tracker/include/gps_config.h`
- `firmware/gps_tracker/include/gps_types.h`
- `firmware/gps_tracker/src/gps_reader.h`, `firmware/gps_tracker/src/gps_reader.cpp`
- `firmware/gps_tracker/src/fix_gate.h`, `firmware/gps_tracker/src/fix_gate.cpp`

**Files (Plan 02)**
- `firmware/gps_tracker/src/cadence.h`, `firmware/gps_tracker/src/cadence.cpp`
- `firmware/gps_tracker/BENCH.md`

**Types / enums**
- `Fix` (struct), `GateResult` (enum class), `CadenceAction` (enum class), `CadenceState` (enum class)
- `GateResult` members: `ACCEPT`, `REJECT_NO_FIX`, `REJECT_STALE`, `REJECT_NULL_ISLAND`, `REJECT_TIME`, `REJECT_HDOP`, `REJECT_SATS`, `REJECT_WARMUP`, `REJECT_OUTLIER_JUMP`
- `CadenceAction` members: `EMIT`, `EMIT_HEARTBEAT`, `SUPPRESS_STATIONARY`, `SUPPRESS_INTERVAL`
- `CadenceState` members: `MOVING`, `STATIONARY`

**Classes / functions**
- `GpsReader` with `begin()`, `poll(Fix&)`, `bytesRead()`, `passedChecksum()`, `failedChecksum()`, `receiving()`
- `FixGate` with `evaluate(const Fix&)`, `reset()`
- `Cadence` with `onGatedFix(const Fix&)`, `state()`, `secondsSinceEmit()`
- Free functions `gateResultName(GateResult)`, `cadenceStateName(CadenceState)`, `cadenceActionName(CadenceAction)`

**Build-flag-overridable constants (all `#ifndef`-guarded in `include/gps_config.h`)**
- `DEFAULT_GPS_FRESH_MS`, `DEFAULT_GPS_HDOP_MAX`, `DEFAULT_GPS_SATS_MIN`, `DEFAULT_GPS_WARMUP_FIXES`, `DEFAULT_GPS_MAX_PLAUSIBLE_KMH`, `DEFAULT_GPS_MIN_UTC_YEAR`
- `DEFAULT_GPS_MOVING_KMH`, `DEFAULT_GPS_STATIONARY_KMH`, `DEFAULT_GPS_DEBOUNCE_FIXES`, `DEFAULT_GPS_CADENCE_MOVING_S`, `DEFAULT_GPS_STATIONARY_HEARTBEAT_S`
- `DEFAULT_GPS_HEALTH_PERIOD_MS`, `GPS_BENCH_SIM`

**Serial line prefixes (the phase's observable contract)**
- `[FIX]`, `[ACCEPT]`, `[REJECT]`, `[EMIT]`, `[SUPPRESS]`, `[STATE]`, `[HEALTH]`, `[SIM]`, `[HELP]`

## Multi-Source Coverage Audit (whole phase, both plans)

| Source | Item | Covered by | Status |
|---|---|---|---|
| GOAL | SC1 — parses NMEA, exposes lat/lon/speed/altitude/course + UTC timestamp | 01-01 Task 1 | COVERED |
| GOAL | SC2 — poor-quality fixes discarded before log and before cadence | 01-01 Task 2 | COVERED |
| GOAL | SC3 — ~5-10 s pacing while moving, acceptance pauses while stationary | 01-02 Task 1 | COVERED |
| REQ | GPS-01 | 01-01 Task 1 | COVERED |
| REQ | GPS-02 | 01-01 Task 2 | COVERED |
| REQ | GPS-03 | 01-02 Task 1 | COVERED |
| RESEARCH | `gps_reader` module (owns UART + parser, exposes Fix) | 01-01 Task 1 | COVERED |
| RESEARCH | `fix_gate` module (multi-criteria accept/reject) | 01-01 Task 2 | COVERED |
| RESEARCH | `cadence` module (speed-based, hysteresis + debounce) | 01-02 Task 1 | COVERED |
| RESEARCH | Pattern 1 — `isValid()` is a one-way latch; must pair with `age()` | 01-01 Task 2 | COVERED |
| RESEARCH | Pitfall 2 — HDOP/sats commit independently of location freshness | 01-01 Task 1 (single-instant snapshot) + Task 2 | COVERED |
| RESEARCH | Pitfall 5 — hysteresis band + debounce, not a single threshold | 01-02 Task 1 | COVERED |
| RESEARCH | Don't hand-roll — use `TinyGPSPlus::distanceBetween` for the jump check | 01-01 Task 2 | COVERED |
| RESEARCH | Don't hand-roll — no NMEA re-parsing, no baud/protocol probing | 01-01 Task 1 | COVERED |
| RESEARCH | Pitfall 4 — confirm ATGM336H/NEO-6M talker prefixes on a real capture | 01-01 Task 1 human-check | COVERED |
| RESEARCH | Open Q1 — stationary heartbeat vs pure suppression | 01-02 Task 1 (suppression default, constant exposed at 0) | COVERED |
| RESEARCH | Open Q2 — accept GGA fix quality >= 1 (GPS) | 01-01 Task 2 | COVERED |
| RESEARCH | Security V5 — NMEA is untrusted input, never bypass checksummed state | 01-01 Task 1/2 + `<threat_model>` | COVERED |
| RESEARCH | Assumptions A1-A5 — thresholds are starting points needing field tuning | 01-02 Task 2 (BENCH.md records observed values) | COVERED |
| CONTEXT | D-01 — ESP32 DevKit classic is the target board | Both plans build `esp32-devkit` (GPIO16/17, LED 2) in every verify | COVERED |
| CONTEXT | D-02 — NMEA-agnostic, no mandatory UBX/CASIC commands | 01-01 Task 1 (reader never transmits to the GPS UART) | COVERED |
| CONTEXT | D-03 — 9600 baud, 1 Hz default, no module reconfiguration | 01-01 Task 1 (existing `-DGPS_BAUD=9600` kept, freshness window sized for 1 Hz) | COVERED |
| CONTEXT | D-04 — pinout per `gps_tracker_pinout.md`, LED status, USB 115200 | 01-01 Task 1 (LED status behaviour preserved and re-driven from gate result) | COVERED |
| CONTEXT | D-05 — standalone PlatformIO project under `firmware/gps_tracker/` | All files under that directory | COVERED |
| CONTEXT | Discretion — cadence parameters | 01-02 Task 1 | COVERED |
| CONTEXT | Discretion — gating criteria (HDOP, sats, warmup, (0,0)) | 01-01 Task 2 | COVERED |
| CONTEXT | Discretion — bench serial log format and `src/` module layout | 01-01 Task 1/2, 01-02 Task 1/2 | COVERED |
| CONTEXT | Discretion — confirm TinyGPSPlus works with ATGM336H | 01-01 Task 1 human-check | COVERED |

Exclusions (not gaps): CONTEXT Deferred Ideas (OLED/buttons/buzzer/NMEA-out/IMU, GPS proprietary power-save, PPS) are v2 and intentionally absent. Flash logging, WiFi/MQTT and power belong to Phases 2/3/5.

<tasks>

<task type="auto">
  <name>Task 1: gps_reader module — UART + parser ownership behind an immutable Fix snapshot (GPS-01)</name>

  <files>
    firmware/gps_tracker/include/gps_config.h,
    firmware/gps_tracker/include/gps_types.h,
    firmware/gps_tracker/src/gps_reader.h,
    firmware/gps_tracker/src/gps_reader.cpp,
    firmware/gps_tracker/src/main.cpp
  </files>

  <read_first>
    - `firmware/gps_tracker/src/main.cpp` — the working bench sketch being refactored; keep its UART begin sequence, raw-echo toggle and LED behaviour intact.
    - `firmware/gps_tracker/platformio.ini` — the pin/baud macros already supplied per env (`GPS_UART_NUM`, `GPS_RX_PIN`, `GPS_TX_PIN`, `GPS_BAUD`, `LED_PIN`, `LED_ACTIVE_LOW`). Do not rename or duplicate these.
    - `firmware/node/include/node_config.h` — the repo's constant convention this task must copy: `#ifndef DEFAULT_X` / `#define DEFAULT_X value`, per-target `#if defined(CONFIG_IDF_TARGET_ESP32C3)` blocks where pins differ.
    - `firmware/gps_tracker/gps_tracker_pinout.md` — canonical pin map: DevKit uses UART2 GPIO16 (RX) / GPIO17 (TX) with LED GPIO2; C3 SuperMini uses UART1 GPIO20 (RX) / GPIO21 (TX) with LED GPIO8 active-high.
    - `.planning/phases/01-gps-acquisition-adaptive-cadence/01-RESEARCH.md` — the TinyGPSPlus accessor table (freshness lifecycles per field group) and the note that the GGA fix-quality accessor has an updated-flag side effect.
  </read_first>

  <action>
Create `include/gps_config.h` holding every tunable as an `#ifndef DEFAULT_GPS_*` / `#define` pair so `platformio.ini` `build_flags` can override any of them without editing source — same shape as `firmware/node/include/node_config.h`. Define in this task: `DEFAULT_GPS_FRESH_MS` 2500, `DEFAULT_GPS_MIN_UTC_YEAR` 2024, `DEFAULT_GPS_HEALTH_PERIOD_MS` 5000, and `GPS_BENCH_SIM` 1. Add a header comment stating that `GPS_BENCH_SIM` must be set to 0 before any networked build (Phase 3 onward).

Create `include/gps_types.h` defining the `Fix` struct — the immutable snapshot that is this phase's contract with Phase 2 — with exactly these fields: `double lat`, `double lon`, `float speed_kmh`, `float course_deg`, `float alt_m`, `float hdop`, `uint8_t sats`, `uint8_t fix_quality`, `uint32_t utc_unix`, `uint32_t age_ms`, `uint32_t mono_ms`. Field notes to encode as comments: `utc_unix` is seconds since the Unix epoch derived from the GPS date+time (0 when the date or time is not yet valid); `age_ms` is the parser-reported location age at snapshot time; `mono_ms` is `millis()` at snapshot time and is what all interval arithmetic uses (never `utc_unix`, which can jump when the receiver first acquires date). Guard the header with `#pragma once` and include `<stdint.h>`.

Create `src/gps_reader.h` / `src/gps_reader.cpp` declaring `class GpsReader` as the sole owner of the `HardwareSerial` instance and of the TinyGPSPlus parser object. Public API: `void begin()` (starts the UART with `GPS_BAUD, SERIAL_8N1, GPS_RX_PIN, GPS_TX_PIN` on `GPS_UART_NUM`, and starts nothing else), `bool poll(Fix &out)`, `uint32_t bytesRead()`, `uint32_t passedChecksum()`, `uint32_t failedChecksum()`, `bool receiving()`, plus `void setRawEcho(bool)` / `bool rawEcho()` to preserve the existing `r` serial toggle. `poll()` drains every available byte into the parser, echoes raw characters to `Serial` when raw echo is on, updates the last-byte timestamp, and then — this ordering is mandatory — checks the parser's location `isUpdated()` flag exactly once; only when that flag is set does it fill `out` from a single consistent read of the parser and return true, otherwise it returns false. Reading `isUpdated()` first is what prevents the GGA fix-quality accessor (which consumes the updated flag as a side effect) from being able to swallow a new-fix edge.

Populate the snapshot inside `poll()` from these accessors, each guarded by its own validity check with the documented fallback: location lat/lng (fallback 0.0), speed km/h, course degrees, altitude metres, HDOP (fallback a sentinel above any plausible value, e.g. 99.9f, so an absent HDOP is later rejected rather than silently accepted), satellite count (fallback 0), the GGA fix-quality enum cast to `uint8_t` (fallback 0 = invalid), location age in ms, and `millis()`. Compute `utc_unix` from the parser's date and time only when both report valid and the year is at least `DEFAULT_GPS_MIN_UTC_YEAR`; otherwise set it to 0. Implement the epoch conversion as a small static days-from-civil helper in `gps_reader.cpp` (no external time library, no `mktime`, no timezone handling — the value is pure UTC seconds).

`GpsReader::begin()` must transmit nothing to the GPS module: no UBX, no CASIC, no PMTK, no baud probing. This is decision D-02 (both ATGM336H and NEO-6M must work from the same binary with plain NMEA at 9600 baud, D-03). Add a one-line comment at the top of `gps_reader.cpp` recording that the module is used read-only by design.

Rewrite `src/main.cpp` as the bench harness on top of `GpsReader`: instantiate the reader, `begin()` it in `setup()` alongside `Serial.begin(115200)` and the LED pin, keep the `r` raw-echo toggle, and in `loop()` call `poll()`. On each true return, print one line beginning with the literal `[FIX]` containing t (utc_unix), lat and lon at 6 decimals, alt in metres at 1 decimal, spd in km/h at 1 decimal, crs in degrees at 0 decimals, hdop at 1 decimal, sats, q (fix_quality) and age in ms. Keep a periodic health line beginning with `[HEALTH]` every `DEFAULT_GPS_HEALTH_PERIOD_MS` reporting bytes, passed-checksum count, failed-checksum count, sats and hdop, and whether bytes are currently arriving. Keep the existing LED semantics for now (solid when a fresh fix exists, blinking while NMEA arrives without a fix, dark with no data) — Task 2 re-sources that "fresh fix" condition from the gate. main.cpp must reach GPS state only through `GpsReader` and the `Fix` struct; it must not call TinyGPSPlus accessors directly.

Both PlatformIO envs must keep building untouched: no changes to `platformio.ini` are needed or permitted in this task — the existing `-D` pin/baud flags and the `mikalhart/TinyGPSPlus @ ^1.0.3` pin already match the pinout doc and D-03/D-04.
  </action>

  <acceptance_criteria>
    - `cd firmware/gps_tracker && pio run -e esp32-c3-supermini` exits 0.
    - `cd firmware/gps_tracker && pio run -e esp32-devkit` exits 0.
    - `grep -c 'ifndef DEFAULT_GPS_' firmware/gps_tracker/include/gps_config.h` returns at least 3.
    - `grep -Ec 'lat|lon|speed_kmh|course_deg|alt_m|hdop|sats|fix_quality|utc_unix|age_ms|mono_ms' firmware/gps_tracker/include/gps_types.h` returns at least 11.
    - `grep -c 'isUpdated' firmware/gps_tracker/src/gps_reader.cpp` returns at least 1.
    - `grep -c 'GpsReader' firmware/gps_tracker/src/main.cpp` returns at least 1.
    - `git diff --stat -- firmware/gps_tracker/platformio.ini` reports no changes.
    - Source review: `src/main.cpp` contains no direct TinyGPSPlus accessor call — every GPS value it prints comes from a `Fix` field or a `GpsReader` counter method.
    - Source review: `GpsReader::begin()` and `GpsReader::poll()` contain no write/print call targeting the GPS UART object (read-only module use, D-02).
  </acceptance_criteria>

  <verify>
    <automated>cd firmware/gps_tracker && pio run -e esp32-c3-supermini && pio run -e esp32-devkit && grep -c 'isUpdated' src/gps_reader.cpp && grep -c 'ifndef DEFAULT_GPS_' include/gps_config.h</automated>
    <human-check>
      Flash the bench board (`pio run -e esp32-c3-supermini -t upload --upload-port /dev/ttyACM0`) and open `pio device monitor`.
      1. With raw echo on, confirm NMEA sentences arrive and note which talker prefixes appear (expect `$GN`/`$GP` for RMC and GGA; a non-standard `$BD` GSV variant on the ATGM336H is harmless and expected to be ignored). Repeat the capture with the second GPS module to confirm one binary serves both (D-02).
      2. Press `r` to silence raw echo and confirm `[FIX]` lines appear at roughly 1 Hz once satellites lock, with lat/lon near the known bench coordinates (about -22.9199, -43.2150), a plausible altitude, and `t=` a large non-zero epoch value rather than 0.
      3. Confirm `[HEALTH]` prints every 5 s and that its failed-checksum counter still increments harmlessly while the known-intermittent TX wire is unsoldered — no reboot, no garbage `[FIX]` values.
    </human-check>
  </verify>

  <done>
    Both envs compile. On hardware, one `[FIX]` line per fix carries all six GPS-01 fields plus a real UTC epoch timestamp, sourced entirely through `GpsReader`/`Fix`, with both GPS modules working from the same binary.
  </done>
</task>

<task type="auto">
  <name>Task 2: fix_gate module — reject stale, implausible and low-quality fixes before anything downstream (GPS-02)</name>

  <files>
    firmware/gps_tracker/include/gps_config.h,
    firmware/gps_tracker/include/gps_types.h,
    firmware/gps_tracker/src/fix_gate.h,
    firmware/gps_tracker/src/fix_gate.cpp,
    firmware/gps_tracker/src/main.cpp
  </files>

  <read_first>
    - `firmware/gps_tracker/include/gps_types.h` and `firmware/gps_tracker/include/gps_config.h` — as written by Task 1; the gate consumes the `Fix` snapshot and extends the constant set.
    - `firmware/gps_tracker/src/main.cpp` — as rewired by Task 1; this task inserts the gate between `poll()` and the print.
    - `.planning/phases/01-gps-acquisition-adaptive-cadence/01-RESEARCH.md` — Pattern 1 (the `isValid()` one-way latch and why `age()` is the only staleness signal), Pattern 2 (the multi-criteria gate), Pitfall 2 (HDOP/satellite freshness lifecycle differs from location), Open Question 2 (accept GGA fix quality >= 1), and the Security Domain section.
    - `firmware/node/src/sensor_filter.h` — the repo's existing outlier-reject-then-threshold filter shape this gate mirrors conceptually for GPS.
  </read_first>

  <action>
Extend `include/gps_config.h` with the gate tunables, same `#ifndef DEFAULT_GPS_*` shape: `DEFAULT_GPS_HDOP_MAX` 5.0f, `DEFAULT_GPS_SATS_MIN` 4, `DEFAULT_GPS_WARMUP_FIXES` 3, `DEFAULT_GPS_MAX_PLAUSIBLE_KMH` 200.0f. Comment each with the fact that these are research starting points (Assumptions A1, A2, A4) to be tuned against field data, not final values.

Extend `include/gps_types.h` with `enum class GateResult : uint8_t` whose members are exactly `ACCEPT`, `REJECT_NO_FIX`, `REJECT_STALE`, `REJECT_NULL_ISLAND`, `REJECT_TIME`, `REJECT_HDOP`, `REJECT_SATS`, `REJECT_WARMUP`, `REJECT_OUTLIER_JUMP`, and declare `const char *gateResultName(GateResult);` returning the member name as a string for serial output and for health counters.

Create `src/fix_gate.h` / `src/fix_gate.cpp` declaring `class FixGate` with `GateResult evaluate(const Fix &f)` and `void reset()`. `evaluate()` is a decision function over the snapshot only — it must not touch the parser, the UART, or `Serial`. Apply the criteria in this exact order, returning the first failure:
  1. `f.fix_quality` below 1 → `REJECT_NO_FIX`. GGA fix quality 1 (standalone GPS) is the accept floor; neither target module produces DGPS/SBAS values under decision D-02, so requiring more would reject every real fix (Research Open Question 2).
  2. `f.age_ms` at or above `DEFAULT_GPS_FRESH_MS` → `REJECT_STALE`. This check is mandatory and is the single most important line in the module: the parser's location validity flag latches true on the first fix and is never cleared when lock is lost, so age is the only signal that a position has gone stale.
  3. `f.lat` and `f.lon` both exactly zero → `REJECT_NULL_ISLAND` (explicit null-island guard).
  4. `f.utc_unix` equal to 0 → `REJECT_TIME` (no trustworthy UTC date yet; Phase 2 records must be timestamped).
  5. `f.hdop` greater than `DEFAULT_GPS_HDOP_MAX` → `REJECT_HDOP`.
  6. `f.sats` below `DEFAULT_GPS_SATS_MIN` → `REJECT_SATS`.
  7. Warmup: while fewer than `DEFAULT_GPS_WARMUP_FIXES` consecutive fixes have passed checks 1-6, increment the streak counter and return `REJECT_WARMUP`. Any failure of checks 1-6 resets that streak to zero.
  8. Implausible jump: when a previous accepted fix exists, compute great-circle metres with the static `TinyGPSPlus::distanceBetween` helper (do not hand-roll haversine) and divide by the elapsed `mono_ms` delta; if the implied km/h exceeds `DEFAULT_GPS_MAX_PLAUSIBLE_KMH`, return `REJECT_OUTLIER_JUMP` without updating the stored last-accepted position (so one wild sample cannot poison the reference point).
On `ACCEPT`, store `f.lat`, `f.lon` and `f.mono_ms` as the new last-accepted reference and return `ACCEPT`. `reset()` clears the warmup streak and the last-accepted reference.

Rewire `src/main.cpp` so every snapshot returned by `poll()` goes through `FixGate::evaluate()` before anything else happens with it. Print `[ACCEPT]` followed by the same field set the `[FIX]` line already carried when the result is `ACCEPT`; print `[REJECT] reason=<name> ...` with the name from `gateResultName()` plus hdop, sats, age and quality when it is not. To keep the log readable at 1 Hz, print a `[REJECT]` line only when the reason differs from the previous fix's reason, and carry per-reason counters into the `[HEALTH]` line so a suppressed run is still visible as a rising count. Re-source the LED "has fix" condition from the gate: solid only while the most recent evaluation was `ACCEPT`, blinking while bytes arrive but the last result was a rejection, dark with no data.

Leave a clearly marked single call site immediately inside the `GateResult::ACCEPT` branch where Plan 02 will hand the fix to the cadence module — that branch is the structural guarantee that ungated fixes never reach cadence or, later, the Phase 2 flash logger.
  </action>

  <acceptance_criteria>
    - `cd firmware/gps_tracker && pio run -e esp32-c3-supermini` exits 0.
    - `cd firmware/gps_tracker && pio run -e esp32-devkit` exits 0.
    - `grep -Ec 'ACCEPT|REJECT_NO_FIX|REJECT_STALE|REJECT_NULL_ISLAND|REJECT_TIME|REJECT_HDOP|REJECT_SATS|REJECT_WARMUP|REJECT_OUTLIER_JUMP' firmware/gps_tracker/include/gps_types.h` returns at least 9.
    - `grep -c 'age_ms' firmware/gps_tracker/src/fix_gate.cpp` returns at least 1.
    - `grep -c 'distanceBetween' firmware/gps_tracker/src/fix_gate.cpp` returns at least 1.
    - `grep -Ec 'DEFAULT_GPS_HDOP_MAX|DEFAULT_GPS_SATS_MIN|DEFAULT_GPS_WARMUP_FIXES|DEFAULT_GPS_MAX_PLAUSIBLE_KMH' firmware/gps_tracker/include/gps_config.h` returns at least 8 (declaration plus guard for each).
    - `grep -c 'GateResult::ACCEPT' firmware/gps_tracker/src/main.cpp` returns at least 1.
    - Source review: `fix_gate.cpp` references no `Serial`, no `HardwareSerial` object, and no parser instance — its only library dependency is the static distance helper.
    - Source review: in `main.cpp`, no code path prints an `[ACCEPT]` line or forwards a fix downstream outside the `GateResult::ACCEPT` branch.
  </acceptance_criteria>

  <verify>
    <automated>cd firmware/gps_tracker && pio run -e esp32-c3-supermini && pio run -e esp32-devkit && grep -c 'distanceBetween' src/fix_gate.cpp && grep -c 'GateResult::ACCEPT' src/main.cpp</automated>
    <human-check>
      Flash the bench board and open the monitor.
      1. From cold boot with no satellites, confirm the log shows `[REJECT] reason=REJECT_NO_FIX` (or `REJECT_STALE`) and that the LED blinks rather than staying solid.
      2. As lock is acquired, confirm a short run of `reason=REJECT_WARMUP` before the first `[ACCEPT]`, and that the LED then goes solid.
      3. Cover the antenna (or unplug the GPS TX wire) and confirm that within roughly 2.5 s the log flips to `reason=REJECT_STALE` and the LED stops being solid — proving a frozen fix is no longer accepted even though the parser still reports it valid.
      4. Confirm `[HEALTH]` shows the per-reason reject counters climbing during each of the above states.
    </human-check>
  </verify>

  <done>
    Every fix is evaluated before use; each of the nine gate outcomes is reachable and named in the log; a fix frozen by loss of lock stops being accepted within the freshness window; the only downstream hand-off point sits inside the ACCEPT branch.
  </done>
</task>

</tasks>

<threat_model>
## Trust Boundaries

| Boundary | Description |
|---|---|
| GPS module → ESP32 UART | Untrusted external input crosses here. NMEA characters originate from RF the receiver itself cannot authenticate, and the bench wiring is known-intermittent (10-17% checksum failures until the TX wire is soldered). |
| Firmware → USB serial console | Outbound only in this phase; carries position data to a physically attached operator. |

## STRIDE Threat Register

| Threat ID | Category | Component | Severity | Disposition | Mitigation Plan |
|---|---|---|---|---|---|
| T-01-01 | Tampering | `gps_reader` NMEA ingest | medium | mitigate | All field values are read from TinyGPSPlus committed state, which commits only after per-sentence checksum validation. No module re-parses raw bytes; `fix_gate` receives a snapshot, never the byte stream (ASVS V5). |
| T-01-02 | Tampering | `fix_gate` staleness check | high | mitigate | `REJECT_STALE` on `age_ms >= DEFAULT_GPS_FRESH_MS`. Without it a position frozen by loss of lock passes forever, because the parser's validity flag never returns to false — the highest-impact failure mode in this phase. |
| T-01-03 | Spoofing | `fix_gate` plausibility checks | medium | mitigate | `REJECT_NULL_ISLAND` on exact (0,0) plus `REJECT_OUTLIER_JUMP` when implied speed against the last accepted fix exceeds `DEFAULT_GPS_MAX_PLAUSIBLE_KMH`; the last-accepted reference is not updated on a rejected jump, so a single spoofed sample cannot re-anchor the gate. |
| T-01-04 | Tampering | `fix_gate` UTC timestamp | medium | mitigate | `REJECT_TIME` when `utc_unix` is 0, and the snapshot only sets it when the receiver reports a valid date at or after `DEFAULT_GPS_MIN_UTC_YEAR` — blocks pre-lock default dates from timestamping Phase 2 records. |
| T-01-05 | Denial of Service | `main.cpp` loop / `GpsReader::poll` | low | mitigate | `poll()` drains only currently available bytes and never blocks waiting on the UART; with the GPS unplugged the loop keeps running and `[HEALTH]` reports no bytes arriving. |
| T-01-06 | Information Disclosure | USB serial output | low | accept | Position is printed in clear text to a locally attached USB console. This phase is bench-only with no network and no storage; physical access is already total compromise. Revisit when Phase 3 introduces WiFi. |
| T-01-SC | Tampering | Dependency supply chain | low | accept | No package-manager install occurs in this phase. The single dependency, `mikalhart/TinyGPSPlus @ ^1.0.3` (resolved 1.1.0), is already vendored, hardware-validated, and audited OK in `01-RESEARCH.md` "Package Legitimacy Audit" — no `[ASSUMED]`/`[SUS]`/`[SLOP]` packages exist, so no legitimacy checkpoint is required. |
</threat_model>

<verification>
- Both PlatformIO envs (`esp32-devkit`, `esp32-c3-supermini`) build from a clean `pio run` with no new warnings introduced by these files.
- `include/gps_types.h` declares the `Fix` struct and the nine-member `GateResult` enum; `include/gps_config.h` declares every tunable behind an `#ifndef DEFAULT_GPS_*` guard so `build_flags` can override it.
- `src/fix_gate.cpp` gates on `age_ms` and uses the library's static distance helper for the jump check.
- `src/main.cpp` obtains all GPS state through `GpsReader`/`Fix` and forwards downstream only inside the `GateResult::ACCEPT` branch.
- On hardware: `[ACCEPT]` lines carry all GPS-01 fields with a non-zero UTC epoch; each rejection reason is reachable and named; covering the antenna produces `REJECT_STALE` within the freshness window.
</verification>

<success_criteria>
- GPS-01 satisfied: lat, lon, speed, altitude, course and a UTC timestamp are extracted from NMEA over UART and exposed as one `Fix` snapshot per fix, observable on USB serial at 115200.
- GPS-02 satisfied: fixes failing validity, freshness, null-island, UTC, HDOP, satellite-count, warmup or plausibility checks are rejected with a named reason and never reach the single downstream hand-off point.
- The same binary works with both the ATGM336H and the NEO-6M with no proprietary configuration (D-02) and no `platformio.ini` change.
- `firmware/gps_tracker/` remains a standalone PlatformIO project (D-05) whose pin map matches `gps_tracker_pinout.md` (D-04) at 9600 baud (D-03) on both the DevKit target (D-01) and the C3 bench board.
</success_criteria>

<output>
Create `.planning/phases/01-gps-acquisition-adaptive-cadence/01-01-SUMMARY.md` when done.
</output>
