lucianoET/aguada-firmware/.planning/phases/01-gps-acquisition-adaptive-cadence/01-02-PLAN.md

---
phase: 01-gps-acquisition-adaptive-cadence
plan: 02
type: execute
wave: 2
depends_on: ["01-01"]
files_modified:
  - firmware/gps_tracker/include/gps_config.h
  - firmware/gps_tracker/include/gps_types.h
  - firmware/gps_tracker/src/cadence.h
  - firmware/gps_tracker/src/cadence.cpp
  - firmware/gps_tracker/src/main.cpp
  - firmware/gps_tracker/BENCH.md
autonomous: true
requirements: [GPS-03]
must_haves:
  truths:
    - "While the tracker is moving, exactly one fix is emitted roughly every 8 seconds even though the receiver delivers one fix per second."
    - "While the tracker is stationary, emission stops entirely and the log says so, without the moving/stationary state flapping on GPS speed jitter."
    - "The moving/stationary transition requires several consecutive confirming fixes and a hysteresis gap, so a single jittery sample cannot flip the state."
    - "A bench operator can prove all of the above, plus each gate rejection reason, from a desk with no vehicle, using serial commands."
  artifacts:
    - firmware/gps_tracker/src/cadence.h
    - firmware/gps_tracker/src/cadence.cpp
    - firmware/gps_tracker/BENCH.md
  key_links:
    - "Cadence is fed only from inside the GateResult::ACCEPT branch in main.cpp — an ungated fix can never reach the state machine and flip moving/stationary."
    - "Cadence classifies movement from the receiver's own speed field, never from position deltas, because position deltas alias stationary jitter into false movement."
    - "The bench simulator injects synthetic fixes through the real gate-then-cadence pipeline, so what it proves is the shipping code path, not a parallel test-only path."
---

<objective>
Add the `cadence` module: a speed-driven, hysteresis-debounced state machine that decides which gate-accepted fixes are actually emitted downstream, and give the operator a way to prove it works from a desk. After this plan the tracker paces itself to how the vehicle is really moving — the last piece Phase 2's flash logger needs before it can start writing records.

Purpose: GPS-03 is what keeps the flash log (and later the upload backlog) proportional to real movement instead of burning a record every second while parked.
Output: `src/cadence.{h,cpp}`, cadence tunables in `include/gps_config.h`, `CadenceAction`/`CadenceState` in `include/gps_types.h`, cadence wiring plus a bench simulator in `src/main.cpp`, and `firmware/gps_tracker/BENCH.md` documenting the verification procedure and the field-tuning record.
</objective>

<execution_context>
@$HOME/.claude/gsd-core/workflows/execute-plan.md
@$HOME/.claude/gsd-core/templates/summary.md
</execution_context>

<context>
@.planning/PROJECT.md
@.planning/ROADMAP.md
@.planning/STATE.md
@.planning/phases/01-gps-acquisition-adaptive-cadence/01-CONTEXT.md
@.planning/phases/01-gps-acquisition-adaptive-cadence/01-RESEARCH.md
@.planning/phases/01-gps-acquisition-adaptive-cadence/SKELETON.md
@.planning/phases/01-gps-acquisition-adaptive-cadence/01-01-SUMMARY.md
@firmware/gps_tracker/include/gps_types.h
@firmware/gps_tracker/include/gps_config.h
@firmware/gps_tracker/src/main.cpp
</context>

## Phase Goal (MVP user story)

**As a** bench operator building the Aguada GPS tracker, **I want to** see the tracker emit a position roughly every 8 seconds while it is moving and go quiet while it is parked, **so that** the Phase 2 flash log records the trajectory instead of thousands of identical parked points.

> The full multi-source coverage audit for this phase lives in `01-01-PLAN.md`. The "Artifacts this phase produces" symbol list also lives there and covers both plans — `cadence.h`, `cadence.cpp`, `BENCH.md`, `Cadence`, `CadenceAction`, `CadenceState`, `cadenceStateName`, `cadenceActionName`, `DEFAULT_GPS_MOVING_KMH`, `DEFAULT_GPS_STATIONARY_KMH`, `DEFAULT_GPS_DEBOUNCE_FIXES`, `DEFAULT_GPS_CADENCE_MOVING_S`, `DEFAULT_GPS_STATIONARY_HEARTBEAT_S`, `GPS_BENCH_SIM`, and the `[EMIT]`/`[SUPPRESS]`/`[STATE]`/`[SIM]`/`[HELP]` serial prefixes are all new in Phase 1.

<tasks>

<task type="auto">
  <name>Task 1: cadence module — speed-based, debounced pacing of accepted fixes (GPS-03)</name>

  <files>
    firmware/gps_tracker/include/gps_config.h,
    firmware/gps_tracker/include/gps_types.h,
    firmware/gps_tracker/src/cadence.h,
    firmware/gps_tracker/src/cadence.cpp,
    firmware/gps_tracker/src/main.cpp
  </files>

  <read_first>
    - `firmware/gps_tracker/include/gps_types.h` — the `Fix` struct and `GateResult` enum from Plan 01; cadence consumes `speed_kmh` and `mono_ms` from the snapshot and must not reach past it.
    - `firmware/gps_tracker/include/gps_config.h` — existing `#ifndef DEFAULT_GPS_*` block this task extends with the cadence tunables.
    - `firmware/gps_tracker/src/main.cpp` — the marked hand-off point inside the `GateResult::ACCEPT` branch left by Plan 01 Task 2; that is the only place cadence may be called from.
    - `.planning/phases/01-gps-acquisition-adaptive-cadence/01-RESEARCH.md` — Pattern 3 (hysteresis band plus debounce), Pitfall 5 (bench-observed 2.6 km/h stationary speed jitter is the noise floor the band must clear), Open Question 1 (stationary heartbeat is a product decision), Assumptions A3/A4/A5.
    - `.planning/phases/01-gps-acquisition-adaptive-cadence/01-CONTEXT.md` — "Claude's Discretion" grants the choice of speed thresholds, debounce window, emit interval within 5-10 s, and stationary heartbeat behaviour.
  </read_first>

  <action>
Extend `include/gps_config.h` with the cadence tunables in the established `#ifndef DEFAULT_GPS_*` shape: `DEFAULT_GPS_MOVING_KMH` 5.0f (upper hysteresis edge — must stay clear of the 2.6 km/h stationary jitter observed on the bench), `DEFAULT_GPS_STATIONARY_KMH` 3.0f (lower hysteresis edge; the gap between the two is what prevents flapping), `DEFAULT_GPS_DEBOUNCE_FIXES` 3 (consecutive confirming accepted fixes required before a state flip), `DEFAULT_GPS_CADENCE_MOVING_S` 8 (emit interval while moving — mid-point of the 5-10 s range GPS-03 specifies), and `DEFAULT_GPS_STATIONARY_HEARTBEAT_S` 0. Document that 0 disables the stationary heartbeat, which is the Phase 1 default because GPS-03 only requires that acceptance pauses when parked; the constant exists so Phase 2's logger can turn on a low-rate "still parked" record without touching cadence logic. Repeat the Assumptions A3/A4/A5 caveat in comments: these are starting points pending a multi-hour stationary test in the real mounting location.

Extend `include/gps_types.h` with `enum class CadenceState : uint8_t { MOVING, STATIONARY }` and `enum class CadenceAction : uint8_t { EMIT, EMIT_HEARTBEAT, SUPPRESS_STATIONARY, SUPPRESS_INTERVAL }`, plus declarations of `const char *cadenceStateName(CadenceState);` and `const char *cadenceActionName(CadenceAction);`.

Create `src/cadence.h` / `src/cadence.cpp` declaring `class Cadence` with `CadenceAction onGatedFix(const Fix &f)`, `CadenceState state() const`, `uint32_t secondsSinceEmit() const` and `bool stateChanged()` (a one-shot flag the caller consumes to know a transition just happened). Initial state is `STATIONARY` — a tracker that has just booted has not proven it is moving, and starting in MOVING would emit a burst of parked points.

`onGatedFix()` runs the state machine first, then the pacing decision:
  - Classify the sample: above `DEFAULT_GPS_MOVING_KMH` is a moving vote, below `DEFAULT_GPS_STATIONARY_KMH` is a stationary vote, and anything inside the band is neither.
  - While in `STATIONARY`, count consecutive moving votes; on reaching `DEFAULT_GPS_DEBOUNCE_FIXES`, switch to `MOVING`, clear both streaks and raise the state-changed flag. While in `MOVING`, do the mirror with stationary votes. Any vote that does not confirm the pending transition — including a sample inside the hysteresis band — resets both streaks to zero, so only an uninterrupted run flips the state.
  - Use `f.speed_kmh` as the movement signal. Do not derive movement from the distance between consecutive positions: stationary position wander on these single-frequency receivers reads as continuous slow motion, whereas the receiver's own Doppler-derived speed does not.
  - Pacing: in `MOVING`, emit when `f.mono_ms` minus the last emit time is at least `DEFAULT_GPS_CADENCE_MOVING_S` seconds, otherwise return `SUPPRESS_INTERVAL`. In `STATIONARY`, return `SUPPRESS_STATIONARY` unless `DEFAULT_GPS_STATIONARY_HEARTBEAT_S` is non-zero and that interval has elapsed, in which case return `EMIT_HEARTBEAT`. Any return value that emits updates the last-emit timestamp from `f.mono_ms`; suppressions do not.
  - All interval arithmetic uses `f.mono_ms` (the monotonic millisecond stamp), never `utc_unix`, which jumps discontinuously when the receiver first acquires the date.
  - Emit immediately on the first accepted fix after entering `MOVING` — a transition into movement should produce a point at once rather than waiting out a full interval.

Wire cadence into `src/main.cpp` at the hand-off point Plan 01 left inside the `GateResult::ACCEPT` branch, and nowhere else. Replace the plain `[ACCEPT]` print with the cadence outcome: `[EMIT]` (or `[EMIT] hb=1` for a heartbeat) carrying the full field set plus `state=`, and `[SUPPRESS] reason=<name> spd=... state=...` otherwise. When `stateChanged()` is set, print a `[STATE]` line naming the old and new state, the speed that triggered it, and the elapsed seconds in the previous state. Extend `[HEALTH]` with the current cadence state, seconds since the last emit, and cumulative emit and suppress counts.
  </action>

  <acceptance_criteria>
    - `cd firmware/gps_tracker && pio run -e esp32-c3-supermini` exits 0.
    - `cd firmware/gps_tracker && pio run -e esp32-devkit` exits 0.
    - `grep -Ec 'DEFAULT_GPS_MOVING_KMH|DEFAULT_GPS_STATIONARY_KMH|DEFAULT_GPS_DEBOUNCE_FIXES|DEFAULT_GPS_CADENCE_MOVING_S|DEFAULT_GPS_STATIONARY_HEARTBEAT_S' firmware/gps_tracker/include/gps_config.h` returns at least 10 (guard plus definition for each of the five).
    - `grep -Ec 'MOVING|STATIONARY|EMIT|EMIT_HEARTBEAT|SUPPRESS_STATIONARY|SUPPRESS_INTERVAL' firmware/gps_tracker/include/gps_types.h` returns at least 6.
    - `grep -c 'speed_kmh' firmware/gps_tracker/src/cadence.cpp` returns at least 1.
    - `grep -c 'mono_ms' firmware/gps_tracker/src/cadence.cpp` returns at least 2.
    - `grep -c 'onGatedFix' firmware/gps_tracker/src/main.cpp` returns exactly 1.
    - `grep -n -A6 'GateResult::ACCEPT' firmware/gps_tracker/src/main.cpp` shows that single `onGatedFix` call inside the ACCEPT branch.
    - Source review: `cadence.cpp` contains no `Serial`, no UART object, no parser reference, and no call to the great-circle distance helper — it decides only from `speed_kmh` and `mono_ms`.
    - Source review: `Cadence`'s constructor or member initialisers set the initial state to `STATIONARY`.
  </acceptance_criteria>

  <verify>
    <automated>cd firmware/gps_tracker && pio run -e esp32-c3-supermini && pio run -e esp32-devkit && grep -c 'onGatedFix' src/main.cpp && grep -c 'mono_ms' src/cadence.cpp</automated>
    <human-check>
      Flash the bench board and open the monitor with the antenna at a window.
      1. Sitting still with a lock, confirm the log settles into `[SUPPRESS] reason=SUPPRESS_STATIONARY` with `state=STATIONARY`, and that no `[STATE]` line appears over several minutes — the hysteresis band is holding against real jitter.
      2. Walk or drive the board (or defer this to the simulator in Task 2), and confirm a `[STATE] STATIONARY -> MOVING` line appears only after a few consecutive fast fixes, followed by `[EMIT]` lines spaced about 8 s apart while intervening fixes show `reason=SUPPRESS_INTERVAL`.
      3. Stop and confirm the mirror transition back to `STATIONARY` after the debounce window and that emission ceases.
      4. Confirm `[HEALTH]` reports the state, seconds since last emit, and rising emit/suppress counters.
    </human-check>
  </verify>

  <done>
    Moving emits roughly one fix every 8 s from a 1 Hz input; stationary suppresses entirely; transitions require consecutive confirming fixes across a hysteresis band; cadence is reachable only from the ACCEPT branch.
  </done>
</task>

<task type="auto">
  <name>Task 2: bench simulator and BENCH.md — prove gate and cadence from a desk, record field-tuning evidence</name>

  <files>
    firmware/gps_tracker/src/main.cpp,
    firmware/gps_tracker/BENCH.md
  </files>

  <read_first>
    - `firmware/gps_tracker/src/main.cpp` — as wired by Task 1; the simulator reuses the same gate-then-cadence call path, it does not create a second one.
    - `firmware/gps_tracker/include/gps_types.h` and `firmware/gps_tracker/include/gps_config.h` — the `Fix` fields the simulator must populate and the `GPS_BENCH_SIM` flag introduced in Plan 01 Task 1.
    - `firmware/gps_tracker/gps_tracker_pinout.md` — the wiring the BENCH.md procedure tells the operator to build.
    - `.planning/phases/01-gps-acquisition-adaptive-cadence/01-RESEARCH.md` — Assumptions A1-A5, which BENCH.md turns into an explicit tuning record with a place to write observed values.
  </read_first>

  <action>
Add a bench simulator to `src/main.cpp`, compiled only when `GPS_BENCH_SIM` is non-zero. Its purpose is to make GPS-02 and GPS-03 provable at a desk in minutes instead of requiring a vehicle and a tunnel. It must feed synthesised snapshots through the identical `FixGate::evaluate()` then cadence path the real fixes take — never a shortcut around either — and every line it produces must carry a `[SIM]` marker so synthetic data can never be mistaken for a real fix in a captured log.

Extend the existing single-character serial command handling (which already owns `r` for raw echo) with:
  - `h` — print a `[HELP]` block listing every command.
  - `+` / `-` — raise or lower the simulated speed by 2 km/h, clamped to 0-150, and report the new value.
  - `s` — toggle the simulator on and off; while on, it synthesises one fix per second from a millisecond timer.
  - `x` — inject one implausible jump: the next synthetic fix is displaced far enough from the previous accepted position that the implied speed exceeds `DEFAULT_GPS_MAX_PLAUSIBLE_KMH`, which must surface as `reason=REJECT_OUTLIER_JUMP`.
  - `z` — inject one fix at coordinates (0,0), which must surface as `reason=REJECT_NULL_ISLAND`.
  - `b` — inject one fix with a deliberately bad quality set (HDOP above `DEFAULT_GPS_HDOP_MAX` and satellite count below `DEFAULT_GPS_SATS_MIN`), which must surface as `reason=REJECT_HDOP`.

The synthetic snapshot is built to be plausible so it legitimately passes the gate on the normal path: `age_ms` 0, `fix_quality` 1, `hdop` 1.0f, `sats` 8, `mono_ms` from `millis()`, `utc_unix` from a fixed base epoch plus elapsed seconds, `course_deg` 90, `alt_m` 10, `speed_kmh` from the current simulated speed, and a position advanced from the previous synthetic position along a due-east bearing by exactly the distance that speed implies over the elapsed time. Anchor the first synthetic position at the last real accepted fix when one exists, otherwise at the known bench coordinates (-22.919952, -43.215005). Advancing the position consistently with the reported speed is what keeps the plausibility check honest: a simulator that held position while claiming 60 km/h would prove nothing, and one that teleported would trip the outlier gate on every sample.

While the simulator is on, ignore real fixes from `poll()` for cadence purposes (still count their bytes and checksums into `[HEALTH]`) so the two sources cannot interleave and produce a nonsensical trajectory.

Write `firmware/gps_tracker/BENCH.md` in the documentation style of `gps_tracker_pinout.md` (Portuguese headings, tables), containing:
  - **Montagem** — pointer to `gps_tracker_pinout.md` and the note that the NEO-6M breakout needs 5 V while the ATGM336H runs at 3V3.
  - **Build e flash** — the exact `pio run -e esp32-c3-supermini -t upload --upload-port /dev/ttyACM0` and `pio run -e esp32-devkit -t upload` commands plus `pio device monitor` at 115200.
  - **Comandos da serial** — a table of `r`, `h`, `s`, `+`, `-`, `x`, `z`, `b` and what each proves.
  - **Formato das linhas** — a table of the `[FIX]`, `[ACCEPT]`, `[REJECT]`, `[EMIT]`, `[SUPPRESS]`, `[STATE]`, `[HEALTH]`, `[SIM]` prefixes and their fields, so a captured log is readable months later.
  - **Roteiro de verificação da Fase 1** — a numbered procedure with the expected observation for each of: cold boot with no fix, warmup, first accept, antenna covered producing a stale rejection, each injected rejection reason, stationary suppression, transition to moving, roughly 8 s emit spacing, transition back to stationary. Note which steps use the simulator and which require a real sky view.
  - **Verificação com os dois módulos** — capture raw NMEA from the ATGM336H and from the NEO-6M and record the observed talker prefixes, confirming one binary serves both (D-02).
  - **Registro de calibração de campo** — a table with one row per tunable (`DEFAULT_GPS_HDOP_MAX`, `DEFAULT_GPS_SATS_MIN`, `DEFAULT_GPS_WARMUP_FIXES`, `DEFAULT_GPS_MAX_PLAUSIBLE_KMH`, `DEFAULT_GPS_MOVING_KMH`, `DEFAULT_GPS_STATIONARY_KMH`, `DEFAULT_GPS_DEBOUNCE_FIXES`, `DEFAULT_GPS_CADENCE_MOVING_S`) with columns for the current default, the research assumption ID (A1-A5), the observed field value, and a decision column — left blank for the operator to fill after a multi-hour stationary test in the real mounting location. Record explicitly that every default is an unvalidated starting point, and that any override goes in `platformio.ini` `build_flags` rather than by editing the header.
  - **Nota** — `GPS_BENCH_SIM` must be set to 0 in `build_flags` before any networked build from Phase 3 onward.
  </action>

  <acceptance_criteria>
    - `cd firmware/gps_tracker && pio run -e esp32-c3-supermini` exits 0.
    - `cd firmware/gps_tracker && pio run -e esp32-devkit` exits 0.
    - `grep -c 'GPS_BENCH_SIM' firmware/gps_tracker/src/main.cpp` returns at least 1.
    - `grep -c 'onGatedFix' firmware/gps_tracker/src/main.cpp` still returns exactly 1 — the simulator reuses the existing gate-then-cadence call path rather than adding a second one.
    - `grep -Ec 'Montagem|Build e flash|Comandos da serial|Formato das linhas|Roteiro de verifica|Registro de calibra' firmware/gps_tracker/BENCH.md` returns at least 6.
    - `grep -Ec 'DEFAULT_GPS_HDOP_MAX|DEFAULT_GPS_SATS_MIN|DEFAULT_GPS_WARMUP_FIXES|DEFAULT_GPS_MAX_PLAUSIBLE_KMH|DEFAULT_GPS_MOVING_KMH|DEFAULT_GPS_STATIONARY_KMH|DEFAULT_GPS_DEBOUNCE_FIXES|DEFAULT_GPS_CADENCE_MOVING_S' firmware/gps_tracker/BENCH.md` returns at least 8.
    - `grep -c 'SIM' firmware/gps_tracker/src/main.cpp` returns at least 1.
    - Source review: the synthetic snapshot passes through `FixGate::evaluate()` before reaching cadence, and every simulator output line carries the `[SIM]` marker.
  </acceptance_criteria>

  <verify>
    <automated>cd firmware/gps_tracker && pio run -e esp32-c3-supermini && pio run -e esp32-devkit && test "$(grep -c 'onGatedFix' src/main.cpp)" = "1" && grep -c 'GPS_BENCH_SIM' src/main.cpp && grep -Ec 'Roteiro de verifica|Registro de calibra' BENCH.md</automated>
    <human-check>
      Flash the bench board, open the monitor, press `h` and follow `BENCH.md`'s "Roteiro de verificação da Fase 1" end to end.
      1. Press `s` to start the simulator at 0 km/h and confirm `[SIM]` lines show `state=STATIONARY` with `reason=SUPPRESS_STATIONARY`.
      2. Press `+` repeatedly past 5 km/h and confirm a `[STATE] STATIONARY -> MOVING` line appears only after 3 consecutive confirming fixes, then `[EMIT]` about every 8 s with `SUPPRESS_INTERVAL` in between.
      3. Press `-` back below 3 km/h and confirm the mirror transition and that emission stops.
      4. Press `x`, `z` and `b` in turn and confirm `REJECT_OUTLIER_JUMP`, `REJECT_NULL_ISLAND` and `REJECT_HDOP` each appear, and that the next normal synthetic fix is accepted again.
      5. Press `s` to stop the simulator and confirm real fixes resume driving the pipeline.
      6. Fill in the "Registro de calibração de campo" observed-value column in `BENCH.md` after a stationary run long enough to see the real speed-jitter ceiling.
    </human-check>
  </verify>

  <done>
    Every gate rejection reason and every cadence transition is reproducible at a desk via serial commands through the shipping code path; `BENCH.md` documents the procedure, the log format, and an explicit place to record field-tuned thresholds.
  </done>
</task>

</tasks>

<threat_model>
## Trust Boundaries

| Boundary | Description |
|---|---|
| GPS module → ESP32 UART | Unchanged from Plan 01: untrusted, checksum-validated NMEA. |
| USB serial console → firmware command handler | New inbound direction. Single-character operator commands can synthesise fixes that traverse the real gate-and-cadence pipeline. |

## STRIDE Threat Register

| Threat ID | Category | Component | Severity | Disposition | Mitigation Plan |
|---|---|---|---|---|---|
| T-01-07 | Spoofing | Bench simulator injecting synthetic fixes | medium | mitigate | Simulator is compiled out entirely when `GPS_BENCH_SIM` is 0; `BENCH.md` and the `gps_config.h` header comment both require setting it to 0 before any networked build from Phase 3 onward. Every synthetic line carries a `[SIM]` marker so a captured log is never ambiguous, and real fixes are ignored while the simulator runs so the two sources cannot interleave. |
| T-01-08 | Tampering | Serial command handler | low | mitigate | The handler accepts only single known characters and ignores everything else; the simulated speed is clamped to 0-150 km/h. There is no buffered string parsing, so no length-dependent input handling exists to overflow. |
| T-01-09 | Tampering | Cadence state machine fed by an ungated fix | medium | mitigate | Structural: `onGatedFix` appears exactly once in `main.cpp`, inside the `GateResult::ACCEPT` branch, and the acceptance criteria assert that count is exactly 1. The simulator routes through the same branch rather than adding a second call site. |
| T-01-10 | Denial of Service | Stationary flapping burning emits | low | mitigate | Hysteresis band plus a `DEFAULT_GPS_DEBOUNCE_FIXES` streak requirement; any non-confirming sample resets the streak, so a jittering receiver at the boundary cannot oscillate the state and emit continuously. |
| T-01-SC | Tampering | Dependency supply chain | low | accept | No package-manager install occurs in this plan; no new dependency is added. See `01-01-PLAN.md` for the full rationale and the `01-RESEARCH.md` legitimacy audit. |
</threat_model>

<verification>
- Both PlatformIO envs build clean.
- `include/gps_config.h` carries all five cadence tunables behind `#ifndef DEFAULT_GPS_*` guards; `include/gps_types.h` declares `CadenceState` and `CadenceAction`.
- `src/cadence.cpp` decides from `speed_kmh` and `mono_ms` only, with no I/O, no parser access, and no distance computation.
- `onGatedFix` appears exactly once in `src/main.cpp`, inside the `GateResult::ACCEPT` branch.
- On hardware: stationary holds `SUPPRESS_STATIONARY` with no state flapping; moving emits about every 8 s; transitions require the debounce streak; the simulator reproduces every rejection reason and both transitions.
- `BENCH.md` documents assembly, build/flash, serial commands, log line formats, the Phase 1 verification script, the two-module confirmation, and the field-calibration record.
</verification>

<success_criteria>
- GPS-03 satisfied: while moving, a fix is emitted roughly every 8 s (inside the 5-10 s range the requirement specifies) from a 1 Hz input; while stationary, emission pauses entirely.
- Movement classification comes from the receiver's speed field with a hysteresis band clear of the bench-observed 2.6 km/h jitter and a multi-fix debounce, so the state does not flap while parked.
- Cadence is unreachable except through the gate's ACCEPT branch, keeping the Phase 2 flash logger's future input clean by construction.
- A bench operator can prove every gate rejection reason and every cadence transition without a vehicle, and has a written procedure and calibration record in `firmware/gps_tracker/BENCH.md`.
</success_criteria>

<output>
Create `.planning/phases/01-gps-acquisition-adaptive-cadence/01-02-SUMMARY.md` when done.
</output>
