lucianoET/aguada-firmware/docs/superpowers/plans/2026-03-23-aguada-web.md

# Aguada Web Implementation Plan

> **For agentic workers:** REQUIRED SUB-SKILL: Use superpowers:subagent-driven-development (recommended) or superpowers:executing-plans to implement this plan task-by-task. Steps use checkbox (`- [ ]`) syntax for tracking.

**Goal:** Criar sistema web standalone em Docker para monitoramento de reservatórios de água do CMASM — lê dados do gateway ESP32-S3 via USB serial, armazena em SQLite, e serve dashboard web em tempo real com 5 páginas, incluindo geração de relatório PDF diário.

**Architecture:** Bridge thread Python lê JSON do serial (ou simula), calcula nível/volume, grava em SQLite e notifica clientes via WebSocket. FastAPI serve API REST + WebSocket. Nginx serve frontend HTML estático. Dois containers Docker Compose.

**Tech Stack:** Python 3.12, FastAPI, aiosqlite, pyserial, WeasyPrint, APScheduler, paho-mqtt (opcional). Frontend: HTML + Tailwind CSS CDN + Alpine.js + Chart.js. Nginx. Docker Compose.

**Spec:** `docs/superpowers/specs/2026-03-23-aguada-web-design.md`

---

## Mapa de Arquivos

```
aguada-web/
├── backend/
│   ├── main.py           # FastAPI app: rotas REST, WebSocket, startup bridge + scheduler
│   ├── bridge.py         # Thread serial: lê JSON → calcula → SQLite → notifica WS
│   ├── db.py             # Schema SQLite, init_db(), queries (get_state, insert_reading, etc.)
│   ├── calc.py           # Funções puras: level_cm, pct, volume_l, consumption_events, decimate
│   ├── report.py         # Geração HTML de relatório + WeasyPrint PDF + scheduler job
│   └── reservoirs.yaml   # Parâmetros dos reservatórios (chaves lowercase: "0x7758")
├── frontend/
│   ├── index.html        # Dashboard tempo real (WebSocket)
│   ├── scada.html        # Diagrama SCADA SVG
│   ├── history.html      # Gráficos históricos (Chart.js)
│   ├── consumption.html  # Balanço hídrico (Chart.js)
│   └── report.html       # Preview + download PDF
├── tests/
│   ├── test_calc.py      # Testes unitários de calc.py
│   ├── test_db.py        # Testes de db.py com SQLite em memória
│   ├── test_api.py       # Testes de integração das rotas FastAPI
│   └── conftest.py       # Fixtures compartilhadas (app TestClient, db em memória)
├── docker-compose.yml
├── Dockerfile
├── nginx.conf
├── requirements.txt
└── .env.example
```

**Regras de responsabilidade:**
- `calc.py` — funções puras, sem I/O. Testável sem banco.
- `db.py` — todo acesso ao SQLite. Sem lógica de negócio.
- `bridge.py` — orquestra: serial → calc → db → ws notify. Não faz cálculos diretos.
- `main.py` — rotas, WebSocket manager, startup/shutdown. Não acessa banco diretamente.
- `report.py` — gera HTML string + chama WeasyPrint. Recebe dados via parâmetro.

---

## Task 1: Estrutura do projeto e dependências

**Files:**
- Create: `aguada-web/requirements.txt`
- Create: `aguada-web/.env.example`
- Create: `aguada-web/backend/reservoirs.yaml`

- [ ] **Step 1.1: Criar pasta principal**

```bash
mkdir -p aguada-web/backend aguada-web/frontend aguada-web/tests aguada-web/data/reports
cd aguada-web
```

- [ ] **Step 1.2: Criar `requirements.txt`**

```
fastapi==0.115.6
uvicorn[standard]==0.32.1
aiosqlite==0.20.0
pyserial==3.5
pyyaml==6.0.2
paho-mqtt==2.1.0
weasyprint==62.3
apscheduler==3.10.4
httpx==0.27.2
pytest==8.3.4
pytest-asyncio==0.24.0
```

- [ ] **Step 1.3: Criar `.env.example`**

```
SERIAL_PORT=/dev/ttyUSB0
DATA_DIR=/data
TZ=America/Sao_Paulo
MQTT_HOST=
MQTT_PORT=1883
MQTT_USER=
MQTT_PASS=
```

- [ ] **Step 1.4: Criar `backend/reservoirs.yaml` com chaves lowercase**

Copiar conteúdo de `tools/reservoirs.yaml` convertendo todas as chaves para lowercase e `volume_max_L` para `volume_max_l`:

```yaml
reservoirs:
  "0x7758":
    - sensor_id: 1
      alias: CON
      name: Castelo de Consumo
      level_max_cm: 450
      volume_max_l: 80000
      sensor_offset_cm: 20

  "0xee02":
    - sensor_id: 1
      alias: CAV
      name: Castelo de Incêndio
      level_max_cm: 450
      volume_max_l: 80000
      sensor_offset_cm: 20

  "0x2ec4":
    - sensor_id: 1
      alias: CB31
      name: Casa de Bombas Nº3-1
      level_max_cm: 200
      volume_max_l: 40000
      sensor_offset_cm: 10
    - sensor_id: 2
      alias: CB32
      name: Casa de Bombas Nº3-2
      level_max_cm: 200
      volume_max_l: 40000
      sensor_offset_cm: 10

  "0x9eac":
    - sensor_id: 1
      alias: CIE1
      name: Cisterna IE-1
      level_max_cm: 200
      volume_max_l: 245000
      sensor_offset_cm: 10
    - sensor_id: 2
      alias: CIE2
      name: Cisterna IE-2
      level_max_cm: 200
      volume_max_l: 245000
      sensor_offset_cm: 10

  "0x3456":
    - sensor_id: 1
      alias: CBIF1
      name: Casa de Bombas IF-1
      level_max_cm: 200
      volume_max_l: 40000
      sensor_offset_cm: 10
    - sensor_id: 2
      alias: CBIF2
      name: Casa de Bombas IF-2
      level_max_cm: 200
      volume_max_l: 40000
      sensor_offset_cm: 10
```

- [ ] **Step 1.5: Instalar dependências localmente para desenvolvimento**

```bash
cd aguada-web
python3 -m venv .venv
source .venv/bin/activate
pip install -r requirements.txt
```

- [ ] **Step 1.6: Commit**

```bash
git add aguada-web/
git commit -m "feat(aguada-web): scaffold project structure and dependencies"
```

---

## Task 2: Cálculos puros (`calc.py`)

**Files:**
- Create: `aguada-web/backend/calc.py`
- Create: `aguada-web/tests/test_calc.py`

- [ ] **Step 2.1: Escrever testes de `calc.py`**

```python
# tests/test_calc.py
import pytest
from backend.calc import calc_level, calc_consumption_events, decimate_readings

def test_calc_level_normal():
    result = calc_level(distance_cm=215, level_max_cm=450, sensor_offset_cm=20)
    # level = clamp(450 - (215 - 20), 0, 450) = clamp(255, 0, 450) = 255
    assert result["level_cm"] == pytest.approx(255.0)
    assert result["pct"] == pytest.approx(255 / 450 * 100, rel=1e-4)
    assert result["volume_l"] == pytest.approx(255 / 450 * 80000, rel=1e-4)

def test_calc_level_clamp_zero():
    # sensor muito longe → level negativo → clamp para 0
    result = calc_level(distance_cm=500, level_max_cm=200, sensor_offset_cm=10)
    assert result["level_cm"] == 0.0
    assert result["pct"] == 0.0

def test_calc_level_clamp_max():
    # sensor muito perto → level > max → clamp para max
    result = calc_level(distance_cm=0, level_max_cm=200, sensor_offset_cm=10)
    assert result["level_cm"] == 200.0
    assert result["pct"] == 100.0

def test_calc_level_error_distance():
    # distance_cm = None (erro do sensor)
    result = calc_level(distance_cm=None, level_max_cm=200, sensor_offset_cm=10)
    assert result["level_cm"] is None
    assert result["pct"] is None

def test_consumption_events_classifies_consumption():
    # delta < -50 → consumption
    readings = [
        {"ts": 3600, "volume_l": 45000},
        {"ts": 7100, "volume_l": 43000},
    ]
    events = calc_consumption_events(readings, date="2026-03-23")
    assert len(events) == 1
    assert events[0]["type"] == "consumption"
    assert events[0]["delta_l"] == pytest.approx(-2000)

def test_consumption_events_classifies_supply():
    # delta > 50 → supply
    readings = [
        {"ts": 3600, "volume_l": 43000},
        {"ts": 7100, "volume_l": 50000},
    ]
    events = calc_consumption_events(readings, date="2026-03-23")
    assert events[0]["type"] == "supply"

def test_consumption_events_classifies_stable():
    # |delta| <= 50 → stable
    readings = [
        {"ts": 3600, "volume_l": 45000},
        {"ts": 7100, "volume_l": 45030},
    ]
    events = calc_consumption_events(readings, date="2026-03-23")
    assert events[0]["type"] == "stable"

def test_decimate_passthrough_if_under_limit():
    readings = [{"ts": i, "volume_l": i * 10, "level_cm": i, "pct": i * 0.1}
                for i in range(100)]
    result = decimate_readings(readings, max_points=500)
    assert result == readings

def test_decimate_reduces_to_max_points():
    readings = [{"ts": i, "volume_l": i * 10, "level_cm": i, "pct": i * 0.1}
                for i in range(1000)]
    result = decimate_readings(readings, max_points=500)
    assert len(result) <= 500
```

- [ ] **Step 2.2: Rodar testes — verificar que falham**

```bash
cd aguada-web
source .venv/bin/activate
python -m pytest tests/test_calc.py -v 2>&1 | head -30
```

Esperado: `ModuleNotFoundError` ou `ImportError` — `calc.py` não existe ainda.

- [ ] **Step 2.3: Criar `backend/calc.py`**

```python
# backend/calc.py
"""Funções puras de cálculo — sem I/O, sem banco."""
from __future__ import annotations
import math
from typing import Optional

def calc_level(
    distance_cm: Optional[float],
    level_max_cm: float,
    sensor_offset_cm: float,
    volume_max_l: float = 0,
) -> dict:
    """Calcula level_cm, pct e volume_l a partir da distância medida."""
    if distance_cm is None:
        return {"level_cm": None, "pct": None, "volume_l": None}

    level = level_max_cm - (distance_cm - sensor_offset_cm)
    level = max(0.0, min(float(level_max_cm), level))
    pct = level / level_max_cm * 100.0
    volume = pct / 100.0 * volume_max_l
    return {"level_cm": round(level, 1), "pct": round(pct, 2), "volume_l": round(volume, 1)}

def calc_consumption_events(readings: list[dict], date: str) -> list[dict]:
    """
    Agrupa leituras por hora e retorna eventos de consumo/abastecimento.
    Cada reading deve ter: {ts (unix int), volume_l}.
    """
    from collections import defaultdict
    import datetime

    buckets: dict[int, list[dict]] = defaultdict(list)
    for r in readings:
        hour = datetime.datetime.fromtimestamp(r["ts"]).hour
        buckets[hour].append(r)

    events = []
    for hour in sorted(buckets.keys()):
        pts = sorted(buckets[hour], key=lambda x: x["ts"])
        vol_start = pts[0]["volume_l"]
        vol_end = pts[-1]["volume_l"]
        delta = vol_end - vol_start
        if delta < -50:
            etype = "consumption"
        elif delta > 50:
            etype = "supply"
        else:
            etype = "stable"
        events.append({
            "hour": f"{hour:02d}:00",
            "vol_start": round(vol_start, 1),
            "vol_end": round(vol_end, 1),
            "delta_l": round(delta, 1),
            "type": etype,
        })
    return events

def decimate_readings(readings: list[dict], max_points: int = 500) -> list[dict]:
    """
    Decimação por média de intervalo.
    Se len(readings) <= max_points, retorna sem modificação.
    Caso contrário, divide em max_points intervalos e retorna a média de volume_l por intervalo.
    """
    n = len(readings)
    if n <= max_points:
        return readings

    bucket_size = n / max_points
    result = []
    for i in range(max_points):
        start = int(i * bucket_size)
        end = int((i + 1) * bucket_size)
        bucket = readings[start:end]
        if not bucket:
            continue
        mid = bucket[len(bucket) // 2]
        avg_volume = sum(r["volume_l"] for r in bucket) / len(bucket)
        avg_level = sum(r["level_cm"] for r in bucket if r.get("level_cm")) / len(bucket)
        avg_pct = sum(r["pct"] for r in bucket if r.get("pct")) / len(bucket)
        result.append({
            "ts": mid["ts"],
            "volume_l": round(avg_volume, 1),
            "level_cm": round(avg_level, 1),
            "pct": round(avg_pct, 2),
        })
    return result
```

- [ ] **Step 2.4: Rodar testes — verificar que passam**

```bash
python -m pytest tests/test_calc.py -v
```

Esperado: todos os testes `PASSED`.

- [ ] **Step 2.5: Commit**

```bash
git add aguada-web/backend/calc.py aguada-web/tests/test_calc.py
git commit -m "feat(aguada-web): calc.py — level, consumption events, decimate"
```

---

## Task 3: Banco de dados (`db.py`)

**Files:**
- Create: `aguada-web/backend/db.py`
- Create: `aguada-web/tests/test_db.py`
- Create: `aguada-web/tests/conftest.py`

- [ ] **Step 3.1: Criar `tests/conftest.py`**

```python
# tests/conftest.py
import asyncio
import pytest
import pytest_asyncio
import aiosqlite
from backend.db import init_db

@pytest.fixture
def event_loop():
    loop = asyncio.new_event_loop()
    yield loop
    loop.close()

@pytest_asyncio.fixture
async def db(tmp_path):
    db_path = str(tmp_path / "test.db")
    async with aiosqlite.connect(db_path) as conn:
        await init_db(conn)
        yield conn
```

- [ ] **Step 3.2: Escrever testes de `db.py`**

```python
# tests/test_db.py
import time
import pytest
import pytest_asyncio
from backend.db import init_db, insert_reading, upsert_state, get_all_states, get_history

@pytest.mark.asyncio
async def test_init_db_creates_tables(db):
    async with db.execute("SELECT name FROM sqlite_master WHERE type='table'") as cur:
        tables = {row[0] async for row in cur}
    assert "readings" in tables
    assert "reservoir_state" in tables

@pytest.mark.asyncio
async def test_insert_reading(db):
    now = int(time.time())
    await insert_reading(db, {
        "ts": now, "node_id": "0x7758", "sensor_id": 1, "alias": "CON",
        "distance_cm": 215, "level_cm": 255, "volume_l": 45333, "pct": 56.7,
        "rssi": -62, "vbat": 3.3, "seq": 1
    })
    async with db.execute("SELECT alias FROM readings") as cur:
        rows = [row async for row in cur]
    assert len(rows) == 1
    assert rows[0][0] == "CON"

@pytest.mark.asyncio
async def test_upsert_state_creates_and_updates(db):
    now = int(time.time())
    state = {
        "alias": "CON", "node_id": "0x7758", "sensor_id": 1,
        "name": "Castelo de Consumo", "ts": now,
        "level_cm": 255, "volume_l": 45333, "pct": 56.7,
        "level_max_cm": 450, "volume_max_l": 80000, "rssi": -62,
    }
    await upsert_state(db, state)
    async with db.execute("SELECT pct FROM reservoir_state WHERE alias='CON'") as cur:
        row = await cur.fetchone()
    assert abs(row[0] - 56.7) < 0.01

    # update
    state["pct"] = 80.0
    await upsert_state(db, state)
    async with db.execute("SELECT pct FROM reservoir_state WHERE alias='CON'") as cur:
        row = await cur.fetchone()
    assert abs(row[0] - 80.0) < 0.01

@pytest.mark.asyncio
async def test_get_all_states_returns_online_flag(db):
    now = int(time.time())
    await upsert_state(db, {
        "alias": "CON", "node_id": "0x7758", "sensor_id": 1,
        "name": "Castelo de Consumo", "ts": now,
        "level_cm": 255, "volume_l": 45333, "pct": 56.7,
        "level_max_cm": 450, "volume_max_l": 80000, "rssi": -62,
    })
    states = await get_all_states(db)
    assert len(states) == 1
    assert states[0]["online"] is True

@pytest.mark.asyncio
async def test_get_history_returns_readings(db):
    now = int(time.time())
    for i in range(5):
        await insert_reading(db, {
            "ts": now - i * 100, "node_id": "0x7758", "sensor_id": 1, "alias": "CON",
            "distance_cm": 215 + i, "level_cm": 255 - i, "volume_l": 45000 - i * 100,
            "pct": 56.0, "rssi": -62, "vbat": 3.3, "seq": i
        })
    rows = await get_history(db, alias="CON", since_ts=now - 600)
    assert len(rows) == 5
```

- [ ] **Step 3.3: Rodar testes — verificar que falham**

```bash
python -m pytest tests/test_db.py -v 2>&1 | head -20
```

Esperado: `ImportError` — `db.py` não existe.

- [ ] **Step 3.4: Criar `backend/db.py`**

```python
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
