lucianoET/aguada-firmware/firmware/communicator/cad/yeti/frame_st7789_1p3.stl

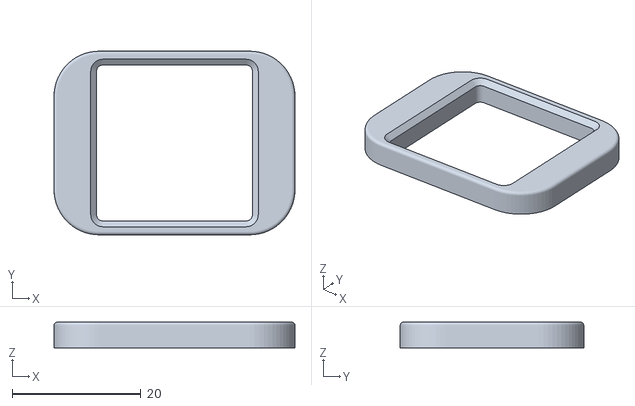
[picture p2: CAD file, 2026-11-05]
firmware/communicator/cad/yeti/frame_st7789_1p3.stl
37.4 x 28.5 x 4.00
