lucianoET/aguada-firmware/firmware/communicator/cad/yeti/yeti_base_energia.stl

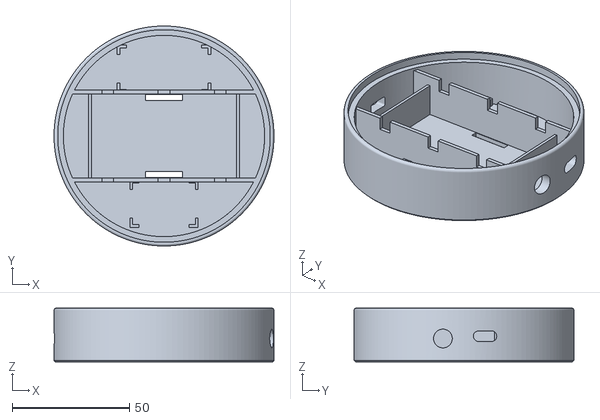
[picture p3: CAD file, 2026-11-05]
firmware/communicator/cad/yeti/yeti_base_energia.stl
94.0 x 94.0 x 23.0
