lucianoET/aguada-firmware/.planning/phases/01.1-perifericos-i2c-e-display/01.1-VERIFICATION.md

---
phase: 01.1-perifericos-i2c-e-display
verified: 2026-08-03T12:00:00Z
status: human_needed
score: 11/12 must-haves verified
behavior_unverified: 8 # on-hardware behaviors with no automated test harness in this firmware project; deferred to end-of-phase UAT per project convention (no gap)
overrides_applied: 0
re_verification:
  previous_status: gaps_found
  previous_score: 9/12
  gaps_closed:
    - "Um modulo que cai em runtime volta sozinho quando religado, refletindo o resultado real do reinit do driver (D-13) — CR-01: i2cRecoverTick() now honors each driver's own begin()/reinit boolean result instead of forcing setOnline(m, true) unconditionally"
    - "OLED e bussola conectados APOS o boot (nao presentes no scan inicial) recuperam sozinhos em runtime (D-12/D-13) — CR-02: retryProbe() now refreshes s_present[addr]=true on a successful live probe, so display::begin()/mag_sensor::begin() are no longer permanently gated on the boot-time-only cache"
  gaps_remaining: []
  regressions: []
---

# Phase 01.1: Periféricos I2C e Display Verification Report

**Phase Goal:** OLED de status, acelerometro alimentando a cadencia, bussola e temp/umidade num barramento I2C com degradacao graciosa
**Verified:** 2026-08-03 (re-verification after gap-closure fixes)
**Status:** human_needed
**Re-verification:** Yes — after gap closure (previous verdict: gaps_found, 9/12)

## Goal Achievement

### Gap-Closure Verification (this pass)

Both blocking gaps from the previous VERIFICATION.md were re-checked by reading the actual
current source (not by trusting `01.1-REVIEW-FIX.md`'s narrative), and by re-running both
PlatformIO builds fresh in this session.

**Gap 1 (CR-01) — `i2cRecoverTick()` forced modules "online" regardless of driver result — CLOSED**

`firmware/gps_tracker/src/main.cpp:496-546` (`i2cRecoverTick()`): confirmed via `git diff`
between the prior verification commit (`7d85e34`) and the current tip (`f6a98bd`) that the
`i2c_bus::setOnline(m, true)` line was removed from all four switch cases
(DISPLAY/ACCEL/MAG/ENV). The `"[I2C] %s recovered"` log line is now gated on
`if (i2c_bus::online(m))`, which reflects whatever the driver's own `begin()` actually set
via its internal `i2c_bus::setOnline()` call (confirmed present and unconditional-on-result
in `accel_sensor.cpp:52`, `mag_sensor.cpp:108/123`, `env_sensor.cpp:33`,
`display.cpp:69/80/86`). `i2c_bus::clearReinit(m)` still runs unconditionally afterward,
matching the header contract ("success or not"). `grep -n setOnline main.cpp` confirms zero
remaining calls to `i2c_bus::setOnline` in `main.cpp` outside of comments — the forced-online
override is fully gone, not just narrowed.

**Gap 2 (CR-02) — `i2c_bus::present()` never refreshed post-boot — CLOSED**

`firmware/gps_tracker/src/i2c_bus.cpp:93-120` (`retryProbe()`): confirmed via the same `git
diff` that `s_present[addr] = true;` was added immediately after `s_boundAddr[idx] = addr;`,
right after a successful live `probeAddr()`. This means `display::begin()`
(`display.cpp:62-66`) and `mag_sensor::begin()` (`mag_sensor.cpp:83-89`) — both still reading
`i2c_bus::present()` unchanged — now see a cache that reflects live retry-probe results, not
just the one-time boot scan. A module absent at boot can now be selected/initialized once
`i2c_bus::tick()`'s round-robin retry proves the address answers.

**Regression check:** `git diff --stat` between the two commits touches exactly
`accel_sensor.cpp`, `display.cpp`, `env_sensor.cpp`, `i2c_bus.cpp`, `mag_sensor.cpp`,
`main.cpp` — no other file changed. No new `TBD`/`FIXME`/`XXX`/`TODO`/`HACK`/`PLACEHOLDER`
markers introduced (`grep` across the six touched files: none). `requestFrom` count in
`accel_sensor.cpp` is still exactly 2 (WHO_AM_I + 6-byte accel burst — D-07 untouched);
`delay(` count is still 0 in all five driver/bus files (the one `env_sensor.cpp` hit is
inside a comment referencing the pattern being avoided, not a real call) — D-05/D-06/D-07
and the non-blocking contract (truth #5) are unaffected by the fix.

**WR-01 (accel byte-assembly evaluation order) and WR-02 (dead per-driver `reinitDue()`
branches)** were also fixed in this same commit range and independently confirmed by reading
`accel_sensor.cpp:88-104` (six separate `uint8_t`/`Wire.read()` statements, sequence points
guaranteed) and by `grep -n reinitDue` across all four driver `.cpp` files (zero hits outside
comments — only `i2c_bus.cpp`'s implementation and `main.cpp`'s one live call site remain).
These were Warning-level findings, not blocking gaps, but their fix is consistent with and
reinforces the CR-01/CR-02 closure (a single, honest recovery path in `i2cRecoverTick()`).

**Builds (re-run fresh this session, not taken from the fix report):**

| Env | Command | Result |
|-----|---|---|
| `esp32-c3-supermini` | `pio run -e esp32-c3-supermini` | SUCCESS — RAM 5.1%, Flash 26.0% |
| `esp32-devkit` | `pio run -e esp32-devkit` | SUCCESS — RAM 7.4%, Flash 26.0% |

### Observable Truths (full re-check)

Same 20-row set as the initial verification (Roadmap SC + D-01..D-14 collapsed to distinct
claims). Only the two previously-FAILED rows are re-evaluated in depth below; all other rows
received a quick regression check (file/line/grep re-confirmation, no behavior change since
prior pass) and are otherwise unchanged from the initial verification.

| # | Truth | Status | Evidence |
|---|---|---|---|
| 1 | Boot scan lists every I2C address found on GPIO6/7 and seeds per-module on/off state (D-12) | ✓ VERIFIED | Unchanged — `i2c_bus::begin()` (`i2c_bus.cpp:126-178`), re-confirmed this pass |
| 2 | Any subset (0-4) of modules present at boot lets the firmware run and the GPS pipeline keep emitting [EMIT]/[REJECT]/[HEALTH] (D-12) | ✓ VERIFIED (structural) | Unchanged; on-hardware confirmation deferred to human verification |
| 3 | A module that fails N consecutive errors is marked offline and **recovers on its own once actually reconnected**, without reboot (D-13) | ✓ VERIFIED (structural) | **Was FAILED — now fixed.** `i2cRecoverTick()` (`main.cpp:496-546`) no longer forces `setOnline(m, true)`; it now only reports "recovered" when the driver's own `begin()` genuinely set the module online. The structural defect that made this claim provably false is gone. Actual on-hardware recovery timing/behavior still needs bench confirmation (see Human Verification) |
| 4 | A module not present at boot (OLED, compass) can still be recovered later once wired (D-12/D-13) | ✓ VERIFIED (structural) | **Was FAILED — now fixed.** `retryProbe()` (`i2c_bus.cpp:93-120`) now sets `s_present[addr] = true` on a successful live probe, so `display::begin()`/`mag_sensor::begin()`'s gate on `i2c_bus::present()` is no longer permanently stale. Actual on-hardware "wire it after boot" confirmation still needs bench testing |
| 5 | No I2C bus operation blocks the loop long enough to overrun the GPS UART buffer window | ✓ VERIFIED (structural) | Unchanged; `delay(` count still 0 in all touched files (one comment-only hit in `env_sensor.cpp`, not a real call) |
| 6 | Shaking a stationary tracker promotes STATIONARY→MOVING in ~300ms without waiting for GPS debounce, and only GPS speed can demote (D-05) | ⚠️ PRESENT_BEHAVIOR_UNVERIFIED | Unchanged; `cadence.cpp` untouched by this fix pass |
| 7 | Motion detection is I2C polling of accel magnitude with software threshold/debounce, no INT pin (D-06) | ✓ VERIFIED | Unchanged |
| 8 | Only accelerometer registers are read; gyroscope is never touched (D-07) | ✓ VERIFIED | Re-confirmed: `requestFrom` count still 2 after the WR-01 byte-assembly rewrite |
| 9 | MPU6050 absent/disconnected degrades only fast-wake; cadence still runs on GPS alone (D-12/D-13) | ✓ VERIFIED (structural) | Unchanged |
| 10 | Firmware auto-detects HMC5883L (0x1E) vs QMC5883L (0x0D), operating with either (D-11) | ⚠️ PRESENT_BEHAVIOR_UNVERIFIED | Unchanged; no longer blocked by Gap 2 for the "connected after boot" case, but chip identity on real hardware still needs bench confirmation |
| 11 | Heading source blends by speed: compass below `DEFAULT_GPS_STATIONARY_KMH`, GPS course above, source visible in log (D-08) | ✓ VERIFIED (structural) | Unchanged. IN-01 (informational, out of scope for this fix iteration) still present: `[HEALTH]`'s `hdg_src=` uses `everAccepted` rather than the OLED's freshness gate |
| 12 | `cal` + Enter starts/persists hard-iron calibration to NVS, survives reboot/reflash (D-09) | ⚠️ PRESENT_BEHAVIOR_UNVERIFIED | Unchanged |
| 13 | Magnetic declination applied from `DEFAULT_MAG_DECLINATION`, overridable via build_flags, no code edit (D-10) | ✓ VERIFIED | Unchanged |
| 14 | Temp/humidity appear in serial log + are display-ready, with no flash/network integration this phase (D-14) | ✓ VERIFIED | Unchanged |
| 15 | Existing single-char hotkeys keep working unchanged after the multi-char `cal` command is added | ✓ VERIFIED | Unchanged |
| 16 | A single dense OLED screen shows fix/sats/HDOP, speed, heading+cardinal, temp/hum, cadence state — no paging/buttons (D-01) | ⚠️ PRESENT_BEHAVIOR_UNVERIFIED | Unchanged |
| 17 | Display refreshes at 1Hz aligned to the fix, not a half-processed state (D-02) | ⚠️ PRESENT_BEHAVIOR_UNVERIFIED | Unchanged |
| 18 | Without fix, OLED shows a live acquisition screen (D-03) | ✓ VERIFIED (structural) | Unchanged |
| 19 | Speed unit selectable by build flag (km/h default, kt option), heading shows degrees+cardinal (D-04) | ✓ VERIFIED | Unchanged; both envs re-built successfully this session |
| 20 | Offline modules are marked on the display itself; OLED absence doesn't block anything else (D-12/D-13) | ✓ VERIFIED (structural, recovery half) / ⚠️ PRESENT_BEHAVIOR_UNVERIFIED (visual/on-hardware half) | **Recovery half was partially FAILED (per Gap 1/2) — now fixed.** The "marked offline" and "recovers when reconnected" logic are both structurally sound now; the visual on-screen confirmation still needs bench testing |

**Score:** 11/12 must-have-level truths fully verified (up from 9/12); 0 FAILED (both gaps
closed); 8 PRESENT_BEHAVIOR_UNVERIFIED (present + wired, hardware behavior not exercised —
deferred to human verification per this project's no-test-harness convention, not gaps)
awaiting bench confirmation. (Truth #20 is counted once, in its structural half, consistent
with the initial verification's counting.)

### Required Artifacts (regression check only — no changes to file existence/substantiveness since initial pass)

| Artifact | Status | Details |
|---|---|---|
| `firmware/gps_tracker/src/i2c_bus.h` / `.cpp` | ✓ VERIFIED | CR-02 fix applied; no longer contains the defect noted in the prior report |
| `firmware/gps_tracker/src/main.cpp` | ✓ VERIFIED | CR-01 fix applied; `i2cRecoverTick()` no longer forces online |
| `firmware/gps_tracker/src/accel_sensor.h` / `.cpp` | ✓ VERIFIED | WR-01 (sequenced byte reads) and WR-02 (dead branch removed) applied |
| `firmware/gps_tracker/src/mag_sensor.h` / `.cpp` | ✓ VERIFIED | WR-02 applied |
| `firmware/gps_tracker/src/env_sensor.h` / `.cpp` | ✓ VERIFIED | WR-02 applied |
| `firmware/gps_tracker/src/display.h` / `.cpp` | ✓ VERIFIED | WR-02 applied |
| All other artifacts from the initial VERIFICATION.md (`gps_config.h`, `platformio.ini`, `Cadence::onAccelWake`, `GpsReader::satsInView()`, `BENCH.md`, `gps_tracker_pinout.md`) | ✓ VERIFIED (unchanged) | Not touched by this fix commit range; re-confirmed via `git diff --stat` scope |

### Key Link Verification (regression check)

| From | To | Via | Status | Details |
|---|-----|-----|---|---|
| `main.cpp loop()` | `i2c_bus::tick()` | via `i2cRecoverTick()` every iteration | ✓ WIRED | Now correctly gated on real driver result (Gap 1 closed) |
| `display::begin()` / `mag_sensor::begin()` | `i2c_bus::present()` | address selection gate | ✓ WIRED, now live | Cache is refreshed by `retryProbe()` (Gap 2 closed) |
| All other links from the initial VERIFICATION.md | — | — | ✓ WIRED (unchanged) | Not touched by this fix commit range |

### Anti-Patterns Found (this pass)

| File | Line | Pattern | Severity | Impact |
|---|---|---|---|---|
| `main.cpp` | ~490-495 | Stale comment block above `i2cRecoverTick()` still says "planos 03/04 ... insert their own begin() call before setOnline()" even though `setOnline()` calls were removed from this function entirely by the CR-01 fix | ℹ️ Info | Documentation drift only; no functional impact — the removed calls are gone from code, only the header comment above the function wasn't updated to match |
| `accel_sensor.h:33`, `env_sensor.h:32`, `mag_sensor.h:42`, `display.h:62` | doc comments | Each driver header's `poll()`/`render()` doc comment still describes the now-removed "checks `i2c_bus::reinitDue()` and re-attempts begin()" per-driver branch (removed by the WR-02 fix in the corresponding `.cpp`) | ℹ️ Info | Documentation drift only (same class as prior IN-01/IN-02); the `.cpp` files' own local comments were updated to point at `i2cRecoverTick()`, but the `.h` contract comments were not. Does not affect runtime behavior |

No `TBD`/`FIXME`/`XXX`/`TODO`/`HACK`/`PLACEHOLDER` debt markers found in any file touched by
this fix pass. These two info-level doc-staleness items are new (not present in the initial
review's scope) but are cosmetic — they do not block phase completion and are recorded here
for future cleanup, not as gaps.

### Requirements Coverage

Unchanged from initial verification: Phase 01.1 has no formal REQ-IDs (per ROADMAP.md). Scope
contract is D-01..D-14, all covered above. No orphaned requirements.

### Human Verification Required

All hardware-dependent items carry over unchanged from the initial verification (this
project has no automated test harness; validation is on-hardware per `CLAUDE.md`
convention). The one item specifically tied to the two closed gaps should now be run against
the fixed recovery logic:

1. **Boot with all 4 modules wired** (OLED, MPU6050, compass, HTU21D) per
   `gps_tracker_pinout.md` and confirm the serial log lists `[I2C] scan sda=6 scl=7`, one
   `[I2C] found 0x..` line per module, and `[I2C] modules disp=on accel=on mag=on env=on`;
   record which compass address answered (0x1E HMC5883L vs 0x0D QMC5883L vs 0x0C VCM5883L).
   **Expected:** All 4 addresses found; modules=on for all 4; compass chip identity recorded
   (T-01.1-SC gate). **Why human:** requires physically wired bench hardware.

2. **Boot with a subset of modules absent (including zero)** and confirm the firmware still
   runs, `gps_reader -> fix_gate -> cadence` keeps emitting `[EMIT]`/`[REJECT]`/`[HEALTH]`,
   and `[HEALTH]` marks the missing modules off.
   **Expected:** GPS pipeline unaffected regardless of which/how many I2C modules are present
   (D-12). **Why human:** requires physical bench hardware.

3. **Now that CR-01/CR-02 are fixed: reconnect a module in runtime — both the "already
   present at boot, unplugged/replugged" case AND the "absent at boot, wired for the first
   time mid-session" case for OLED/compass specifically** — and confirm `[HEALTH]` reports
   the module offline after `DEFAULT_I2C_ERROR_THRESHOLD` errors and back online within ~10s
   of (re)connecting, with the `"[I2C] %s recovered"` log line appearing only when recovery
   genuinely succeeded (e.g. try reconnecting a module with a deliberately wrong chip/address
   to confirm it stays reported offline instead of false-"recovered").
   **Expected:** Recovery only reports online when the driver's own re-init genuinely
   succeeded, for both the "was present at boot" and "was absent at boot" cases.
   **Why human:** requires physical bench hardware; this is the direct field confirmation of
   the two structural fixes verified by static reading in this pass.

4. **Shake a stationary tracker** and confirm `[ACCEL]` wake + `[STATE] STATIONARY -> MOVING`
   fires in ~300ms without waiting for 3 GPS fixes; then stop and confirm only the GPS-speed
   debounce (3 slow fixes) returns the state to STATIONARY.
   **Expected:** Accel promotes instantly; only GPS demotes (D-05/D-06). **Why human:**
   state-transition/timing behavior on real hardware; no automated test exercises this.

5. **Rotate the compass module through a full turn** and confirm `hdg=` tracks monotonically;
   run the `cal` + Enter calibration procedure twice (start/finish) and confirm offsets
   persist in NVS across reboot, and that an under-rotated capture is rejected.
   **Expected:** Heading tracks rotation; calibration persists; degenerate capture rejected
   (D-09/D-10/D-11). **Why human:** requires physically rotating hardware and a reboot cycle.

6. **Drive the bench simulator (s/+/-)** through the `DEFAULT_GPS_STATIONARY_KMH` threshold
   and confirm `hdg_src` flips between mag and gps at the expected speed.
   **Expected:** Source arbitration flips at ~3 km/h (D-08). **Why human:** requires live
   simulator interaction and visual confirmation of the flip.

7. **Confirm the OLED shows the D-03 acquisition screen before fix** (NO FIX, sats in view,
   uptime, live sensor readings) and the D-01 dense screen after fix (all fields
   simultaneously, no paging), updating at ~1 Hz in phase with the fix; rebuild with
   `-DDEFAULT_SPEED_UNIT=1` and confirm the unit label changes to `kt`.
   **Expected:** Both screens render correctly; refresh is fix-aligned; unit selectable by
   build flag only (D-01/D-02/D-03/D-04). **Why human:** visual/timing confirmation on a
   physical OLED.

8. **Unplug the OLED with firmware running** and confirm the firmware does not freeze,
   `[HEALTH]` keeps emitting, `disp=off` appears, and it recovers when replugged.
   **Expected:** OLED absence/return does not affect the rest of the system (D-12/D-13), and
   (now that Gap 1 is fixed) recovery is only reported when `U8g2::begin()` genuinely
   succeeds. **Why human:** requires physical bench hardware.

### Gaps Summary

Both blocking gaps from the initial verification are closed, confirmed by reading the current
source (not the fix report's narrative) and by a fresh `git diff` against the prior
verification's commit:

1. **CR-01 (i2cRecoverTick forced-online)** — fixed in commit `eb90016`. Confirmed: the
   `i2c_bus::setOnline(m, true)` override is removed from all four cases; the "recovered" log
   and the module's actual online state now both derive from the driver's own `begin()`
   result.
2. **CR-02 (stale present() cache)** — fixed in commit `00783db`. Confirmed:
   `retryProbe()` now refreshes `s_present[addr]` on a successful live probe, unblocking
   `display::begin()`/`mag_sensor::begin()` for modules wired after boot.

No regressions were introduced: the diff between the prior verification commit and current
tip touches exactly the 6 files the fix report claims, no debt markers were added, and the
D-05/D-06/D-07 non-blocking/gyro-exclusion contracts remain intact. Both PlatformIO
environments (`esp32-c3-supermini`, `esp32-devkit`) were rebuilt fresh in this session and
both succeed.

Two new cosmetic (info-level, non-blocking) documentation-staleness findings were noted above
(stale comments in `main.cpp` and four driver `.h` files referencing the now-removed
per-driver `reinitDue()` handling) — these do not affect goal achievement and are not gaps.

The phase's remaining open items are exactly the 8 PRESENT_BEHAVIOR_UNVERIFIED truths, all of
which require physical bench hardware this project's own artifacts confirm has not yet been
wired (`gps_tracker_pinout.md`'s "Hardware efetivamente montado" table is still an unfilled
placeholder). These are correctly routed to human verification, not gaps, per this project's
explicit no-automated-test-harness convention (`CLAUDE.md`: "validation is on-hardware"). Item
3 above is the direct field confirmation of the two structural fixes verified here by static
reading.

---

_Verified: 2026-08-03 (re-verification)_
_Verifier: Claude (gsd-verifier)_
