lucianoET/aguada-firmware/.planning/phases/01.1-perifericos-i2c-e-display/01.1-REVIEW-FIX.md

---
phase: 01.1-perifericos-i2c-e-display
fixed_at: 2026-08-03T11:27:09Z
review_path: .planning/phases/01.1-perifericos-i2c-e-display/01.1-REVIEW.md
iteration: 1
findings_in_scope: 4
fixed: 4
skipped: 0
status: all_fixed
---

# Phase 01.1: Code Review Fix Report

**Fixed at:** 2026-08-03T11:27:09Z
**Source review:** .planning/phases/01.1-perifericos-i2c-e-display/01.1-REVIEW.md
**Iteration:** 1

**Summary:**
- Findings in scope: 4 (critical_warning scope — CR-01, CR-02, WR-01, WR-02; the 3 Info findings are out of scope for this iteration)
- Fixed: 4
- Skipped: 0

## Fixed Issues

### CR-01: `i2cRecoverTick()` forces modules "online" regardless of the driver's own re-init result

**Files modified:** `firmware/gps_tracker/src/main.cpp`
**Commit:** eb90016
**Applied fix:** Removed the unconditional `i2c_bus::setOnline(m, true)` call that followed each driver's `begin()` in every `case` of `i2cRecoverTick()`'s switch. Each driver's own `begin()` already reports its real result via `i2c_bus::setOnline()` internally (confirmed by reading `accel_sensor.cpp:52`, `mag_sensor.cpp:108/123`, `env_sensor.cpp:33`, `display.cpp:69/80/86`), so the override was actively defeating the online/offline health model. The `"[I2C] %s recovered"` log line is now gated on `i2c_bus::online(m)` actually being true after `begin()` returns, and `i2c_bus::clearReinit(m)` still runs unconditionally (success or not), per the header contract ("Driver calls this after attempting re-init, success or not").

### CR-02: `i2c_bus::present()` never reflects anything beyond the one-time boot scan

**Files modified:** `firmware/gps_tracker/src/i2c_bus.cpp`
**Commit:** 00783db
**Applied fix:** Chose the first of the review's two suggested options (localized, minimal-diff): `retryProbe()` now sets `s_present[addr] = true` immediately after a successful live `probeAddr()`, right alongside its existing `s_boundAddr[idx] = addr` rebind. This means `display::begin()`/`mag_sensor::begin()` (which gate address selection on `i2c_bus::present()`) can now succeed for the OLED or compass even if it was physically absent during the boot-time scan and only connected later — closing the D-13 runtime-recovery gap for those two modules.

### WR-01: Unspecified evaluation order in raw 16-bit accelerometer byte assembly

**Files modified:** `firmware/gps_tracker/src/accel_sensor.cpp`
**Commit:** dc6a089
**Applied fix:** Replaced the three `(int16_t(Wire.read()) << 8) | Wire.read()` expressions with six separate `uint8_t` statements (one `Wire.read()` per statement, per axis high/low byte), then combined the already-read temporaries into `axRaw`/`ayRaw`/`azRaw`. This guarantees a sequence point between each pair of `Wire.read()` calls, eliminating the unspecified-evaluation-order risk the review flagged (and avoiding the noted comma-declaration pitfall, which has the same problem).

### WR-02: Per-driver `reinitDue()` handling in `poll()`/`render()` is dead code

**Files modified:** `firmware/gps_tracker/src/accel_sensor.cpp`, `firmware/gps_tracker/src/mag_sensor.cpp`, `firmware/gps_tracker/src/env_sensor.cpp`, `firmware/gps_tracker/src/display.cpp`
**Commit:** 9e0f2fe
**Applied fix:** Took the review's first suggested option (minimal, consistent with the CR-01 fix that keeps `main.cpp::i2cRecoverTick()` as the sole reinit path): removed the unreachable `if (i2c_bus::reinitDue(...)) { begin(); i2c_bus::clearReinit(...); }` branch from each of `accel_sensor::poll()`, `mag_sensor::poll()`, `env_sensor::poll()`, and `display::render()`. Each now simply returns/exits early while offline, with a comment pointing to `i2cRecoverTick()` as the actual recovery driver. Confirmed via `grep -n "reinitDue"` that no driver `.cpp` file references it anymore outside of comments — only `i2c_bus.cpp` (implementation) and `main.cpp` (the one live call site) do.

## Verification Notes

All four fixes were verified with the project's real toolchain rather than a generic syntax check, per the build_note in the task config:
- `cd firmware/gps_tracker && /home/luc/Dev/aguada-firmware-main/.venv/bin/pio run -e esp32-c3-supermini` — ran after every individual fix, SUCCESS each time.
- `cd firmware/gps_tracker && /home/luc/Dev/aguada-firmware-main/.venv/bin/pio run -e esp32-devkit` — ran once after all four fixes were applied and committed, as the final cross-target check. SUCCESS (RAM 7.4%, Flash 26.0%).

None of the four fixes required rollback — no fix failed compilation.

None of these four findings were logic-ambiguous enough to require a `"fixed: requires human verification"` flag: CR-01 and WR-02 are structural (removing an incorrect override / removing genuinely unreachable code, confirmed via `grep`), CR-02 is a one-line cache-refresh addition consistent with the existing `s_boundAddr` update immediately above it, and WR-01 is a mechanical sequencing fix with no behavioral change in the success path. That said, CR-01's behavior change (a previously-always-`online` module can now legitimately show `offline` after a failed reinit attempt) and CR-02's newly-reachable "connect display/compass after boot" code path are both exactly the D-12/D-13 field-behavior the phase verifier flagged as goal-blocking — bench validation per `BENCH.md`'s D-12/D-13 roteiro is still recommended before closing out the phase gaps, even though the build itself is clean.

## Skipped Issues

None — all 4 in-scope findings were fixed.

---

_Fixed: 2026-08-03T11:27:09Z_
_Fixer: Claude (gsd-code-fixer)_
_Iteration: 1_
