lucianoET/aguada-firmware/firmware/communicator/include/yeti_config.h

#pragma once
// Pinos e defaults do Yeti (ESP32-S3 SuperMini). Áudio/voz/alarme vêm do communicator
// (comm_config.h, pinos I2S sobrescritos no env yeti_s3). Pinagem: YETI.md

// ── Display 1.3" ST7789 240×240, SPI sem CS (módulo de 7 pinos, modo 3) ────────
#ifndef YETI_PIN_TFT_SCK
#define YETI_PIN_TFT_SCK    12    // SCL do módulo (pino nativo do FSPI)
#endif
#ifndef YETI_PIN_TFT_MOSI
#define YETI_PIN_TFT_MOSI   11    // SDA do módulo
#endif
#ifndef YETI_PIN_TFT_DC
#define YETI_PIN_TFT_DC     10
#endif
#ifndef YETI_PIN_TFT_RST
#define YETI_PIN_TFT_RST    -1    // RES no RC (10k a 3V3 + 100 nF); G13 virou touch do braço
#endif
#ifndef YETI_PIN_TFT_BL
#define YETI_PIN_TFT_BL     2     // BLK: PWM do backlight
#endif
#ifndef YETI_TFT_BL_CH
#define YETI_TFT_BL_CH      7     // canal LEDC do backlight (o C3 só tem 0..5)
#endif
#ifndef YETI_TFT_ROTATION
#define YETI_TFT_ROTATION   1     // 0..3: módulo deitado atrás da moldura, flex de lado
#endif
#ifndef YETI_TFT_HZ
#define YETI_TFT_HZ         40000000
#endif

// ── I2C: HTU21D 0x40, MPU6050/6500 0x68/0x69, BH1750 0x23/0x5C ────────────────
#ifndef YETI_PIN_SDA
#define YETI_PIN_SDA        8
#endif
#ifndef YETI_PIN_SCL
#define YETI_PIN_SCL        9
#endif

// ── Touch capacitivo do topo da cabeça (TTP223, saída ativa alta) ──────────────
#ifndef YETI_PIN_TOUCH
#define YETI_PIN_TOUCH      44    // RX da UART0 (console é o USB nativo)
#endif
#ifndef YETI_TOUCH_ACTIVE
#define YETI_TOUCH_ACTIVE   HIGH  // TTP223 com jumper A aberto; LOW se o jumper A for fechado
#endif

// ── Toque por MPR121 no I2C (yeti_c3): E0 cabeça, E1 braço E, E2 braço D ───────
#ifndef YETI_TOUCH_MPR121
#define YETI_TOUCH_MPR121   0     // 1 = cabeça e braços pelo MPR121 (sem TTP223, sem touch nativo)
#endif
#ifndef YETI_MPR_TOUCH
#define YETI_MPR_TOUCH      8     // limiar de toque (contagens; menor = mais sensível)
#endif
#ifndef YETI_MPR_RELEASE
#define YETI_MPR_RELEASE    4
#endif

// ── Touch nativo dos braços (fita de cobre por dentro do braço) ───────────────
#ifndef YETI_PIN_ARM_L
#define YETI_PIN_ARM_L      3     // TOUCH3
#endif
#ifndef YETI_PIN_ARM_R
#define YETI_PIN_ARM_R      13    // TOUCH13
#endif
#ifndef YETI_ARM_ON
#define YETI_ARM_ON         1.04f // leitura/base acima disso = tocado (parede de 1,5–2 mm)
#endif
#ifndef YETI_ARM_OFF
#define YETI_ARM_OFF        1.02f
#endif
#define YETI_ARM_HOLD_MS    800   // segurar o braço = gatilho

// ── LEDs WS2812 das bochechas e bateria ───────────────────────────────────────
#ifndef YETI_PIN_LED
#define YETI_PIN_LED        43    // TX da UART0: pisca no boot (log do ROM)
#endif
#ifndef YETI_LED_COUNT
#define YETI_LED_COUNT      2
#endif
#ifndef YETI_LED_MAX
#define YETI_LED_MAX        120   // teto de brilho (0..255): atrás de PLA fino já basta
#endif
#ifndef YETI_PIN_VBAT
#define YETI_PIN_VBAT       1     // ADC1_CH0, divisor 100k/100k
#endif
#ifndef YETI_VBAT_DIV
#define YETI_VBAT_DIV       2.0f
#endif

// ── Comportamento ──────────────────────────────────────────────────────────────
#define YETI_HOLD_PTT_MS    500   // segurar a cabeça = falar (PTT)
#define YETI_TAP_GAP_MS     350   // fim de uma sequência de toques
#define YETI_INFO_MS        4000  // tempo da tela de temperatura/umidade
#define YETI_DARK_LUX       3.0f  // abaixo disso por YETI_DARK_S → dorme
#define YETI_DARK_S         30
#define YETI_COLD_C         18.0f
#define YETI_HOT_C          30.0f
#ifndef YETI_FPS
#define YETI_FPS            25    // yeti_c3: 15 (um núcleo só)
#endif
#define YETI_VBAT_LOW       3.45f // V: aviso de bateria fraca
#define YETI_SOUND_LEVEL    0.35f // nível (0..1) a partir do qual o Yeti olha para o som
