lucianoET/aguada-firmware/firmware/gateway/src/main.cpp

/*
 * Aguada Gateway Firmware v3.2
 * ESP32-S3
 *
 * Receives ESP-NOW → outputs JSON lines on USB Serial 115200bps
 * Reads JSON commands from USB Serial → sends ESP-NOW to nodes
 */

#include <Arduino.h>
#include <WiFi.h>
#include <esp_timer.h>
#include <esp_wifi.h>
#include <esp_log.h>
#include <ArduinoJson.h>
#include <string.h>

#include <freertos/queue.h>
#include "espnow_gw.h"
#include "../../shared/protocol.h"

static const char *TAG = "gw";

#ifndef GATEWAY_VERSION_SUFFIX
#define GATEWAY_VERSION_SUFFIX ""
#endif

#ifndef GATEWAY_READY_REPEAT_COUNT
#define GATEWAY_READY_REPEAT_COUNT 1
#endif

#ifndef GATEWAY_READY_REPEAT_INTERVAL_MS
#define GATEWAY_READY_REPEAT_INTERVAL_MS 1200
#endif

#ifndef GATEWAY_STATUS_INTERVAL_MS
#define GATEWAY_STATUS_INTERVAL_MS 0
#endif

#ifndef GATEWAY_BAUD
#define GATEWAY_BAUD 115200
#endif

#ifndef GATEWAY_JSON_FLUSH
#define GATEWAY_JSON_FLUSH 1
#endif

static constexpr const char *GATEWAY_USB_FW_VERSION = FW_VERSION GATEWAY_VERSION_SUFFIX;

// ── Timestamp ─────────────────────────────────────────────────────────────────
// No WiFi/NTP on gateway. bridge.py sends {"cmd":"SETTIME","ts":...} at startup.
// GATEWAY_ETH: NTP pela Ethernet; SETTIME continua valendo até o NTP responder.
static int64_t s_time_offset_s = 0;

static bool ntp_synced(void) {
#ifdef GATEWAY_ETH
    return time(nullptr) > 1600000000;
#else
    return false;
#endif
}

static uint32_t unix_now(void) {
    if (ntp_synced()) return (uint32_t)time(nullptr);
    return (uint32_t)(s_time_offset_s + esp_timer_get_time() / 1000000LL);
}

// ── Packet queue (ESP-NOW cb → loop) ─────────────────────────────────────────
#define PKT_QUEUE_LEN 16
typedef struct { espnow_packet_t pkt; uint8_t src_mac[6]; } pkt_event_t;

// HELLO recebido direto (não via relay) → ACK unicast: o nó aprende o MAC do
// gateway e passa a enviar por unicast (ACK de camada MAC + retransmissão).
static void ack_hello(const pkt_event_t *evt) {
    if (evt->pkt.flags & FLAG_IS_RELAY) return;
    espnow_packet_t ack = {};
    ack.version = PROTO_VERSION;
    ack.type    = PKT_ACK;
    ack.node_id = evt->pkt.node_id;
    ack.seq     = evt->pkt.seq;
    ack.ttl     = 0;   // relays não repassam
    gw_espnow_send(&ack, evt->src_mac);
}
static QueueHandle_t s_pkt_queue = nullptr;
static uint32_t s_queue_drops = 0;
static uint32_t s_last_packet_ms = 0;
static uint32_t s_last_status_ms = 0;
static uint32_t s_last_ready_ms = 0;
static uint32_t s_ready_sent = 0;
static bool s_time_synced = false;
static uint8_t s_gateway_mac[6] = {0};

// ── Node MAC cache ────────────────────────────────────────────────────────────
#define NODE_CACHE_MAX 20
typedef struct { uint16_t node_id; uint8_t mac[6]; } node_mac_t;
static node_mac_t s_nodes[NODE_CACHE_MAX];
static int s_nodes_len = 0;

static void cache_mac(uint16_t node_id, const uint8_t *mac) {
    for (int i = 0; i < s_nodes_len; i++) {
        if (s_nodes[i].node_id == node_id) { memcpy(s_nodes[i].mac, mac, 6); return; }
    }
    if (s_nodes_len < NODE_CACHE_MAX) {
        s_nodes[s_nodes_len].node_id = node_id;
        memcpy(s_nodes[s_nodes_len].mac, mac, 6);
        s_nodes_len++;
    }
}

static const uint8_t *find_mac(uint16_t node_id) {
    for (int i = 0; i < s_nodes_len; i++)
        if (s_nodes[i].node_id == node_id) return s_nodes[i].mac;
    return nullptr;
}

// ── JSON output helpers ───────────────────────────────────────────────────────

// ── Optional WiFi/MQTT mirror (USB stays the primary link) ────────────────────
// Node packets are also published raw on aguada/gateway/rx, so bridge.py / the web
// backend keep receiving if the USB link drops. Commands still come over USB only.
#ifdef GATEWAY_WIFI_MIRROR
#include <PubSubClient.h>
#define MIRROR_TOPIC          "aguada/gateway/rx"
#define MIRROR_MQTT_RETRY_MS  15000   // connect() blocks up to ~3 s when the broker is away

static WiFiClient   s_net;
static PubSubClient s_mqtt(s_net);
static uint32_t     s_mqtt_retry_ms = 0;

static void mirror_begin(void) {
    if (strlen(WIFI_SSID) == 0 || strlen(MQTT_BROKER) == 0) return;
    // One radio: the AP must sit on ESPNOW_CHANNEL anyway. Pinning the channel keeps
    // the STA from scanning all channels (and dropping ESP-NOW) while the AP is away.
    WiFi.begin(WIFI_SSID, WIFI_PASS, ESPNOW_CHANNEL);
    WiFi.setSleep(false);   // modem sleep would miss ESP-NOW broadcasts between beacons
    s_mqtt.setServer(MQTT_BROKER, MQTT_PORT);
    s_mqtt.setBufferSize(512);
}

static void mirror_tick(void) {
    if (WiFi.status() != WL_CONNECTED) return;
    if (s_mqtt.connected()) { s_mqtt.loop(); return; }
    if (s_mqtt_retry_ms != 0 && millis() - s_mqtt_retry_ms < MIRROR_MQTT_RETRY_MS) return;
    s_mqtt_retry_ms = millis() | 1;
    char id[32];
    snprintf(id, sizeof(id), "aguada-gw-%02X%02X", s_gateway_mac[4], s_gateway_mac[5]);
    const char *user = strlen(MQTT_USER) ? MQTT_USER : nullptr;
    s_mqtt.connect(id, user, user ? MQTT_PASS : nullptr);
}

static void mirror_publish(const char *line, size_t n) {
    if (s_mqtt.connected()) s_mqtt.publish(MIRROR_TOPIC, (const uint8_t *)line, n, false);
}
static inline void mirror_note_rx(const espnow_packet_t *) {}
#define MIRROR_ALL      0
#define GW_PORT_NAME    "usb"

// ── Ethernet (WT32-ETH01, env gateway-wt32-eth) ───────────────────────────────
// Ethernet é o único link: toda linha JSON vai pra aguada/gateway/rx e os comandos
// chegam em aguada/gateway/cmd no mesmo formato da serial (bridge.py --port none).
// PHY/pinos vêm dos build flags ETH_PHY_* (ETH.begin() sem argumentos).
#elif defined(GATEWAY_ETH)
#include <ETH.h>
#include <PubSubClient.h>
#include "ap_portal.h"
#define MIRROR_TOPIC          "aguada/gateway/rx"
#define CMD_TOPIC             "aguada/gateway/cmd"
#define MIRROR_MQTT_RETRY_MS  15000   // connect() bloqueia até ~3 s com o broker fora
#define MIRROR_ALL            1
#define GW_PORT_NAME          "eth"
#ifndef LED_PIN
#define LED_PIN               2       // LED externo opcional (a placa não tem LED de usuário)
#endif

static gw_cfg_t      s_cfg;
static NetworkClient s_net;
static PubSubClient  s_mqtt(s_net);
static uint32_t      s_mqtt_retry_ms = 0;
static bool          s_ntp_started = false;
static uint32_t      s_led_blink_until = 0;

static void process_cmd(const char *str);
static void output_gateway_ready(void);
static void output_gateway_status(void);

static bool eth_up(void) { return ETH.linkUp() && ETH.hasIP(); }

static void on_mqtt_cmd(char *, uint8_t *payload, unsigned int len) {
    // Copia: as respostas de process_cmd() reaproveitam o buffer do PubSubClient.
    static char buf[512];
    if (len >= sizeof(buf)) { ESP_LOGW(TAG, "cmd MQTT longo demais (%u)", len); return; }
    memcpy(buf, payload, len);
    buf[len] = '\0';
    process_cmd(buf);
}

static void fill_portal_state(JsonDocument &doc) {
    gw_espnow_stats_t st = {};
    gw_espnow_get_stats(&st);
    doc["fw"]       = GATEWAY_USB_FW_VERSION;
    doc["up"]       = millis() / 1000UL;
    doc["eth_link"] = ETH.linkUp();
    doc["eth_ip"]   = ETH.hasIP() ? ETH.localIP().toString() : String();
    doc["eth_mbps"] = ETH.linkSpeed();
    doc["mqtt"]     = s_mqtt.connected();
    doc["time"]     = ntp_synced() || s_time_synced;
    doc["rx"]       = st.rx_packets;
    doc["crc"]      = st.crc_failures;
    doc["drops"]    = s_queue_drops;
}

// Base: AP ligado = aceso; sem link ETH = 2 piscadas a cada 2 s; normal = apagado.
// Pacote recebido inverte a base por 60 ms, então aparece nos dois casos.
static void led_tick(void) {
#if LED_PIN >= 0
    uint32_t now = millis(), p = now % 2000U;
    bool on = portal::ap_active() ? true
            : !ETH.linkUp()       ? (p < 80U || (p >= 240U && p < 320U))
            : false;
    if ((int32_t)(s_led_blink_until - now) > 0) on = !on;
    digitalWrite(LED_PIN, on ? HIGH : LOW);
#endif
}

static void mirror_begin(void) {
#if LED_PIN >= 0
    pinMode(LED_PIN, OUTPUT);
#endif
    portal::load_cfg(s_cfg);
    if (!ETH.begin()) ESP_LOGE(TAG, "ETH.begin falhou — confira ETH_PHY_* no env");
    if (!s_cfg.dhcp) ETH.config(s_cfg.ip, s_cfg.gw, s_cfg.mask, s_cfg.dns);
    s_mqtt.setServer(s_cfg.mqtt_host, s_cfg.mqtt_port);   // guarda o ponteiro: s_cfg é estático
    s_mqtt.setBufferSize(512);
    s_mqtt.setCallback(on_mqtt_cmd);
    portal::begin(s_cfg, s_gateway_mac, fill_portal_state);
}

static void mirror_tick(void) {
    portal::tick();
    led_tick();
    if (!eth_up()) return;
    if (!s_ntp_started) { configTime(0, 0, "pool.ntp.org"); s_ntp_started = true; }
    if (s_mqtt.connected()) { s_mqtt.loop(); return; }
    if (s_mqtt_retry_ms != 0 && millis() - s_mqtt_retry_ms < MIRROR_MQTT_RETRY_MS) return;
    s_mqtt_retry_ms = millis() | 1;
    char id[32];
    snprintf(id, sizeof(id), "aguada-gw-%02X%02X", s_gateway_mac[4], s_gateway_mac[5]);
    const char *user = s_cfg.mqtt_user[0] ? s_cfg.mqtt_user : nullptr;
    if (!s_mqtt.connect(id, user, user ? s_cfg.mqtt_pass : nullptr)) {
        ESP_LOGW(TAG, "MQTT %s:%u falhou rc=%d", s_cfg.mqtt_host, s_cfg.mqtt_port, s_mqtt.state());
        return;
    }
    s_mqtt.subscribe(CMD_TOPIC);
    // A cada (re)conexão: bridge registra o gateway e responde com SETTIME.
    output_gateway_ready();
    output_gateway_status();
}

static void mirror_publish(const char *line, size_t n) {
    if (s_mqtt.connected()) s_mqtt.publish(MIRROR_TOPIC, (const uint8_t *)line, n, false);
}

static void mirror_note_rx(const espnow_packet_t *pkt) {
    portal::note_packet(pkt);
    s_led_blink_until = millis() + 60;
}
#else
static inline void mirror_begin(void) {}
static inline void mirror_tick(void) {}
static inline void mirror_publish(const char *, size_t) {}
static inline void mirror_note_rx(const espnow_packet_t *) {}
#define MIRROR_ALL      0
#define GW_PORT_NAME    "usb"
#endif

// mirror=true for node packets and gateway status (what bridge.py republishes too).
static void json_out(JsonDocument &doc, bool mirror = false) {
    char line[384];
    size_t n = serializeJson(doc, line, sizeof(line) - 2);
    if (mirror || MIRROR_ALL) mirror_publish(line, n);
    line[n++] = '\r';
    line[n++] = '\n';
    Serial.write((const uint8_t *)line, n);
#if GATEWAY_JSON_FLUSH
    Serial.flush();
#endif
}

static void format_mac(const uint8_t mac[6], char *out, size_t out_len) {
    snprintf(out, out_len, "%02X:%02X:%02X:%02X:%02X:%02X",
             mac[0], mac[1], mac[2], mac[3], mac[4], mac[5]);
}

static void output_warn(const char *code, const char *message) {
    JsonDocument doc;
    doc["v"] = 3;
    doc["type"] = "WARN";
    doc["code"] = code;
    doc["message"] = message;
    doc["ts"] = unix_now();
    json_out(doc);
}

static void fill_gateway_ready(JsonDocument &doc) {
    char mac_str[20];
    format_mac(s_gateway_mac, mac_str, sizeof(mac_str));
    doc["v"] = 3;
    doc["type"] = "GATEWAY_READY";
    doc["fw"] = GATEWAY_USB_FW_VERSION;
    doc["mac"] = mac_str;
    doc["ts"] = unix_now();
}

static void output_gateway_ready(void) {
    JsonDocument doc;
    fill_gateway_ready(doc);
    json_out(doc);
    s_last_ready_ms = millis();
    s_ready_sent++;
}

static void output_gateway_status(void) {
    JsonDocument doc;
    gw_espnow_stats_t stats = {};
    gw_espnow_get_stats(&stats);

    char mac_str[20];
    format_mac(s_gateway_mac, mac_str, sizeof(mac_str));

    doc["v"] = 3;
    doc["type"] = "GATEWAY_STATUS";
    doc["fw"] = GATEWAY_USB_FW_VERSION;
    doc["mac"] = mac_str;
    doc["port"] = GW_PORT_NAME;
    doc["uptime_s"] = millis() / 1000UL;
    doc["free_heap"] = ESP.getFreeHeap();
    doc["rx_packets"] = stats.rx_packets;
    doc["crc_failures"] = stats.crc_failures;
    doc["queue_drops"] = s_queue_drops;
    doc["known_nodes"] = s_nodes_len;
    doc["channel"] = ESPNOW_CHANNEL;
    doc["connected"] = true;
    doc["sim_mode"] = false;
    doc["time_synced"] = s_time_synced || ntp_synced();
    doc["ready_count"] = s_ready_sent;
    if (s_last_packet_ms > 0) {
        doc["last_packet_age_s"] = (millis() - s_last_packet_ms) / 1000UL;
    } else {
        doc["last_packet_age_s"] = nullptr;
    }
    doc["ts"] = unix_now();
    json_out(doc, true);
    s_last_status_ms = millis();
}

static void output_time_ack(void) {
    JsonDocument doc;
    doc["v"] = 3;
    doc["type"] = "TIME_ACK";
    doc["fw"] = GATEWAY_USB_FW_VERSION;
    doc["ts"] = unix_now();
    json_out(doc);
}

static void set_vbat_json(JsonDocument &doc, int8_t raw_vbat) {
    if (raw_vbat < 0) {
        doc["vbat"] = nullptr;
        return;
    }
    doc["vbat"] = ((float)raw_vbat) / 10.0f;
}

static void output_sensor(const espnow_packet_t *pkt) {
    JsonDocument doc;
    char nid[8]; snprintf(nid, sizeof(nid), "0x%04X", pkt->node_id);
    doc["v"]           = 3;
    doc["type"]        = "SENSOR";
    doc["node_id"]     = nid;
    doc["sensor_id"]   = pkt->sensor_id;
    doc["distance_cm"] = (pkt->flags & FLAG_SENSOR_ERROR) ? -1 : (int)pkt->distance_cm;
    doc["rssi"]        = pkt->rssi;
    set_vbat_json(doc, pkt->vbat);
    doc["flags"]       = pkt->flags;
    doc["reserved"]    = pkt->reserved;  // ANI (FLAG_IS_AIR_QUALITY): AQI 1-5
    doc["seq"]         = pkt->seq;
    doc["ts"]          = unix_now();
    json_out(doc, true);
}

static void output_heartbeat(const espnow_packet_t *pkt) {
    JsonDocument doc;
    char nid[8]; snprintf(nid, sizeof(nid), "0x%04X", pkt->node_id);
    doc["v"]           = 3;
    doc["type"]        = "HEARTBEAT";
    doc["node_id"]     = nid;
    doc["sensor_id"]   = pkt->sensor_id;
    doc["distance_cm"] = (int)pkt->distance_cm;
    doc["rssi"]        = pkt->rssi;
    set_vbat_json(doc, pkt->vbat);
    doc["reserved"]    = pkt->reserved;  // used by SENSOR_ID_ENV: humidity 0-100
    doc["seq"]         = pkt->seq;
    doc["ts"]          = unix_now();
    json_out(doc, true);
}

static void output_hello(const espnow_packet_t *pkt) {
    JsonDocument doc;
    char nid[8]; snprintf(nid, sizeof(nid), "0x%04X", pkt->node_id);
    doc["v"]           = 3;
    doc["type"]        = "HELLO";
    doc["node_id"]     = nid;
    doc["fw_version"]  = FW_VERSION;
    // distance_cm reused to carry num_sensors in HELLO
    doc["num_sensors"] = pkt->distance_cm;
    doc["rssi"]        = pkt->rssi;
    set_vbat_json(doc, pkt->vbat);
    doc["flags"]       = pkt->flags;  // FLAG_BTN_HELLO=0x40 indicates button press
    doc["ts"]          = unix_now();
    json_out(doc, true);
}

// ── ESP-NOW receive ───────────────────────────────────────────────────────────

// Called from WiFi/ESP-NOW task — only enqueue, no Serial I/O.
static void on_recv(const espnow_packet_t *pkt, const uint8_t *src_mac) {
    pkt_event_t evt;
    evt.pkt = *pkt;
    memcpy(evt.src_mac, src_mac, 6);
    s_last_packet_ms = millis();
    if (xQueueSend(s_pkt_queue, &evt, 0) != pdTRUE) {
        s_queue_drops++;
    }
}

// ── Command → ESP-NOW ─────────────────────────────────────────────────────────
// Commands are sent via broadcast MAC so that nodes can receive them without
// needing to register the gateway as a peer. Only the target node (matching
// node_id in the packet) will process the command.
static const uint8_t BCAST_MAC[6] = {0xFF,0xFF,0xFF,0xFF,0xFF,0xFF};

static void cmd_restart(uint16_t node_id) {
    espnow_packet_t pkt = {};
    pkt.version = PROTO_VERSION;
    pkt.type    = PKT_CMD_RESTART;
    pkt.node_id = node_id;
    pkt.ttl     = DEFAULT_TTL;
    gw_espnow_send(&pkt, BCAST_MAC);
    ESP_LOGI(TAG, "CMD_RESTART → 0x%04X", node_id);
}

static void cmd_config(uint16_t node_id, const JsonDocument &doc) {

    espnow_packet_t pkt = {};
    pkt.version   = PROTO_VERSION;
    pkt.type      = PKT_CMD_CONFIG;
    pkt.node_id   = node_id;
    pkt.ttl       = DEFAULT_TTL;
    pkt.flags     = FLAG_CONFIG_PENDING;

    // Encode vbat config in spare fields (safe for CMD_CONFIG direction):
    //   sensor_id → vbat_pin   (0 = unchanged / disabled)
    //   reserved  → vbat_enabled (0=unchanged, 1=false, 2=true)
    //   distance_cm low byte  → vbat_div     (0 = unchanged)
    //   distance_cm high byte → num_sensors  (only if FLAG_CFG_NUM_SENSORS is set)
    if (doc["vbat_pin"].is<uint8_t>())
        pkt.sensor_id = doc["vbat_pin"].as<uint8_t>();
    // reserved: 0=unchanged, 1=disable, 2=enable (0 must not clear vbat on nodes)
    if (doc["vbat_enabled"].is<bool>() || doc["vbat_enabled"].is<int>())
        pkt.reserved  = doc["vbat_enabled"].as<bool>() ? 2 : 1;
    uint8_t cfg_vbat_div = 0;
    if (doc["vbat_div"].is<uint8_t>())
        cfg_vbat_div = doc["vbat_div"].as<uint8_t>();

    uint8_t cfg_num_sensors = 0;
    bool has_num_sensors = false;
    if (doc["num_sensors"].is<uint8_t>() || doc["num_sensors"].is<int>()) {
        int ns = doc["num_sensors"].as<int>();
        if (ns >= 0 && ns <= 2) {
            has_num_sensors = true;
            cfg_num_sensors = (uint8_t)ns;
            pkt.flags |= FLAG_CFG_NUM_SENSORS;
        }
    }

    pkt.distance_cm = ((uint16_t)cfg_num_sensors << 8) | cfg_vbat_div;

    esp_err_t err = gw_espnow_send(&pkt, BCAST_MAC);
    ESP_LOGI(TAG, "CMD_CONFIG → 0x%04X  vbat_pin=%d vbat_enabled=%d vbat_div=%d num_sensors=%d has_ns=%d err=%d",
             node_id, pkt.sensor_id, pkt.reserved, cfg_vbat_div,
             cfg_num_sensors, has_num_sensors ? 1 : 0, (int)err);
}

// ── Serial command parser ─────────────────────────────────────────────────────

static char   s_buf[1024];
static size_t s_buf_len = 0;

static void process_cmd(const char *str) {
    JsonDocument doc;
    DeserializationError err = deserializeJson(doc, str);
    if (err != DeserializationError::Ok) {
        ESP_LOGW(TAG, "Bad JSON: %.80s", str);
        output_warn("bad_json", "serial command parse failed");
        return;
    }

    const char *cmd = doc["cmd"];
    if (!cmd) return;

    if (strcmp(cmd, "SETTIME") == 0) {
        int64_t ts = doc["ts"].as<int64_t>();
        s_time_offset_s = ts - (esp_timer_get_time() / 1000000LL);
        s_time_synced = true;
        ESP_LOGI(TAG, "Time set, unix_now=%u", unix_now());
        output_time_ack();
        output_gateway_status();
        return;
    }

    if (strcmp(cmd, "STATUS") == 0 || strcmp(cmd, "GET_STATUS") == 0) {
        output_gateway_status();
        return;
    }

    uint16_t node_id = 0;
    if (doc["node_id"].is<const char*>())
        node_id = (uint16_t)strtoul(doc["node_id"].as<const char*>(), nullptr, 0);
    else
        node_id = doc["node_id"].as<uint16_t>();

    if      (strcmp(cmd, "RESTART")    == 0) cmd_restart(node_id);
    else if (strcmp(cmd, "CMD_CONFIG") == 0) cmd_config(node_id, doc);
    else if (strcmp(cmd, "CONFIG")     == 0) cmd_config(node_id, doc);  // legacy alias
    else {
        ESP_LOGW(TAG, "Unknown cmd: %s", cmd);
        output_warn("unknown_cmd", cmd);
    }
}

static void serial_tick(void) {
    while (Serial.available()) {
        char c = (char)Serial.read();
        if (c == '\n' || c == '\r') {
            if (s_buf_len > 0) {
                s_buf[s_buf_len] = '\0';
                process_cmd(s_buf);
                s_buf_len = 0;
            }
        } else if (s_buf_len < sizeof(s_buf) - 1) {
            s_buf[s_buf_len++] = c;
        }
    }
}

// ── Setup / Loop ──────────────────────────────────────────────────────────────

void setup(void) {
    // Buffers must be sized before begin() on Arduino 3.x (ignored after).
    // RX: large JSON commands (>256 bytes). TX: two SENSOR lines arriving in the
    // same ms (~260 bytes) overflowed the 128-byte UART FIFO and lost bytes.
    Serial.setRxBufferSize(1024);
    Serial.setTxBufferSize(1024);
    Serial.begin(GATEWAY_BAUD);
    delay(300);

    s_pkt_queue = xQueueCreate(PKT_QUEUE_LEN, sizeof(pkt_event_t));
    gw_espnow_init(ESPNOW_CHANNEL, on_recv);

    // esp_wifi_get_mac is reliable right after WiFi.mode(WIFI_STA) in gw_espnow_init
    if (esp_wifi_get_mac(WIFI_IF_STA, s_gateway_mac) != ESP_OK) {
        WiFi.macAddress(s_gateway_mac);  // fallback
    }

    mirror_begin();

    output_gateway_ready();
#if GATEWAY_STATUS_INTERVAL_MS > 0
    output_gateway_status();
#endif
}

void loop(void) {
    if (s_ready_sent < GATEWAY_READY_REPEAT_COUNT) {
        uint32_t now = millis();
        if (now - s_last_ready_ms >= GATEWAY_READY_REPEAT_INTERVAL_MS) {
            output_gateway_ready();
        }
    }

#if GATEWAY_STATUS_INTERVAL_MS > 0
    {
        uint32_t now = millis();
        if (now - s_last_status_ms >= GATEWAY_STATUS_INTERVAL_MS) {
            output_gateway_status();
        }
    }
#endif

    // Drain packet queue (filled by ESP-NOW WiFi-task callback).
    pkt_event_t evt;
    while (xQueueReceive(s_pkt_queue, &evt, 0) == pdTRUE) {
        cache_mac(evt.pkt.node_id, evt.src_mac);
        mirror_note_rx(&evt.pkt);
        switch (evt.pkt.type) {
            case PKT_SENSOR:    output_sensor(&evt.pkt);    break;
            case PKT_HEARTBEAT: output_heartbeat(&evt.pkt); break;
            case PKT_HELLO:     output_hello(&evt.pkt); ack_hello(&evt); break;
            default:
                ESP_LOGW(TAG, "Unhandled type=0x%02X from 0x%04X",
                         evt.pkt.type, evt.pkt.node_id);
                break;
        }
    }
    serial_tick();
    mirror_tick();
    delay(5);
}
