lucianoET/aguada-firmware/firmware/gps_tracker/src/gps_reader.h

#pragma once
#include <Arduino.h>
#include <TinyGPSPlus.h>
#include "gps_types.h"

#ifndef GPS_UART_NUM
#define GPS_UART_NUM 2
#endif

// GpsReader is the sole owner of the HardwareSerial UART instance and of the
// TinyGPSPlus parser instance. Nothing else in this firmware — not main.cpp,
// not fix_gate — is allowed to touch either directly; every other module
// reaches GPS state exclusively through the Fix snapshot returned by poll().
class GpsReader {
public:
    GpsReader();

    // Starts the UART with GPS_BAUD, SERIAL_8N1, GPS_RX_PIN, GPS_TX_PIN on
    // GPS_UART_NUM and starts nothing else — transmits nothing to the GPS
    // module (D-02: no UBX/CASIC/PMTK, no baud probing).
    void begin();

    // Drains every available byte into the parser, echoes raw characters to
    // Serial when raw echo is on, and returns true only when a new location
    // fix has committed since the previous call — at which point `out` is
    // filled from a single consistent read of the parser.
    bool poll(Fix &out);

    uint32_t bytesRead() const { return bytesRead_; }
    uint32_t passedChecksum() const;
    uint32_t failedChecksum() const;

    // True while NMEA bytes have arrived recently, regardless of fix state.
    bool receiving() const;

    // Fase 01.1 (D-03): total satellites in view, from GSV sentence field 3
    // ("total satellites in view"), covering every talker ID the supported
    // modules emit (u-blox NEO-6M: GPGSV; multi-GNSS AT6558/ATGM336H-class:
    // GNGSV aggregated, or GPGSV/GLGSV/BDGSV per constellation).
    //
    // A receiver reports its constellations one of two ways, and mixing them
    // up either double-counts or undercounts: GNGSV already carries the
    // combined total, while GPGSV/GLGSV/BDGSV each carry only their own. So
    // an aggregated GNGSV wins outright when fresh, and only in its absence
    // are the per-constellation talkers summed. Returns 0 when none is fresh.
    //
    // This is the only accessor in the firmware authorized to read GSV data
    // -- gps_reader remains the sole owner of the TinyGPSPlus parser (see the
    // class-level comment above); poll()'s Fix contract and every other
    // accessor are unaffected.
    uint8_t satsInView() const;

    void setRawEcho(bool on) { rawEcho_ = on; }
    bool rawEcho() const { return rawEcho_; }

private:
    TinyGPSPlus    gps_;
    HardwareSerial serial_{GPS_UART_NUM};

    // Bound to gps_ in the constructor (gps_reader.cpp). mutable because
    // TinyGPSCustom::value() clears its own updated flag as a side effect,
    // and satsInView() above is logically read-only (const).
    mutable TinyGPSCustom gpgsvSatsInView_;
    mutable TinyGPSCustom glgsvSatsInView_;
    mutable TinyGPSCustom bdgsvSatsInView_;
    mutable TinyGPSCustom gngsvSatsInView_;

    bool     rawEcho_ = true;
    uint32_t bytesRead_ = 0;
    uint32_t lastByteAtMs_ = 0;
};
