lucianoET/aguada-firmware/firmware/gateway/src/crc16.h

#pragma once
#include <stdint.h>
#include <stddef.h>

static inline uint16_t crc16_ccitt(const uint8_t *data, size_t len) {
    uint16_t crc = 0xFFFF;
    for (size_t i = 0; i < len; i++) {
        crc ^= ((uint16_t)data[i]) << 8;
        for (int j = 0; j < 8; j++)
            crc = (crc & 0x8000) ? (crc << 1) ^ 0x1021 : crc << 1;
    }
    return crc;
}
