lucianoET/aguada-firmware/tools/bridge.py

#!/usr/bin/env python3
"""
Aguada Bridge v3.2
Reads JSON from gateway USB serial → calculates level/volume → publishes MQTT → HA Discovery.

Usage:
    python bridge.py [--port /dev/ttyACM0] [--baud 115200] [--mqtt localhost] [--mqtt-port 1883]
                     [--config reservoirs.yaml] [--offline-timeout 300]
"""

import argparse
import json
import logging
import os
import re
import sys
import tempfile
import time
import threading
from collections import deque
from pathlib import Path

import serial
import paho.mqtt.client as mqtt
import yaml

try:
    from influxdb_client import InfluxDBClient, Point
    from influxdb_client.client.write_api import SYNCHRONOUS
    _INFLUX_OK = True
except ImportError:
    _INFLUX_OK = False

# ── Logging ───────────────────────────────────────────────────────────────────

logging.basicConfig(
    level=logging.INFO,
    format="%(asctime)s %(levelname)-7s %(name)s: %(message)s",
    datefmt="%Y-%m-%d %H:%M:%S",
)
log = logging.getLogger("bridge")

# ── Config ────────────────────────────────────────────────────────────────────

# alt node_id → canonical node_id ("also:" in reservoirs.yaml). Lets a second
# node (e.g. the wired node-eth) feed the same reservoir/entities.
# ponytail: dedup is keyed on the canonical id, so two nodes sharing a seq within
# 120 s drop one reading — give them distinct ids if both must be logged.
NODE_ALIASES: dict[str, str] = {}

GATEWAY_ALIVE_S = 90   # > gateway status interval (60 s)
# ponytail: tuning knob — a reading beyond level_max_cm + sensor_offset_cm + this margin is a sensor fault, not an empty tank.
OUT_OF_RANGE_MARGIN_CM = 30

# Editable from HA: param -> (name suffix, entity suffix, unit, min, max, icon).
# Single source for discovery, validation and the retained config state JSON.
RESERVOIR_PARAMS = {
    "level_max_cm":     ("Altura útil",     "altura_util",   "cm", 50, 1000,   "mdi:arrow-expand-vertical"),
    "sensor_offset_cm": ("Offset do sensor", "offset_sensor", "cm", 0,  200,    "mdi:arrow-collapse-down"),
    "volume_max_L":     ("Volume máximo",   "volume_maximo", "L",  1,  500000, "mdi:cup-water"),
}
GATEWAY_RX_TOPIC = "aguada/gateway/rx"  # raw gateway lines (serial republish + WiFi mirror)
GATEWAY_CMD_TOPIC = "aguada/gateway/cmd"  # --port none: serial command lines go here (Ethernet gateway)

def load_reservoir_config(path: str) -> dict:
    with open(path) as f:
        data = yaml.safe_load(f)
    # Index: (node_id_str, sensor_id_int) → config dict
    index = {}
    NODE_ALIASES.clear()
    for node_id_str, sensors in data.get("reservoirs", {}).items():
        for s in sensors:
            key = (node_id_str.upper(), int(s["sensor_id"]))
            index[key] = s
            for alt in s.get("also", []):
                NODE_ALIASES[str(alt).upper()] = node_id_str.upper()
    return index

def update_reservoir_yaml(path: str, node_id: str, alias: str, param: str, value: int) -> bool:
    """Edit one `param: number` line in place so comments/formatting survive."""
    real = os.path.realpath(path)
    with open(real, encoding="utf-8", newline="") as f:
        lines = f.read().splitlines(keepends=True)

    def indent_of(line: str) -> int:
        return len(line) - len(line.lstrip())

    def blank_or_comment(line: str) -> bool:
        t = line.strip()
        return not t or t.startswith("#")

    node_re = re.compile(r"^\s*[\"']?%s[\"']?\s*:\s*(#.*)?$" % re.escape(node_id), re.IGNORECASE)
    alias_re = re.compile(r"^\s*(?:-\s+)?alias:\s*[\"']?%s[\"']?\s*(#.*)?$" % re.escape(alias))
    item_re = re.compile(r"^\s*-\s")
    param_re = re.compile(r"^(\s*(?:-\s+)?%s\s*:\s*)(-?\d+(?:\.\d+)?)(\s*(?:#.*)?)$" % re.escape(param))

    target = None
    start = next((i for i, l in enumerate(lines) if node_re.match(l.rstrip("\r\n"))), None)
    if start is not None:
        node_indent = indent_of(lines[start])
        end = len(lines)
        for i in range(start + 1, len(lines)):
            if not blank_or_comment(lines[i]) and indent_of(lines[i]) <= node_indent:
                end = i
                break
        a = next((i for i in range(start + 1, end) if alias_re.match(lines[i].rstrip("\r\n"))), None)
        if a is not None:
            s0 = next((i for i in range(a, start, -1) if item_re.match(lines[i])), None)
            if s0 is not None:
                item_indent = indent_of(lines[s0])
                e0 = next((i for i in range(a + 1, end)
                           if item_re.match(lines[i]) and indent_of(lines[i]) == item_indent), end)
                for i in range(s0, e0):
                    body = lines[i].rstrip("\r\n")
                    m = param_re.match(body)
                    if m:
                        target = (i, m.group(1) + str(value) + m.group(3) + lines[i][len(body):])
                        break
    if target is None:
        log.error("Config not persisted: %s/%s %s not found in %s", node_id, alias, param, real)
        return False

    lines[target[0]] = target[1]
    tmp = None
    try:
        fd, tmp = tempfile.mkstemp(dir=os.path.dirname(real), prefix=".reservoirs.", suffix=".tmp")
        with os.fdopen(fd, "w", encoding="utf-8", newline="") as f:
            f.write("".join(lines))
            f.flush()
            os.fsync(f.fileno())
        os.chmod(tmp, os.stat(real).st_mode & 0o7777)  # mkstemp is 0600; keep readers working
        os.replace(tmp, real)
        return True
    except Exception:
        log.exception("Config not persisted: could not write %s", real)
        if tmp and os.path.exists(tmp):
            os.remove(tmp)
        return False

# ── Calculations ──────────────────────────────────────────────────────────────

def calculate(distance_cm: int, cfg: dict) -> dict:
    level_max_cm     = cfg["level_max_cm"]
    volume_max_L     = cfg["volume_max_L"]
    sensor_offset_cm = cfg["sensor_offset_cm"]

    level_cm = level_max_cm - (distance_cm - sensor_offset_cm)
    level_cm = max(0, min(level_cm, level_max_cm))

    pct      = round((level_cm / level_max_cm) * 100, 1)
    volume_L = round((level_cm / level_max_cm) * volume_max_L)

    return {"level_cm": level_cm, "pct": pct, "volume_L": volume_L}


def ts_to_iso(ts_value) -> str:
    """Convert unix timestamp (seconds) to ISO-8601 UTC string for HA timestamp sensors."""
    try:
        ts = int(ts_value)
    except Exception:
        ts = int(time.time())
    if ts <= 0:
        ts = int(time.time())
    return time.strftime("%Y-%m-%dT%H:%M:%SZ", time.gmtime(ts))


def vbat_to_volts(vbat_raw):
    """Convert battery voltage to volts.

    The protocol uses tenths-of-volts (e.g. 33 == 3.3V, -1 == n/a).
    Some gateway variants may emit JSON null for n/a; accept both.
    """
    if vbat_raw is None:
        return None
    # Spec: -1 means n/a
    if vbat_raw == -1:
        return None
    # Avoid treating bool as int (True/False)
    if isinstance(vbat_raw, bool):
        return None

    try:
        if isinstance(vbat_raw, int):
            if vbat_raw < 0:
                return None
            return round(vbat_raw / 10.0, 1)

        if isinstance(vbat_raw, float):
            if vbat_raw < 0:
                return None
            # Be tolerant: some producers may already emit volts (e.g. 3.3)
            if vbat_raw < 10:
                return round(vbat_raw, 1)
            return round(vbat_raw / 10.0, 1)

        s = str(vbat_raw).strip()
        if not s or s.lower() in {"null", "none"}:
            return None
        f = float(s)
        if f < 0:
            return None
        if f < 10:
            return round(f, 1)
        return round(f / 10.0, 1)
    except Exception:
        return None

# ── MQTT helpers ──────────────────────────────────────────────────────────────

def mqtt_topic_state(node_id: str, sensor_id: int) -> str:
    return f"aguada/{node_id}/{sensor_id}/state"

def mqtt_topic_status(node_id: str) -> str:
    return f"aguada/{node_id}/status"

def mqtt_topic_sensor_avail(node_id: str, sensor_id: int) -> str:
    return f"aguada/{node_id}/{sensor_id}/availability"

def mqtt_topic_config(node_id: str, sensor_id: int) -> str:
    return f"aguada/{node_id}/{sensor_id}/config"

def mqtt_topic_balance(node_id: str, sensor_id: int) -> str:
    return f"aguada/{node_id}/{sensor_id}/balance"

def mqtt_topic_gateway_health() -> str:
    return "aguada/gateway/health"

def mqtt_topic_gateway_ack() -> str:
    return "aguada/gateway/ack"

def publish_gateway_discovery(client: mqtt.Client):
    """Publish HA MQTT Discovery for gateway USB status/health diagnostics."""
    dev = {
        "name": "Aguada Gateway USB",
        "identifiers": ["aguada_gateway_usb"],
        "manufacturer": "Aguada",
        "model": "ESP32 USB Gateway",
    }
    avail_tp = "aguada/gateway/status"
    state_tp = mqtt_topic_gateway_health()

    online_payload = {
        "name": "Gateway USB - Online",
        "unique_id": "aguada_gateway_usb_online",
        "default_entity_id": "binary_sensor.aguada_gateway_usb_online",
        "state_topic": avail_tp,
        "payload_on": "online",
        "payload_off": "offline",
        "device_class": "connectivity",
        "device": dev,
        "icon": "mdi:lan-connect",
    }
    client.publish(
        "homeassistant/binary_sensor/aguada_gateway_usb_online/config",
        json.dumps(online_payload),
        retain=True,
    )
    log.debug("Gateway Discovery: homeassistant/binary_sensor/aguada_gateway_usb_online/config")

    sensors = [
        {
            "name": "Gateway USB - Uptime",
            "uid": "aguada_gateway_usb_uptime",
            "oid": "aguada_gateway_usb_uptime",
            "vt": "{{ value_json.uptime_s }}",
            "uom": "s",
            "dc": "duration",
            "sc": "measurement",
            "icon": "mdi:timer-outline",
        },
        {
            "name": "Gateway USB - Heap Livre",
            "uid": "aguada_gateway_usb_heap",
            "oid": "aguada_gateway_usb_heap",
            "vt": "{{ value_json.free_heap }}",
            "uom": "B",
            "dc": None,
            "sc": "measurement",
            "icon": "mdi:memory",
        },
        {
            "name": "Gateway USB - Queue Drops",
            "uid": "aguada_gateway_usb_queue_drops",
            "oid": "aguada_gateway_usb_queue_drops",
            "vt": "{{ value_json.queue_drops }}",
            "uom": None,
            "dc": None,
            "sc": "total_increasing",
            "icon": "mdi:package-variant-closed-remove",
        },
        {
            "name": "Gateway USB - CRC Falhas",
            "uid": "aguada_gateway_usb_crc_failures",
            "oid": "aguada_gateway_usb_crc_failures",
            "vt": "{{ value_json.crc_failures }}",
            "uom": None,
            "dc": None,
            "sc": "total_increasing",
            "icon": "mdi:alert-circle-outline",
        },
        {
            "name": "Gateway USB - Cmd Fail",
            "uid": "aguada_gateway_usb_cmd_fail",
            "oid": "aguada_gateway_usb_cmd_fail",
            "vt": "{{ value_json.cmd_fail }}",
            "uom": None,
            "dc": None,
            "sc": "total_increasing",
            "icon": "mdi:close-octagon-outline",
        },
        {
            "name": "Gateway USB - Rádio TX Fail",
            "uid": "aguada_gateway_usb_radio_tx_fail",
            "oid": "aguada_gateway_usb_radio_tx_fail",
            "vt": "{{ value_json.radio_tx_fail }}",
            "uom": None,
            "dc": None,
            "sc": "total_increasing",
            "icon": "mdi:radio-handheld",
        },
        {
            "name": "Gateway USB - Última atualização",
            "uid": "aguada_gateway_usb_last_seen",
            "oid": "aguada_gateway_usb_last_seen",
            "vt": "{{ value_json.ts_seen_iso }}",
            "uom": None,
            "dc": "timestamp",
            "sc": None,
            "icon": "mdi:clock-outline",
        },
    ]

    for e in sensors:
        payload = {
            "name": e["name"],
            "unique_id": e["uid"],
            "default_entity_id": f"sensor.{e['oid']}",
            "state_topic": state_tp,
            "value_template": e["vt"],
            "device": dev,
            "availability_topic": avail_tp,
            "payload_available": "online",
            "payload_not_available": "offline",
            "entity_category": "diagnostic",
        }
        if e.get("uom") is not None:
            payload["unit_of_measurement"] = e["uom"]
        if e.get("dc"):
            payload["device_class"] = e["dc"]
        if e.get("sc"):
            payload["state_class"] = e["sc"]
        if e.get("icon"):
            payload["icon"] = e["icon"]

        disc_topic = f"homeassistant/sensor/{e['uid']}/config"
        client.publish(disc_topic, json.dumps(payload), retain=True)
        log.debug("Gateway Discovery: %s", disc_topic)

def publish_discovery(client: mqtt.Client, node_id: str, sensor_id: int, cfg: dict):
    """Publish HA MQTT Discovery config for all entities of a sensor."""
    alias    = cfg.get("alias", f"{node_id}_{sensor_id}").lower()
    name_pfx = cfg.get("name", alias)
    uid_pfx  = f"aguada_{alias}"
    dev      = {"name": cfg.get("alias", alias), "identifiers": [f"aguada_{alias}"], "manufacturer": "Aguada"}
    state_tp = mqtt_topic_state(node_id, sensor_id)
    avail_tp = mqtt_topic_status(node_id)
    sensor_avail_tp = mqtt_topic_sensor_avail(node_id, sensor_id)

    entities = [
        {
            "name": f"{name_pfx} - Nível",
            "uid":  f"{uid_pfx}_nivel",
            "per_sensor": True,
            "oid":  f"aguada_{alias}_nivel",
            "vt":   "{{ value_json.level_cm }}",
            "uom":  "cm",
            "dc":   "distance",
            "sc":   "measurement",
            "icon": "mdi:water-level",
        },
        {
            "name": f"{name_pfx} - Volume %",
            "uid":  f"{uid_pfx}_pct",
            "per_sensor": True,
            "oid":  f"aguada_{alias}_pct",
            "vt":   "{{ value_json.pct }}",
            "uom":  "%",
            "dc":   None,
            "sc":   "measurement",
            "icon": "mdi:percent",
        },
        {
            "name": f"{name_pfx} - Volume",
            "uid":  f"{uid_pfx}_volume",
            "per_sensor": True,
            "oid":  f"aguada_{alias}_volume",
            "vt":   "{{ value_json.volume_L }}",
            "uom":  "L",
            "dc":   None,
            "sc":   "measurement",
            "icon": "mdi:water",
        },
        {
            "name": f"{name_pfx} - Distância",
            "uid":  f"{uid_pfx}_distancia",
            "per_sensor": True,
            "oid":  f"aguada_{alias}_distancia",
            "vt":   "{{ value_json.distance_cm }}",
            "uom":  "cm",
            "dc":   "distance",
            "sc":   "measurement",
            "icon": "mdi:ruler",
        },
        {
            "name": f"{name_pfx} - RSSI",
            "uid":  f"{uid_pfx}_rssi",
            "oid":  f"aguada_{alias}_rssi",
            "vt":   "{{ value_json.rssi }}",
            "uom":  "dBm",
            "dc":   "signal_strength",
            "sc":   "measurement",
            "icon": "mdi:wifi",
        },
        {
            "name": f"{name_pfx} - Bateria",
            "uid":  f"{uid_pfx}_bateria",
            "oid":  f"aguada_{alias}_bateria",
            "vt":   "{{ value_json.vbat }}",
            "uom":  "V",
            "dc":   "voltage",
            "sc":   "measurement",
            "icon": "mdi:battery",
        },
        {
            "name": f"{name_pfx} - Último dado",
            "uid":  f"{uid_pfx}_last_update",
            "oid":  f"aguada_{alias}_last_update",
            "vt":   "{{ value_json.ts_iso }}",
            "uom":  None,
            "dc":   "timestamp",
            "sc":   None,
            "icon": "mdi:clock-outline",
        },
    ]

    for e in entities:
        payload = {
            "name":                e["name"],
            "unique_id":           e["uid"],
            "default_entity_id":   f"sensor.{e['oid']}",
            "state_topic":         state_tp,
            "value_template":      e["vt"],
            "device":              dev,
        }
        if e.get("per_sensor"):
            # Measurement entities also follow the per-sensor topic, so a failed
            # sensor shows unavailable instead of a stale value (never mix with availability_topic).
            payload["availability"] = [
                {"topic": avail_tp, "payload_available": "online", "payload_not_available": "offline"},
                {"topic": sensor_avail_tp, "payload_available": "online", "payload_not_available": "offline"},
            ]
            payload["availability_mode"] = "all"
        else:
            payload["availability_topic"] = avail_tp
            payload["payload_available"] = "online"
            payload["payload_not_available"] = "offline"
        if e.get("uom") is not None:
            payload["unit_of_measurement"] = e["uom"]
        if e.get("sc"):
            payload["state_class"] = e["sc"]
        if e["dc"]:
            payload["device_class"] = e["dc"]
        if e["icon"]:
            payload["icon"] = e["icon"]

        disc_topic = f"homeassistant/sensor/{e['uid']}/config"
        client.publish(disc_topic, json.dumps(payload), retain=True)
        log.debug("Discovery: %s", disc_topic)


def publish_config_discovery(client: mqtt.Client, node_id: str, sensor_id: int, cfg: dict):
    """Publish HA MQTT Discovery for the editable reservoir parameters (number boxes)."""
    alias    = cfg.get("alias", f"{node_id}_{sensor_id}").lower()
    name_pfx = cfg.get("name", alias)
    dev      = {"name": cfg.get("alias", alias), "identifiers": [f"aguada_{alias}"], "manufacturer": "Aguada"}
    config_tp = mqtt_topic_config(node_id, sensor_id)

    for param, (label, ent, unit, lo, hi, icon) in RESERVOIR_PARAMS.items():
        uid = f"aguada_{alias}_cfg_{param}"
        # No availability keys: the boxes stay editable while the node is offline.
        payload = {
            "name":                f"{name_pfx} - {label}",
            "unique_id":           uid,
            "default_entity_id":   f"number.aguada_{alias}_{ent}",
            "state_topic":         config_tp,
            "value_template":      "{{ value_json.%s }}" % param,
            "command_topic":       f"{config_tp}/{param}/set",
            "min":                 lo,
            "max":                 hi,
            "step":                1,
            "mode":                "box",
            "entity_category":     "config",
            "unit_of_measurement": unit,
            "icon":                icon,
            "device":              dev,
        }
        client.publish(f"homeassistant/number/{uid}/config", json.dumps(payload), retain=True)
        log.debug("Discovery: homeassistant/number/%s/config", uid)


def publish_relay_discovery(client: mqtt.Client, node_id: str):
    """Publish HA MQTT Discovery for a relay node: RSSI, battery, button event."""
    nid_short = node_id.replace("0X", "").replace("0x", "").lower()
    uid_pfx   = f"aguada_relay_{nid_short}"
    dev_name  = f"Relay {node_id}"
    dev       = {"name": dev_name, "identifiers": [uid_pfx], "manufacturer": "Aguada", "model": "ESP32-C3 Relay"}
    state_tp  = f"aguada/{node_id}/relay/state"
    avail_tp  = mqtt_topic_status(node_id)

    sensors = [
        {
            "name": f"{dev_name} - RSSI",
            "uid":  f"{uid_pfx}_rssi",
            "vt":   "{{ value_json.rssi }}",
            "uom":  "dBm",
            "dc":   "signal_strength",
            "sc":   "measurement",
            "icon": "mdi:wifi",
        },
        {
            "name": f"{dev_name} - Bateria",
            "uid":  f"{uid_pfx}_bateria",
            "vt":   "{{ value_json.vbat }}",
            "uom":  "V",
            "dc":   "voltage",
            "sc":   "measurement",
            "icon": "mdi:battery",
        },
    ]

    for e in sensors:
        payload = {
            "name":                e["name"],
            "unique_id":           e["uid"],
            "state_topic":         state_tp,
            "value_template":      e["vt"],
            "unit_of_measurement": e["uom"],
            "state_class":         e["sc"],
            "device_class":        e["dc"],
            "device":              dev,
            "availability_topic":      avail_tp,
            "payload_available":       "online",
            "payload_not_available":   "offline",
        }
        if e.get("icon"):
            payload["icon"] = e["icon"]
        disc_topic = f"homeassistant/sensor/{e['uid']}/config"
        client.publish(disc_topic, json.dumps(payload), retain=True)
        log.debug("Relay Discovery: %s", disc_topic)

    # Button as ON/OFF binary sensor (for HA automations by state trigger)
    btn_state_payload = {
        "name":                 f"{dev_name} - Botão",
        "unique_id":            f"{uid_pfx}_button_state",
        "default_entity_id":    f"binary_sensor.aguada_{nid_short}_button",
        "state_topic":          f"aguada/{node_id}/button/state",
        "payload_on":           "ON",
        "payload_off":          "OFF",
        "icon":                 "mdi:gesture-tap-button",
        "device":               dev,
        "availability_topic":   avail_tp,
        "payload_available":    "online",
        "payload_not_available": "offline",
    }
    client.publish(
        f"homeassistant/binary_sensor/{uid_pfx}_button_state/config",
        json.dumps(btn_state_payload),
        retain=True,
    )
    log.debug("Relay Button ON/OFF Discovery: homeassistant/binary_sensor/%s_button_state/config", uid_pfx)

    # Button — HA event entity (requires HA ≥ 2023.8)
    btn_payload = {
        "name":                 f"{dev_name} - Botão",
        "unique_id":            f"{uid_pfx}_button",
        "state_topic":          f"aguada/{node_id}/button",
        "event_types":          ["press"],
        "device":               dev,
        "availability_topic":   avail_tp,
        "payload_available":    "online",
        "payload_not_available": "offline",
        "icon":                 "mdi:button-pointer",
    }
    client.publish(f"homeassistant/event/{uid_pfx}_button/config", json.dumps(btn_payload), retain=True)
    log.debug("Relay Button Discovery: homeassistant/event/%s_button/config", uid_pfx)


def publish_ani_discovery(client: mqtt.Client, node_id: str, sensor_id: int, cfg: dict):
    """Publish HA MQTT Discovery for an ANI-01 air quality sensor node."""
    alias    = cfg.get("alias", f"{node_id}_aq").lower()
    name_pfx = cfg.get("name", alias)
    uid_pfx  = f"aguada_{alias}"
    dev      = {
        "name":         cfg.get("alias", alias),
        "identifiers":  [f"aguada_{alias}"],
        "manufacturer": "Aguada",
        "model":        "ANI-01 Air Quality Node",
    }
    state_tp = mqtt_topic_state(node_id, sensor_id)
    avail_tp = mqtt_topic_status(node_id)

    entities = [
        {
            "name": f"{name_pfx} - eCO2",
            "uid":  f"{uid_pfx}_eco2",
            "oid":  f"aguada_{alias}_eco2",
            "vt":   "{{ value_json.eco2 }}",
            "uom":  "ppm",
            "dc":   "carbon_dioxide",
            "sc":   "measurement",
            "icon": "mdi:molecule-co2",
        },
        {
            "name": f"{name_pfx} - AQI",
            "uid":  f"{uid_pfx}_aqi",
            "oid":  f"aguada_{alias}_aqi",
            "vt":   "{{ value_json.aqi }}",
            "uom":  None,
            "dc":   "aqi",
            "sc":   "measurement",
            "icon": "mdi:air-filter",
        },
        {
            "name": f"{name_pfx} - RSSI",
            "uid":  f"{uid_pfx}_rssi",
            "oid":  f"aguada_{alias}_rssi",
            "vt":   "{{ value_json.rssi }}",
            "uom":  "dBm",
            "dc":   "signal_strength",
            "sc":   "measurement",
            "icon": "mdi:wifi",
        },
        {
            "name": f"{name_pfx} - Tensão",
            "uid":  f"{uid_pfx}_vcc",
            "oid":  f"aguada_{alias}_vcc",
            "vt":   "{{ value_json.vbat }}",
            "uom":  "V",
            "dc":   "voltage",
            "sc":   "measurement",
            "icon": "mdi:power-plug",
        },
        {
            "name": f"{name_pfx} - Último dado",
            "uid":  f"{uid_pfx}_last_update",
            "oid":  f"aguada_{alias}_last_update",
            "vt":   "{{ value_json.ts_iso }}",
            "uom":  None,
            "dc":   "timestamp",
            "sc":   None,
            "icon": "mdi:clock-outline",
        },
    ]

    for e in entities:
        payload = {
            "name":                e["name"],
            "unique_id":           e["uid"],
            "default_entity_id":   f"sensor.{e['oid']}",
            "state_topic":         state_tp,
            "value_template":      e["vt"],
            "device":              dev,
            "availability_topic":       avail_tp,
            "payload_available":        "online",
            "payload_not_available":    "offline",
        }
        if e.get("uom") is not None:
            payload["unit_of_measurement"] = e["uom"]
        if e.get("sc"):
            payload["state_class"] = e["sc"]
        if e.get("dc"):
            payload["device_class"] = e["dc"]
        if e.get("icon"):
            payload["icon"] = e["icon"]
        disc_topic = f"homeassistant/sensor/{e['uid']}/config"
        client.publish(disc_topic, json.dumps(payload), retain=True)
        log.debug("ANI Discovery: %s", disc_topic)


def publish_env_discovery(client: mqtt.Client, node_id: str):
    """Publish HA MQTT Discovery for relay I2C env sensor (temp + humidity)."""
    nid_short = node_id.replace("0X", "").replace("0x", "").lower()
    uid_pfx   = f"aguada_relay_{nid_short}"
    dev_name  = f"Relay {node_id}"
    dev       = {"name": dev_name, "identifiers": [uid_pfx], "manufacturer": "Aguada", "model": "ESP32-C3 Relay"}
    state_tp  = f"aguada/{node_id}/env/state"
    avail_tp  = mqtt_topic_status(node_id)

    sensors = [
        {
            "name": f"{dev_name} - Temperatura",
            "uid":  f"{uid_pfx}_temp",
            "vt":   "{{ value_json.temp_c }}",
            "uom":  "°C",
            "dc":   "temperature",
            "sc":   "measurement",
            "icon": "mdi:thermometer",
        },
        {
            "name": f"{dev_name} - Umidade",
            "uid":  f"{uid_pfx}_hum",
            "vt":   "{{ value_json.hum_pct }}",
            "uom":  "%",
            "dc":   "humidity",
            "sc":   "measurement",
            "icon": "mdi:water-percent",
        },
    ]

    for e in sensors:
        payload = {
            "name":                e["name"],
            "unique_id":           e["uid"],
            "state_topic":         state_tp,
            "value_template":      e["vt"],
            "unit_of_measurement": e["uom"],
            "state_class":         e["sc"],
            "device_class":        e["dc"],
            "device":              dev,
            "availability_topic":      avail_tp,
            "payload_available":       "online",
            "payload_not_available":   "offline",
        }
        if e.get("icon"):
            payload["icon"] = e["icon"]
        disc_topic = f"homeassistant/sensor/{e['uid']}/config"
        client.publish(disc_topic, json.dumps(payload), retain=True)
        log.debug("Env Discovery: %s", disc_topic)


# ── AirQ / analisador de ar-condicionado (canais 0xF0–0xF6) ──────────────────
# O node ANI envia cada periférico opcional como HEARTBEAT com sensor_id próprio
# (ver firmware/shared/protocol.h). Canal só aparece no HA quando chega o 1º valor
# válido → periférico não ligado = sem entidade. distance_cm 0xFFFF = sem leitura.

AIRQ_COMPRESSOR_ON_A = 1.0   # corrente acima disto = compressor ligado
AIRQ_STALE_S = 400           # > 3 ciclos de envio (120 s): valor sem renovação → null


def _airq_temp(raw: int) -> float:
    return round((raw - 1000) / 10.0, 1)


# sensor_id → (chave, nome, unidade, device_class, ícone, decode(distance_cm), chave_extra do reserved)
AIRQ_CHANNELS = {
    0xF0: ("co2",       "CO2 (SCD41)",                 "ppm", "carbon_dioxide", "mdi:molecule-co2",   lambda d: d,                   None),
    0xF1: ("t_ext",     "Temperatura externa",         "°C",  "temperature",    "mdi:thermometer",    _airq_temp,                    None),
    0xF2: ("t_sup",     "Temperatura de insuflamento", "°C",  "temperature",    "mdi:thermometer-low", _airq_temp,                   None),
    0xF3: ("current_a", "Corrente da condensadora",    "A",   "current",        "mdi:current-ac",     lambda d: round(d / 100.0, 2), None),
    0xF4: ("lux",       "Luminosidade",                "lx",  "illuminance",    "mdi:brightness-5",   lambda d: d,                   "lux_pct"),
    0xF5: ("sound_db",  "Ruído (dB SPL)",              "dB",  "sound_pressure", "mdi:volume-high",    lambda d: round(d / 10.0, 1),  "sound_peak_db"),
    0xF6: ("tvoc",      "TVOC",                        "ppb", "volatile_organic_compounds_parts", "mdi:air-filter", lambda d: d,     "aqi"),
}

# Entidades derivadas, publicadas quando a sua dependência aparece pela 1ª vez.
AIRQ_DERIVED = {
    "t_sup":     [("dt_c", "ΔT ambiente − insuflamento", "°C", None, "mdi:delta")],
    "tvoc":      [("aqi",  "AQI (ENS160)", None, "aqi", "mdi:air-filter")],
    "sound_db":  [("sound_peak_db", "Ruído pico", "dB", "sound_pressure", "mdi:volume-vibrate")],
}


def airq_state_topic(node_id: str) -> str:
    return f"aguada/{node_id}/airq/state"


def airq_device(node_id: str, alias: str | None) -> dict:
    nid = node_id.replace("0X", "").replace("0x", "").lower()
    return {
        "name":         f"AirQ {alias or node_id}",
        "identifiers":  [f"aguada_airq_{nid}"],
        "manufacturer": "Luctronics / Aguada",
        "model":        "AirQ — qualidade do ar + analisador de AC",
    }


def publish_airq_entity(client: mqtt.Client, node_id: str, alias: str | None,
                        key: str, name: str, uom, dc, icon: str):
    nid = node_id.replace("0X", "").replace("0x", "").lower()
    uid = f"aguada_airq_{nid}_{key}"
    payload = {
        "name":                  name,
        "unique_id":             uid,
        "state_topic":           airq_state_topic(node_id),
        # null no JSON → "None" → HA mostra "desconhecido" (sensor sem leitura)
        "value_template":        f"{{{{ value_json.{key} }}}}",
        "state_class":           "measurement",
        "device":                airq_device(node_id, alias),
        "availability_topic":    mqtt_topic_status(node_id),
        "payload_available":     "online",
        "payload_not_available": "offline",
        "icon":                  icon,
    }
    if uom:
        payload["unit_of_measurement"] = uom
    if dc:
        payload["device_class"] = dc
    client.publish(f"homeassistant/sensor/{uid}/config", json.dumps(payload), retain=True)


def publish_airq_compressor(client: mqtt.Client, node_id: str, alias: str | None):
    nid = node_id.replace("0X", "").replace("0x", "").lower()
    uid = f"aguada_airq_{nid}_compressor"
    payload = {
        "name":                  "Compressor",
        "unique_id":             uid,
        "state_topic":           airq_state_topic(node_id),
        "value_template":        "{{ value_json.compressor_on }}",
        "payload_on":            "True",
        "payload_off":           "False",
        "device_class":          "running",
        "device":                airq_device(node_id, alias),
        "availability_topic":    mqtt_topic_status(node_id),
        "payload_available":     "online",
        "payload_not_available": "offline",
        "icon":                  "mdi:hvac",
    }
    client.publish(f"homeassistant/binary_sensor/{uid}/config", json.dumps(payload), retain=True)


# ── Online/offline tracking ───────────────────────────────────────────────────

class NodeTracker:
    def __init__(self, client: mqtt.Client, offline_timeout_s: int):
        self._client   = client
        self._timeout  = offline_timeout_s
        self._last_seen: dict[str, float] = {}  # node_id → time.time()
        self._online:   set[str]          = set()

    def seen(self, node_id: str):
        was_online = node_id in self._online
        self._last_seen[node_id] = time.time()
        self._online.add(node_id)
        if not was_online:
            self._client.publish(mqtt_topic_status(node_id), "online", retain=True)
            log.info("Node %s → online", node_id)

    def check_timeouts(self):
        now = time.time()
        for node_id, ts in list(self._last_seen.items()):
            if now - ts > self._timeout and node_id in self._online:
                self._online.discard(node_id)
                self._client.publish(mqtt_topic_status(node_id), "offline", retain=True)
                log.warning("Node %s → offline (no data for %ds)", node_id, self._timeout)

    def sync_statuses(self, node_ids: set[str]):
        """Republish retained status for known nodes on broker reconnect/startup."""
        for node_id in sorted(node_ids):
            if node_id in self._online:
                self._client.publish(mqtt_topic_status(node_id), "online", retain=True)
            else:
                self._client.publish(mqtt_topic_status(node_id), "offline", retain=True)

# ── InfluxDB writer ──────────────────────────────────────────────────────────

class InfluxWriter:
    """Optional InfluxDB 2.x writer — only active when --influx-url is passed."""

    def __init__(self, url: str, token: str, org: str, bucket: str):
        if not _INFLUX_OK:
            raise RuntimeError(
                "influxdb-client not installed. Run: pip install 'influxdb-client'"
            )
        self._bucket = bucket
        self._org    = org
        self._client = InfluxDBClient(url=url, token=token, org=org)
        self._write  = self._client.write_api(write_options=SYNCHRONOUS)
        log.info("InfluxDB: %s  org=%s  bucket=%s", url, org, bucket)

    def write_sensor(self, node_id: str, sensor_id: int, alias: str, data: dict):
        p = (
            Point("reservoir")
            .tag("node_id",   node_id)
            .tag("sensor_id", str(sensor_id))
            .tag("alias",     alias)
            .field("distance_cm", int(data["distance_cm"]))
            .field("level_cm",    float(data["level_cm"]))
            .field("pct",         float(data["pct"]))
            .field("volume_L",    int(data["volume_L"]))
            .field("rssi",        int(data["rssi"]))
        )
        if data.get("vbat") is not None:
            p = p.field("vbat", float(data["vbat"]))
        try:
            self._write.write(bucket=self._bucket, org=self._org, record=p)
        except Exception as e:
            log.warning("InfluxDB write error: %s", e)

    def write_ani(self, node_id: str, sensor_id: int, alias: str, data: dict):
        p = (
            Point("air_quality")
            .tag("node_id",   node_id)
            .tag("sensor_id", str(sensor_id))
            .tag("alias",     alias)
            .field("eco2",    int(data["eco2"]))
            .field("aqi",     int(data["aqi"]))
            .field("rssi",    int(data["rssi"]))
        )
        if data.get("vbat") is not None:
            p = p.field("vbat", float(data["vbat"]))
        try:
            self._write.write(bucket=self._bucket, org=self._org, record=p)
        except Exception as e:
            log.warning("InfluxDB ANI write error: %s", e)

    def close(self):
        try:
            self._client.close()
        except Exception:
            pass


# ── Message handlers ──────────────────────────────────────────────────────────
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
