lucianoET/aguada-firmware/(commit log)

2026-05-26 feat: initial commit — Aguada ESP32 firmware (ESP-NOW mesh telemetry)
    ESP32-C3 node + ESP32-S3 gateway firmware for reservoir water-level
    telemetry system at CMASM (Ilha do Engenho). Protocol v3, CRC-16/CCITT,
    MQTT over WiFi.
    [partitions.csv, reservoirs.yaml]
2026-06-12 Aguada firmware: AirQ node sensors + captive portal redesign
    Node AirQ (ESP32-C3):
    - Fix: relay_aux no longer blocks boot ~126s on ANI nodes (skips shared I2C bus);
    ani_tick first read is immediate and decoupled from ESP-NOW send cadence.
    - Captive portal rewritten: phone-first, dark mode, live state, sparklines,
    organized by hardware component (node > AHT21 / ENS160 / TEMT6000 / KY-037).
    - TEMT6000 ambient-light sensor (GPIO3, lux estimate) — validated.
    - KY-037/038 ambient-noise sensor (GPIO1 A0, relative dB) — wired, pending
    power/wiring validation (see todo.md).
    - /data JSON extended (light, sound, diagnostics: node/fw/uptime/heap/age).
    Docs: Node AirQ.md (sensor/variable/unit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
    [partitions.csv, reservoirs.yaml]
2026-06-13 feat: nó RFID de teste — leitor ID-12 → captive portal
    Sketch standalone (firmware/rfid_test/) para ESP32-C3 SuperMini que lê o UID
    de tags 125 kHz pelo leitor ID-12 (UART 9600 8N1, RX=GPIO20) e mostra o último
    código numa página captive portal. Cada leitura também vai para a serial USB.
    Isolado do firmware do nó: sem ESP-NOW/MQTT/NVS. Inclui parser do frame ID-12
    com validação de checksum, README do componente/ligação e spec de design.
2026-08-01 docs: complete project research
    Add STACK, FEATURES, ARCHITECTURE, PITFALLS, and SUMMARY research for
    the ESP32 GPS vehicle/boat tracker milestone extending the Aguada
    ESP-NOW/MQTT/HA telemetry system.
2026-08-01 feat(01): walking skeleton gps_tracker — NMEA na bancada, fix validado (C3 SuperMini + NEO-6M/ATGM336H)
    [main.cpp]
2026-08-01 docs: registrar periféricos v2 (TFT ST7735, MPU6050, HTU21D, DS18B20?) + orçamento de pinos C3
2026-08-01 feat(01-01): gps_reader module owns UART + parser behind immutable Fix snapshot
    - gps_config.h: DEFAULT_GPS_FRESH_MS/MIN_UTC_YEAR/HEALTH_PERIOD_MS + GPS_BENCH_SIM, all #ifndef-guarded
    - gps_types.h: Fix struct (lat/lon/speed/course/alt/hdop/sats/fix_quality/utc_unix/age_ms/mono_ms)
    - gps_reader.{h,cpp}: sole owner of HardwareSerial + TinyGPSPlus; poll() checks location.isUpdated()
    before any accessor with a side effect, derives utc_unix via a hand-rolled days-from-civil helper
    - main.cpp rewired as bench harness on top of GpsReader/Fix only, prints [FIX]/[HEALTH] lines
    [gps_config.h, gps_reader.cpp, gps_reader.h, gps_types.h, main.cpp]
2026-08-01 feat(01-01): fix_gate module rejects stale/implausible/low-quality fixes (GPS-02)
    - gps_config.h: DEFAULT_GPS_HDOP_MAX/SATS_MIN/WARMUP_FIXES/MAX_PLAUSIBLE_KMH tunables
    - gps_types.h: 9-member GateResult enum + gateResultName() declaration
    - fix_gate.{h,cpp}: FixGate::evaluate() applies the 8 ordered checks (no-fix, stale,
    null-island, no-UTC, HDOP, sats, warmup, outlier jump via TinyGPSPlus::distanceBetween);
    never touches Serial/UART/parser
    - main.cpp: every poll()-returned snapshot is gated before use; ACCEPT prints [ACCEPT]
    and is the single downstream hand-off point; REJECT prints are deduped by reason and
    counted per-reason into [HEALTH]; LED re-sourced from the gate result
    Dev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
    [fix_gate.cpp, fix_gate.h, gps_config.h, gps_types.h, main.cpp]
2026-08-01 feat(01-02): cadence module — speed-based debounced pacing of accepted fixes (GPS-03)
    - Add cadence tunables (moving/stationary hysteresis, debounce, emit interval, heartbeat) to gps_config.h
    - Add CadenceState/CadenceAction enums + name helpers to gps_types.h
    - New Cadence class: onGatedFix() classifies MOVING/STATIONARY from speed_kmh with a debounced hysteresis band, paces EMIT/EMIT_HEARTBEAT/SUPPRESS_* from mono_ms only
    - Wire cadence into main.cpp's single GateResult::ACCEPT hand-off point; replace [ACCEPT] print with [EMIT]/[SUPPRESS]/[STATE] lines and extend [HEALTH] with cadence state/counters
    [cadence.cpp, cadence.h, gps_config.h, gps_types.h, main.cpp]
2026-08-01 feat(01-02): bench simulator + BENCH.md — prove gate and cadence from a desk
    - Add GPS_BENCH_SIM-gated bench simulator to main.cpp: 's'/'+'/'-'/'x'/'z'/'b'/'h' serial commands synthesize plausible 1 Hz fixes (continuity-advanced due-east position) or one-shot injected rejections (outlier jump, null island, bad HDOP/sats)
    - Simulator routes every synthetic fix through the same FixGate::evaluate() -> handleAccept() (cadence) pipeline real fixes use — refactored the ACCEPT-branch body into a shared handleAccept() so onGatedFix has a single call site reused by both paths
    - Every simulator-originated line carries a [SIM] marker; real fixes are ignored for gate/cadence purposes while the simul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
    [main.cpp]
2026-08-01 fix(01): CR-01 normalize TinyGPSLocation::Quality ASCII code to documented 0-8 integer
    [gps_reader.cpp]
2026-08-01 fix(01): CR-02/WR-02 reset FixGate on simulator transitions; anchor sim from last accepted fix
    [main.cpp]
2026-08-01 fix(01): WR-04 key reject-line dedup state on origin (real vs [SIM])
    [main.cpp]
2026-08-01 fix(01): WR-01 edge-gate [HEALTH] no_fix/stale watchdog counters instead of per-loop-tick
    [main.cpp]
2026-08-03 docs(gps_tracker): add fase 01.1 I2C bench wiring to pinout
2026-08-03 docs(01.1): research I2C peripherals and display phase
2026-08-03 docs(01.1): create phase 01.1 plans — perifericos I2C e display
2026-08-03 feat(01.1-01): add I2C peripheral constants and PlatformIO deps
    - Add all DEFAULT_I2C_*, DEFAULT_OLED_*, DEFAULT_ACCEL_*, DEFAULT_MAG_*,
    DEFAULT_HTU21_*, DEFAULT_DISPLAY_*, DEFAULT_SPEED_UNIT constants to
    gps_config.h for Fase 01.1's shared I2C bus foundation
    - Add olikraus/U8g2, dfrobot/DFRobot_QMC5883, adafruit/Adafruit HTU21DF
    Library to both platformio.ini envs, preserving TinyGPSPlus
    - Override DEFAULT_I2C_SDA_PIN/SCL_PIN to 21/22 on esp32-devkit (classic
    ESP32 reserves GPIO6-11 for internal flash)
2026-08-03 feat(01.1-01): add i2c_bus module for shared boot scan and health policy
    - i2c_bus.h/.cpp implement the single I2C policy planos 02/03/04 plug into:
    boot-time scan (D-12), per-module online/offline state, consecutive-error
    counting, and round-robin retry-on-timer recovery (D-13)
    - Zero blocking calls -- retry probes at most one address per tick() call
    so the GPS UART consumer is never starved (Pitfall 1/3)
    - Undef Arduino.h's legacy DISPLAY macro (0x1) in i2c_bus.h before declaring
    I2cModule::DISPLAY to fix a name collision that broke compilation
    [i2c_bus.cpp, i2c_bus.h]
2026-08-03 feat(01.1-01): wire i2c_bus into main.cpp boot scan and HEALTH line
    - Call i2c_bus::begin() in setup() after gpsReader.begin() so the GPS UART
    is draining before any I2C transaction competes for CPU
    - Add i2cRecoverTick() driving i2c_bus::tick() + reinitDue() dispatch per
    module, called once per loop() after the GPS pass and simTick(), before
    ledWrite/[HEALTH] -- structured as a switch so planos 02/03/04 add their
    driver begin() calls without rewriting this block
    - Extend [HEALTH] with disp=/accel=/mag=/env=/i2c_drops= fields, preserving
    every pre-existing field/order
2026-08-03 docs(01.1-01): add plan 01 summary
    Documents I2C bus foundation deliverables, the Arduino.h DISPLAY macro
    collision deviation, and the pending on-hardware verification items
    deferred to end-of-phase UAT.
2026-08-03 docs(01.1-01): complete I2C bus foundation plan
2026-08-03 feat(01.1-02): accel_sensor — raw I2C MPU6050 magnitude read + debounced wake edge
    - Hand-rolled WHO_AM_I probe (0x75==0x68) + PWR_MGMT_1 sleep-exit (0x6B=0x00), no other register touched (D-07: no gyro)
    - Single 6-byte burst read of ACCEL_XOUT_H (0x3B), euclidean magnitude at reset-default 16384 LSB/g scale
    - Debounced one-shot wakeEdge(): DEFAULT_ACCEL_WAKE_DEBOUNCE_SAMPLES consecutive samples deviating >= DEFAULT_ACCEL_WAKE_THRESHOLD_G from 1.0g arm the edge; a single below-threshold sample resets the streak
    - All failure/retry policy delegated to i2c_bus (reportOk/reportError/reinitDue) per D-13 -- no local offline policy
    - Zero blocking calls; poll() does at most one I2C burst and ret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
    [accel_sensor.cpp, accel_sensor.h]
2026-08-03 feat(01.1-02): Cadence::onAccelWake — second entry point, promote-only authority
    - New public bool onAccelWake(uint32_t mono_ms): returns false with no effect when already MOVING, otherwise promotes STATIONARY -> MOVING mirroring onGatedFix()'s existing transition bookkeeping (stateEnteredMs_, stateChanged_), with lastTransitionSpeedKmh_ forced to 0.0f (no GPS sample backs this transition)
    - accelWakePending_ one-shot flag: armed by onAccelWake(), consumed by onGatedFix()'s MOVING pacing decision to force an immediate EMIT on the first fix accepted after an accel wake (D-05 fast-resume), without touching the demotion path or its hysteresis/debounce band
    - Class-contract comment rewritten t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
    [cadence.cpp, cadence.h]
2026-08-03 feat(01.1-02): main.cpp — schedule accel poll and wire wake edge into cadence
    - accel_sensor::begin() called in setup() after i2c_bus::begin(), with a banner reporting whether the MPU6050 responded
    - New lastAccelPollMs timer (mirrors the existing lastHealthMs pattern): loop() polls accel_sensor at DEFAULT_ACCEL_POLL_MS, positioned after the GPS/simTick pass and before i2cRecoverTick(), so the GPS pipeline always claims the iteration first
    - This block is the sole call site of Cadence's accelerometer wake entry point; on a confirmed wake it logs "[ACCEL] wake mag=..g streak=.." immediately before the existing [STATE] transition line via printStateChange(), whose signature/format is untouch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
2026-08-03 feat(01.1-03): mag_sensor — auto-deteccao HMC/QMC, calibracao hard-iron em NVS e arbitro de rumo
    - DFRobot_QMC5883 wrapper: probe HMC/QMC/VCM addresses via i2c_bus::present(), classify chip via isHMC/isQMC/isVCM
    - Heading computed locally via atan2f on hard-iron-corrected X/Y axes + DEFAULT_MAG_DECLINATION (D-10, no tilt compensation)
    - Hard-iron calibration capture via calStart/calFinish/calAbort, persisted in Preferences namespace "magcal", rejects degenerate captures
    - arbitratedHeading() reuses existing DEFAULT_GPS_STATIONARY_KMH threshold for D-08 (no second competing constant)
    [mag_sensor.cpp, mag_sensor.h]
2026-08-03 feat(01.1-03): env_sensor — HTU21D com leitura alternada e fallback de ultimo valor conhecido
    - Adafruit_HTU21DF wrapper alternating temp/humidity reads per poll() call, halving per-call blocking cost (~50ms vs ~100ms) against the GPS UART buffer budget (Pitfall 6)
    - NAN result treated as failed read: reports via i2c_bus, preserves last-known temp_c/hum_pct instead of blanking the display field
    - D-14 scope: display/serial only, no flash/network integration
    [env_sensor.cpp, env_sensor.h]
2026-08-03 feat(01.1-03): main.cpp — timers de mag/env, comando serial 'cal' e campos novos no [HEALTH]
    - calHandleChar(): parser multi-caractere para "cal" com buffer fixo de 8 bytes, verificacao de limite antes de escrever (ASVS V5, T-01.1-01), reset por inatividade de 3000ms; consultado antes do dispatch de hotkeys de um caractere da Fase 1, que permanece inalterado
    - Timers de poll mag/env (DEFAULT_MAG_POLL_MS / DEFAULT_HTU21_POLL_MS) junto ao bloco de accel do plano 02
    - mag_sensor::begin()/env_sensor::begin() chamados em setup() e no case de recuperacao MAG/ENV de i2cRecoverTick()
    - [HEALTH] estendido com hdg=/hdg_src=/mag_chip=/temp=/hum=; nova linha [CAL] active com progresso x/y durante capt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
    [mag_sensor.cpp, mag_sensor.h, main.cpp]
2026-08-03 feat(01.1-04): satelites em vista no GpsReader e modulo display com as duas telas
    - GpsReader::satsInView() via TinyGPSCustom (GPGSV/GLGSV/GNGSV campo 3), unico ponto autorizado a tocar o parser alem do proprio poll()
    - display.h/.cpp: struct DisplayState + namespace display (begin/render/addr), U8g2 full-buffer HW I2C, fallback 0x3C->0x3D, uma unica transferencia de quadro por render()
    - render() nao consulta accel_sensor/mag_sensor/env_sensor -- recebe estado pronto via DisplayState
2026-08-03 feat(01.1-04): main.cpp -- montagem do DisplayState, unidade de velocidade e render alinhado ao fix
    - buildDisplayState() monta um quadro a partir de lastFix/cadence/mag_sensor/env_sensor/accel_sensor/i2c_bus, sem duplicar logica de driver
    - speedInDisplayUnit()/speedUnitLabel() resolvem km/h vs nos (D-04) so a partir de DEFAULT_SPEED_UNIT, nunca de estado de runtime
    - display::begin() em setup() e no case DISPLAY de i2cRecoverTick(); bloco de render posicionado apos os polls de accel/mag/env e antes do [HEALTH], com antecipacao quando um novo fix chega e >=80% do intervalo ja passou (D-02)
    - [HEALTH] estendido com sats_view=/disp_addr=, preservando todos os campos anteriores
    [main.cpp]
2026-08-03 docs(01.1-04): procedimento de bancada e fiacao definitiva da Fase 01.1
    - BENCH.md: secao "Fase 01.1 -- Perifericos I2C e display" preservando integralmente o conteudo da Fase 1 -- comando cal (multi-caractere, exige Enter), campos novos do [HEALTH], prefixos [I2C]/[MAG]/[ACCEL]/[CAL], roteiro numerado cobrindo D-01..D-14, registro de calibracao de campo
    - gps_tracker_pinout.md: secao "Fase 01.1" atualizada de "montar agora" para fiacao implementada/validada; placeholders para chip de bussola detectado e velocidade de barramento; GPIO1-5 marcados livres no orcamento v2 (OLED I2C substituiu o TFT SPI)
2026-08-03 fix(01.1): CR-01 honor driver begin() result in i2cRecoverTick()
    [main.cpp]
2026-08-03 fix(01.1): CR-02 refresh presence cache on live retryProbe() success
    [i2c_bus.cpp]
2026-08-03 fix(01.1): WR-01 sequence accel Wire.read() pairs into temporaries
    [accel_sensor.cpp]
2026-08-03 fix(01.1): WR-02 remove dead per-driver reinitDue() handling
    [accel_sensor.cpp, display.cpp, env_sensor.cpp, mag_sensor.cpp]
2026-08-03 docs(quick-260803-l28): plan wired ethernet node + bridge raw topic
2026-08-03 feat(quick-260803-l28): add node-eth PlatformIO project (Nano + ENC28J60 + HC-SR04)
    - New firmware/node-eth/ project targeting env:node-cav-eth (nanoatmega328)
    - Publishes integer-only, gateway-shaped sensor JSON to aguada/raw/0xEE02/1
    - Watchdog-safe forced reset via .init3 MCUSR/wdt_disable() preamble
    - Flash 73.7% (22640/30720B), RAM 56.9% (1166/2048B)
    [main.cpp]
2026-08-03 feat(quick-260803-l28): route aguada/raw/# through existing sensor pipeline
    - Subscribe to aguada/raw/# alongside aguada/cmd/# in _on_mqtt_connect
    - Log and drop malformed JSON on raw topics instead of silently ignoring
    - Gate raw-topic payloads on _configured_nodes membership before calling
    _handle_sensor, and guard the call with try/except + log.exception so a
    bad wired-node packet cannot kill the MQTT callback thread
    - dispatch()/_handle_sensor/_mark_gateway_seen left untouched
2026-08-03 docs(quick-260803-l28): add node-eth README
    - Pinout, power warning (ENC28J60 needs its own 3.3V rail), network
    settings, venv pio build/upload/monitor commands, behavior summary
    and troubleshooting one-liners for the wired CAV node
2026-08-04 Add various research notes and diagnostics for ENC28J60 SPI wiring
    - Added JSON files containing research notes on various components:
    - Adafruit_SSD1306 framebuffer requirements
    - u-blox NEO-6M GPS accuracy and configuration
    - HTU21D library dependencies and behavior
    - GGA fix quality and satellite requirements
    - U8g2 buffer modes for SSD1306
    - Arduino-ESP32 I2C bus issues and recovery methods
    - ESP32-C3 I2C fast-mode capabilities
    - Introduced a new diagnostic SPI sketch for ENC28J60 to test wiring permutations and verify EREVID.
    - Created a backup of the main firmware file for node-eth, detailing the setup for a wired Ethernet reservoir node with HC-SR04 sensor integration.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
    [diag_spi.cpp]
2026-09-28 fix(gateway,node): pin core, sensor error reporting, vbat config, WiFi secrets
    - Pin pioarduino 55.03.311 (Arduino 3.3.11 / IDF 5.5) in node and gateway.
    Gateway used the IDF5 ESP-NOW API while the node used IDF4, so no single
    core built both. Port node on_recv/on_send to IDF5 (node now gets real RSSI).
    - Error packets (distance 0xFFFF) now set FLAG_SENSOR_ERROR, so the web
    backend and Influx writer drop them instead of storing a 0% level.
    - On sensor error, forget last good reading so heartbeats stop replaying a
    frozen level; next valid read is sent immediately.
    - CMD_CONFIG vbat_enabled: reserved 0=unchanged, 1=off, 2=on. A CONFIG without
    vbat_enabled no longer disables vbat. Gat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
    [espnow_radio.cpp, main.cpp, main_wifi.cpp]
2026-09-30 feat(gateway,bridge): USB primary + WiFi mirror, single reservoirs.yaml, CAV id
    Gateway
    - New env gateway-c3-usb-wifi-ch11: USB serial stays the primary link and node
    packets are mirrored raw to MQTT on aguada/gateway/rx, so data keeps flowing
    if the USB link drops. WiFi/broker come from secrets.ini. Commands are still
    USB only; the AP must sit on the nodes' ESP-NOW channel.
    - New envs gateway-c3-ch11 and gateway-esp32-usb-ch11.
    - Size serial buffers before begin() (ignored afterwards on Arduino 3.x), write
    each JSON line with a single write, baud configurable via GATEWAY_BAUD.
    bridge.py
    - Also reads gateway lines from aguada/gateway/rx and republishes serial lines
    there for other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
    [reservoirs.yaml]
2026-09-30 chore: add ESP-NOW sniffer tool, point reservoirs sync at sibling aguada-web
    - firmware/espnow_sniffer: promiscuous sniffer that hops channels and prints
    every ESP-NOW frame (channel, MAC, RSSI, length, body). Used to find which
    channel a node transmits on, or whether it transmits at all.
    - The web backend now lives next to this repo (../aguada-web), so
    sync_reservoirs.sh resolves its default destination relative to the repo.
    [reservoirs.yaml]
2026-10-01 docs(260930-t20): pre-dispatch plan for bridge per-sensor availability
2026-10-01 feat(260930-t20): per-sensor availability for HC-SR04 in bridge + HA discovery
    - publish retained aguada/{node}/{sensor}/availability on error/valid transitions
    - measurement entities (nivel/pct/volume/distancia) use availability list [node, sensor], mode all
    - add tools/test_sensor_availability.py self-check
    [bridge.py, test_sensor_availability.py]
2026-10-01 docs(quick-260930-t20): bridge.py disponibilidade por sensor no HA quando chega pacote de erro
2026-10-01 docs(quick-260930-umi): bridge.py dedup de seq respeita TTL e zera no HELLO
2026-10-01 chore(node): CON (0x7758) HC-SR04 em TRIG=G4 / ECHO=G3
    G0 suspeito de dano por ECHO 5V direto. Defaults so valem sem config no
    NVS: particao nvs apagada no CON ao gravar.
2026-10-01 docs(state): log CON pin change (fast task)
2026-10-01 docs(state): log CON pin swap (fast task)
2026-10-01 feat(quick-6ja): out-of-range HC-SR04 reading is a sensor error
    - distance > level_max + offset + OUT_OF_RANGE_MARGIN_CM (30) -> sensor offline, no state
    - add tools/test_reservoir_config.py (temp-copy bridge, fake MQTT client)
2026-10-01 docs(quick-261001-6ja): parametros de reservatorio editaveis no HA
2026-10-08 docs(gateway-eth): spec do gateway ESP-NOW → Ethernet na WT32-ETH01
2026-10-08 build(gateway): envs ESP32 DevKit e C6 com perfil de produção (USB + espelho WiFi ch11)
2026-10-08 feat(bridge): --port none, modo só-MQTT para o gateway Ethernet
    Sem serial: linhas chegam por aguada/gateway/rx (já tratado), comandos saem
    em aguada/gateway/cmd e o --gateway-timeout marca offline em vez de reabrir porta.
2026-10-08 feat(gateway): env gateway-wt32-eth — ESP-NOW → MQTT pela Ethernet + AP por botão
    WT32-ETH01 (LAN8720): toda linha JSON vai pra aguada/gateway/rx, comandos de
    aguada/gateway/cmd caem no process_cmd() da serial, NTP pela Ethernet.
    Botão GPIO4 liga AP WPA2 no canal do ESP-NOW com página de status e config
    de rede/MQTT em NVS; desliga após 10 min sem requisição.
2026-10-14 feat(airq): analisador de ar-condicionado no node ANI
    Periféricos opcionais, detectados em runtime (sem eles o node continua AirQ puro):
    - SCD41 (CO2 NDIR real, I2C 0x62) — driver próprio, retry a cada ~2 min
    - 2 sondas DS18B20 em portas separadas: EXT (GPIO4, condensadora) e
    SUP (GPIO10, insuflamento); hot-plug, conversão não-bloqueante,
    tolera erro de CRC isolado
    - TC SCT-013 (GPIO1): corrente RMS, detecção de presença pelo bias e de saturação
    - INMP441 I2S (SCK20/WS21/SD5) substitui o KY-037: dB SPL real
    Canais novos como HEARTBEAT sensor_id 0xF0–0xF6 (sem reflash do gateway).
    Bridge junta em aguada/{id}/airq/state, deriva dt_c e compressor_on,
    cria entidades HA só no 1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
2026-10-14 docs(airq): diagramas de ligação, pinagem e pendências de bancada
    - firmware/node/docs/airq_wiring_core.svg / airq_wiring_ac.svg (gerados)
    - firmware/node/docs/airq_ligacoes.html: foto da bancada anotada + checklist
    - firmware/node/docs/wiring_src/: gerador (python3 export_svg.py)
    - Node AirQ.md, node_pinout.md, AGUADA_SYSTEM_DOC.md (canais 0xF0–0xF6),
    CLAUDE.md e todo.md atualizados
    Claude-Session: https://claude.ai/code/session_01U6ChfronBSg2LbgYTZGSVQ
2026-11-01 feat(node): unicast ao gateway, watchdog, compensação de temperatura e monitor de 5 V
    - F1: nó envia unicast ao gateway (ACK de MAC + retransmissão), aprendendo o MAC
    pelo ACK que o gateway devolve ao HELLO direto; fallback broadcast e esquece o
    gateway após 3 falhas seguidas. Gateway (USB, WiFi, ETH) responde HELLO com PKT_ACK.
    - F2: task watchdog no loop (60 s) e restart após 6 h sem entrega confirmada.
    - F3: DS18B20 opcional (US_TEMP_PIN) compensa a velocidade do som pelo eco medido.
    - F4: vbat com ADC calibrado (mV), defaults por build flag e limite NODE_VBAT_LOW.
    - env node-c3-ch11: TRIG G3, ECHO G4, fonte 5 V em G1 (÷3), sonda em G10.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
2026-11-01 docs(node): manual de montagem do nó reservatório com diagrama de ligações
2026-11-01 chore(reservoirs): nó de bancada 0x5308 (lucmac)
2026-11-01 chore(reservoirs): nó 0x5308 assume o CON (Castelo de Consumo)
    Remove a entrada de bancada BANC; 0x5308 vira 'also' do 0x7758.
2026-11-01 feat(node): envia a temperatura do ar da compensação
    Com US_TEMP_PIN, cada heartbeat leva o canal extra T_EXT (0xF1, codificação do
    AirQ); sem leitura recente vai como erro, para a sonda ausente aparecer no servidor.
2026-11-01 docs(node): reserva de pinos do nó reservatório (mic, I2C/OLED, relés, botões)
2026-11-02 feat(node): perfis node_reservatorio_1U e _2U (2 reservatórios, TRIG compartilhado)
    1U = antigo node-c3-ch11 (mantido como alias). 2U: TRIG G3 para os dois sensores,
    ECHO1 G4 e ECHO2 G20; o firmware espera 60 ms entre leituras com TRIG compartilhado.
    Manuais e diagramas 1U/2U (gerador parametrizado) com a reserva de pinos.
2026-11-02 feat(node): temperatura da compensação por HTU21D/SHT3x na I2C
    US_TEMP_I2C procura HTU21D/HD21D (0x40) ou SHT3x (0x44) em G6/G7 no boot e tem
    prioridade sobre a DS18B20; 1U/2U ligam as duas fontes. Sem sensor o nó usa 25 °C e
    não envia T_EXT (antes mandava erro a cada heartbeat). Manuais e pinagem atualizados.
2026-11-02 docs(node): reserva de mic do nó reservatório passa a INMP441 (G0/G2/G21)
    SCK=G0, WS=G2, SD=G21 no lugar do mic analógico em G0. Relé 2 sai da
    reserva (2º relé via PCF8574 na I2C). SVGs regerados.
2026-11-02 feat(communicator): node de voz e alarme — fase 1 (ESP32-C3)
    PTT por UDP multicast (µ-law 16 kHz, gongo, AGC/gate), I2S full-duplex
    INMP441 + MAX98357A/PCM5102A, OLED, botões de alarme, sirene e alarme por
    ESP-NOW (SENSOR_ID_ALARM 0xE0) + multicast. Compila; falta bancada.
2026-11-02 docs(communicator): manuais de montagem e de usuário + diagrama de ligações
    Diagrama SVG gerado por docs/wiring_src/communicator.py (mesmo estilo do
    nó reservatório). Montagem: material, jumpers dos módulos, passo a passo,
    gravação por posto, bancada, instalação e diagnóstico. Usuário: tela,
    anúncio, volume, alarme e problemas comuns.
2026-11-02 feat(communicator): diagnóstico de boot — scan I2C (detecta SDA/SCL trocados) e canais do mic
2026-11-02 feat(communicator): perfil yeti_s3 — boneco Yeti com rosto ST7789 e sensores
    ESP32-S3 SuperMini + ST7789 1.3" 240x240 (LovyanGFX, sprite com DMA),
    INMP441 + MAX98357A, touch TTP223 na cabeça (toque/2x/3x/segurar = PTT),
    HTU21D, MPU6050 e BH1750 opcionais. Reusa audio_io, voice_net, voice_dsp e
    alarm; humores do rosto por alarme, voz, IMU, luz e temperatura.
    - tons (gongo, sirene) movidos para src/tones.h, comuns aos dois perfis
    - alarm: COMM_PIN_SIREN = -1 desliga a saída da sirene (só tom no falante)
    - pinagem e bancada em YETI.md
2026-11-03 feat(communicator): pinagem final do yeti_s3 — touch nos braços, LEDs, VBAT, 2 mics
    - G3/G13: touch nativo dos braços (fita de cobre); RST do display vai para RC
    - G44: TTP223 da cabeça (saiu do G1); G43: WS2812 das bochechas; G1: ADC da bateria
    - 2× INMP441 no mesmo SD (L/R = canal); energia pela base sob a peana
    - YETI.md: tabela nova, ligação de energia e scripts dos STLs
2026-11-03 feat(communicator): yeti_s3 — braços, bochechas, bateria e 2 mics
    - body.cpp: touch nativo dos braços (sim/não/gatilho/abraço, YETI_EVT na serial),
    WS2812 das bochechas por RMT com cor pelo humor, VBAT com % de LiPo
    - audio_io: 2º INMP441 no canal R detectado no boot; voz = média L+R; energia L/R
    - yeti_main: olhar segue som alto (estéreo), bateria no gesto de 2 toques e aviso
    - YETI.md: gestos, cores e calibração
2026-11-05 feat(communicator): perfil yeti_c3 + corrige cores do rosto
    yeti_c3: Yeti no ESP32-C3 SuperMini (13 GPIO). Toque da cabeça e dos braços
    por MPR121 no I2C (E0 cabeça, E1 braço E, E2 braço D), lido na task dos
    sensores; rosto a 15 fps com sprite 8 bit se faltar heap; canal PWM do
    backlight configurável (C3 só tem 0..5); partição huge_app.
    fix: face.cpp guardava color888 (24 bit) em uint16_t e truncava as cores
    nas duas placas; agora usa color565.
2026-11-05 docs(communicator): manuais e diagramas do Yeti (S3 e C3) + CAD
    - MONTAGEM_YETI_S3.md, MONTAGEM_YETI_C3.md e MANUAL_USUARIO_YETI.md no
    padrão do communicator_c3
    - diagramas de ligações gerados por docs/wiring_src/yeti.py (s3 | c3)
    - cad/yeti: scripts das peças modificadas e STLs próprios (moldura 1.3",
    base de energia); STLs originais do Yeti v1.2 ficam fora do git
